SolidoodleDev/Press-Drawings/Press Solidworks Files/raspberry_pi__15_pin_FFC_Connector.SLDASM

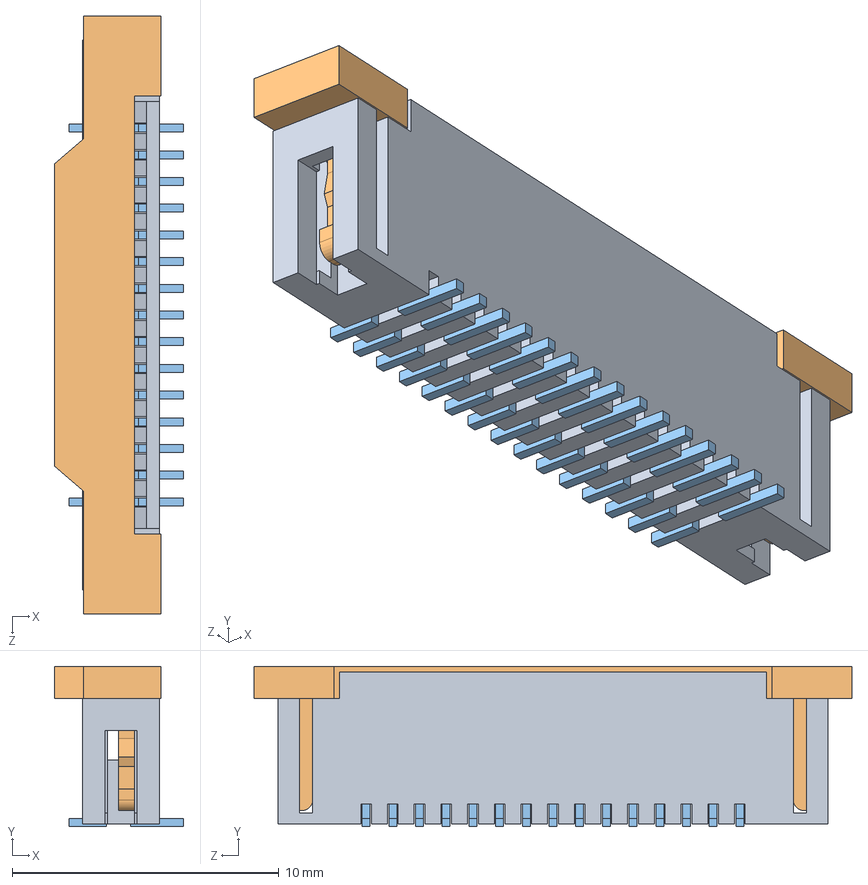
[picture p1: CAD file, 2017-12-07]
Press Solidworks Files/raspberry_pi__15_pin_FFC_Connector.SLDASM
4.85 x 6.00 x 22.4 mm
raspberry_pi__15_pin_FFC_Connector_body
raspberry_pi__15_pin_FFC_Connector_locker
raspberry_pi__15_pin_FFC_Connector_pins x 15
