SolidoodleDev/Press-Drawings/Press Solidworks Files/D2F_01F_D.SLDASM

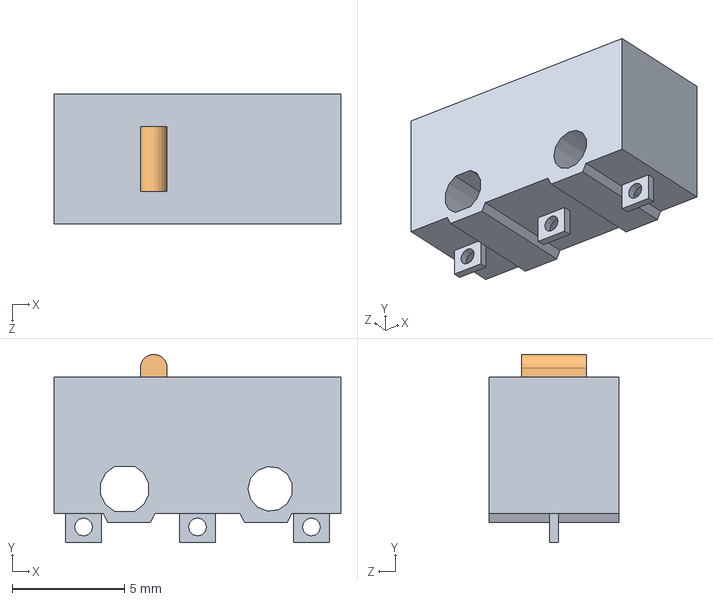
[picture p2: CAD file, 2017-12-07]
Press Solidworks Files/D2F_01F_D.SLDASM
12.8 x 8.40 x 5.80 mm
D2F_01F_D_BASE
D2F_01F_D_ACTUATOR
