SolidoodleDev/Press-Drawings/Press Solidworks Files/raspberry_pi__USB_x2.SLDASM

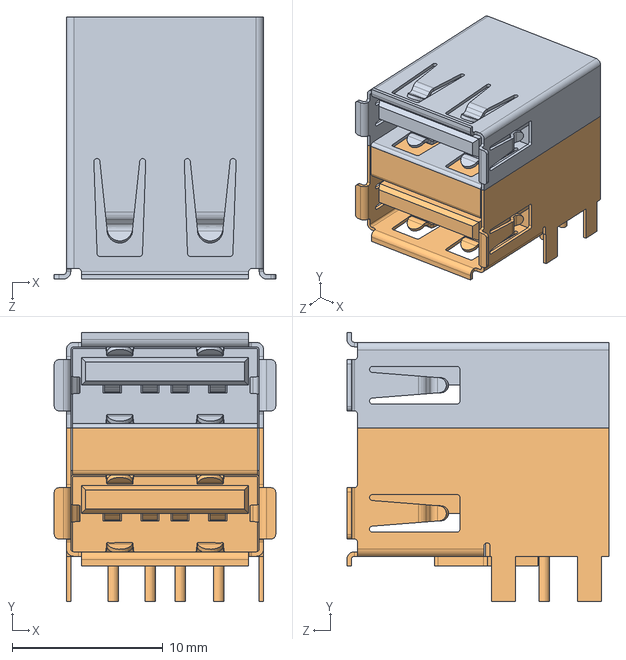
[picture p3: CAD file, 2017-12-07]
Press Solidworks Files/raspberry_pi__USB_x2.SLDASM
14.7 x 17.9 x 17.4 mm
raspberry_pi__USB_x2_part1
raspberry_pi__USB_x2_part2
