SolidoodleDev/Press-Drawings/Press Solidworks Files/Solidoodle_Build_Platform_Assy.SLDASM

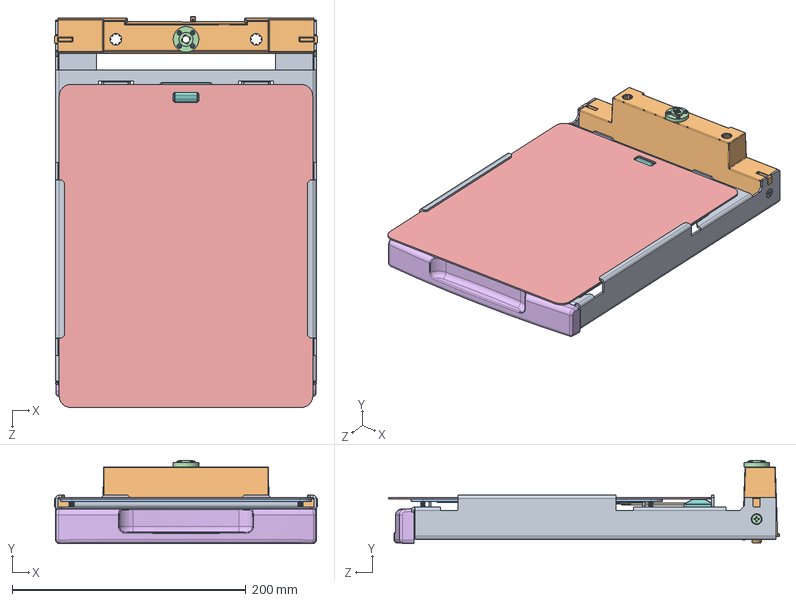
[picture p4: CAD file, 2017-12-07]
Press Solidworks Files/Solidoodle_Build_Platform_Assy.SLDASM
225.0 x 71.3 x 334.7 mm
1844_022_rev_04
1844_023_rev_04
1844_024_rev_03
Lead Screw Nut
1844_041_rev_04
1844_040_rev_04
1844_068_rev_04
m2x12_flat_socket_screw x 4
m4.5x10_plastite x 4
m2x10_plastite x 4
m4.5x12_flathead_plastite x 2
m3x6_plastite
