SolidoodleDev/Press-Drawings/Press Solidworks Files/Solidoodle_Spool_Assy.SLDASM

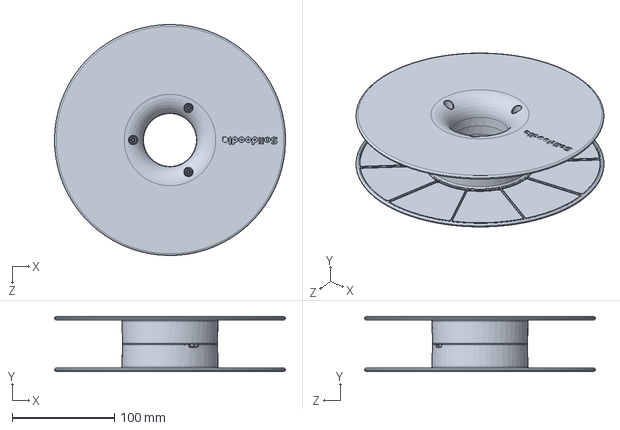
[picture p5: CAD file, 2017-12-07]
Press Solidworks Files/Solidoodle_Spool_Assy.SLDASM
226.1 x 54.0 x 226.1 mm
1844_042_rev_04 x 2
m3.5x10_plastite x 3
