SolidoodleDev/Press-Drawings/Press Solidworks Files/PCB_Door_Assy.SLDASM

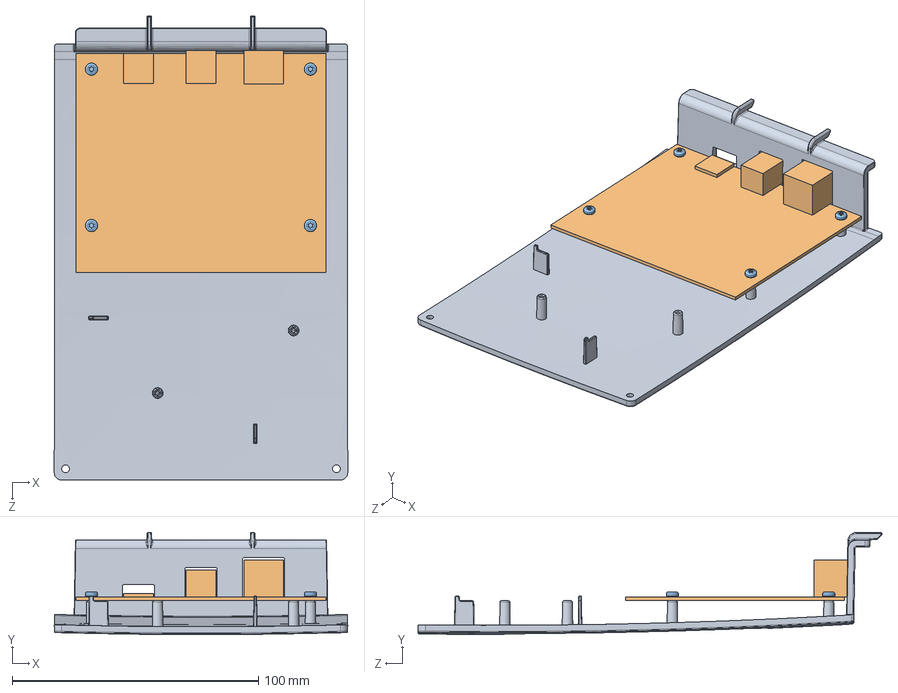
[picture p6: CAD file, 2017-12-07]
Press Solidworks Files/PCB_Door_Assy.SLDASM
119.2 x 41.5 x 188.4 mm
1844_031_rev_04
main_pcb
m2.5x6_plastite x 4
