SolidoodleDev/Press-Drawings/Press Solidworks Files/Solidoodle_Button_PCB_Assem.SLDASM

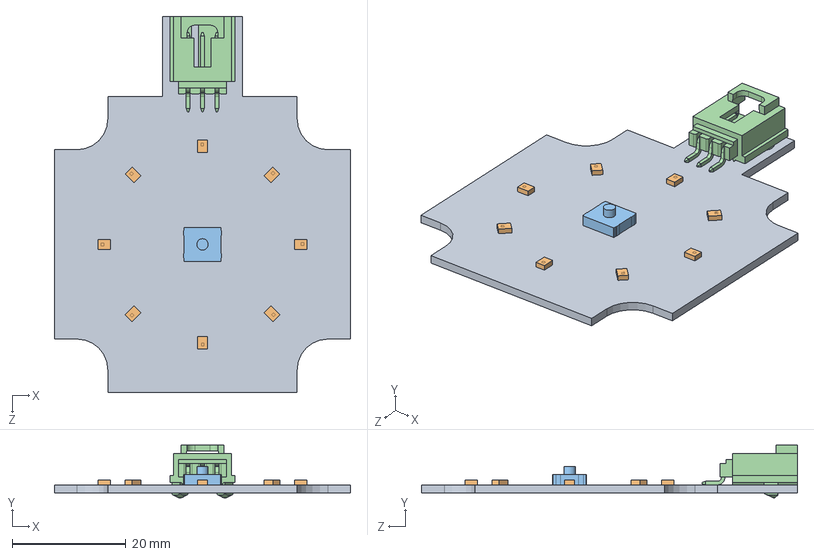
[picture p8: CAD file, 2017-12-07]
Press Solidworks Files/Solidoodle_Button_PCB_Assem.SLDASM
52.0 x 9.29 x 66.0 mm
solidoodle_button_pcb
led x 8
switch
3-pin_molex_male_board_connector_015912035
