SolidoodleDev/Press-Drawings/Press Solidworks Files/Front_Door_Assy.sldasm

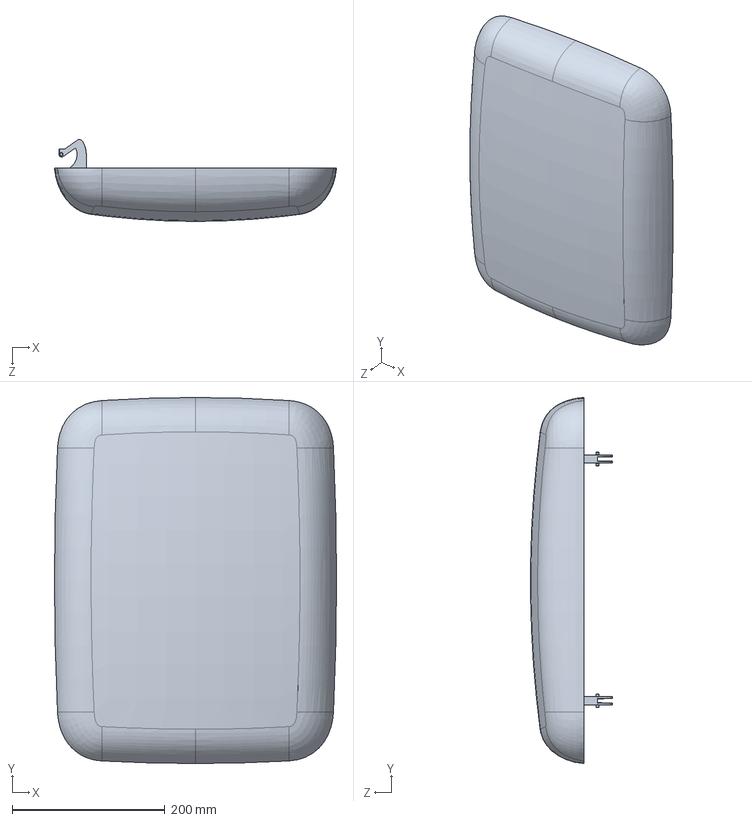
[picture p10: CAD file, 2017-12-07]
Press Solidworks Files/Front_Door_Assy.sldasm
370.0 x 480.0 x 107.4 mm
1844_008_rev_04
1844_036_rev_04
m3x10_flathead_plastite x 2
