SolidoodleDev/Press-Drawings/Press Solidworks Files/D2F_01FL_A.SLDASM

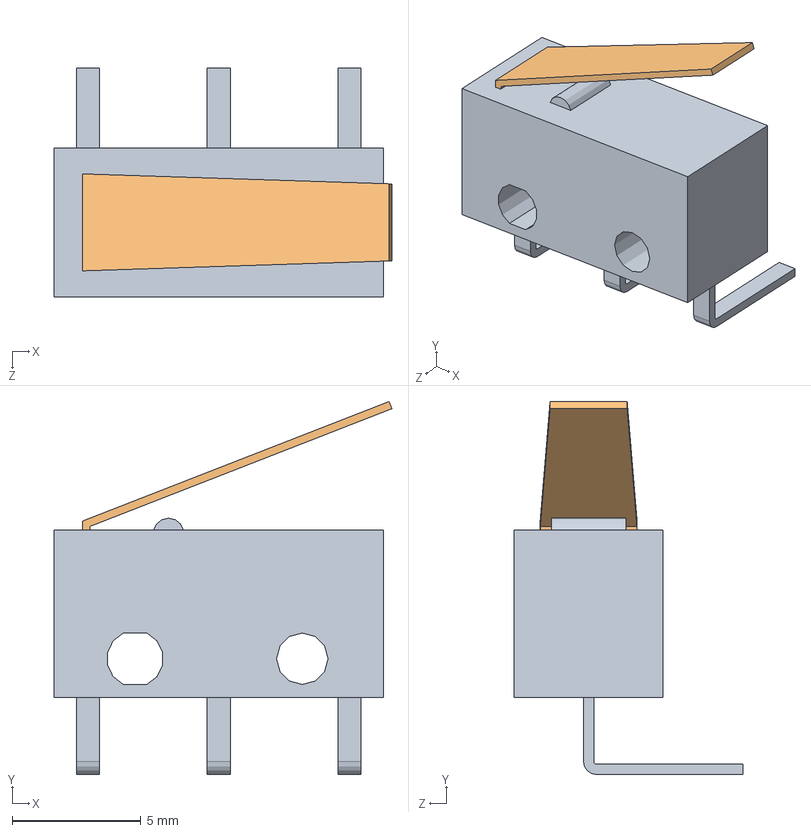
[picture p11: CAD file, 2017-12-07]
Press Solidworks Files/D2F_01FL_A.SLDASM
13.1 x 14.5 x 8.90 mm
D2F_01FL_A.BASE
D2F_01FL_A.ACTUATOR
