SolidoodleDev/Press-Drawings/Press Solidworks Files/main_pcb.SLDPRT

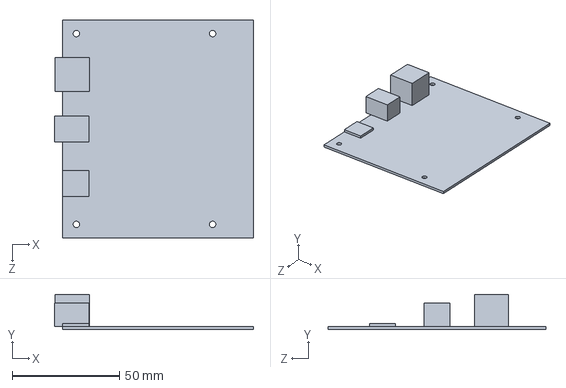
[picture p12: CAD file, 2017-12-07]
Press Solidworks Files/main_pcb.SLDPRT
92.7 x 16.5 x 101.6 mm
