SolidoodleDev/Press-Drawings/Press Solidworks Files/Solidoodle_Micro_Switch_Assy.SLDASM

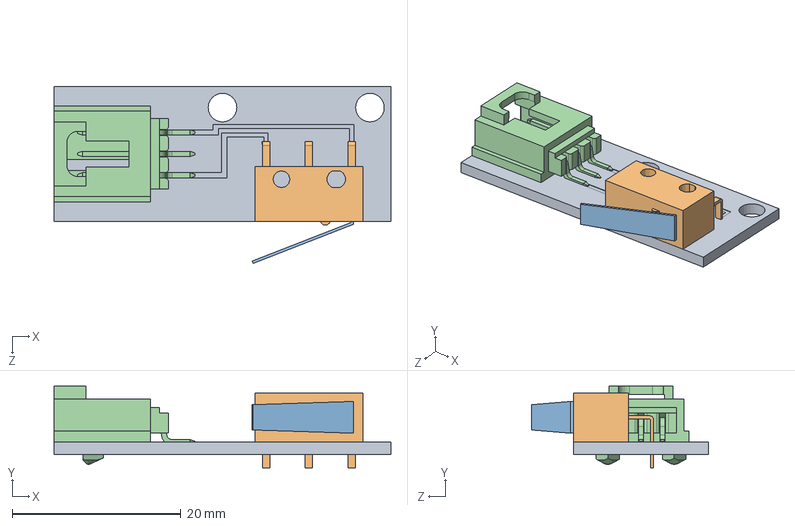
[picture p13: CAD file, 2017-12-07]
Press Solidworks Files/Solidoodle_Micro_Switch_Assy.SLDASM
40.0 x 9.70 x 21.0 mm
micro_switch_pcb
D2F_01FL_A.BASE
D2F_01FL_A.ACTUATOR
3-pin_molex_male_board_connector_015912035
