SolidoodleDev/Press-Drawings/Press Solidworks Files/Solidoodle_Lid_Assy.sldasm

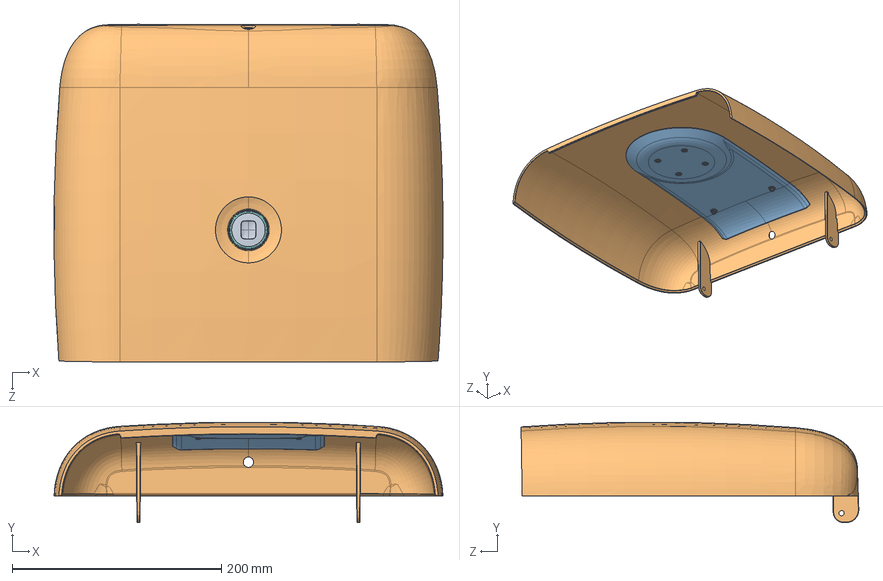
[picture p14: CAD file, 2017-12-07]
Press Solidworks Files/Solidoodle_Lid_Assy.sldasm
371.4 x 95.7 x 322.5 mm
1844_005_rev_04
1844_032_rev_04
m3x10_plastite x 4
solidoodle_button_pcb
led x 8
switch
3-pin_molex_male_board_connector_015912035
1844_026_rev_04
1844_009_rev_04
m3x6_plastite x 2
