SolidoodleDev/Press-Drawings/Press Solidworks Files/Spool_Tray_Assembly.SLDASM

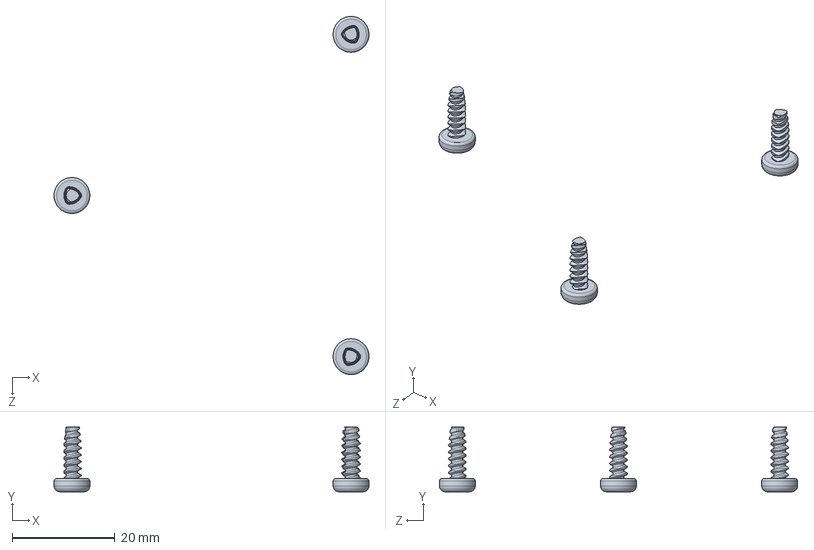
[picture p15: CAD file, 2017-12-07]
Press Solidworks Files/Spool_Tray_Assembly.SLDASM
61.5 x 12.6 x 69.9 mm
m3.5x10_plastite x 3
