SolidoodleDev/Press-Drawings/Press Solidworks Files/raspberry_pi__HDMI_socket.SLDASM

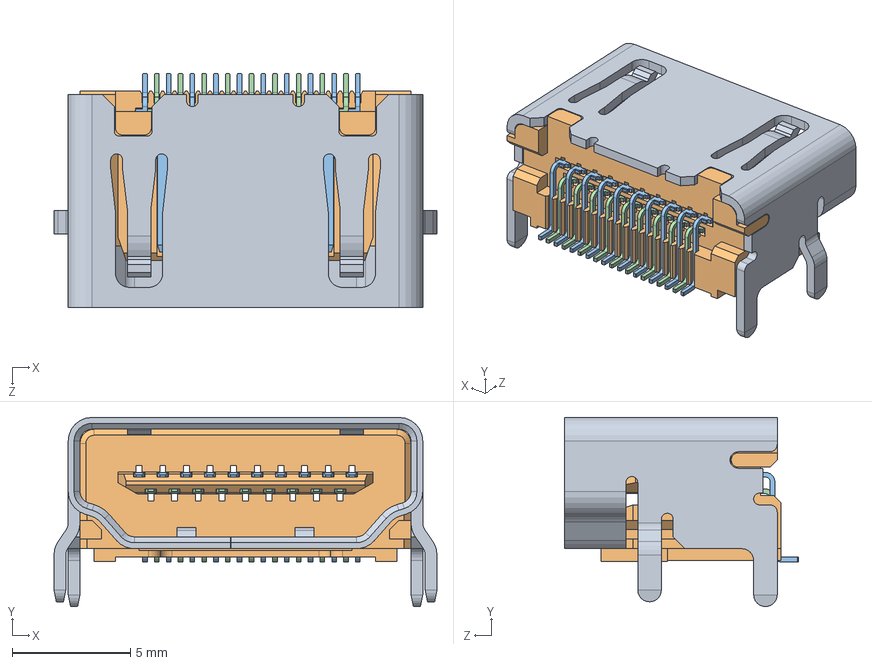
[picture p16: CAD file, 2017-12-07]
Press Solidworks Files/raspberry_pi__HDMI_socket.SLDASM
16.2 x 8.00 x 9.90 mm
raspberry_pi__HDMI_socket_cover
raspberry_pi__HDMI_socket_inside
raspberry_pi__HDMI_socket_large_pin x 10
raspberry_pi__HDMI_socket_small_pin x 9
