SolidoodleDev/Press-Drawings/Press Part Drawings/Drawing Step Files (STEP)/1844_009_rev_03.STEP

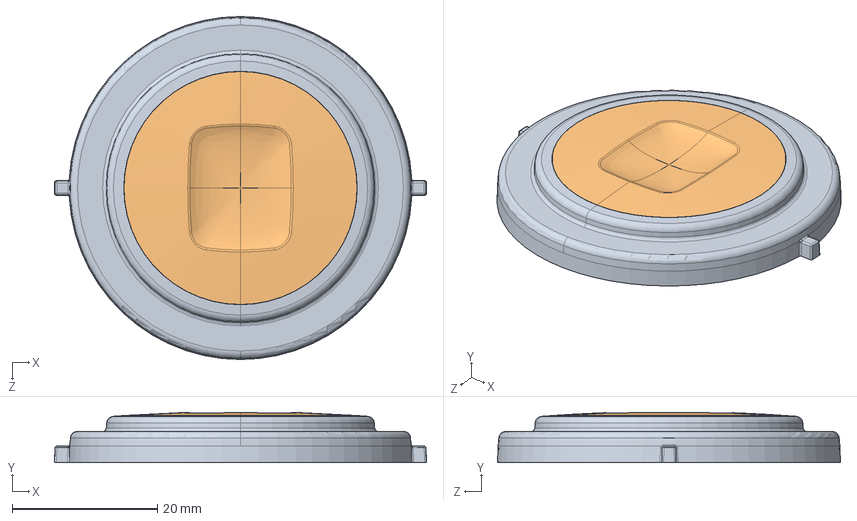
[picture p17: CAD file, 2017-12-07]
Press Part Drawings/Drawing Step Files (STEP)/1844_009_rev_03.STEP
51.2 x 6.93 x 47.2 mm
1844_026_rev_04
1844_009_rev_04
