SolidoodleDev/Press-Drawings/Press Solidworks Files/raspberry_pi__composite_video_out.SLDPRT

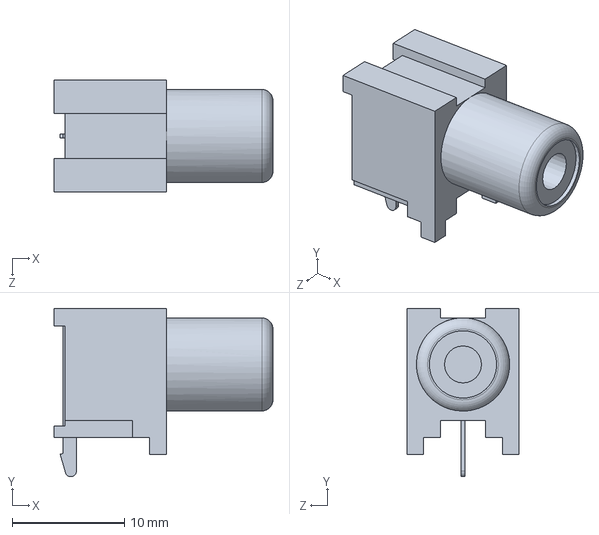
[picture p18: CAD file, 2017-12-07]
Press Solidworks Files/raspberry_pi__composite_video_out.SLDPRT
19.5 x 15.0 x 10.0 mm
