SolidoodleDev/Press-Drawings/Press Part Drawings/Drawing Step Files (STEP)/1844_025_rev_05.STEP

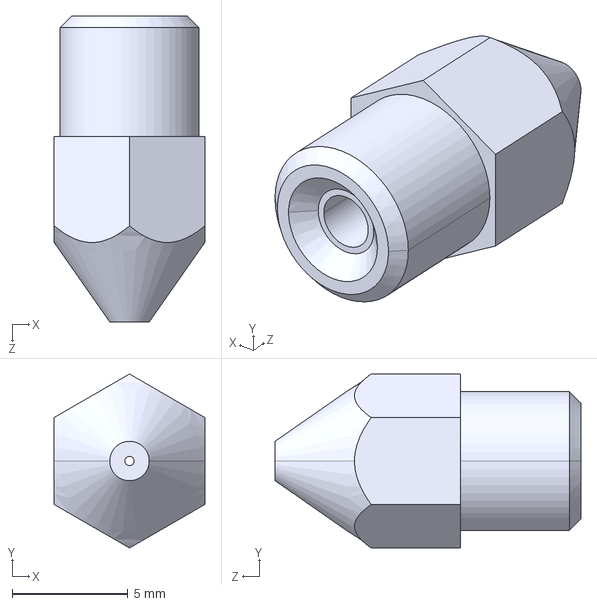
[picture p19: CAD file, 2017-12-07]
Press Part Drawings/Drawing Step Files (STEP)/1844_025_rev_05.STEP
6.50 x 7.51 x 13.2 mm
