SolidoodleDev/Press-Drawings/Press Solidworks Files/1844_053.SLDPRT

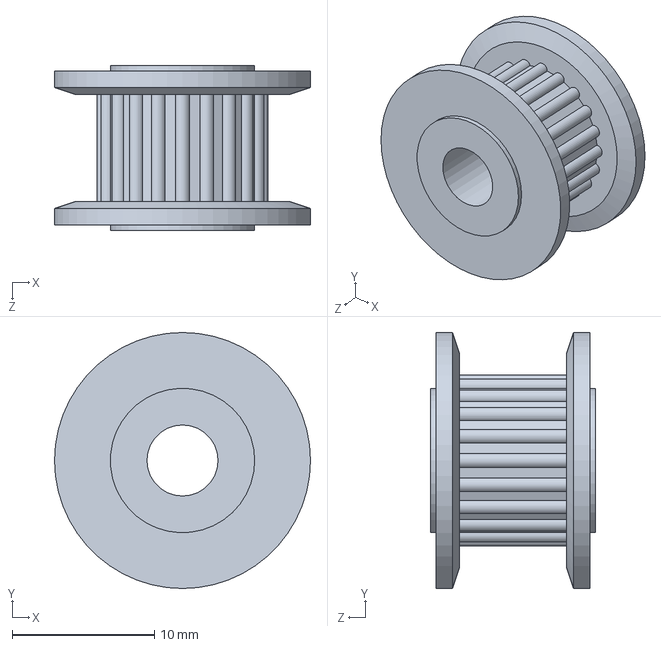
[picture p20: CAD file, 2017-12-07]
Press Solidworks Files/1844_053.SLDPRT
18.0 x 18.0 x 11.6 mm
