SolidoodleDev/Press-Drawings/Press Part Drawings/Drawing Step Files (STEP)/1844_028_rev_05.STEP

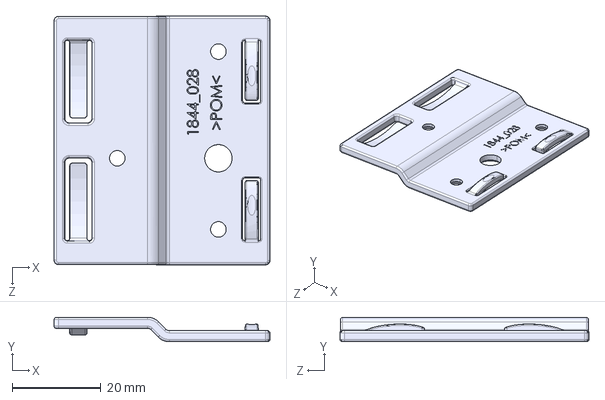
[picture p21: CAD file, 2017-12-07]
Press Part Drawings/Drawing Step Files (STEP)/1844_028_rev_05.STEP
48.6 x 5.50 x 56.0 mm
