SolidoodleDev/Press-Drawings/Press Solidworks Files/m3.5x10_plastite.SLDPRT

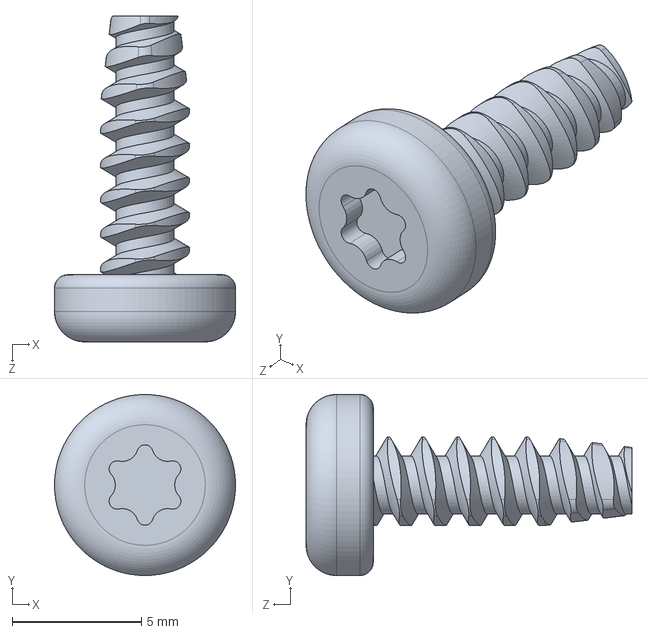
[picture p22: CAD file, 2017-12-07]
Press Solidworks Files/m3.5x10_plastite.SLDPRT
7.00 x 7.00 x 12.6 mm
