SolidoodleDev/Press-Drawings/Press Part Drawings/Drawing Step Files (STEP)/1844_012_rev_03.STEP

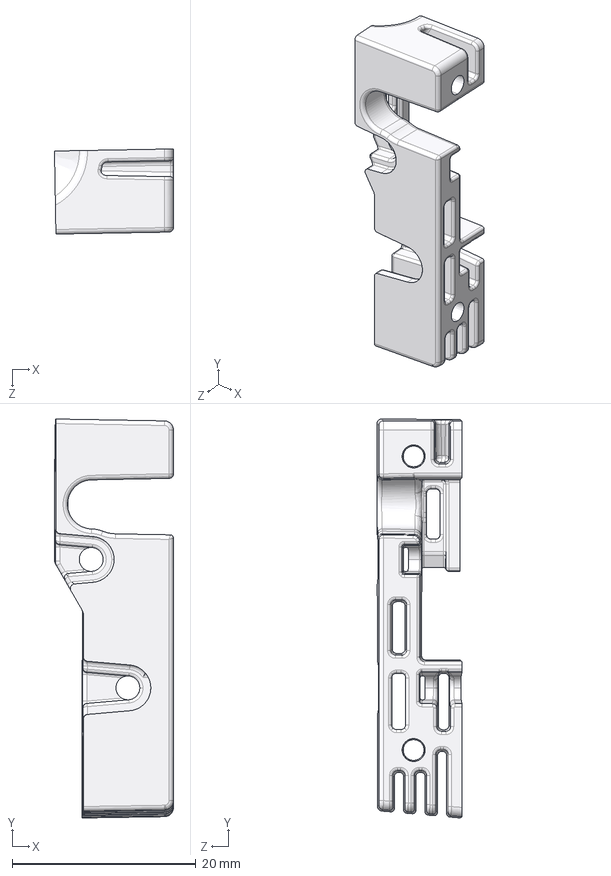
[picture p23: CAD file, 2017-12-07]
Press Part Drawings/Drawing Step Files (STEP)/1844_012_rev_03.STEP
13.0 x 43.5 x 9.28 mm
