SolidoodleDev/Press-Drawings/Press Part Drawings/Drawing Step Files (STEP)/1844_022_rev_07.STEP

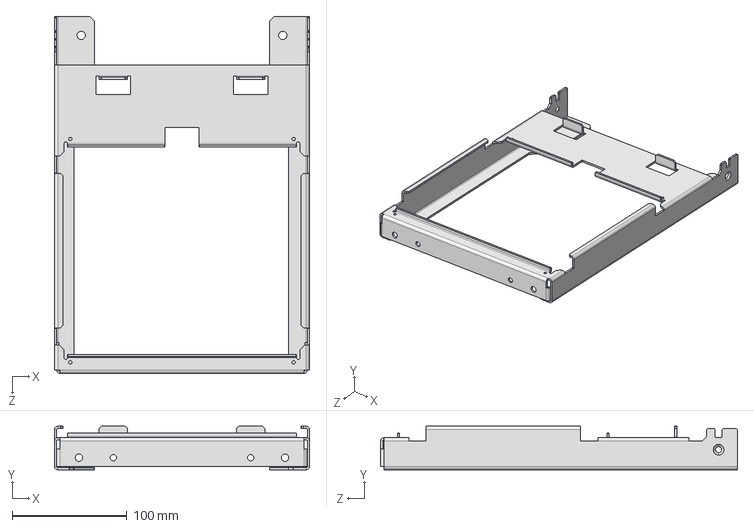
[picture p24: CAD file, 2017-12-07]
Press Part Drawings/Drawing Step Files (STEP)/1844_022_rev_07.STEP
223.0 x 38.0 x 311.8 mm
