SolidoodleDev/Press-Drawings/Press Solidworks Files/1844_054.SLDPRT

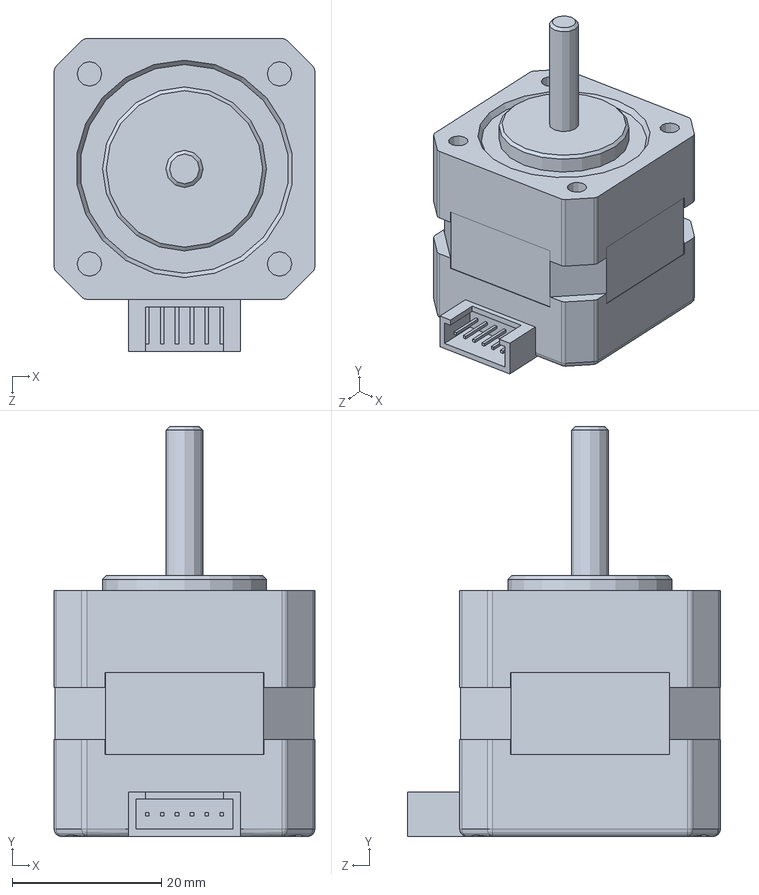
[picture p25: CAD file, 2017-12-07]
Press Solidworks Files/1844_054.SLDPRT
35.0 x 55.0 x 42.0 mm
