SolidoodleDev/Press-Drawings/Press Part Drawings/Drawing Step Files (STEP)/1844_021_rev_05.STEP

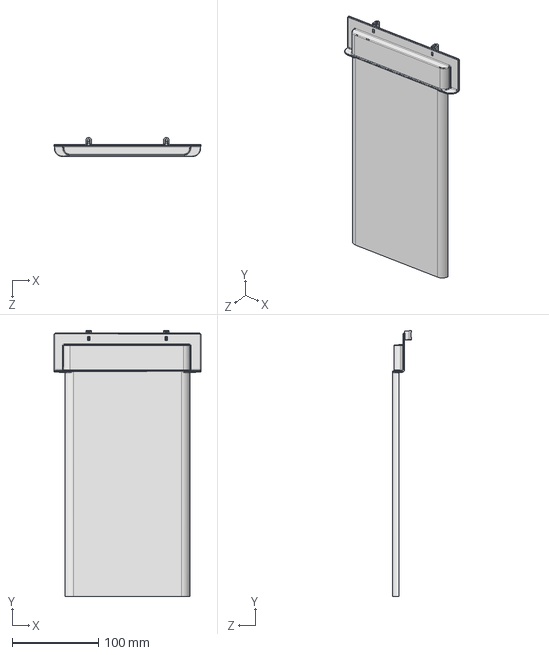
[picture p26: CAD file, 2017-12-07]
Press Part Drawings/Drawing Step Files (STEP)/1844_021_rev_05.STEP
170.0 x 308.4 x 22.4 mm
