SolidoodleDev/Press-Drawings/Press Part Drawings/Drawing Step Files (STEP)/1844_020_rev_04.STEP

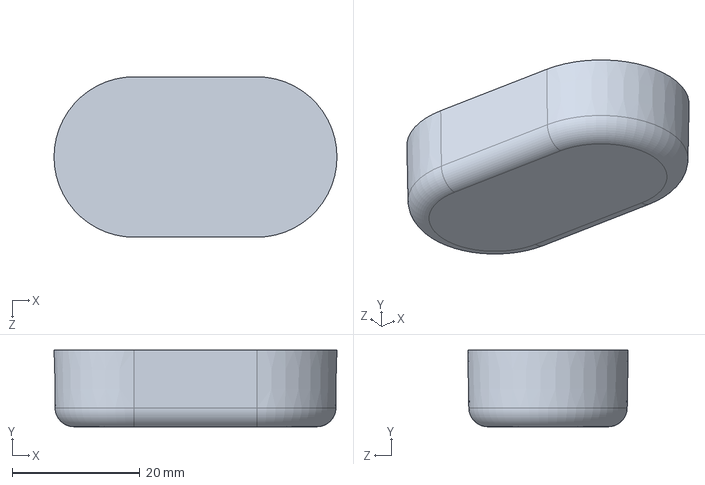
[picture p27: CAD file, 2017-12-07]
Press Part Drawings/Drawing Step Files (STEP)/1844_020_rev_04.STEP
44.3 x 12.0 x 25.1 mm
