SolidoodleDev/Press-Drawings/Press Solidworks Files/1844_024_rev_03.SLDPRT

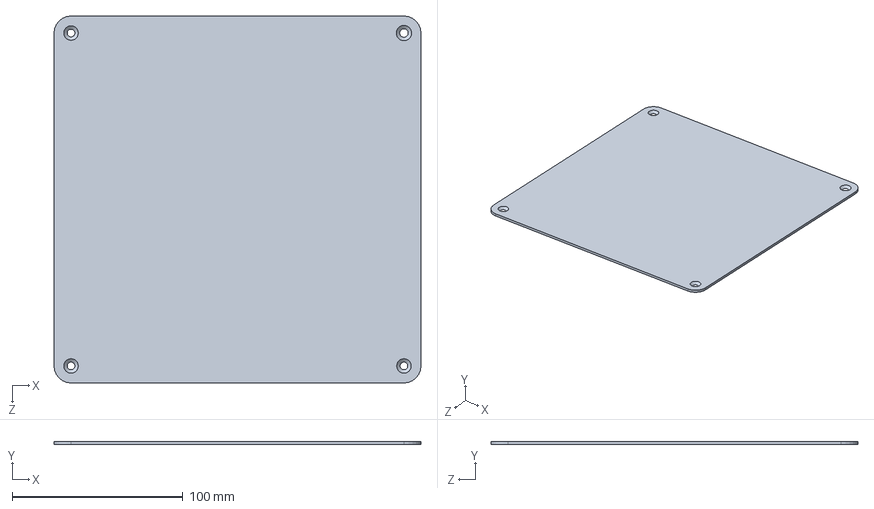
[picture p28: CAD file, 2017-12-07]
Press Solidworks Files/1844_024_rev_03.SLDPRT
215.0 x 2.00 x 215.0 mm
