SolidoodleDev/Press-Drawings/Press Part Drawings/Drawing Step Files (STEP)/1844_051_rev_04.STEP

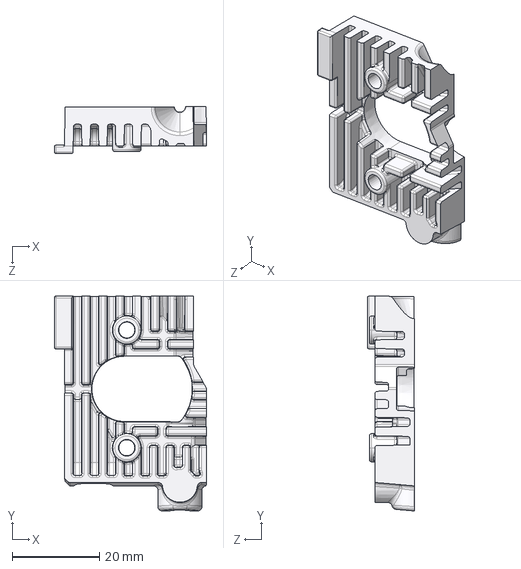
[picture p29: CAD file, 2017-12-07]
Press Part Drawings/Drawing Step Files (STEP)/1844_051_rev_04.STEP
35.0 x 49.3 x 10.9 mm
