SolidoodleDev/Press-Drawings/Press Solidworks Files/raspberry_pi__SD_reader_body.SLDPRT

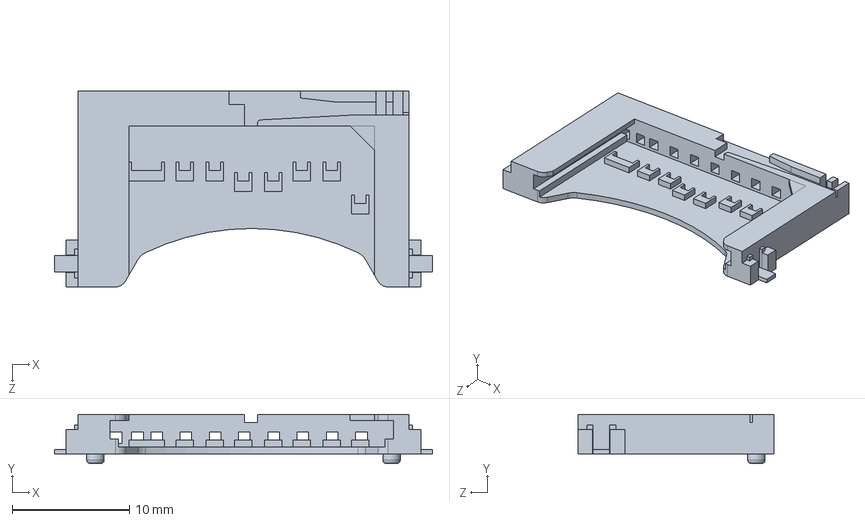
[picture p30: CAD file, 2017-12-07]
Press Solidworks Files/raspberry_pi__SD_reader_body.SLDPRT
32.3 x 4.20 x 16.8 mm
