SolidoodleDev/Press-Drawings/Press Part Drawings/Drawing Step Files (STEP)/1844_037_rev_04.STEP

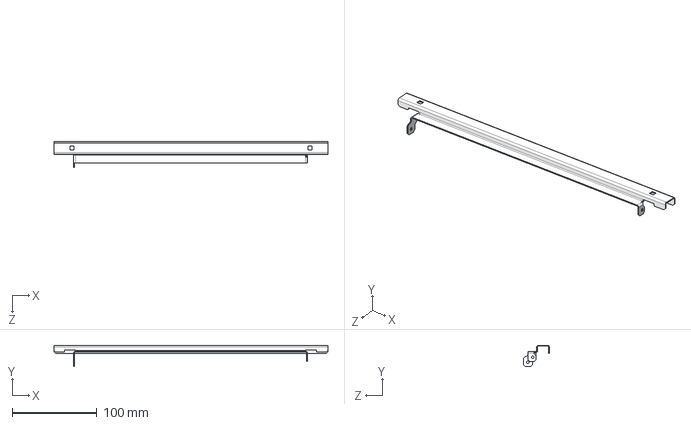
[picture p31: CAD file, 2017-12-07]
Press Part Drawings/Drawing Step Files (STEP)/1844_037_rev_04.STEP
322.5 x 25.0 x 30.5 mm
