SolidoodleDev/Press-Drawings/Press Part Drawings/Drawing Step Files (STEP)/1844_035_rev_04.STEP

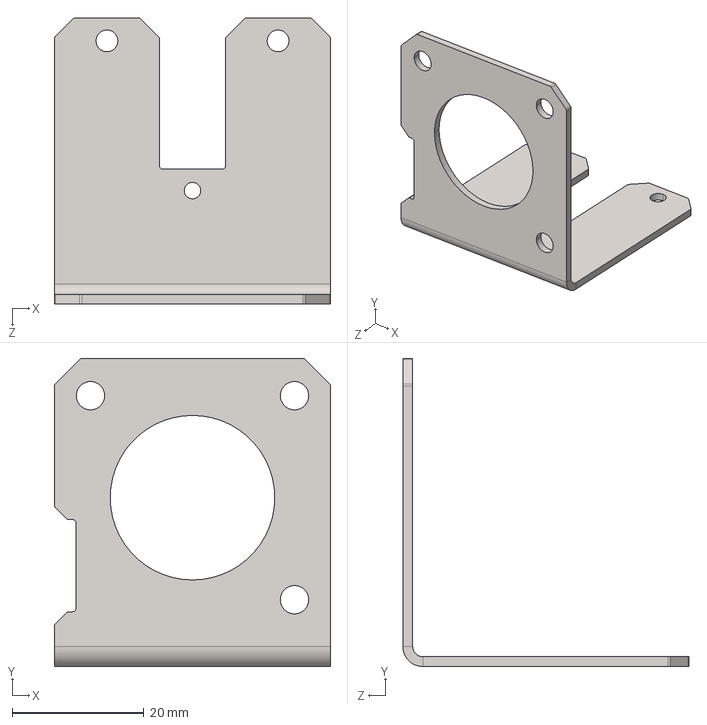
[picture p32: CAD file, 2017-12-07]
Press Part Drawings/Drawing Step Files (STEP)/1844_035_rev_04.STEP
42.0 x 46.8 x 43.5 mm
