SolidoodleDev/Press-Drawings/Press Part Drawings/Drawing Step Files (STEP)/1844_024_rev_04.STEP

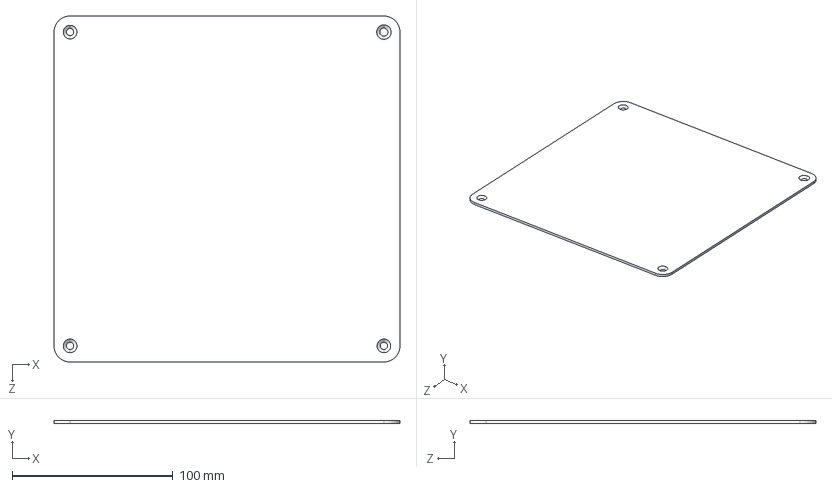
[picture p33: CAD file, 2017-12-07]
Press Part Drawings/Drawing Step Files (STEP)/1844_024_rev_04.STEP
215.0 x 2.00 x 215.0 mm
