SolidoodleDev/Press-Drawings/Press Part Drawings/Drawing Step Files (STEP)/1844_018_rev_04.STEP

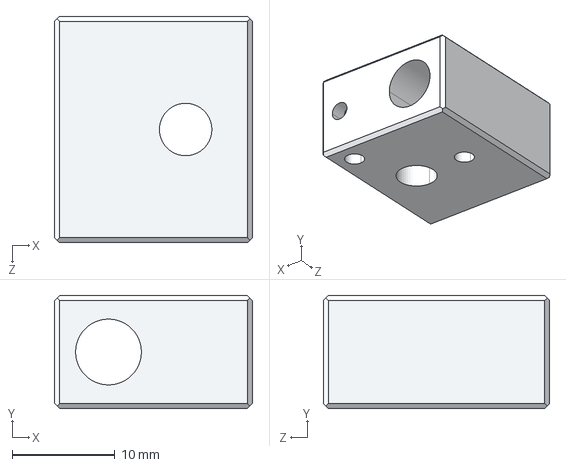
[picture p34: CAD file, 2017-12-07]
Press Part Drawings/Drawing Step Files (STEP)/1844_018_rev_04.STEP
19.2 x 11.0 x 22.0 mm
