SolidoodleDev/Press-Drawings/Press Solidworks Files/1844_026_rev_04.SLDPRT

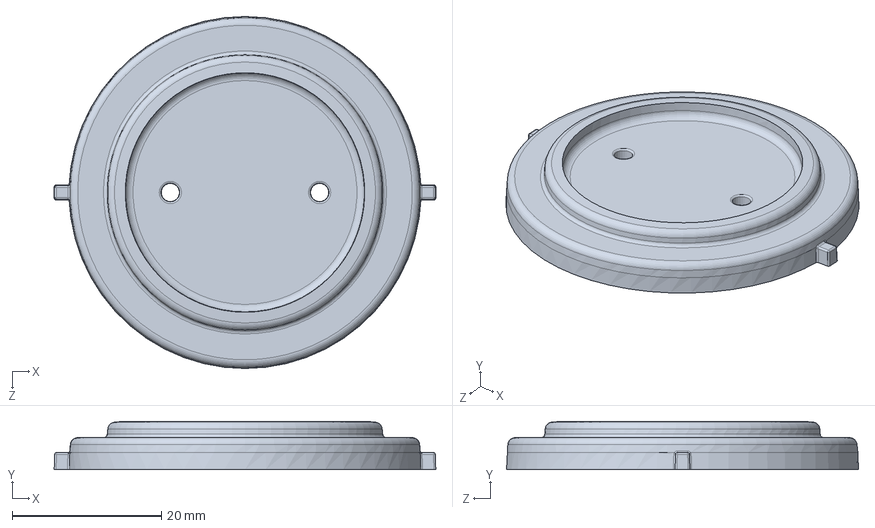
[picture p35: CAD file, 2017-12-07]
Press Solidworks Files/1844_026_rev_04.SLDPRT
51.1 x 6.49 x 47.2 mm
