SolidoodleDev/Press-Drawings/Press Part Drawings/Drawing Step Files (STEP)/1844_041_rev_09.STEP

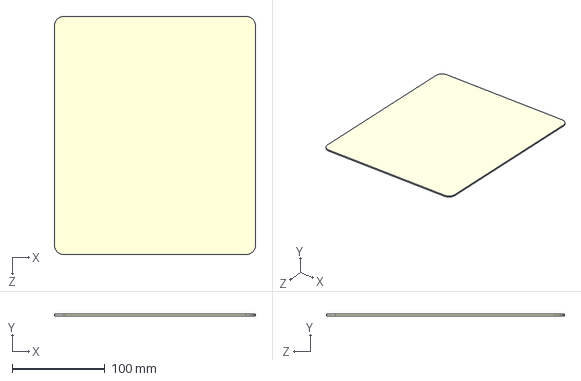
[picture p36: CAD file, 2017-12-07]
Press Part Drawings/Drawing Step Files (STEP)/1844_041_rev_09.STEP
217.0 x 1.80 x 257.0 mm
