SolidoodleDev/Press-Drawings/Press Solidworks Files/1844_047_rev_03.SLDPRT

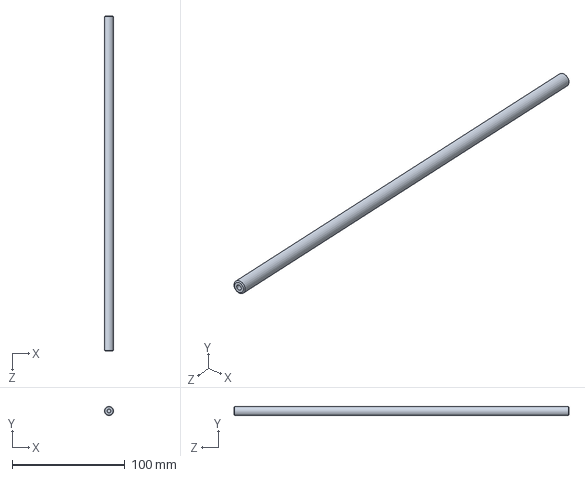
[picture p37: CAD file, 2017-12-07]
Press Solidworks Files/1844_047_rev_03.SLDPRT
8.00 x 8.00 x 297.0 mm
