SolidoodleDev/Press-Drawings/Press Part Drawings/Drawing Step Files (STEP)/1844_017_rev_04.STEP

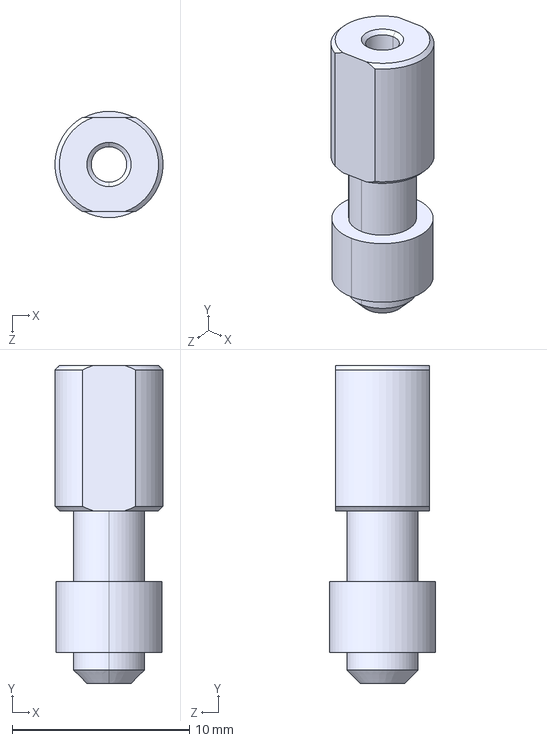
[picture p38: CAD file, 2017-12-07]
Press Part Drawings/Drawing Step Files (STEP)/1844_017_rev_04.STEP
6.09 x 17.9 x 6.00 mm
