SolidoodleDev/Press-Drawings/Press Solidworks Files/raspberry_pi__USB_x2_part2.SLDPRT

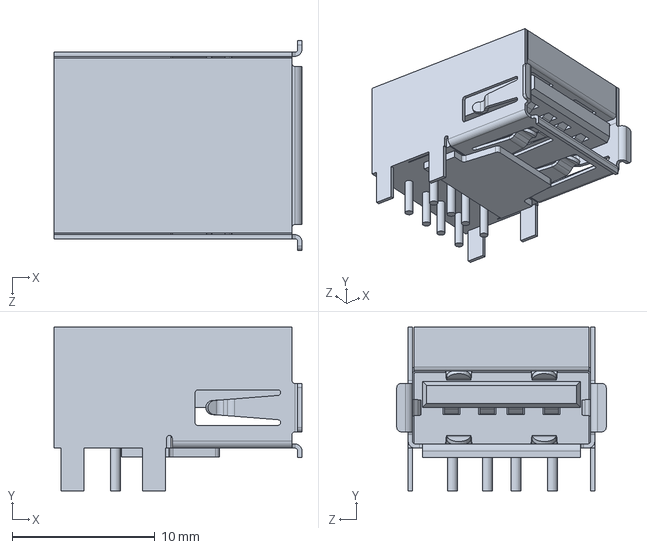
[picture p39: CAD file, 2017-12-07]
Press Solidworks Files/raspberry_pi__USB_x2_part2.SLDPRT
17.4 x 11.5 x 14.7 mm
