SolidoodleDev/Press-Drawings/Press Part Drawings/Drawing Step Files (STEP)/1844_031_rev_05.STEP

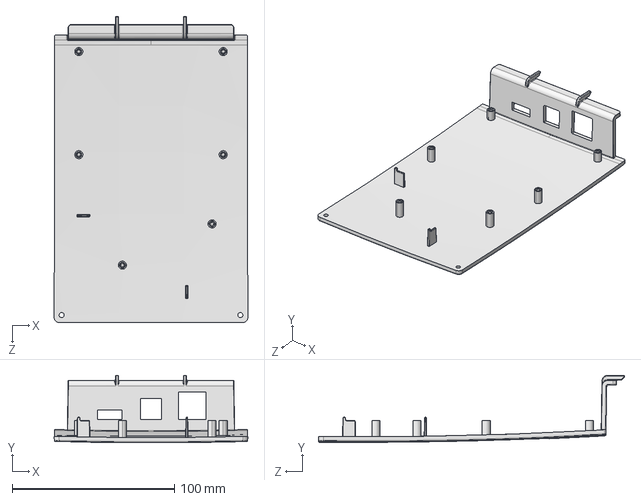
[picture p40: CAD file, 2017-12-07]
Press Part Drawings/Drawing Step Files (STEP)/1844_031_rev_05.STEP
119.2 x 41.4 x 188.4 mm
