SolidoodleDev/Press-Drawings/Press Solidworks Files/raspberry_pi__CI_Board_mounting_holes.SLDPRT

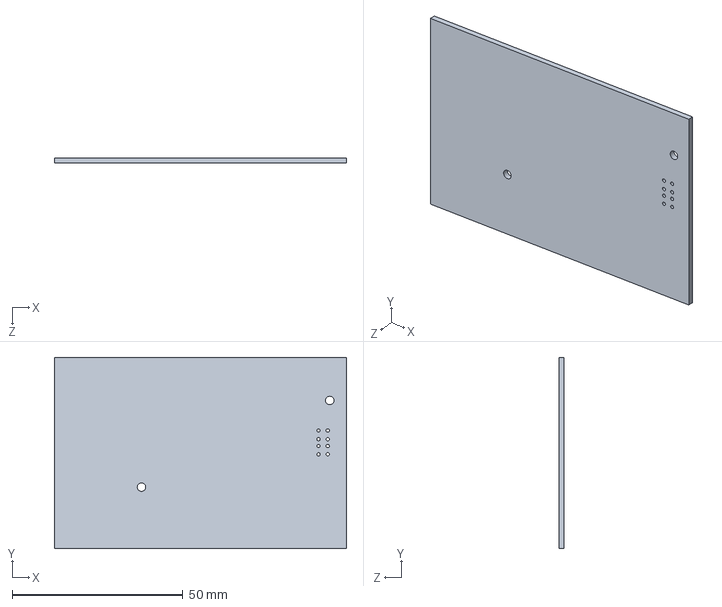
[picture p41: CAD file, 2017-12-07]
Press Solidworks Files/raspberry_pi__CI_Board_mounting_holes.SLDPRT
85.6 x 56.0 x 1.60 mm
