SolidoodleDev/Press-Drawings/Press Part Drawings/Drawing Step Files (STEP)/torsion_spring_extruder.STEP

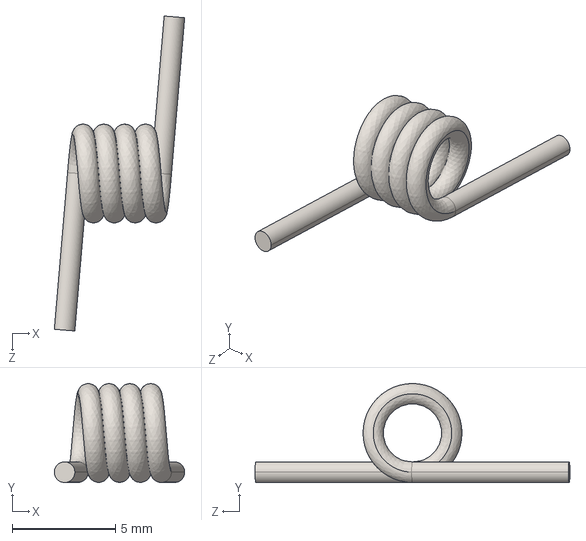
[picture p42: CAD file, 2017-12-07]
Press Part Drawings/Drawing Step Files (STEP)/torsion_spring_extruder.STEP
6.32 x 4.80 x 15.3 mm
