SolidoodleDev/Press-Drawings/Press Solidworks Files/raspberry_pi__SD_reader_pin4.SLDPRT

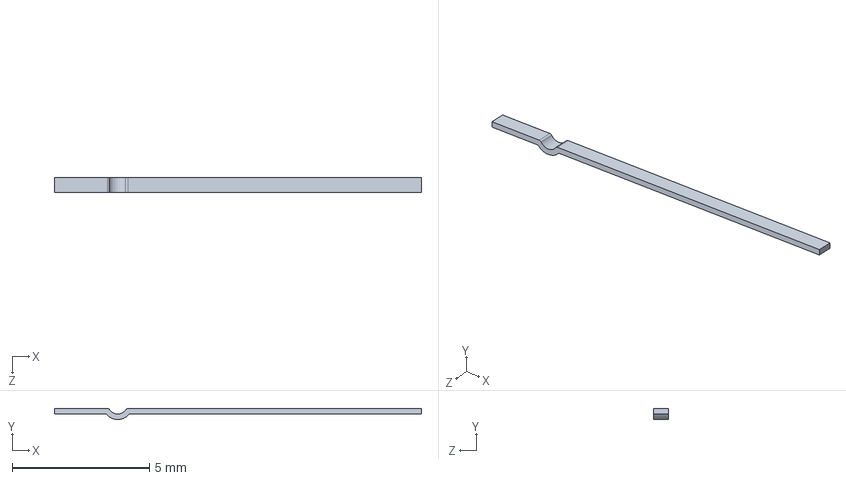
[picture p43: CAD file, 2017-12-07]
Press Solidworks Files/raspberry_pi__SD_reader_pin4.SLDPRT
13.3 x 0.396 x 0.55 mm
