SolidoodleDev/Press-Drawings/Press Part Drawings/Drawing Step Files (STEP)/1844_042_rev_04.STEP

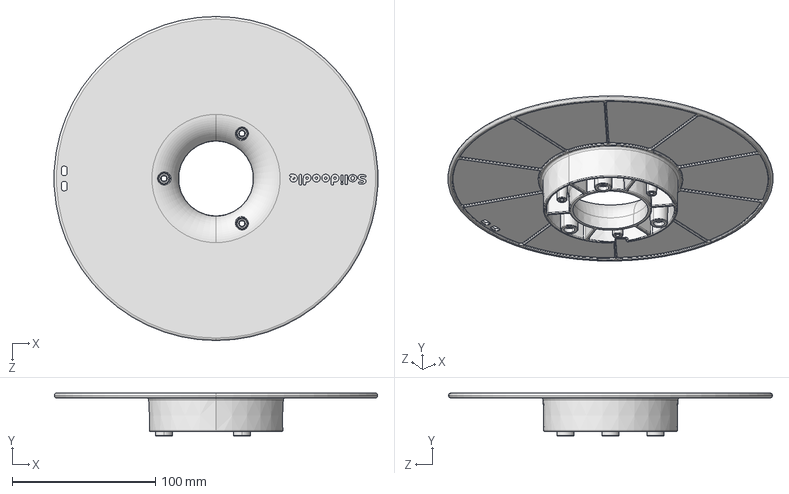
[picture p44: CAD file, 2017-12-07]
Press Part Drawings/Drawing Step Files (STEP)/1844_042_rev_04.STEP
225.7 x 30.0 x 226.1 mm
