SolidoodleDev/Press-Drawings/Press Part Drawings/Drawing Step Files (STEP)/1844_027_rev_03.STEP

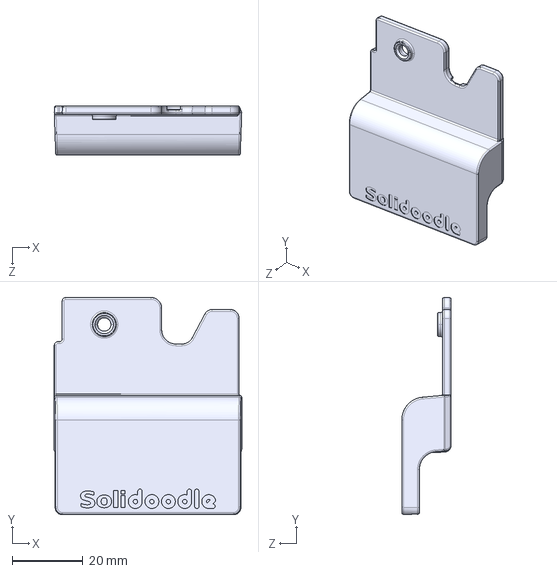
[picture p45: CAD file, 2017-12-07]
Press Part Drawings/Drawing Step Files (STEP)/1844_027_rev_03.STEP
53.0 x 61.4 x 14.0 mm
