SolidoodleDev/Press-Drawings/Press Solidworks Files/1844_039.SLDPRT

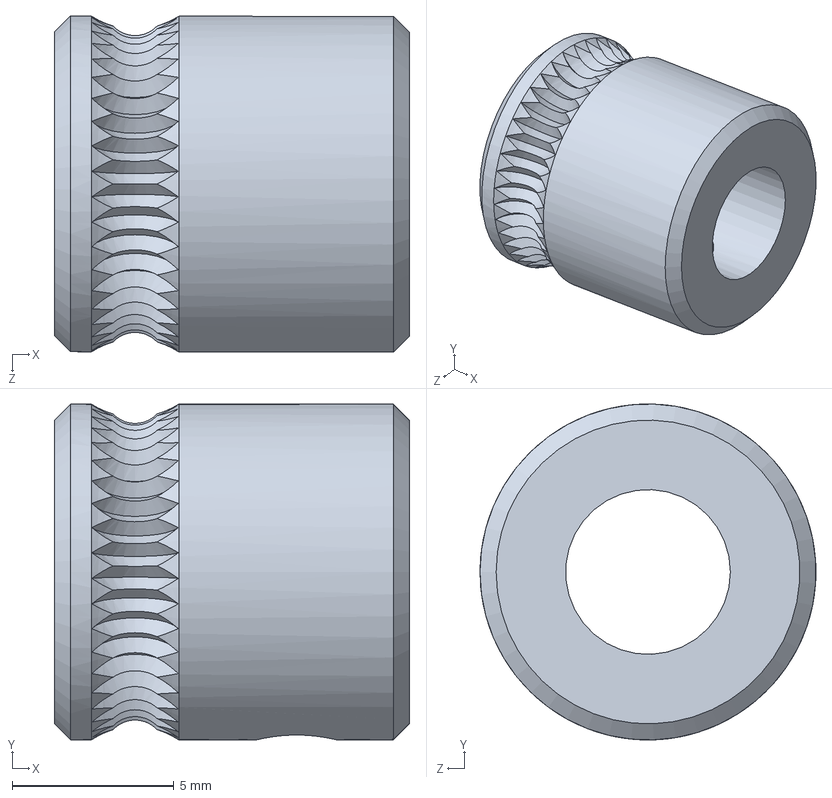
[picture p46: CAD file, 2017-12-07]
Press Solidworks Files/1844_039.SLDPRT
11.0 x 10.4 x 10.4 mm
