SolidoodleDev/Press-Drawings/Press Part Drawings/Drawing Step Files (STEP)/1844_036_rev_03.STEP

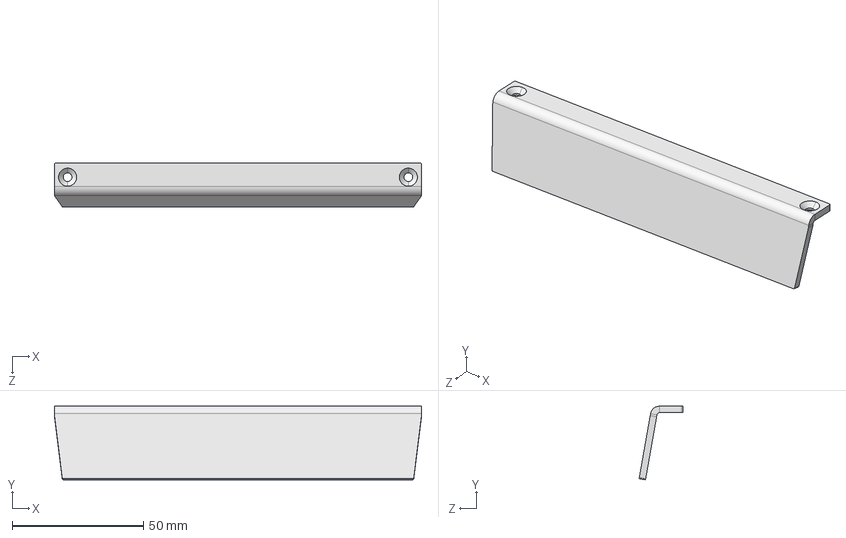
[picture p47: CAD file, 2017-12-07]
Press Part Drawings/Drawing Step Files (STEP)/1844_036_rev_03.STEP
140.0 x 28.1 x 16.7 mm
