SolidoodleDev/Press-Drawings/Press Solidworks Files/Internal_LED_strip.SLDPRT

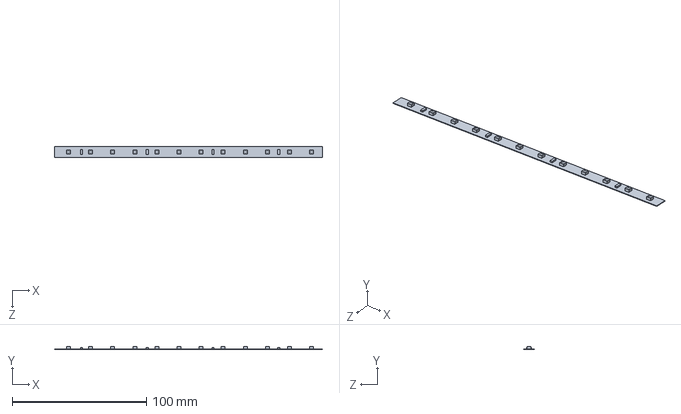
[picture p48: CAD file, 2017-12-07]
Press Solidworks Files/Internal_LED_strip.SLDPRT
200.0 x 2.15 x 8.00 mm
