SolidoodleDev/Press-Drawings/Press Part Drawings/Drawing Step Files (STEP)/1844_038_rev_03.STEP

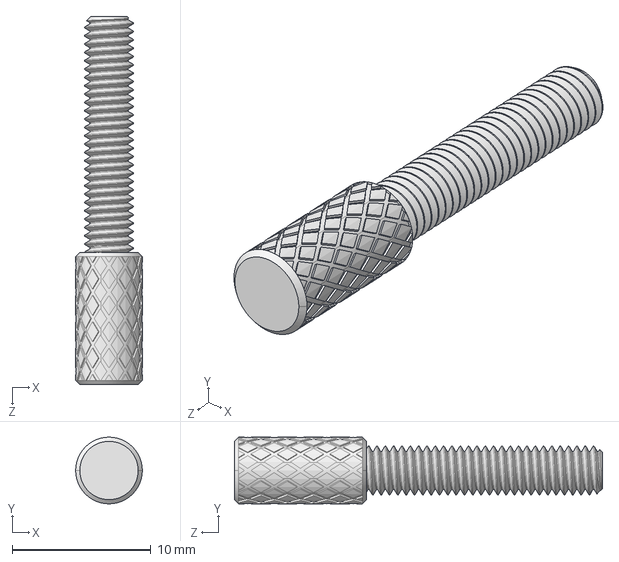
[picture p49: CAD file, 2017-12-07]
Press Part Drawings/Drawing Step Files (STEP)/1844_038_rev_03.STEP
4.80 x 4.80 x 26.5 mm
