SolidoodleDev/Press-Drawings/Press Solidworks Files/3-pin_molex_male_board_connector_015912035.SLDPRT

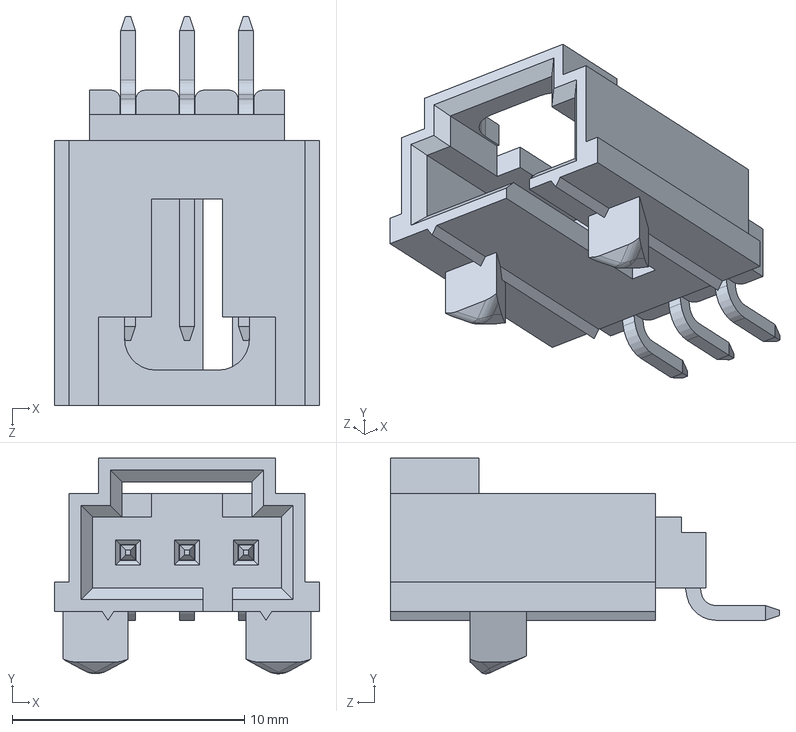
[picture p50: CAD file, 2017-12-07]
Press Solidworks Files/3-pin_molex_male_board_connector_015912035.SLDPRT
11.4 x 9.29 x 16.8 mm
