SolidoodleDev/Press-Drawings/Press Part Drawings/Drawing Step Files (STEP)/1844_069_rev_02.STEP

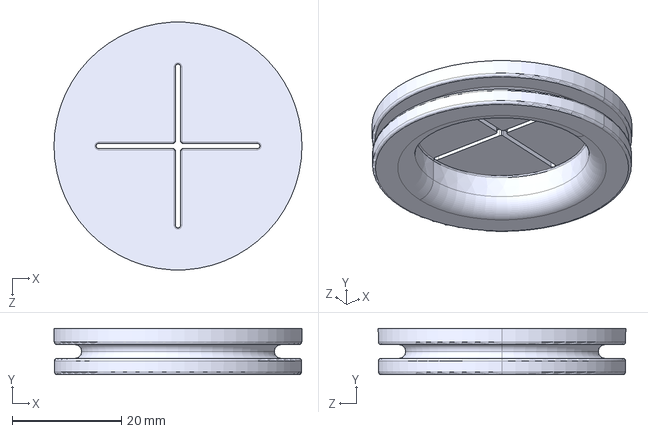
[picture p51: CAD file, 2017-12-07]
Press Part Drawings/Drawing Step Files (STEP)/1844_069_rev_02.STEP
45.4 x 8.50 x 45.3 mm
