SolidoodleDev/Press-Drawings/Press Solidworks Files/1844_059.SLDPRT

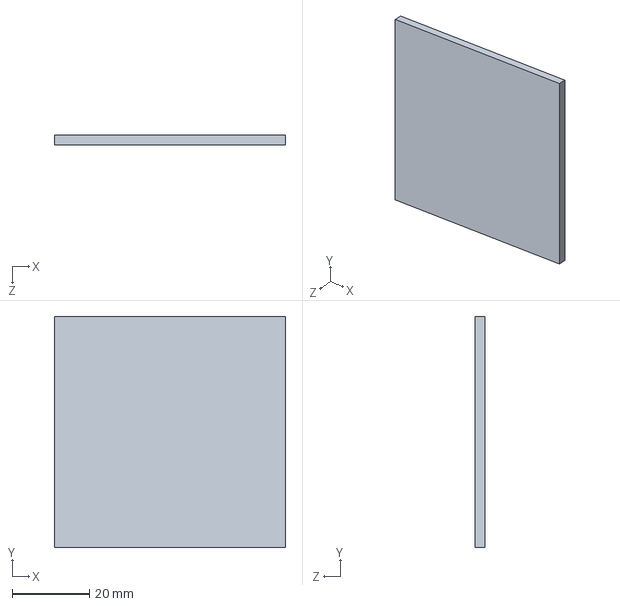
[picture p52: CAD file, 2017-12-07]
Press Solidworks Files/1844_059.SLDPRT
60.0 x 60.0 x 2.50 mm
