SolidoodleDev/Press-Drawings/Press Part Drawings/Drawing Step Files (STEP)/1844_019_rev_04.STEP

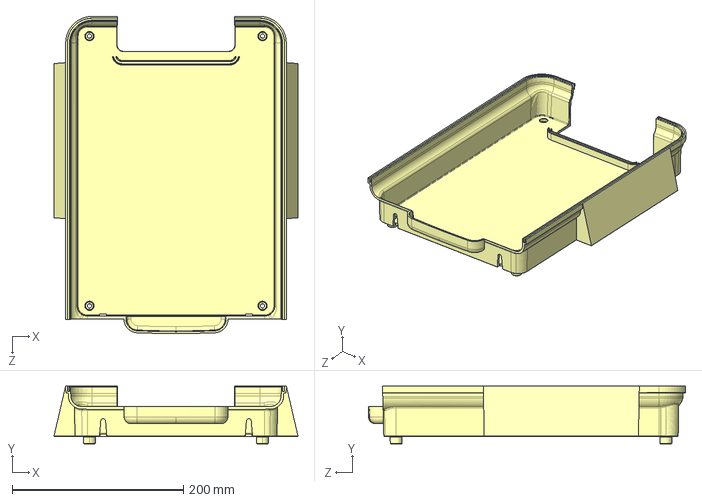
[picture p53: CAD file, 2017-12-07]
Press Part Drawings/Drawing Step Files (STEP)/1844_019_rev_04.STEP
284.7 x 67.2 x 370.1 mm
