SolidoodleDev/Press-Drawings/Press Part Drawings/Drawing Step Files (STEP)/1844_007_rev_04.STEP

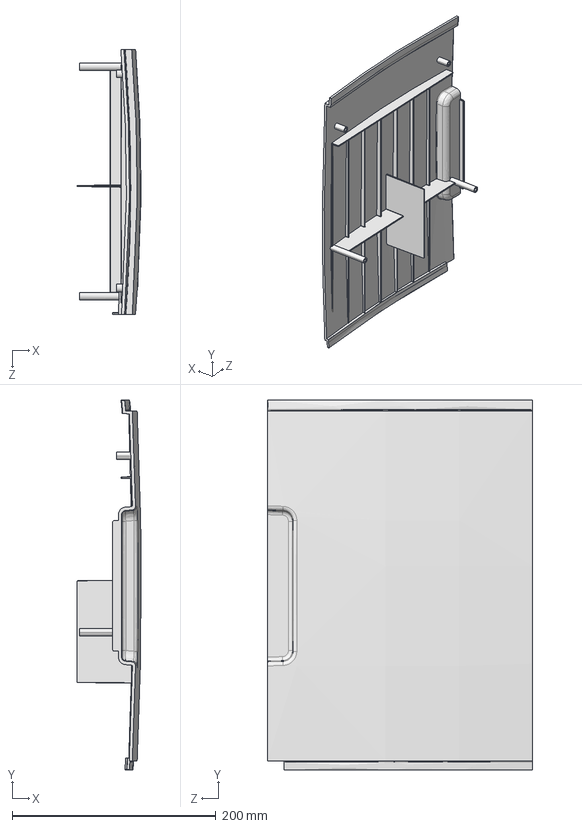
[picture p54: CAD file, 2017-12-07]
Press Part Drawings/Drawing Step Files (STEP)/1844_007_rev_04.STEP
63.1 x 362.8 x 260.3 mm
