SolidoodleDev/Press-Drawings/Press Solidworks Files/raspberry_pi__sot-223_large.SLDPRT

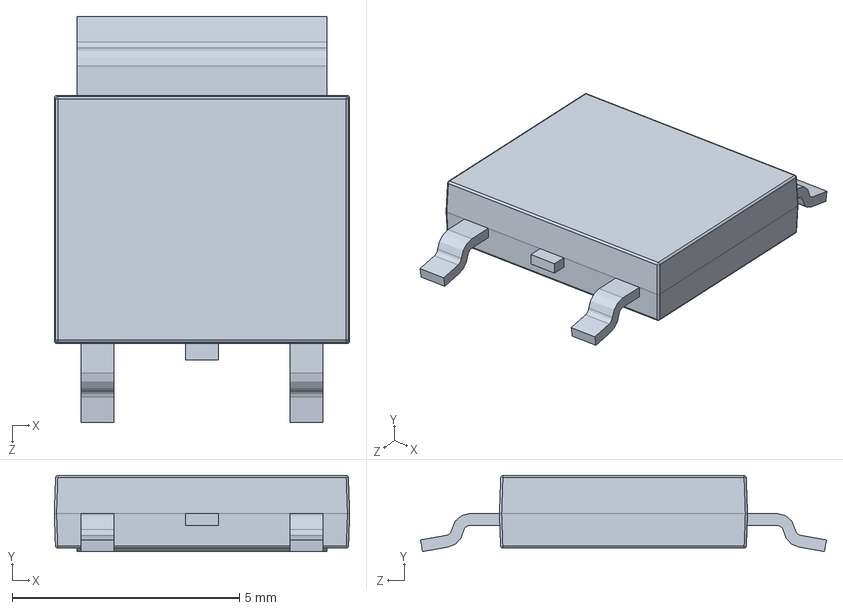
[picture p55: CAD file, 2017-12-07]
Press Solidworks Files/raspberry_pi__sot-223_large.SLDPRT
6.50 x 1.67 x 8.93 mm
