SolidoodleDev/Press-Drawings/Press Part Drawings/Drawing Step Files (STEP)/1844_062_rev_04.STEP

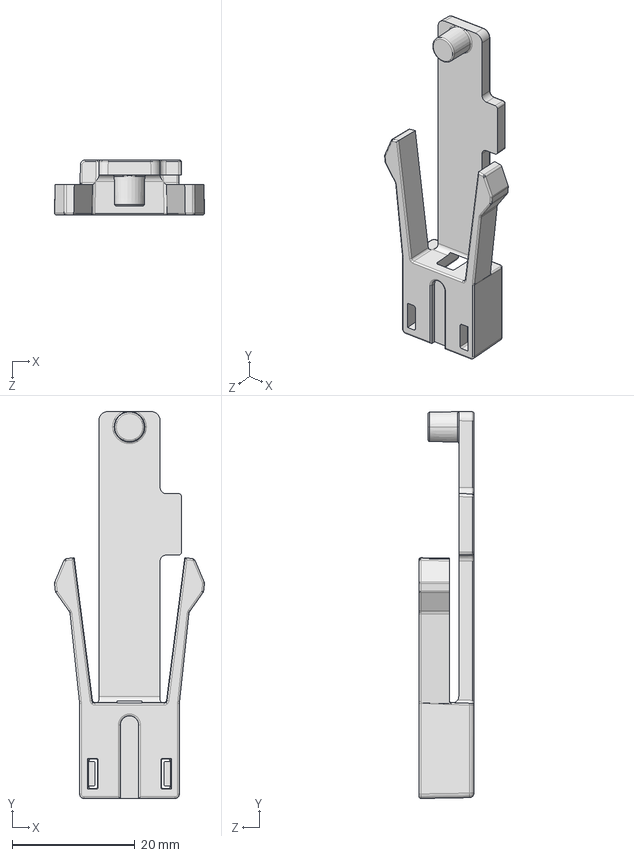
[picture p56: CAD file, 2017-12-07]
Press Part Drawings/Drawing Step Files (STEP)/1844_062_rev_04.STEP
24.5 x 63.2 x 9.00 mm
