SolidoodleDev/Press-Drawings/Press Solidworks Files/raspberry_pi__Xtal_Smd_19200.SLDPRT

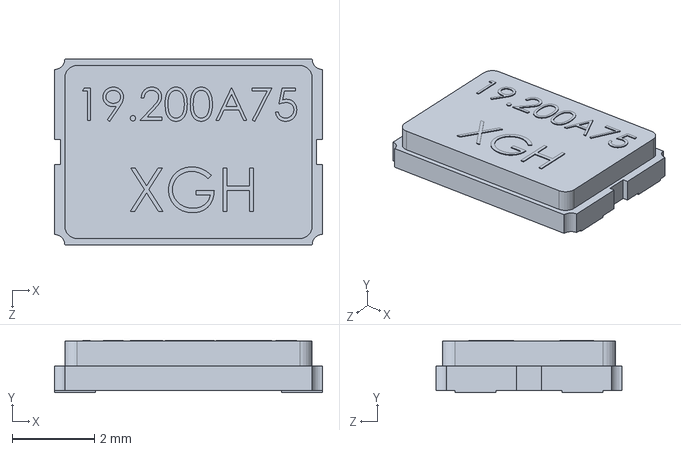
[picture p57: CAD file, 2017-12-07]
Press Solidworks Files/raspberry_pi__Xtal_Smd_19200.SLDPRT
6.50 x 1.27 x 4.50 mm
