SolidoodleDev/Press-Drawings/Press Solidworks Files/1844_050_rev_02.SLDPRT

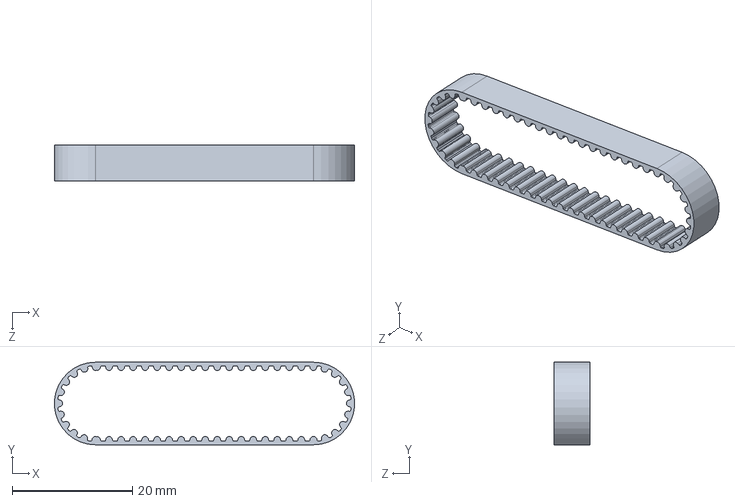
[picture p58: CAD file, 2017-12-07]
Press Solidworks Files/1844_050_rev_02.SLDPRT
49.9 x 13.8 x 6.00 mm
