SolidoodleDev/Press-Drawings/Press Part Drawings/Drawing Step Files (STEP)/1844_030_rev_05.STEP

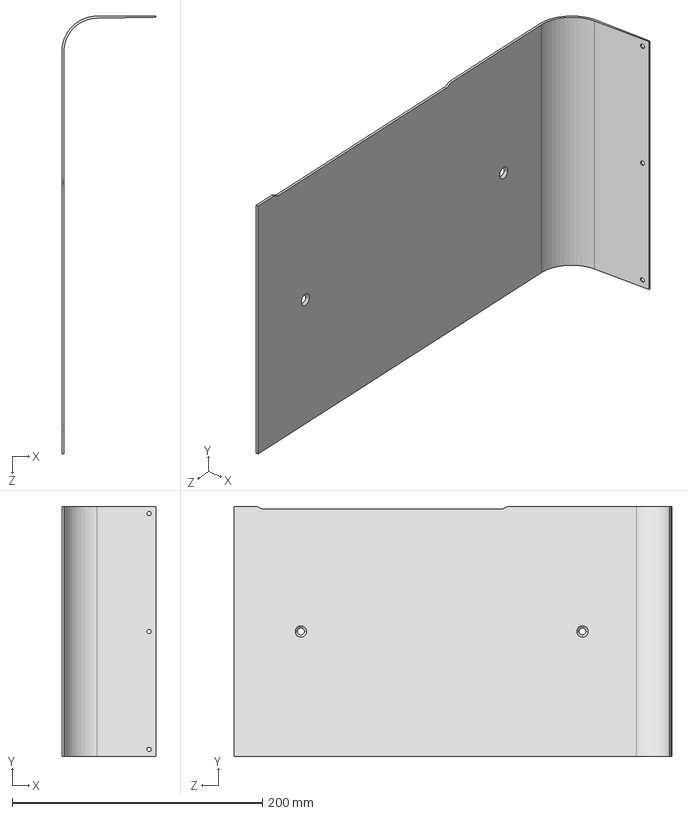
[picture p59: CAD file, 2017-12-07]
Press Part Drawings/Drawing Step Files (STEP)/1844_030_rev_05.STEP
75.5 x 200.0 x 350.0 mm
