SolidoodleDev/Press-Drawings/Press Solidworks Files/raspberry_pi__SD_reader_pin5.SLDPRT

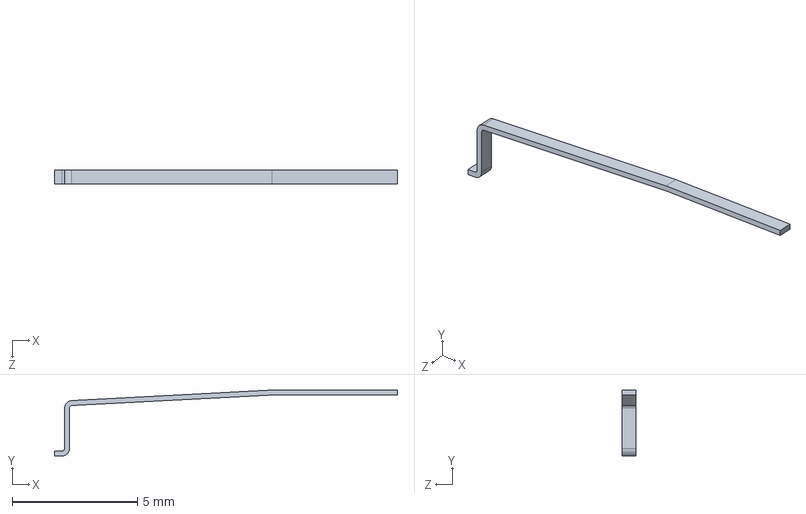
[picture p60: CAD file, 2017-12-07]
Press Solidworks Files/raspberry_pi__SD_reader_pin5.SLDPRT
13.7 x 2.63 x 0.55 mm
