SolidoodleDev/Press-Drawings/Press Part Drawings/Drawing Step Files (STEP)/1844_034_rev_04.STEP

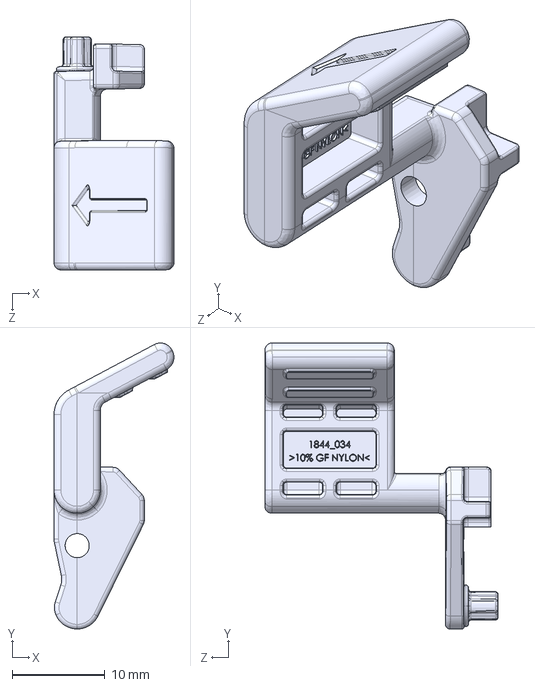
[picture p61: CAD file, 2017-12-07]
Press Part Drawings/Drawing Step Files (STEP)/1844_034_rev_04.STEP
12.9 x 30.9 x 25.2 mm
