SolidoodleDev/Press-Drawings/Press Solidworks Files/raspberry_pi__0402.SLDPRT

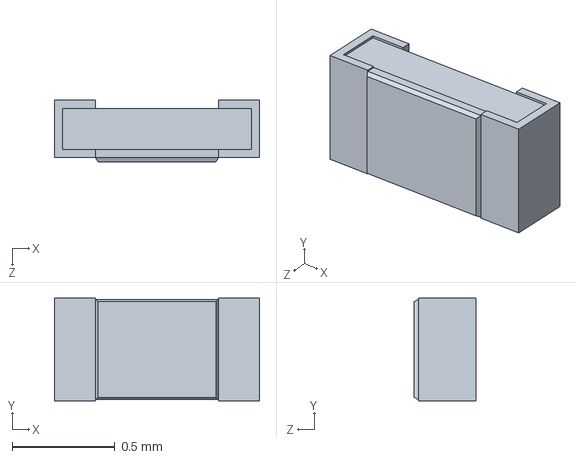
[picture p62: CAD file, 2017-12-07]
Press Solidworks Files/raspberry_pi__0402.SLDPRT
1.00 x 0.5 x 0.3 mm
