SolidoodleDev/Press-Drawings/Press Part Drawings/Drawing Step Files (STEP)/1844_040_rev_03.STEP

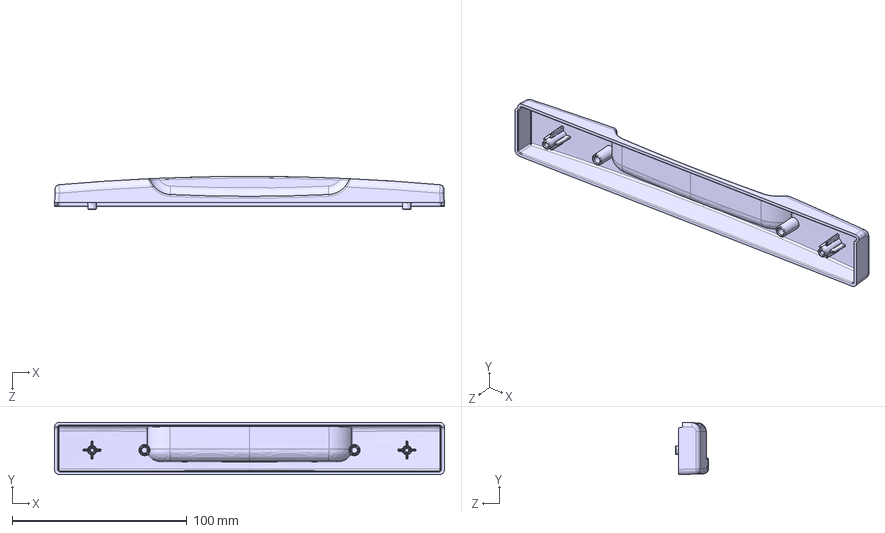
[picture p63: CAD file, 2017-12-07]
Press Part Drawings/Drawing Step Files (STEP)/1844_040_rev_03.STEP
223.0 x 29.9 x 19.0 mm
