SolidoodleDev/Press-Drawings/Press Solidworks Files/raspberry_pi__audio_out.SLDPRT

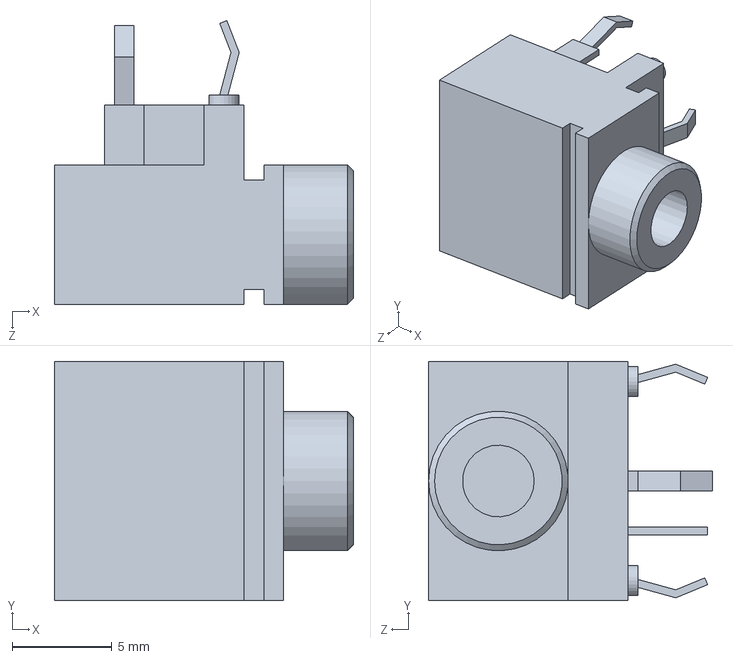
[picture p64: CAD file, 2017-12-07]
Press Solidworks Files/raspberry_pi__audio_out.SLDPRT
15.0 x 12.0 x 14.2 mm
