SolidoodleDev/Press-Drawings/Press Solidworks Files/D2F_01F_D_BASE.SLDPRT

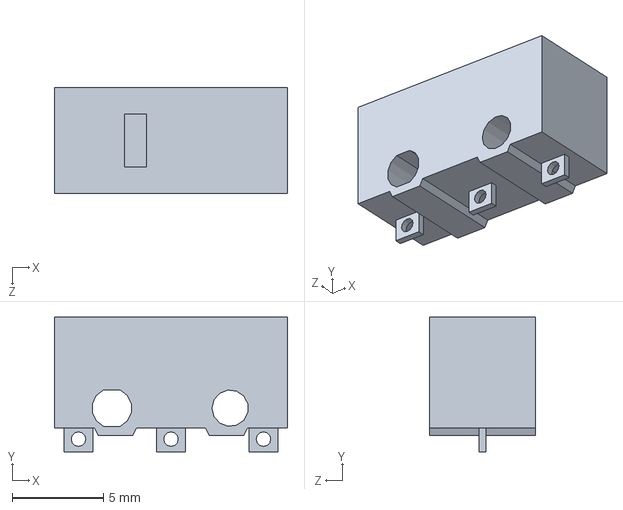
[picture p65: CAD file, 2017-12-07]
Press Solidworks Files/D2F_01F_D_BASE.SLDPRT
12.8 x 7.40 x 5.80 mm
