SolidoodleDev/Press-Drawings/Press Solidworks Files/raspberry_pi__168_FBGA_12x12.SLDPRT

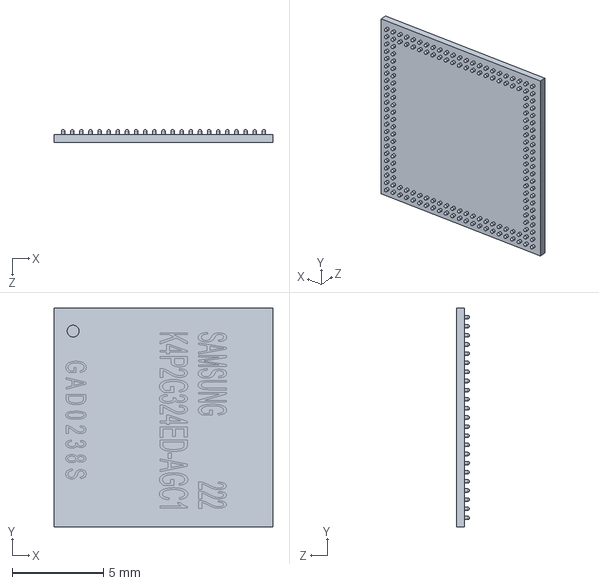
[picture p66: CAD file, 2017-12-07]
Press Solidworks Files/raspberry_pi__168_FBGA_12x12.SLDPRT
12.0 x 12.0 x 0.71 mm
