SolidoodleDev/Press-Drawings/Press Solidworks Files/extruder_heat_sink_master.SLDPRT

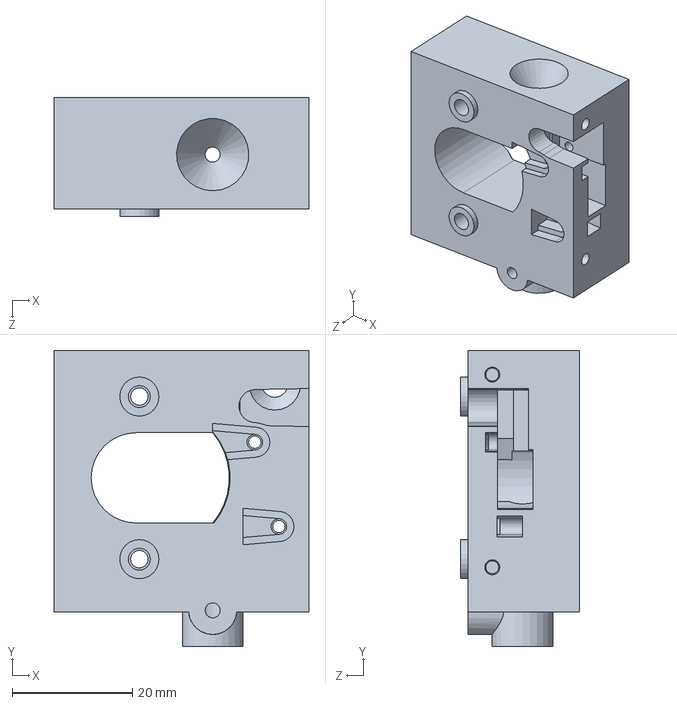
[picture p67: CAD file, 2017-12-07]
Press Solidworks Files/extruder_heat_sink_master.SLDPRT
42.3 x 49.2 x 19.8 mm
