SolidoodleDev/Press-Drawings/Press Solidworks Files/1844_046_rev_03.SLDPRT

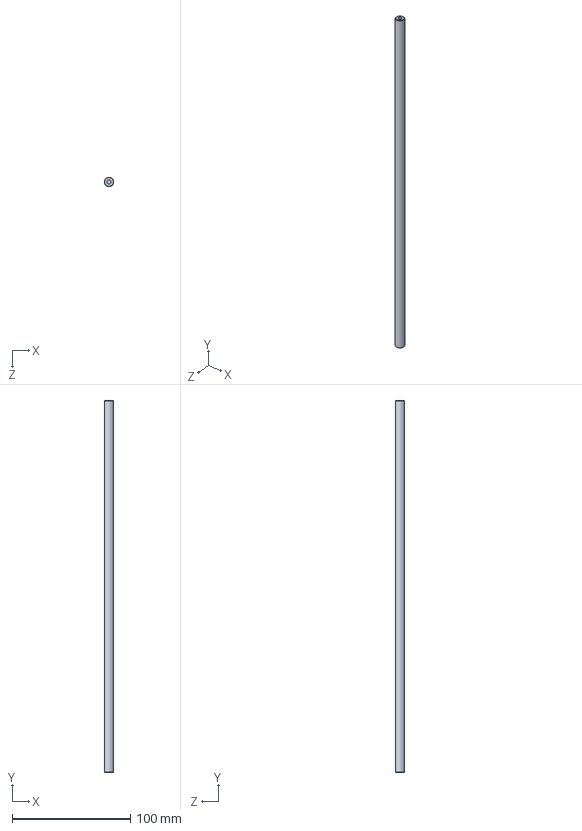
[picture p68: CAD file, 2017-12-07]
Press Solidworks Files/1844_046_rev_03.SLDPRT
8.00 x 315.0 x 8.00 mm
