SolidoodleDev/Press-Drawings/Press Solidworks Files/1844_043.SLDPRT

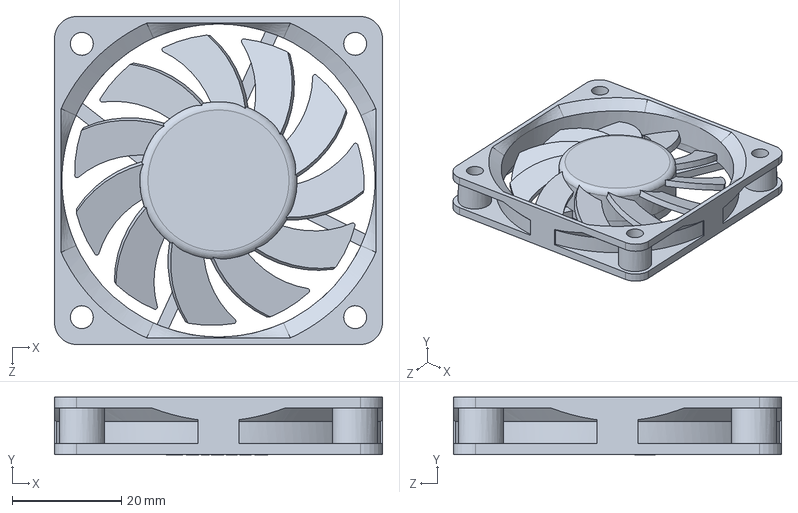
[picture p70: CAD file, 2017-12-07]
Press Solidworks Files/1844_043.SLDPRT
60.0 x 10.6 x 60.0 mm
