SolidoodleDev/Press-Drawings/Press Solidworks Files/raspberry_pi__Smd6.SLDPRT

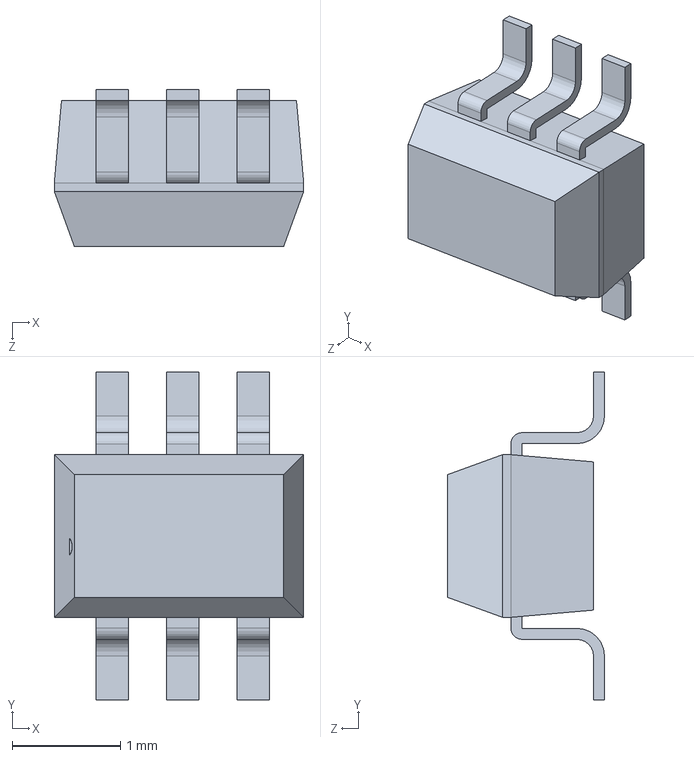
[picture p71: CAD file, 2017-12-07]
Press Solidworks Files/raspberry_pi__Smd6.SLDPRT
2.30 x 3.02 x 1.45 mm
