SolidoodleDev/Press-Drawings/Press Solidworks Files/1844_017_rev_03.SLDPRT

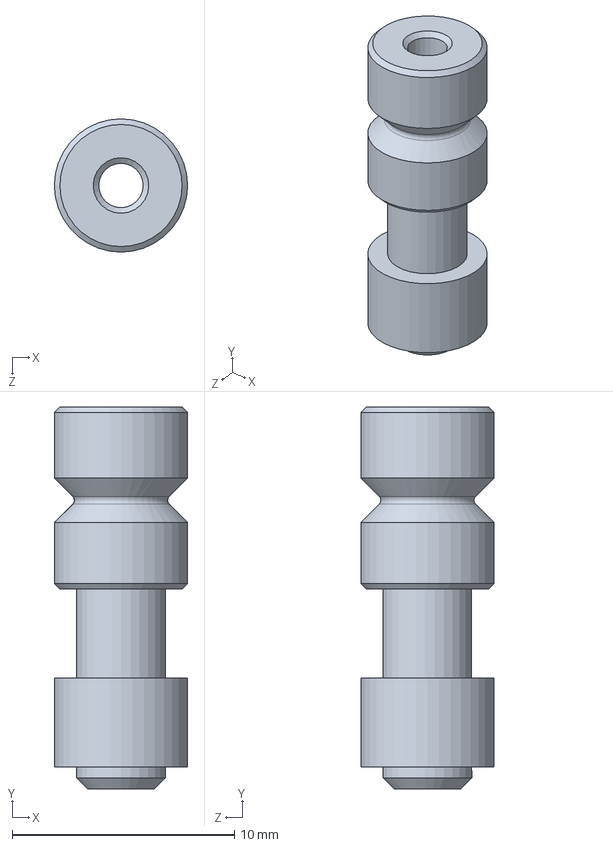
[picture p72: CAD file, 2017-12-07]
Press Solidworks Files/1844_017_rev_03.SLDPRT
6.00 x 17.2 x 6.00 mm
