SolidoodleDev/Press-Drawings/Press Solidworks Files/m4.5x16_plastite.SLDPRT

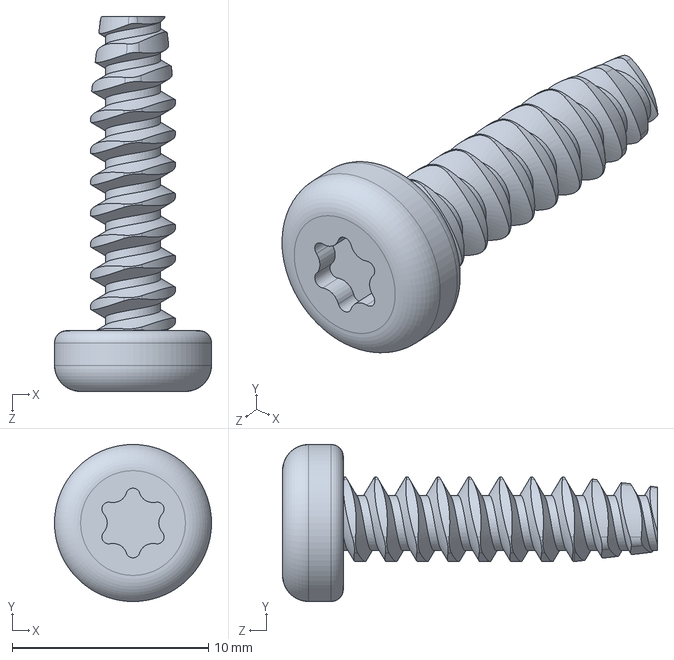
[picture p73: CAD file, 2017-12-07]
Press Solidworks Files/m4.5x16_plastite.SLDPRT
8.00 x 8.00 x 19.1 mm
