SolidoodleDev/Press-Drawings/Press Solidworks Files/raspberry_pi__1210.SLDPRT

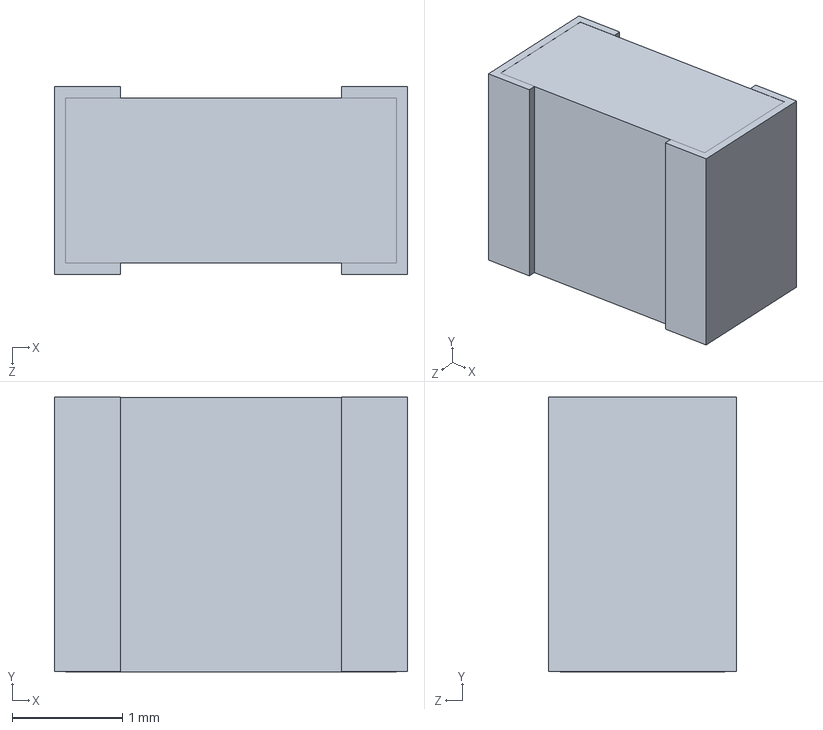
[picture p74: CAD file, 2017-12-07]
Press Solidworks Files/raspberry_pi__1210.SLDPRT
3.20 x 2.49 x 1.70 mm
