SolidoodleDev/Press-Drawings/Press Solidworks Files/raspberry_pi__micro_USB_contacts.SLDPRT

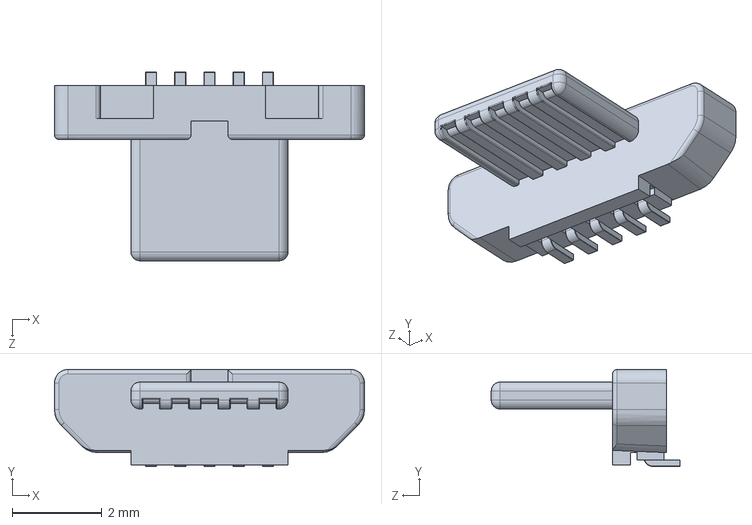
[picture p75: CAD file, 2017-12-07]
Press Solidworks Files/raspberry_pi__micro_USB_contacts.SLDPRT
6.90 x 2.16 x 4.20 mm
