SolidoodleDev/Press-Drawings/Press Solidworks Files/raspberry_pi__diode_10_pins.SLDPRT

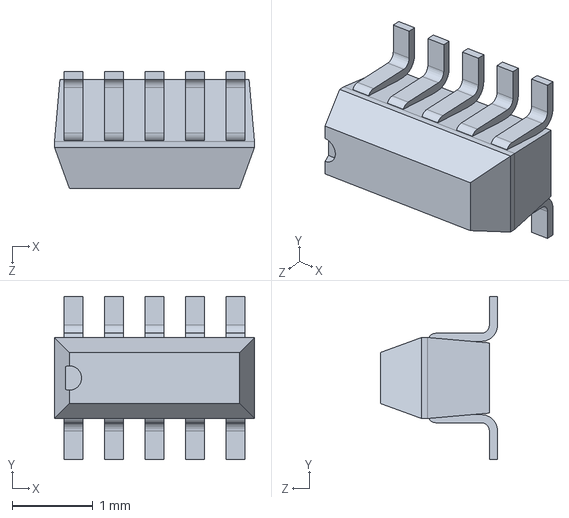
[picture p76: CAD file, 2017-12-07]
Press Solidworks Files/raspberry_pi__diode_10_pins.SLDPRT
2.47 x 2.02 x 1.45 mm
