SolidoodleDev/Press-Drawings/Press Solidworks Files/1844_049_rev_02.SLDPRT

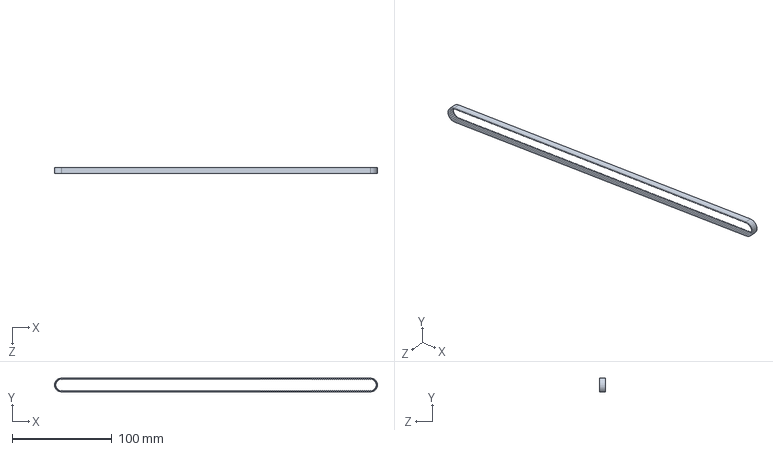
[picture p77: CAD file, 2017-12-07]
Press Solidworks Files/1844_049_rev_02.SLDPRT
323.5 x 13.8 x 6.00 mm
