SolidoodleDev/Press-Drawings/Press Solidworks Files/solidoodle_master.SLDPRT

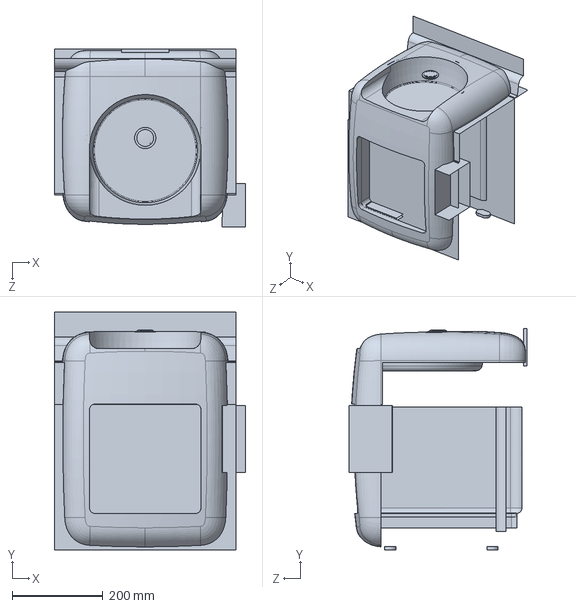
[picture p78: CAD file, 2017-12-07]
Press Solidworks Files/solidoodle_master.SLDPRT
421.0 x 524.5 x 392.0 mm
