SolidoodleDev/Press-Drawings/Press Solidworks Files/1844_063.SLDPRT

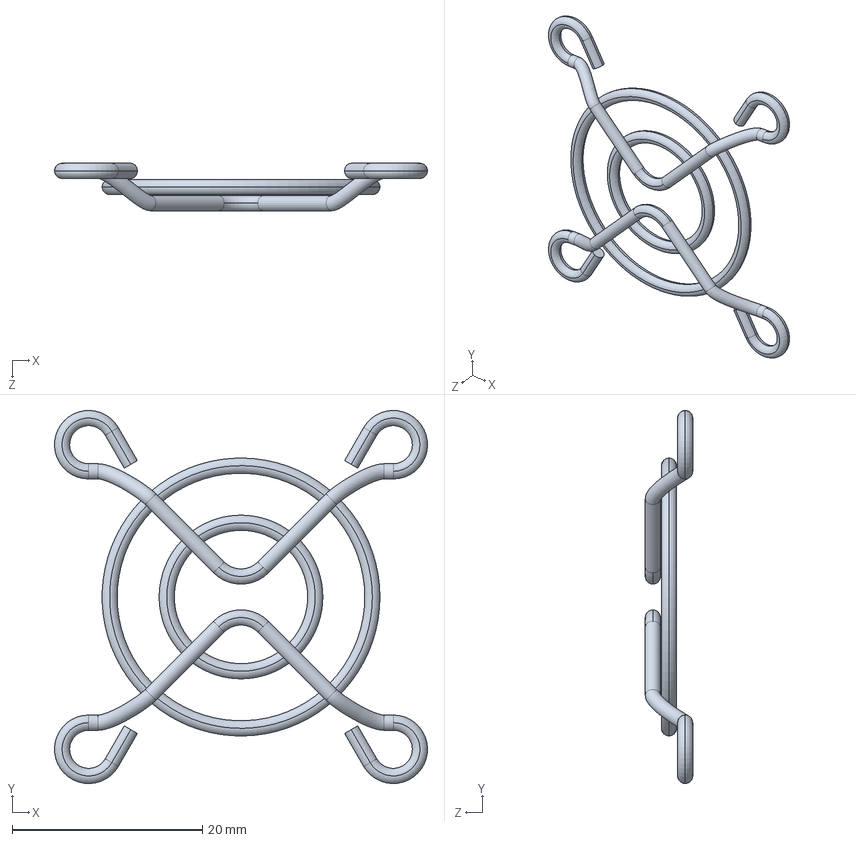
[picture p79: CAD file, 2017-12-07]
Press Solidworks Files/1844_063.SLDPRT
39.2 x 39.2 x 5.00 mm
