SolidoodleDev/Press-Drawings/Press Solidworks Files/1844_044.SLDPRT

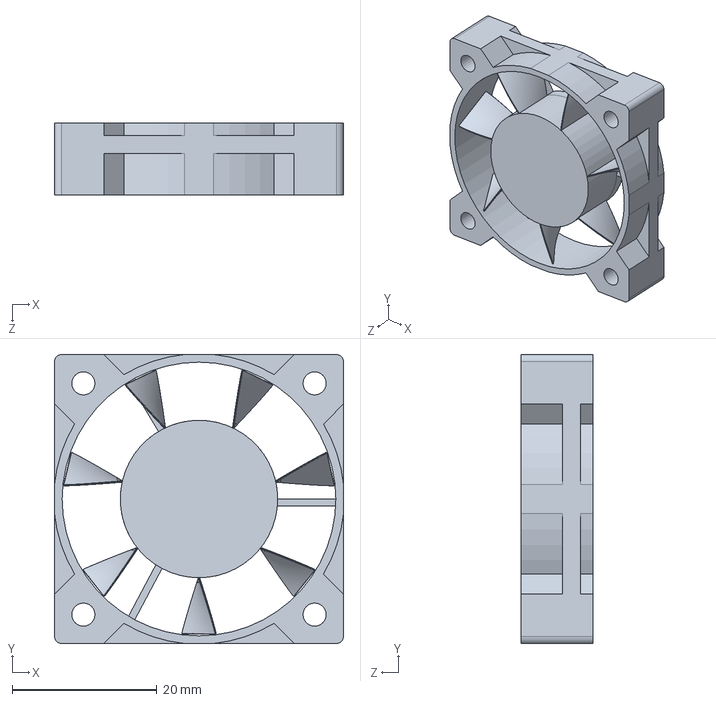
[picture p80: CAD file, 2017-12-07]
Press Solidworks Files/1844_044.SLDPRT
40.0 x 40.0 x 10.0 mm
