SolidoodleDev/Press-Drawings/Press Solidworks Files/1844_061.sldprt

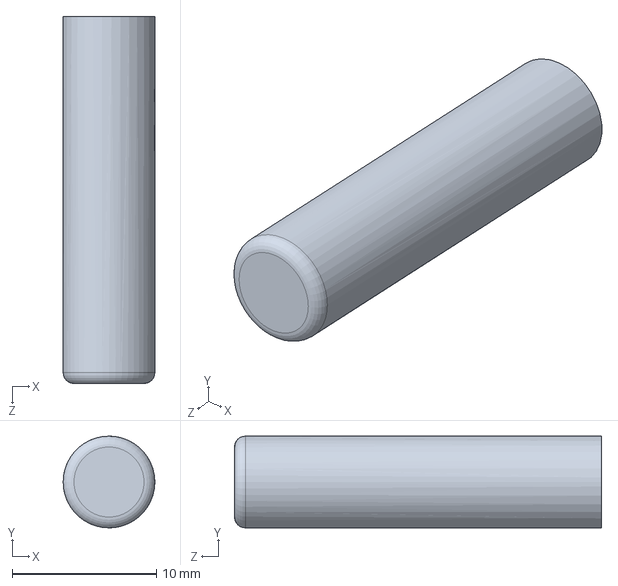
[picture p81: CAD file, 2017-12-07]
Press Solidworks Files/1844_061.sldprt
6.35 x 6.35 x 25.4 mm
