SolidoodleDev/Press-Drawings/Press Solidworks Files/D2F_01FL_A.BASE.SLDPRT

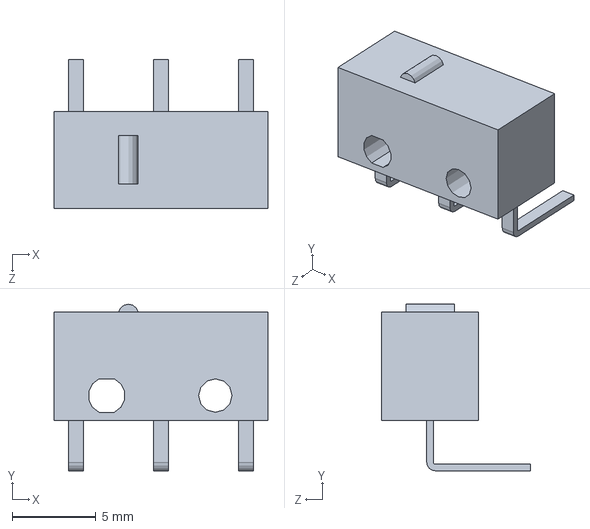
[picture p82: CAD file, 2017-12-07]
Press Solidworks Files/D2F_01FL_A.BASE.SLDPRT
12.8 x 9.96 x 8.90 mm
