SolidoodleDev/Press-Drawings/Press Solidworks Files/raspberry_pi__15_pin_FFC_Connector_locker.SLDPRT

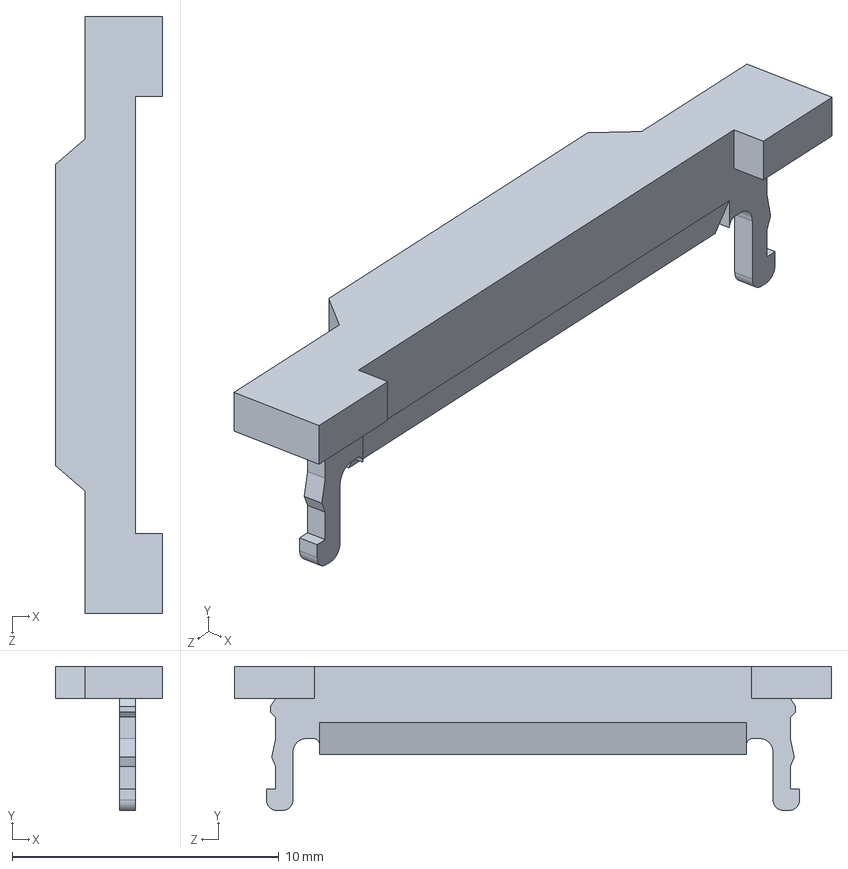
[picture p83: CAD file, 2017-12-07]
Press Solidworks Files/raspberry_pi__15_pin_FFC_Connector_locker.SLDPRT
4.00 x 5.40 x 22.4 mm
