SolidoodleDev/Press-Drawings/Press Solidworks Files/raspberry_pi__bar_180_2x13.SLDPRT

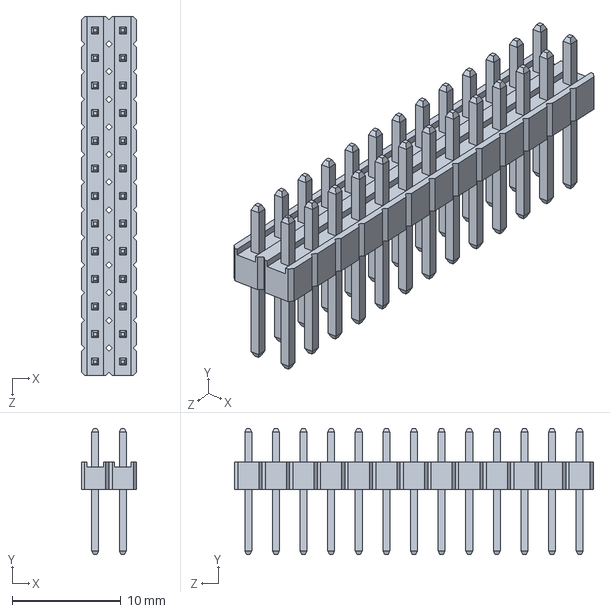
[picture p84: CAD file, 2017-12-07]
Press Solidworks Files/raspberry_pi__bar_180_2x13.SLDPRT
5.08 x 11.6 x 33.0 mm
