SolidoodleDev/Press-Drawings/Press Solidworks Files/raspberry_pi__0603.SLDPRT

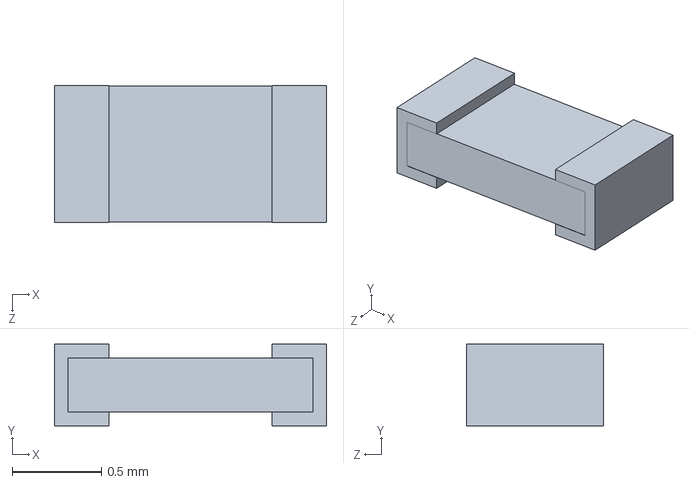
[picture p85: CAD file, 2017-12-07]
Press Solidworks Files/raspberry_pi__0603.SLDPRT
1.52 x 0.457 x 0.767 mm
