SolidoodleDev/Press-Drawings/Press Solidworks Files/raspberry_pi__15_pin_FFC_Connector_body.SLDPRT

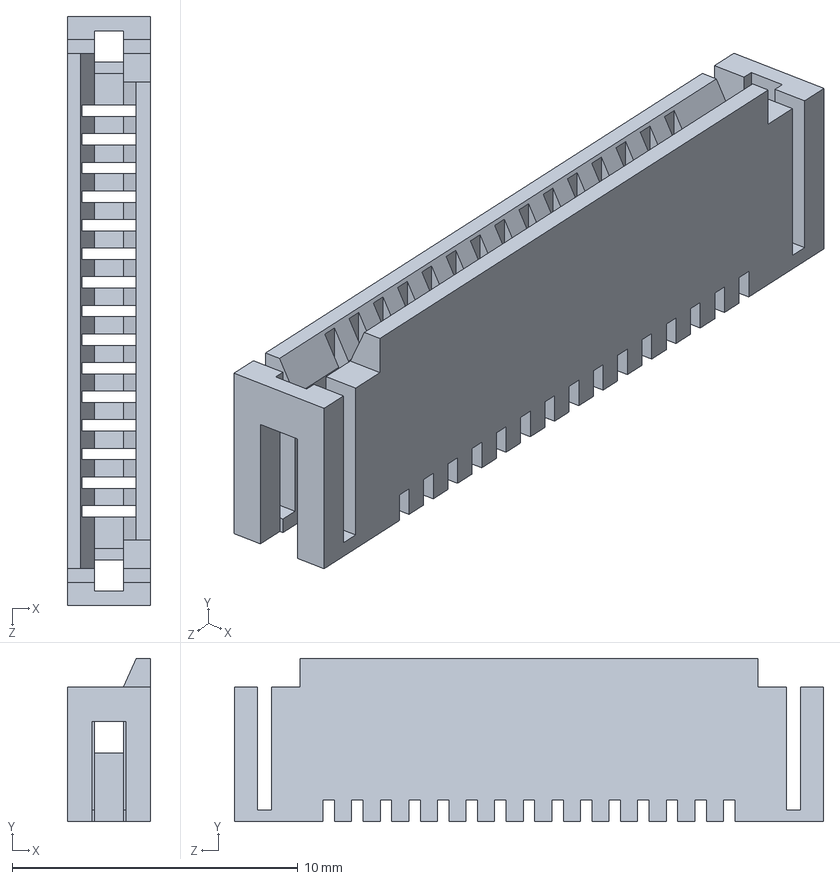
[picture p86: CAD file, 2017-12-07]
Press Solidworks Files/raspberry_pi__15_pin_FFC_Connector_body.SLDPRT
2.90 x 5.70 x 20.6 mm
