SolidoodleDev/Press-Drawings/Press Solidworks Files/m3_bearing.SLDPRT

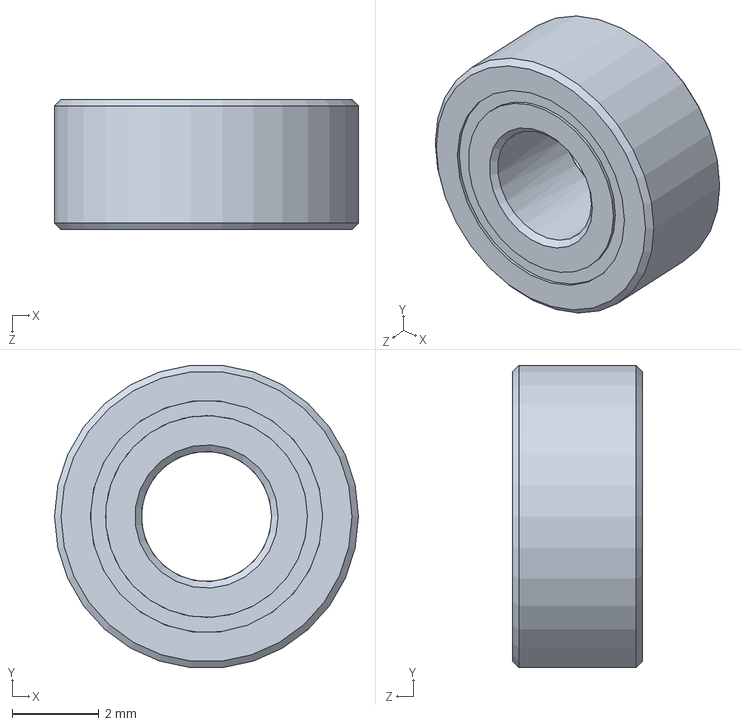
[picture p87: CAD file, 2017-12-07]
Press Solidworks Files/m3_bearing.SLDPRT
7.00 x 6.96 x 3.00 mm
