SolidoodleDev/Press-Drawings/Press Solidworks Files/1844_009_rev_04.SLDPRT

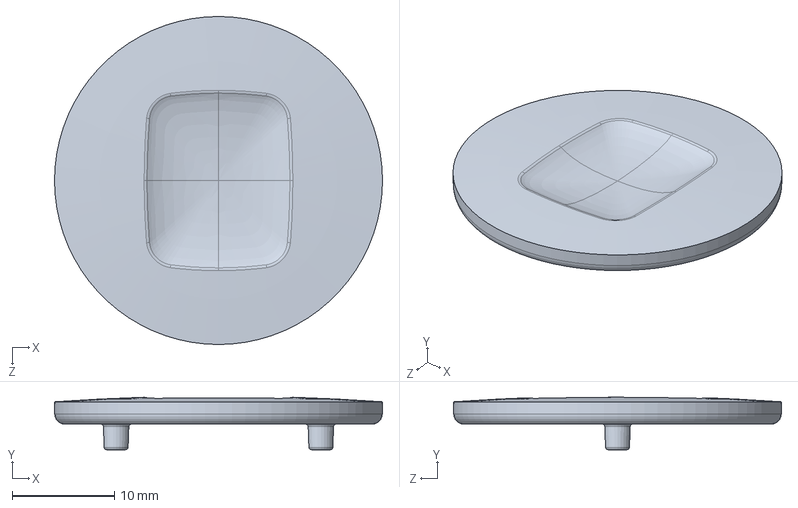
[picture p88: CAD file, 2017-12-07]
Press Solidworks Files/1844_009_rev_04.SLDPRT
32.0 x 5.13 x 32.0 mm
