SolidoodleDev/Press-Drawings/Press Solidworks Files/1844_056.SLDPRT

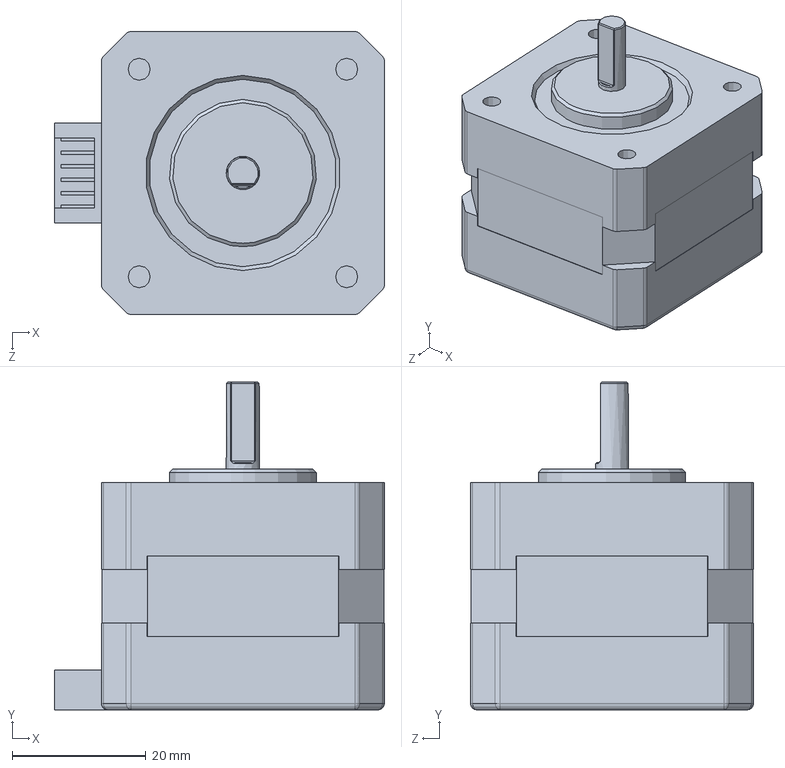
[picture p89: CAD file, 2017-12-07]
Press Solidworks Files/1844_056.SLDPRT
49.3 x 49.0 x 42.3 mm
