SolidoodleDev/Press-Drawings/Press Solidworks Files/raspberry_pi__1206.SLDPRT

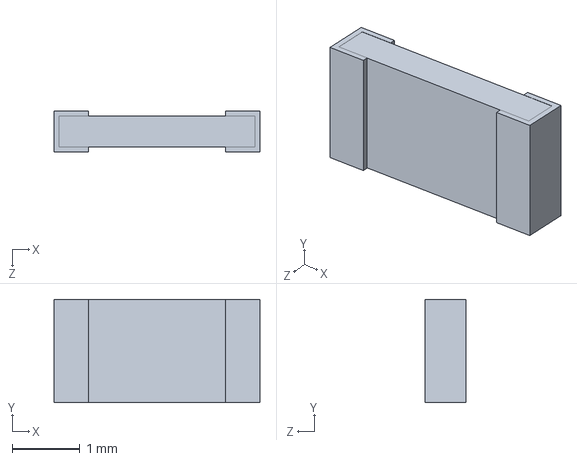
[picture p90: CAD file, 2017-12-07]
Press Solidworks Files/raspberry_pi__1206.SLDPRT
3.05 x 1.53 x 0.61 mm
