SolidoodleDev/Press-Drawings/Press Solidworks Files/1844_052.SLDPRT

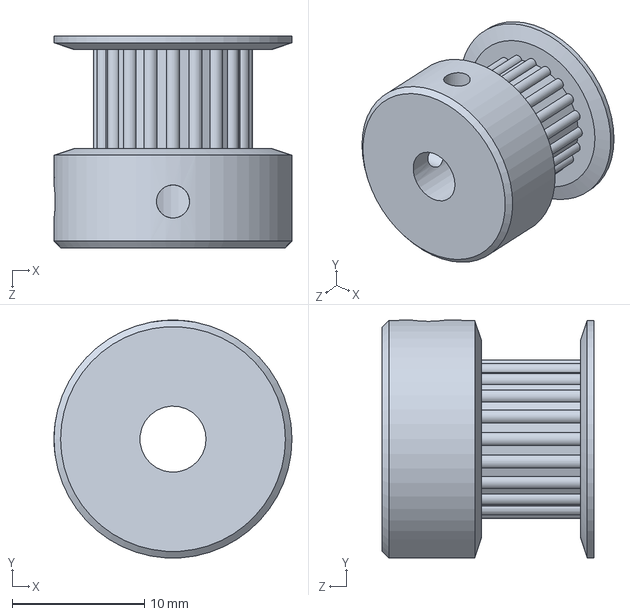
[picture p91: CAD file, 2017-12-07]
Press Solidworks Files/1844_052.SLDPRT
18.0 x 18.0 x 16.0 mm
