SolidoodleDev/Press-Drawings/Press Solidworks Files/raspberry_pi__SD Card.SLDPRT

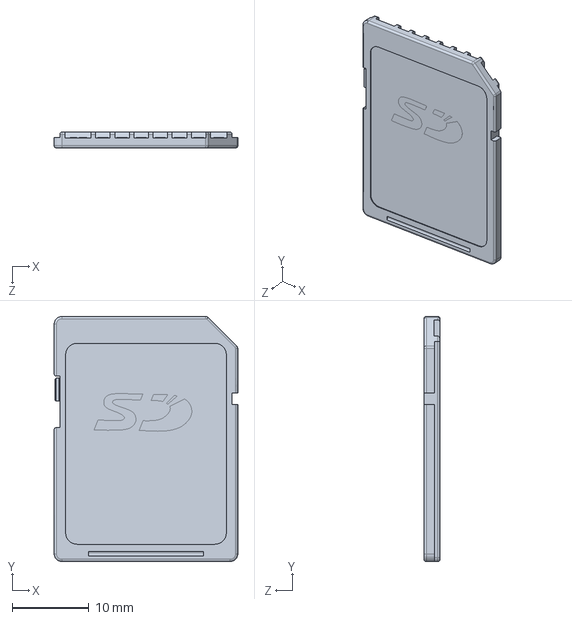
[picture p92: CAD file, 2017-12-07]
Press Solidworks Files/raspberry_pi__SD Card.SLDPRT
24.0 x 32.0 x 2.10 mm
