SolidoodleDev/Press-Drawings/Press Solidworks Files/raspberry_pi__Sot23.SLDPRT

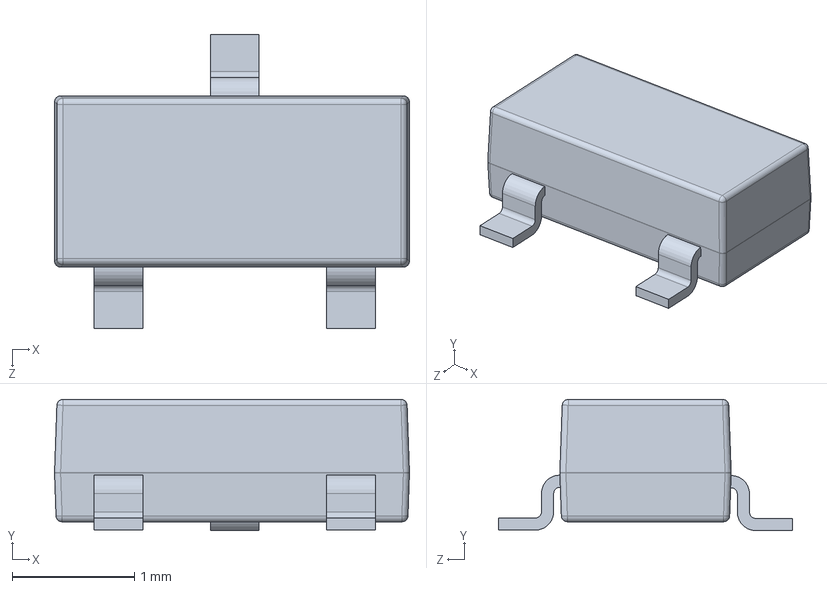
[picture p93: CAD file, 2017-12-07]
Press Solidworks Files/raspberry_pi__Sot23.SLDPRT
2.90 x 1.07 x 2.40 mm
