SolidoodleDev/Press-Drawings/Press Solidworks Files/1844_041_rev_04.SLDPRT

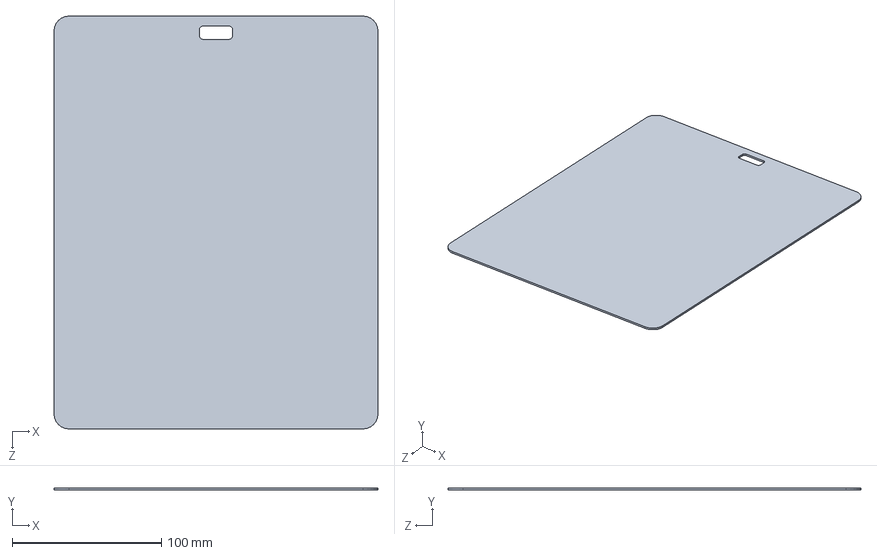
[picture p94: CAD file, 2017-12-07]
Press Solidworks Files/1844_041_rev_04.SLDPRT
217.0 x 1.50 x 276.5 mm
