SolidoodleDev/Press-Drawings/Press Solidworks Files/raspberry_pi__RJ45.SLDPRT

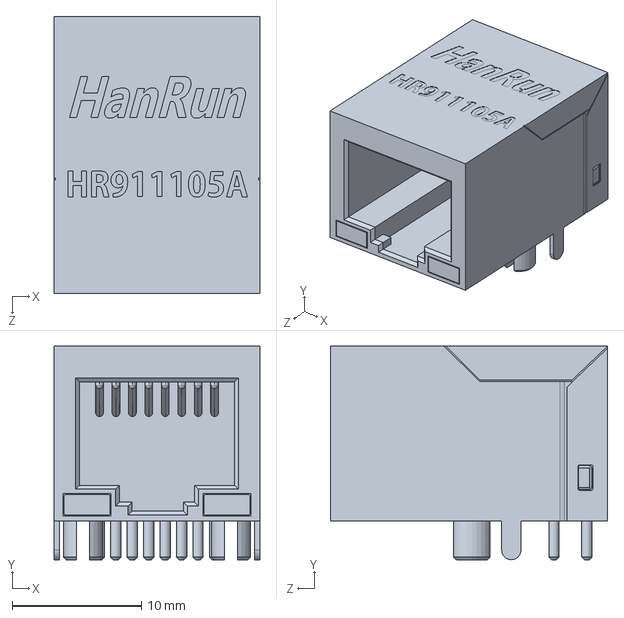
[picture p95: CAD file, 2017-12-07]
Press Solidworks Files/raspberry_pi__RJ45.SLDPRT
15.9 x 16.5 x 21.4 mm
