SolidoodleDev/Press-Drawings/Press Solidworks Files/1844_060.SLDPRT

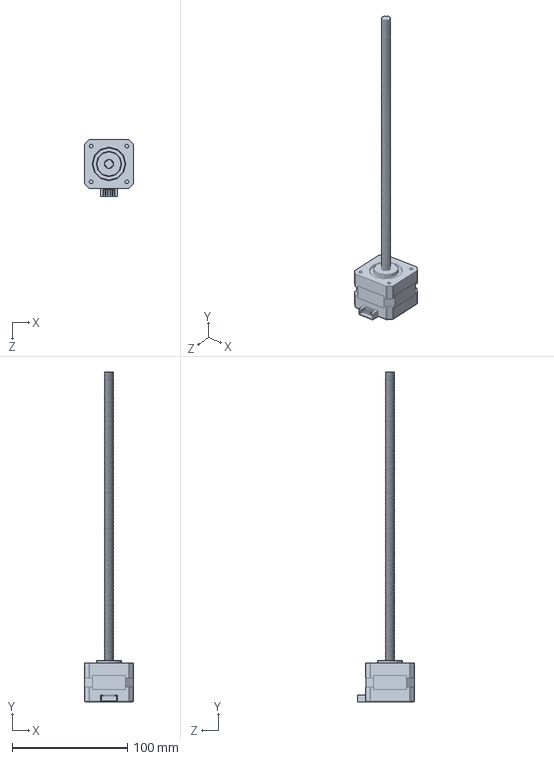
[picture p96: CAD file, 2017-12-07]
Press Solidworks Files/1844_060.SLDPRT
42.3 x 286.0 x 49.3 mm
