SolidoodleDev/Press-Drawings/Press Solidworks Files/print_head_thermistor.SLDPRT

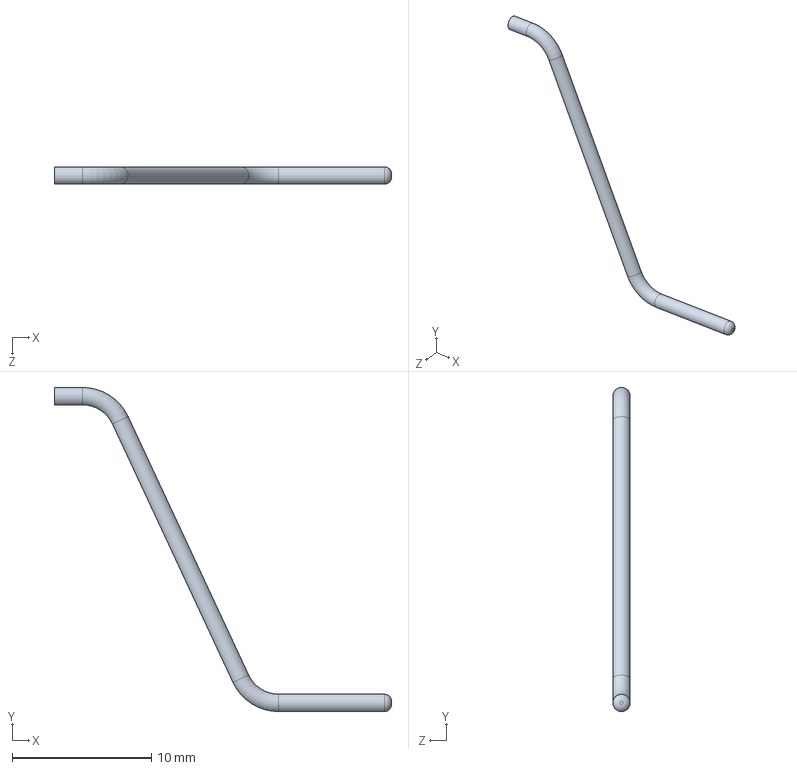
[picture p97: CAD file, 2017-12-07]
Press Solidworks Files/print_head_thermistor.SLDPRT
24.2 x 23.2 x 1.25 mm
