SolidoodleDev/Press-Drawings/Press Solidworks Files/1844_045_rev_03.SLDPRT

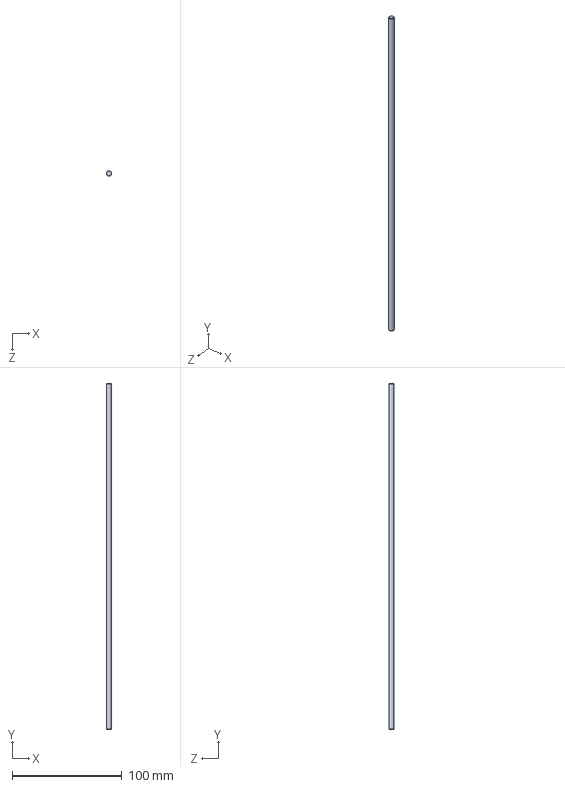
[picture p98: CAD file, 2017-12-07]
Press Solidworks Files/1844_045_rev_03.SLDPRT
5.00 x 315.0 x 5.00 mm
