SolidoodleDev/Press-Drawings/Press Solidworks Files/1844_048_rev_02.SLDPRT

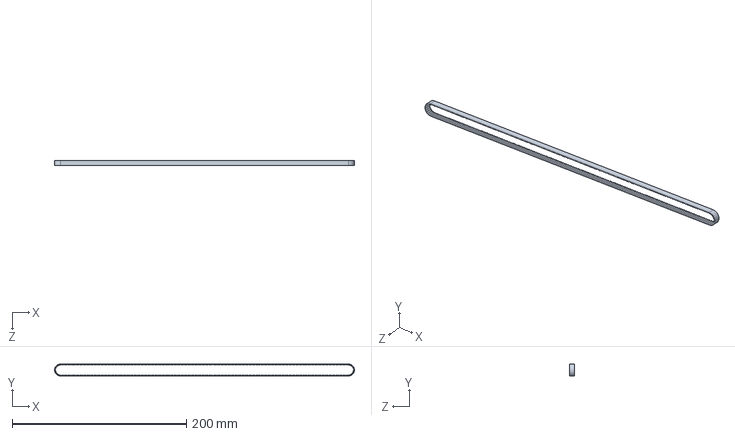
[picture p99: CAD file, 2017-12-07]
Press Solidworks Files/1844_048_rev_02.SLDPRT
344.7 x 13.8 x 6.00 mm
