SolidoodleDev/Press-Drawings/Press Solidworks Files/raspberry_pi__HDMI_socket_cover.SLDPRT

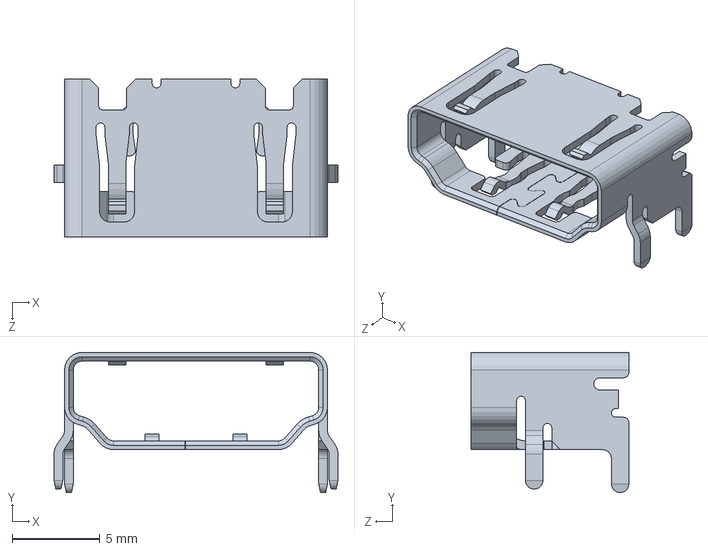
[picture p100: CAD file, 2017-12-07]
Press Solidworks Files/raspberry_pi__HDMI_socket_cover.SLDPRT
16.2 x 8.00 x 9.00 mm
