SolidoodleDev/Press-Drawings/Press Solidworks Files/raspberry_pi__HDMI_socket_large_pin.SLDPRT

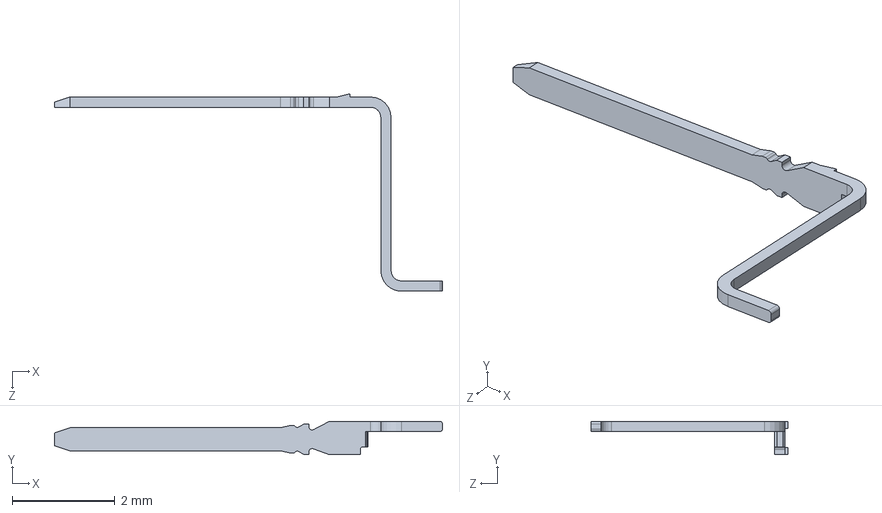
[picture p101: CAD file, 2017-12-07]
Press Solidworks Files/raspberry_pi__HDMI_socket_large_pin.SLDPRT
7.55 x 0.65 x 3.84 mm
