SolidoodleDev/Press-Drawings/Press Solidworks Files/raspberry_pi__micro_USB_cover.SLDPRT

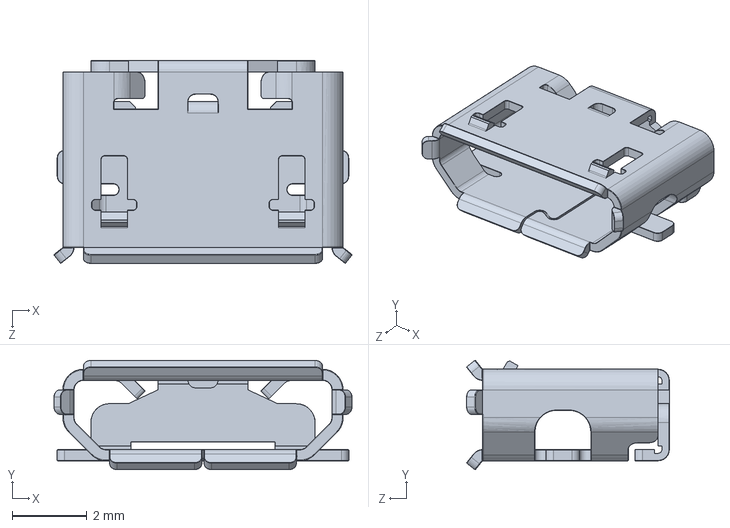
[picture p102: CAD file, 2017-12-07]
Press Solidworks Files/raspberry_pi__micro_USB_cover.SLDPRT
7.97 x 2.92 x 5.43 mm
