SolidoodleDev/Press-Drawings/Press Solidworks Files/build_volume.SLDPRT

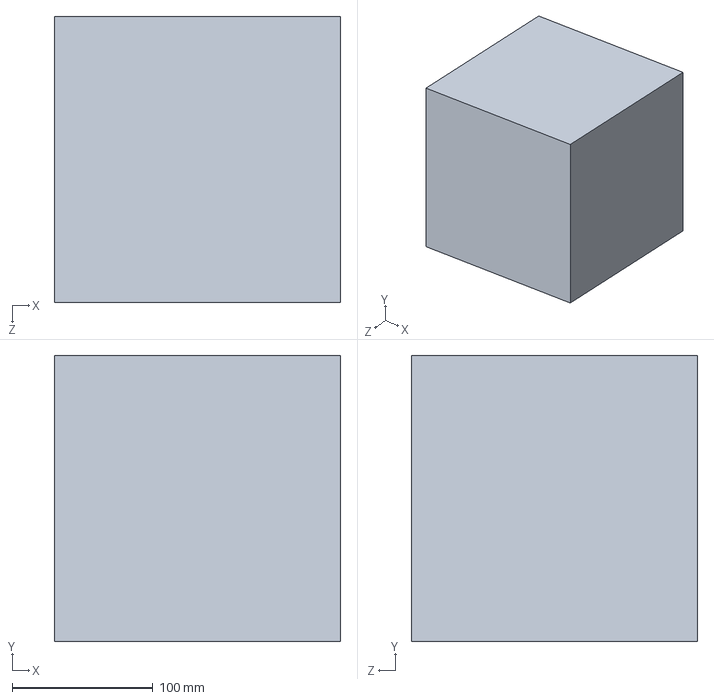
[picture p103: CAD file, 2017-12-07]
Press Solidworks Files/build_volume.SLDPRT
203.2 x 203.2 x 203.2 mm
