SolidoodleDev/Press-Drawings/Press Solidworks Files/raspberry_pi__HDMI_socket_inside.SLDPRT

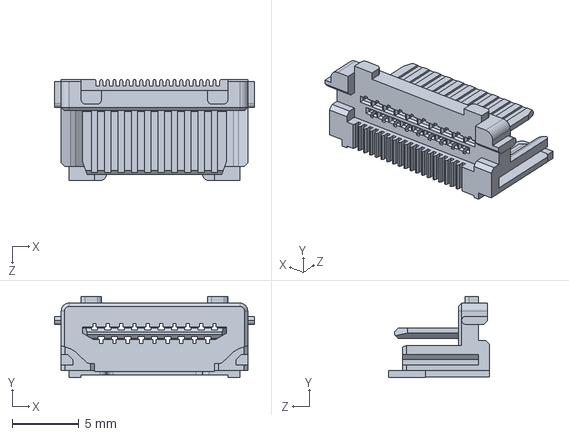
[picture p104: CAD file, 2017-12-07]
Press Solidworks Files/raspberry_pi__HDMI_socket_inside.SLDPRT
15.0 x 6.10 x 7.60 mm
