SolidoodleDev/Press-Drawings/Press Solidworks Files/raspberry_pi__bar_180_1x8.SLDPRT

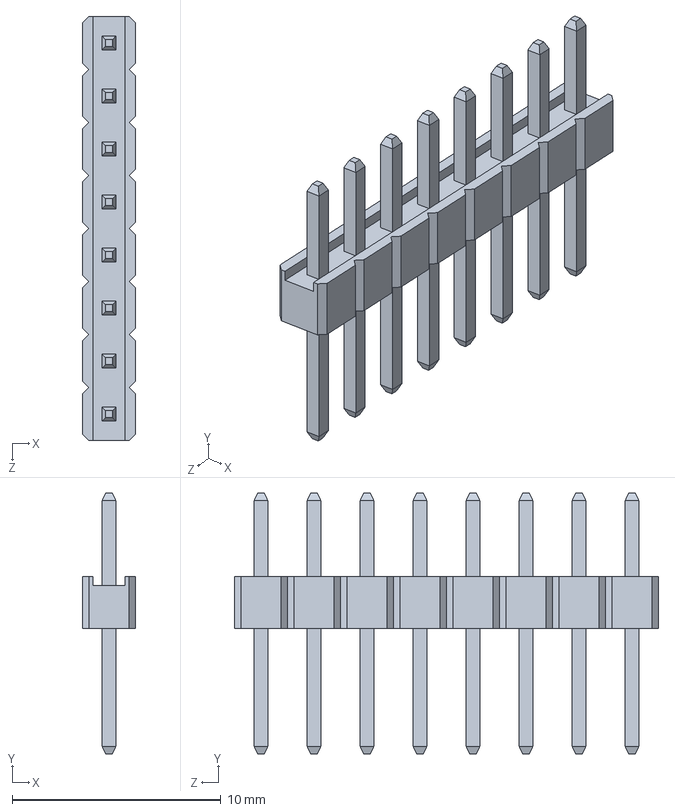
[picture p105: CAD file, 2017-12-07]
Press Solidworks Files/raspberry_pi__bar_180_1x8.SLDPRT
2.54 x 12.5 x 20.3 mm
