SolidoodleDev/Press-Drawings/Press Solidworks Files/1844_038.SLDPRT

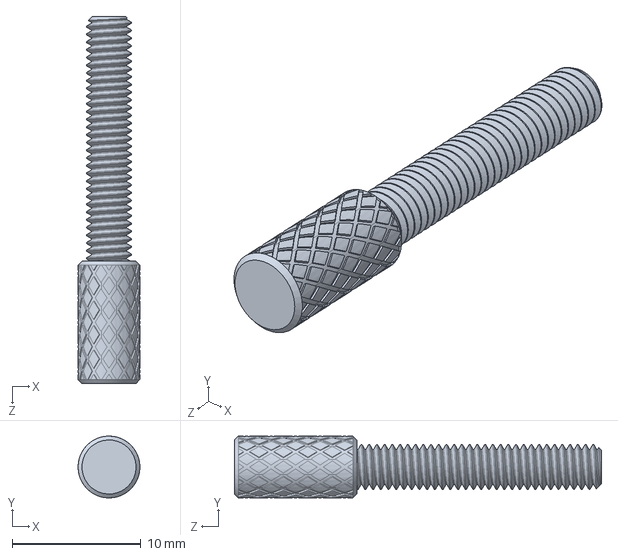
[picture p106: CAD file, 2017-12-07]
Press Solidworks Files/1844_038.SLDPRT
4.80 x 4.80 x 28.5 mm
