SolidoodleDev/Press-Drawings/Press Solidworks Files/micro_switch_pcb.SLDPRT

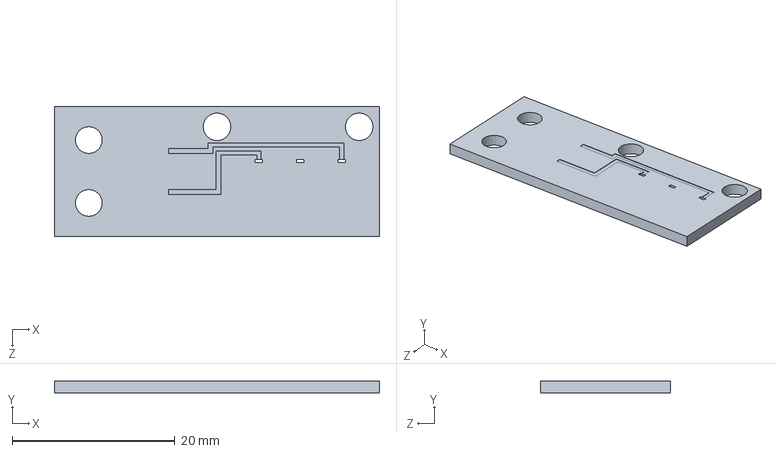
[picture p107: CAD file, 2017-12-07]
Press Solidworks Files/micro_switch_pcb.SLDPRT
40.0 x 1.50 x 16.0 mm
