SolidoodleDev/Press-Drawings/Press Solidworks Files/m4.5x12_flathead_plastite.SLDPRT

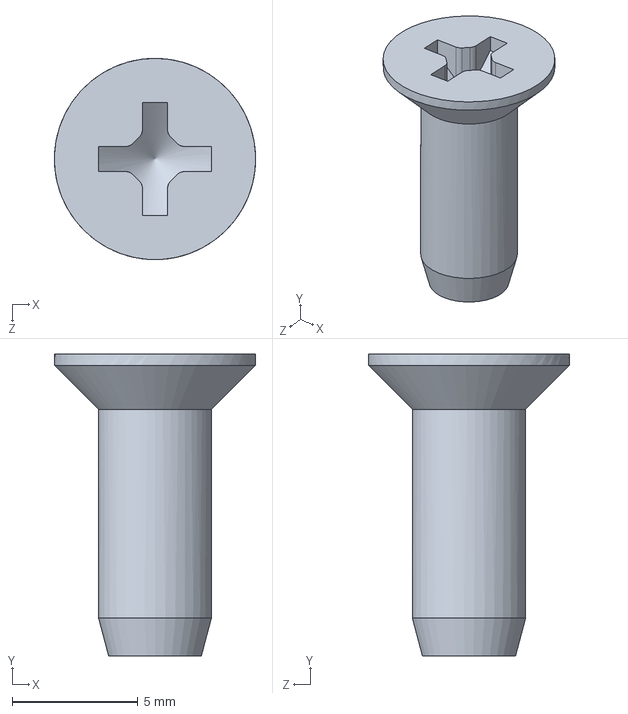
[picture p108: CAD file, 2017-12-07]
Press Solidworks Files/m4.5x12_flathead_plastite.SLDPRT
8.00 x 12.0 x 8.00 mm
