SolidoodleDev/Press-Drawings/Press Solidworks Files/microSD.SLDPRT

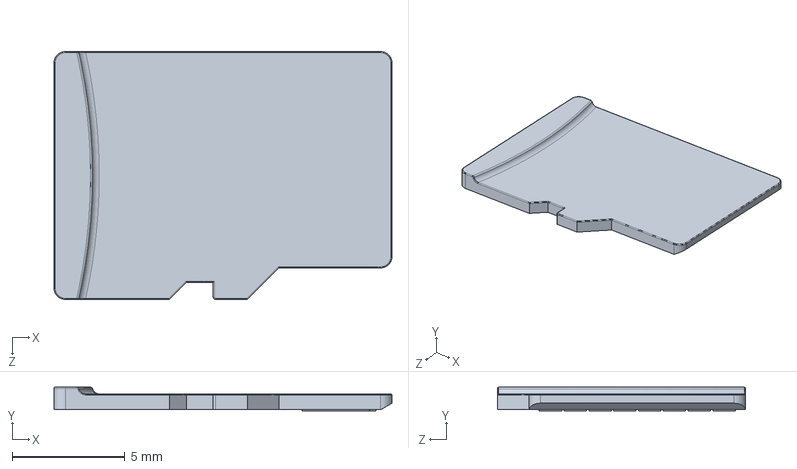
[picture p109: CAD file, 2017-12-07]
Press Solidworks Files/microSD.SLDPRT
15.0 x 1.05 x 11.0 mm
