SolidoodleDev/Press-Drawings/Press Solidworks Files/raspberry_pi__SD_reader_pin1.SLDPRT

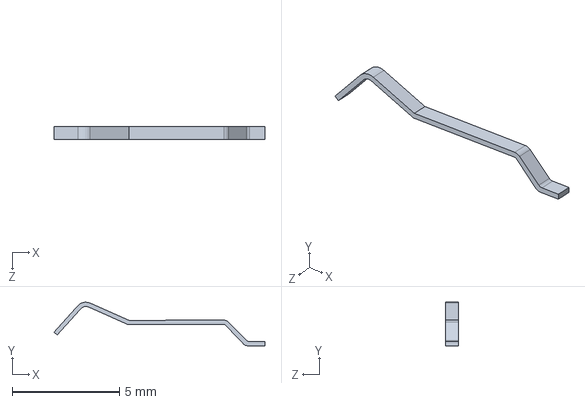
[picture p110: CAD file, 2017-12-07]
Press Solidworks Files/raspberry_pi__SD_reader_pin1.SLDPRT
9.85 x 2.04 x 0.6 mm
