SolidoodleDev/Press-Drawings/Press Solidworks Files/1844_035_rev_04.SLDPRT

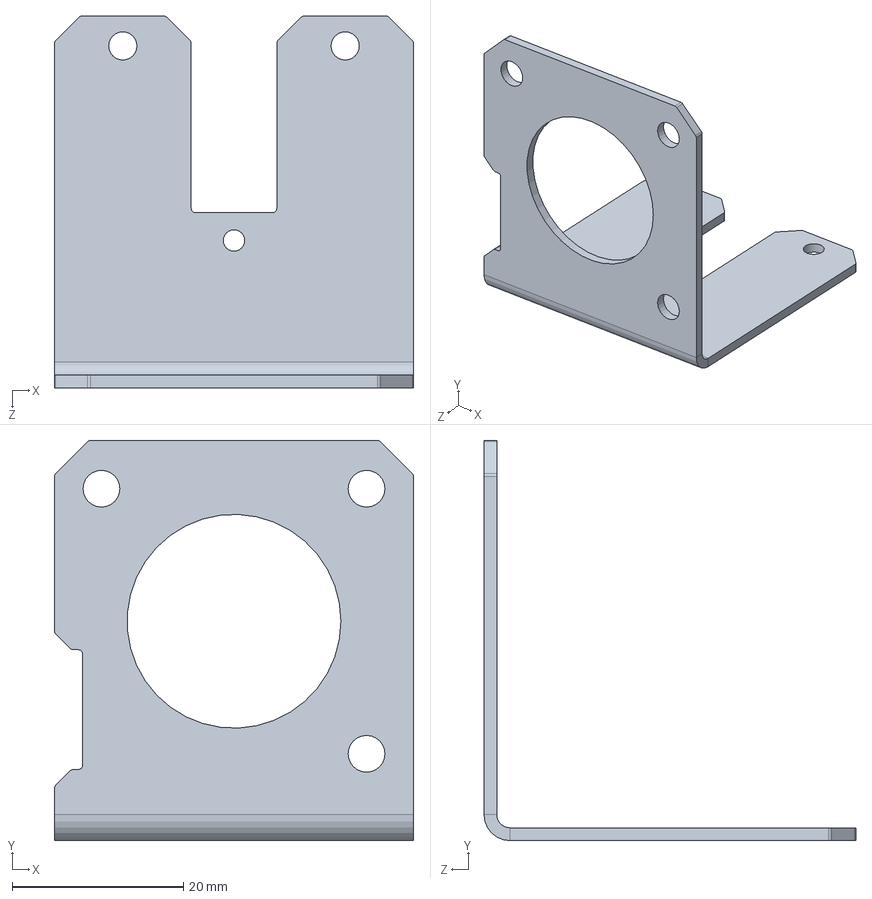
[picture p111: CAD file, 2017-12-07]
Press Solidworks Files/1844_035_rev_04.SLDPRT
42.0 x 46.8 x 43.5 mm
