SolidoodleDev/Press-Drawings/Press Solidworks Files/raspberry_pi__QFN64-2.SLDPRT

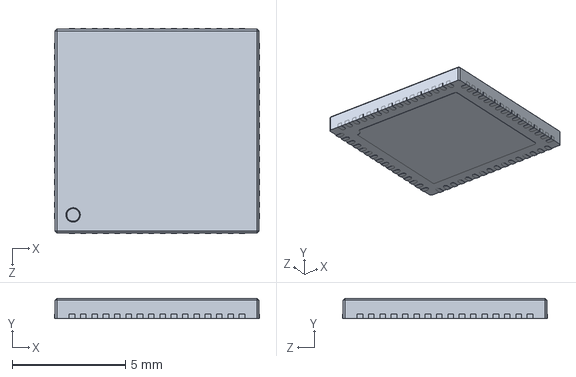
[picture p112: CAD file, 2017-12-07]
Press Solidworks Files/raspberry_pi__QFN64-2.SLDPRT
9.04 x 0.9 x 9.04 mm
