SolidoodleDev/Press-Drawings/Press Solidworks Files/m4.5x10_plastite.SLDPRT

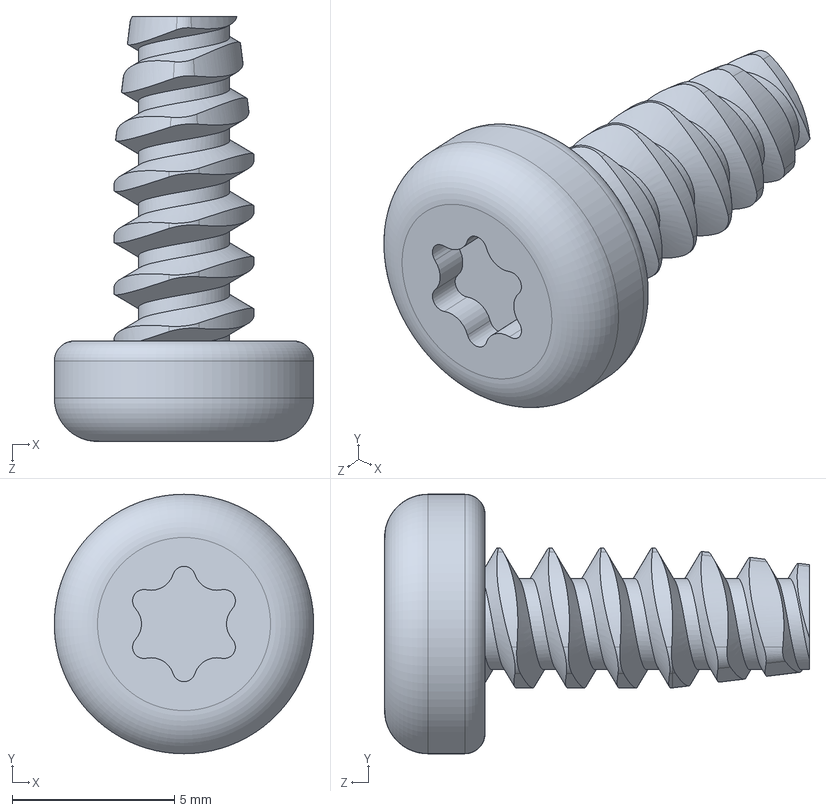
[picture p113: CAD file, 2017-12-07]
Press Solidworks Files/m4.5x10_plastite.SLDPRT
7.99 x 8.00 x 13.1 mm
