SolidoodleDev/Press-Drawings/Press Solidworks Files/raspberry_pi__SOD-123_DiodesInc.SLDPRT

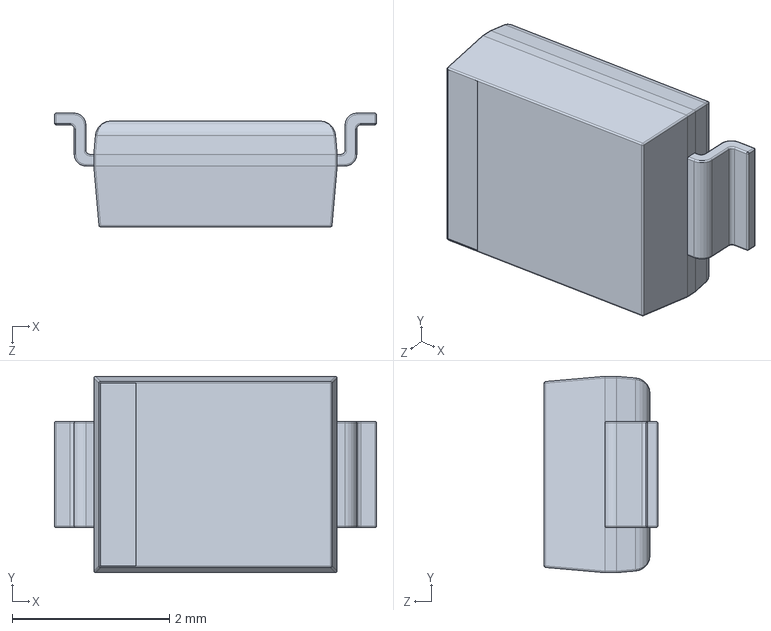
[picture p114: CAD file, 2017-12-07]
Press Solidworks Files/raspberry_pi__SOD-123_DiodesInc.SLDPRT
4.10 x 2.50 x 1.45 mm
