SolidoodleDev/Press-Drawings/Press Solidworks Files/raspberry_pi__SD_reader_pin3.SLDPRT

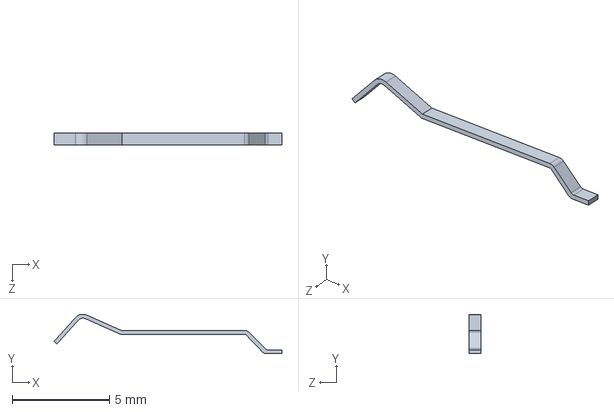
[picture p115: CAD file, 2017-12-07]
Press Solidworks Files/raspberry_pi__SD_reader_pin3.SLDPRT
11.7 x 2.03 x 0.6 mm
