SolidoodleDev/Press-Drawings/Press Solidworks Files/1844_068_rev_04.SLDPRT

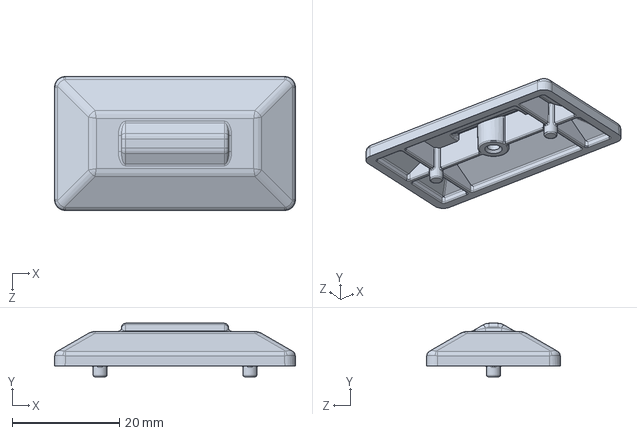
[picture p116: CAD file, 2017-12-07]
Press Solidworks Files/1844_068_rev_04.SLDPRT
45.0 x 10.0 x 25.0 mm
