SolidoodleDev/Press-Drawings/Press Solidworks Files/switch.SLDPRT

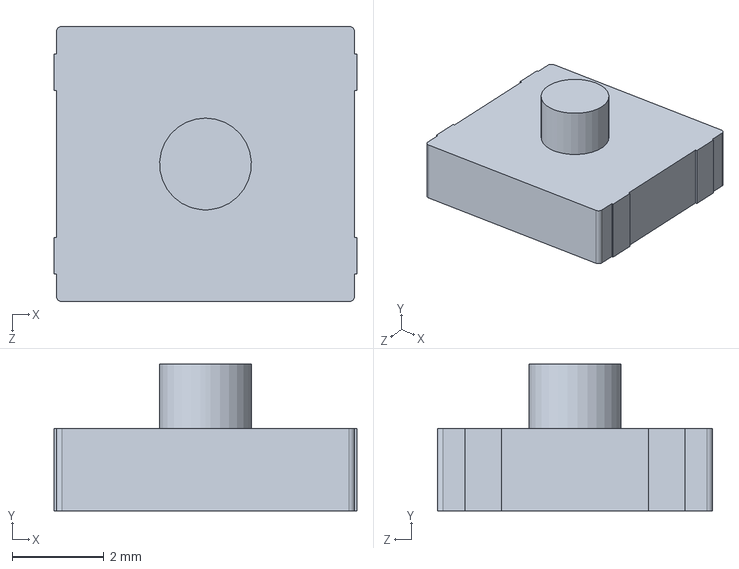
[picture p117: CAD file, 2017-12-07]
Press Solidworks Files/switch.SLDPRT
6.60 x 3.20 x 6.00 mm
