SolidoodleDev/Press-Drawings/Press Solidworks Files/raspberry_pi__Sot23-3_5pins.SLDPRT

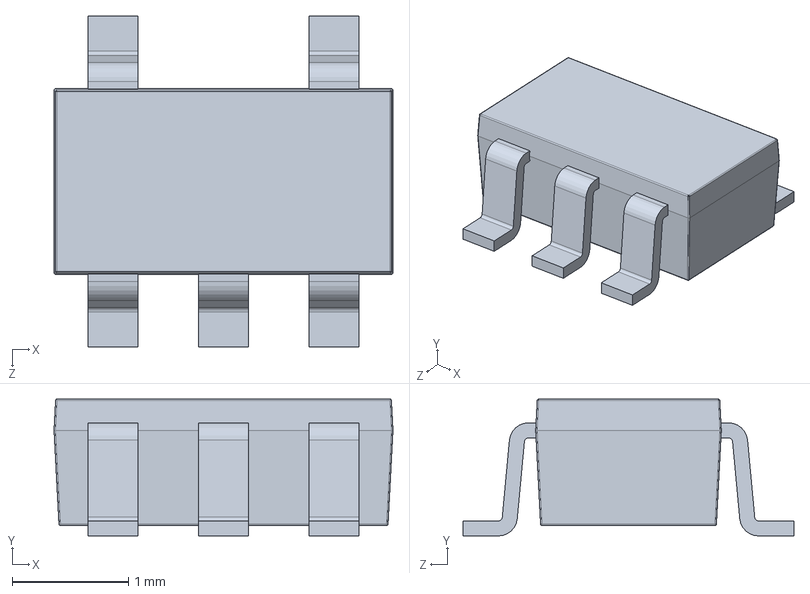
[picture p118: CAD file, 2017-12-07]
Press Solidworks Files/raspberry_pi__Sot23-3_5pins.SLDPRT
2.92 x 1.18 x 2.85 mm
