SolidoodleDev/Press-Drawings/Press Solidworks Files/raspberry_pi__1206xl.SLDPRT

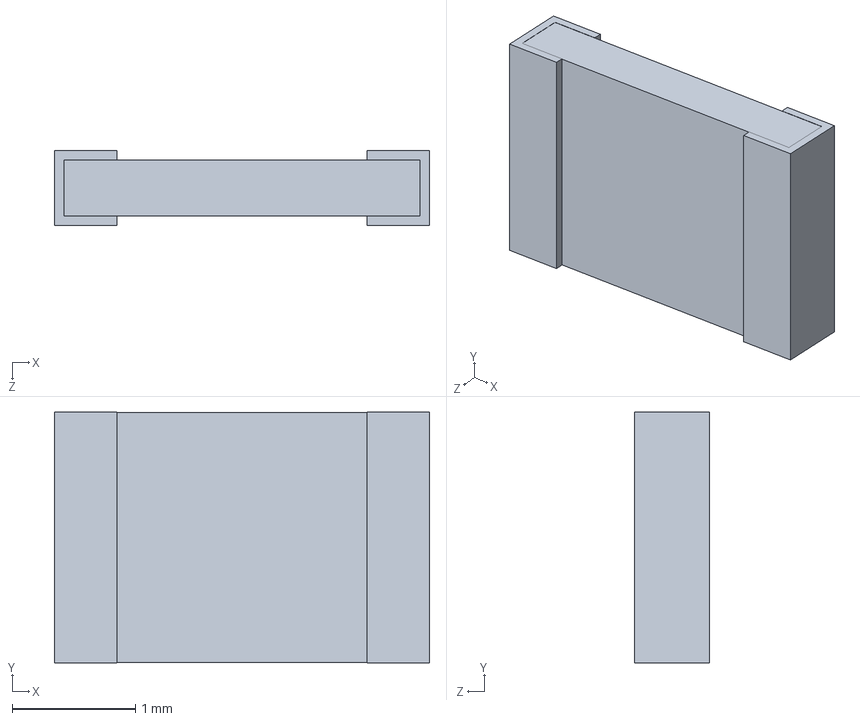
[picture p119: CAD file, 2017-12-07]
Press Solidworks Files/raspberry_pi__1206xl.SLDPRT
3.05 x 2.04 x 0.61 mm
