SolidoodleDev/Press-Drawings/Press Solidworks Files/raspberry_pi__Sot223.SLDPRT

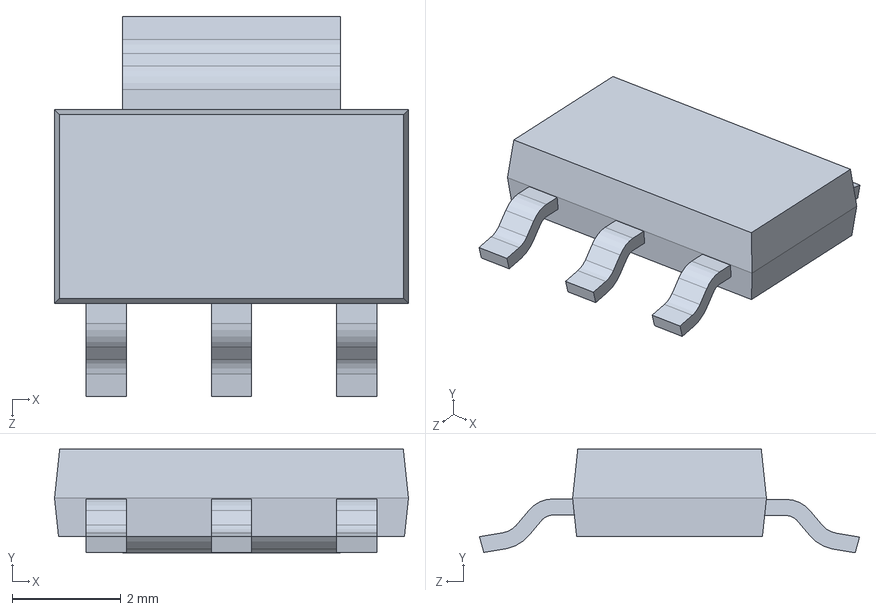
[picture p120: CAD file, 2017-12-07]
Press Solidworks Files/raspberry_pi__Sot223.SLDPRT
6.50 x 1.90 x 6.98 mm
