SolidoodleDev/Press-Drawings/Press Solidworks Files/raspberry_pi__15_pin_FFC_Connector_pins.SLDPRT

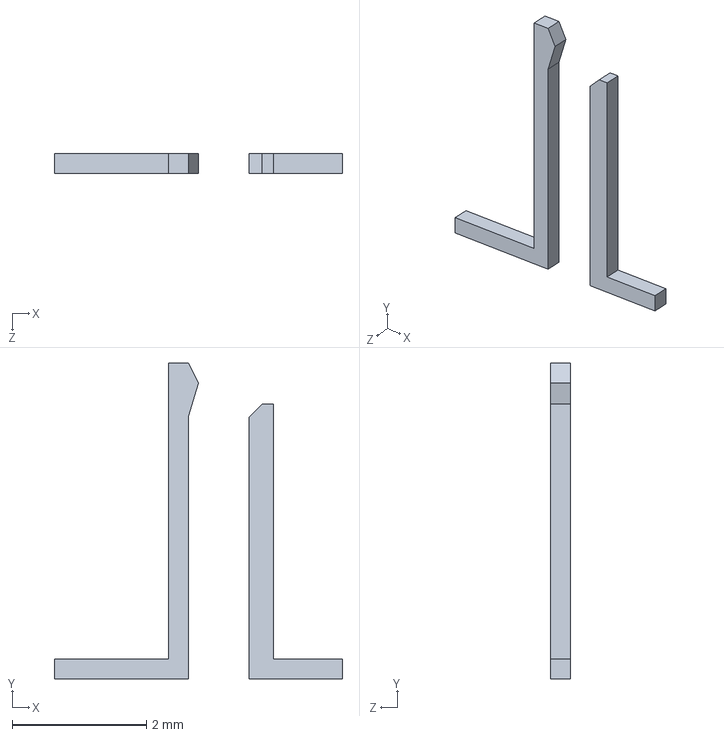
[picture p121: CAD file, 2017-12-07]
Press Solidworks Files/raspberry_pi__15_pin_FFC_Connector_pins.SLDPRT
4.30 x 4.71 x 0.3 mm
