SolidoodleDev/Press-Drawings/Press Solidworks Files/1844_023_rev_04.SLDPRT

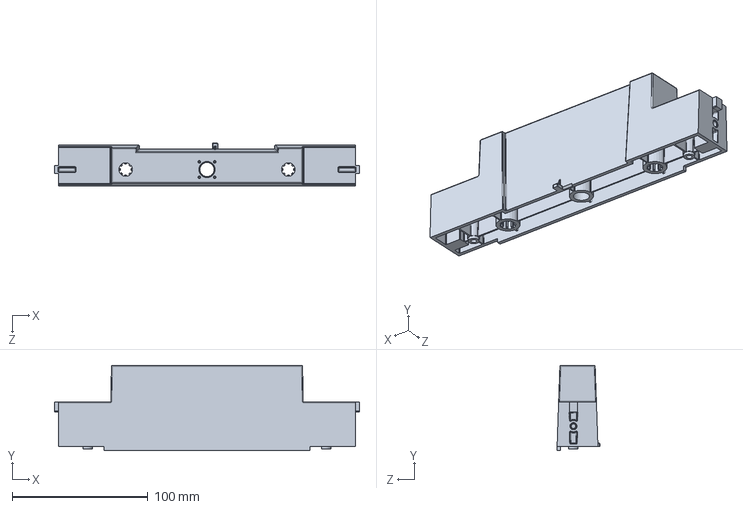
[picture p122: CAD file, 2017-12-07]
Press Solidworks Files/1844_023_rev_04.SLDPRT
225.0 x 62.8 x 31.8 mm
