SolidoodleDev/Press-Drawings/Press Solidworks Files/m2.5x6_plastite.SLDPRT

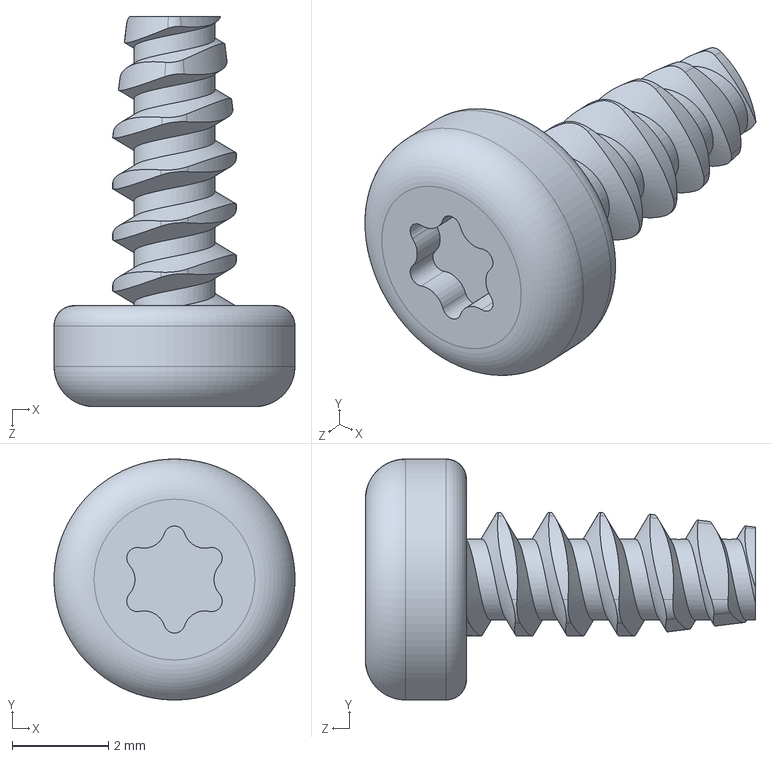
[picture p123: CAD file, 2017-12-07]
Press Solidworks Files/m2.5x6_plastite.SLDPRT
5.00 x 5.00 x 8.10 mm
