SolidoodleDev/Press-Drawings/Press Solidworks Files/raspberry_pi__LED_SMD_0603.SLDPRT

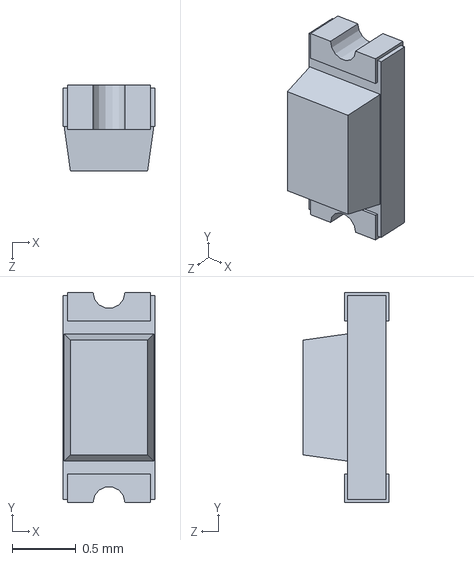
[picture p124: CAD file, 2017-12-07]
Press Solidworks Files/raspberry_pi__LED_SMD_0603.SLDPRT
0.725 x 1.65 x 0.675 mm
