SolidoodleDev/Press-Drawings/Press Solidworks Files/1844_058.SLDPRT

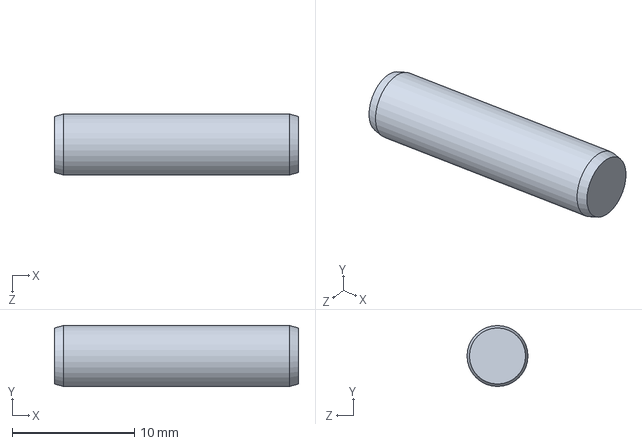
[picture p125: CAD file, 2017-12-07]
Press Solidworks Files/1844_058.SLDPRT
20.0 x 5.00 x 5.00 mm
