SolidoodleDev/Press-Drawings/Press Solidworks Files/solidoodle_button_pcb.SLDPRT

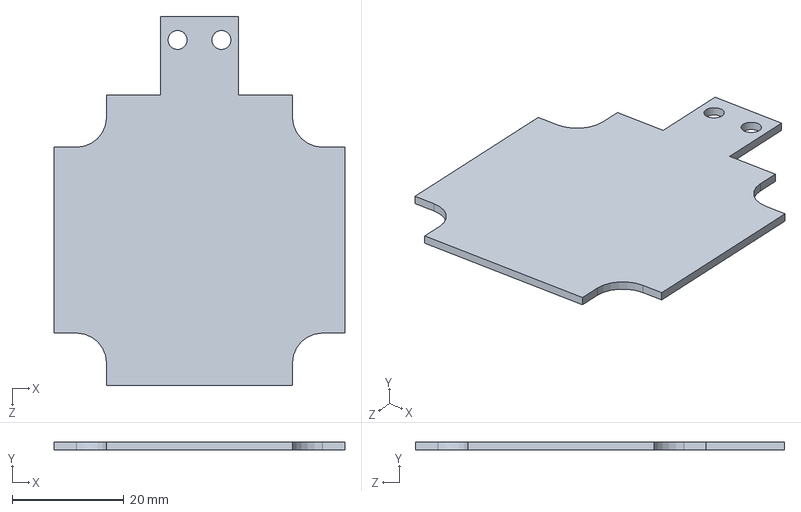
[picture p126: CAD file, 2017-12-07]
Press Solidworks Files/solidoodle_button_pcb.SLDPRT
52.0 x 1.40 x 66.0 mm
