SolidoodleDev/Press-Drawings/Press Solidworks Files/Button_Comold_Assy.SLDASM

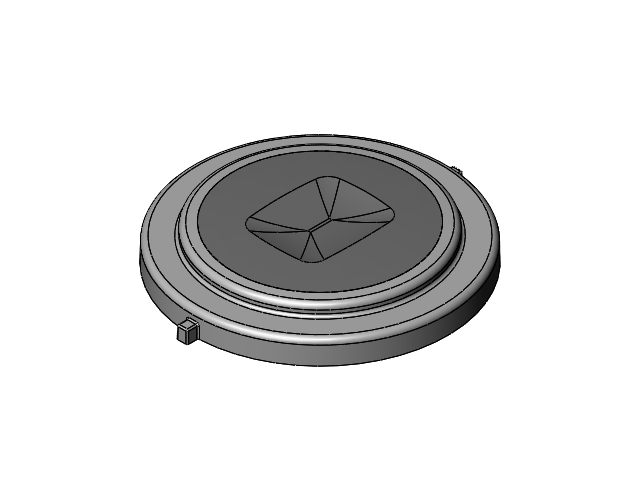
[picture p127: CAD file, 2017-12-07]
Press Solidworks Files/Button_Comold_Assy.SLDASM
1844_026_rev_04
1844_009_rev_04
