SolidoodleDev/Press-Drawings/(list of files, cad)

Other CAD files:
Press Solidworks Files/1844_022_rev_04.SLDPRT
Press Part Drawings/Drawing Step Files (STEP)/1844_026_rev_03.STEP
Press Solidworks Files/1844_036_rev_04.SLDPRT
Press Part Drawings/Drawing Step Files (STEP)/1844_006_rev_05.STEP
Press Solidworks Files/1844_020_rev_03.SLDPRT
Press Solidworks Files/1844_028_rev_05.SLDPRT
Press Solidworks Files/1844_062_rev_05.SLDPRT
Press Solidworks Files/1844_030_rev_04.SLDPRT
Press Solidworks Files/D2F_01F_D_ACTUATOR.SLDPRT
Press Solidworks Files/1844_021_rev_03.SLDPRT
Press Solidworks Files/1844_069_rev_02.SLDPRT
Press Solidworks Files/torsion_spring_extruder.SLDPRT
Press Solidworks Files/1844_012_rev_04.SLDPRT
Press Solidworks Files/1844_034_rev_04.SLDPRT
Press Solidworks Files/1844_040_rev_04.SLDPRT
Press Solidworks Files/1844_042_rev_04.SLDPRT
Press Solidworks Files/raspberry_pi__Xtal_Smd_25.SLDPRT
Press Solidworks Files/1844_025_rev_03.SLDPRT
Press Solidworks Files/1844_027_rev_04.SLDPRT
Press Solidworks Files/Lead Screw Nut.SLDPRT
Press Solidworks Files/m2.5x14_socket_cap_screw.sldprt
Press Solidworks Files/m2.9x16_sheet_metal_screw.SLDPRT
Press Solidworks Files/m2x12_flat_socket_screw.SLDPRT
Press Solidworks Files/m2x6_plastite.SLDPRT
Press Solidworks Files/m3x10_flathead_plastite.SLDPRT
Press Solidworks Files/m3x10_plastite.SLDPRT
Press Solidworks Files/m3x12_flathead_plastite.SLDPRT
Press Solidworks Files/m3x14_plastite.SLDPRT
Press Solidworks Files/m3x3_set_screw_cup.SLDPRT
Press Solidworks Files/m3x4_set_screw_flat.SLDPRT
Press Solidworks Files/m3x6_plastite.SLDPRT
Press Solidworks Files/m3x6_set_screw_cone.SLDPRT
Press Solidworks Files/m3x6_set_screw_cup.SLDPRT
Press Solidworks Files/m3x8_plastite.SLDPRT
Press Solidworks Files/m4x10_socket_cap_screw.SLDPRT
Press Solidworks Files/m4x16_flat_socket_screw.SLDPRT
