SolidoodleDev/Press-Drawings/Press Assembly Drawings/Solidoodle_Carriage_Print_Car_Assy.pdf

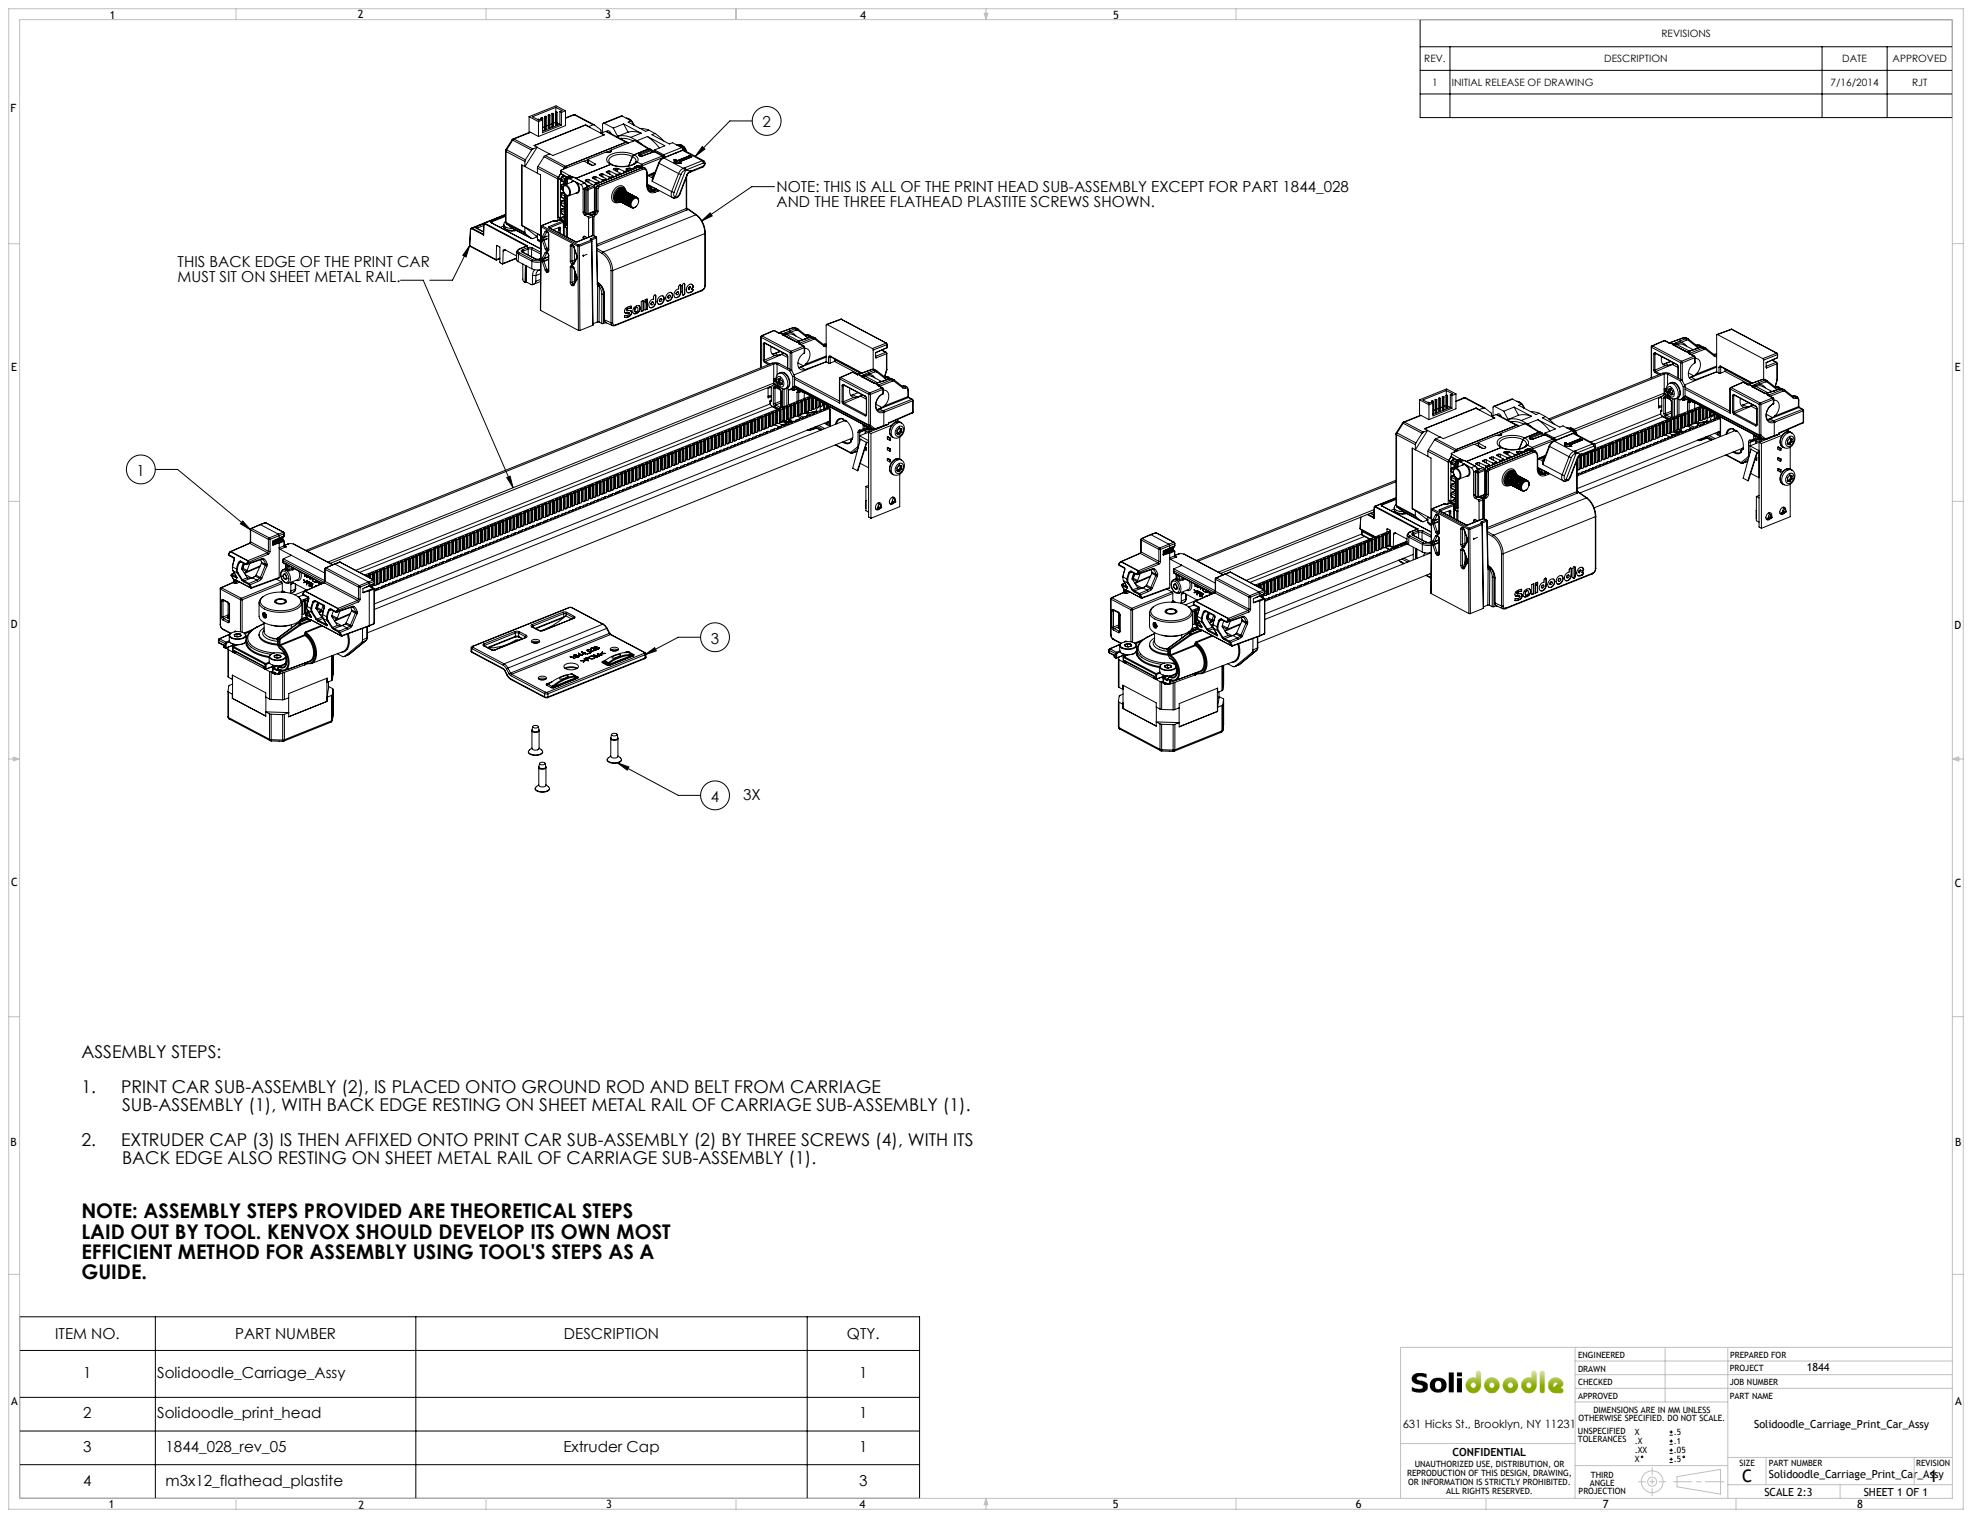
[picture p147: page 1]
ALL RIGHTS RESERVED.; SCALE 2:3; SHEET 1 OF 1; PREPARED FOR; JOB NUMBER; PART NUMBER; PART NAME; 631 Hicks St., Brooklyn, NY 11231; Solidoodle_Carriage_Print_Car_Assy

REV. | DESCRIPTION | DATE | APPROVED
1 | INITIAL RELEASE OF DRAWING | 7/16/2014 | RJT

NOTE: THIS IS ALL OF THE PRINT HEAD SUB-ASSEMBLY EXCEPT FOR PART 1844_028
AND THE THREE FLATHEAD PLASTITE SCREWS SHOWN.

THIS BACK EDGE OF THE PRINT CAR
MUST SIT ON SHEET METAL RAIL.

ASSEMBLY STEPS:
1. PRINT CAR SUB-ASSEMBLY (2), IS PLACED ONTO GROUND ROD AND BELT FROM CARRIAGE
SUB-ASSEMBLY (1), WITH BACK EDGE RESTING ON SHEET METAL RAIL OF CARRIAGE SUB-ASSEMBLY (1).
2. EXTRUDER CAP (3) IS THEN AFFIXED ONTO PRINT CAR SUB-ASSEMBLY (2) BY THREE SCREWS (4), WITH ITS
BACK EDGE ALSO RESTING ON SHEET METAL RAIL OF CARRIAGE SUB-ASSEMBLY (1).
NOTE: ASSEMBLY STEPS PROVIDED ARE THEORETICAL STEPS
LAID OUT BY TOOL. KENVOX SHOULD DEVELOP ITS OWN MOST
EFFICIENT METHOD FOR ASSEMBLY USING TOOL'S STEPS AS A
GUIDE.

ITEM NO. | PART NUMBER | DESCRIPTION | QTY.
1 | Solidoodle_Carriage_Assy | | 1

ENGINEERED
DRAWN
CHECKED
APPROVED
DIMENSIONS ARE IN MM UNLESS
OTHERWISE SPECIFIED. DO NOT SCALE.
UNSPECIFIED
TOLERANCES

2 | Solidoodle_print_head | | 1
3 | 1844_028_rev_05 | Extruder Cap | 1
4 | m3x12_flathead_plastite | | 3

UNAUTHORIZED USE, DISTRIBUTION, OR
REPRODUCTION OF THIS DESIGN, DRAWING,
OR INFORMATION IS STRICTLY PROHIBITED.
