SolidoodleDev/Press-Drawings/Press Assembly Drawings/Solidoodle_Front_Door_Assy.pdf

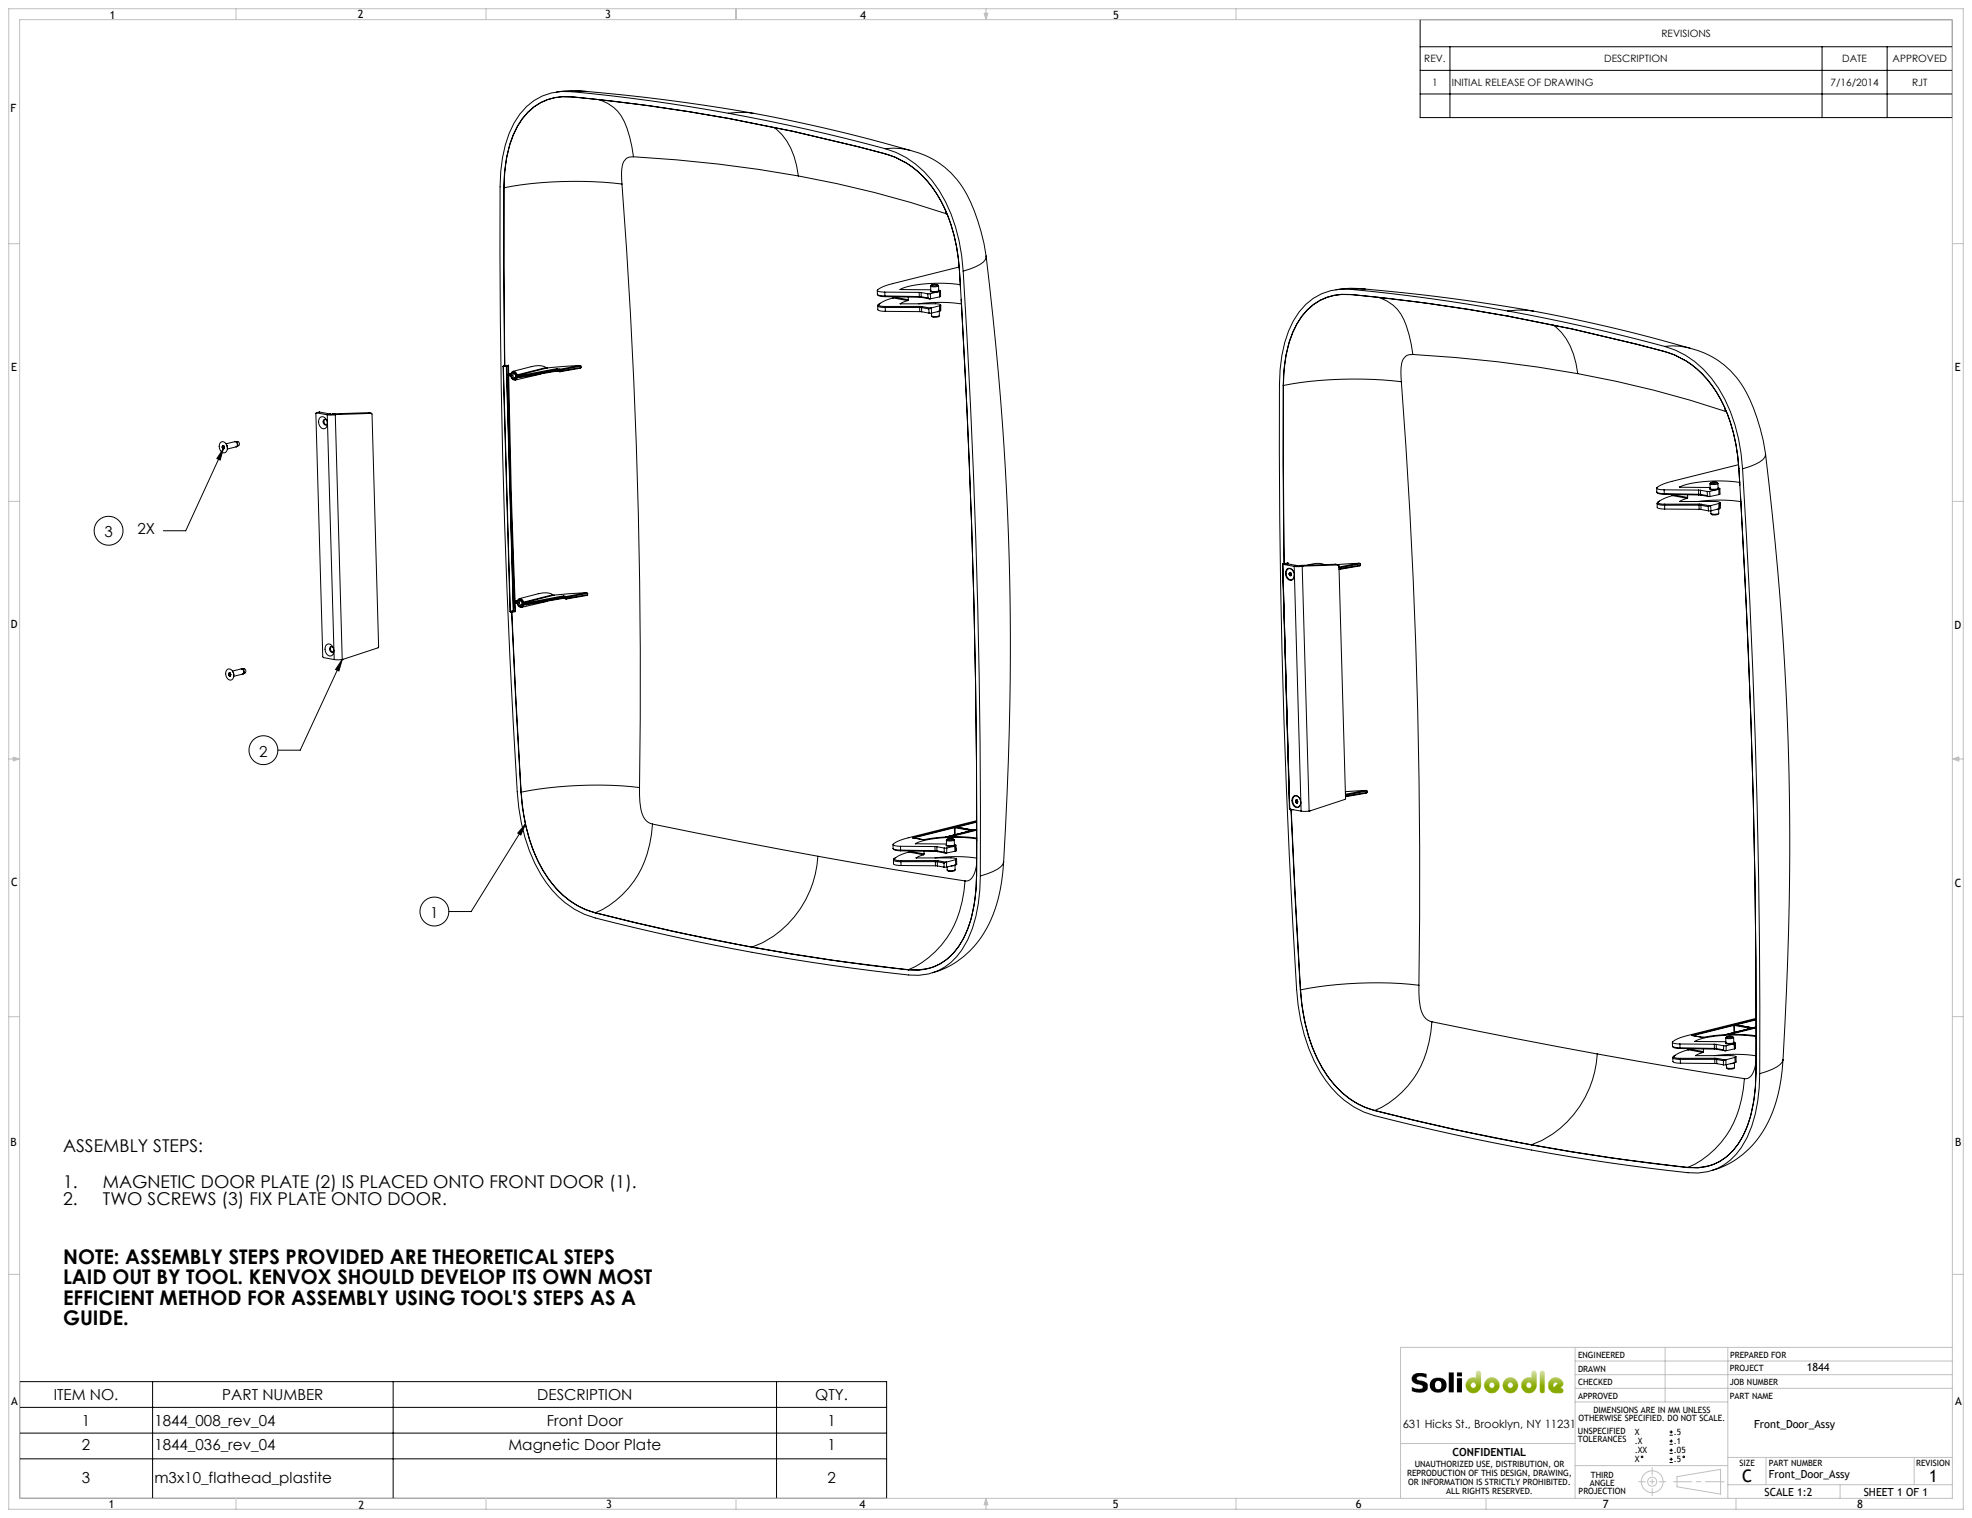
[picture p148: page 1]
ALL RIGHTS RESERVED.; SCALE 1:2; SHEET 1 OF 1; PREPARED FOR; JOB NUMBER; PART NUMBER; PART NAME; 631 Hicks St., Brooklyn, NY 11231; Front_Door_Assy

REV. | DESCRIPTION | DATE | APPROVED
1 | INITIAL RELEASE OF DRAWING | 7/16/2014 | RJT

ASSEMBLY STEPS:
1. MAGNETIC DOOR PLATE (2) IS PLACED ONTO FRONT DOOR (1).
2. TWO SCREWS (3) FIX PLATE ONTO DOOR.
NOTE: ASSEMBLY STEPS PROVIDED ARE THEORETICAL STEPS
LAID OUT BY TOOL. KENVOX SHOULD DEVELOP ITS OWN MOST
EFFICIENT METHOD FOR ASSEMBLY USING TOOL'S STEPS AS A
GUIDE.

ENGINEERED
DRAWN
CHECKED
APPROVED
DIMENSIONS ARE IN MM UNLESS
OTHERWISE SPECIFIED. DO NOT SCALE.
UNSPECIFIED
TOLERANCES

ITEM NO. | PART NUMBER | DESCRIPTION | QTY.
1 | 1844_008_rev_04 | Front Door | 1
2 | 1844_036_rev_04 | Magnetic Door Plate | 1
3 | m3x10_flathead_plastite | | 2

UNAUTHORIZED USE, DISTRIBUTION, OR
REPRODUCTION OF THIS DESIGN, DRAWING,
OR INFORMATION IS STRICTLY PROHIBITED.
