SolidoodleDev/Press-Drawings/Press Assembly Drawings/Solidoodle_Outer_Lid_Assy.pdf

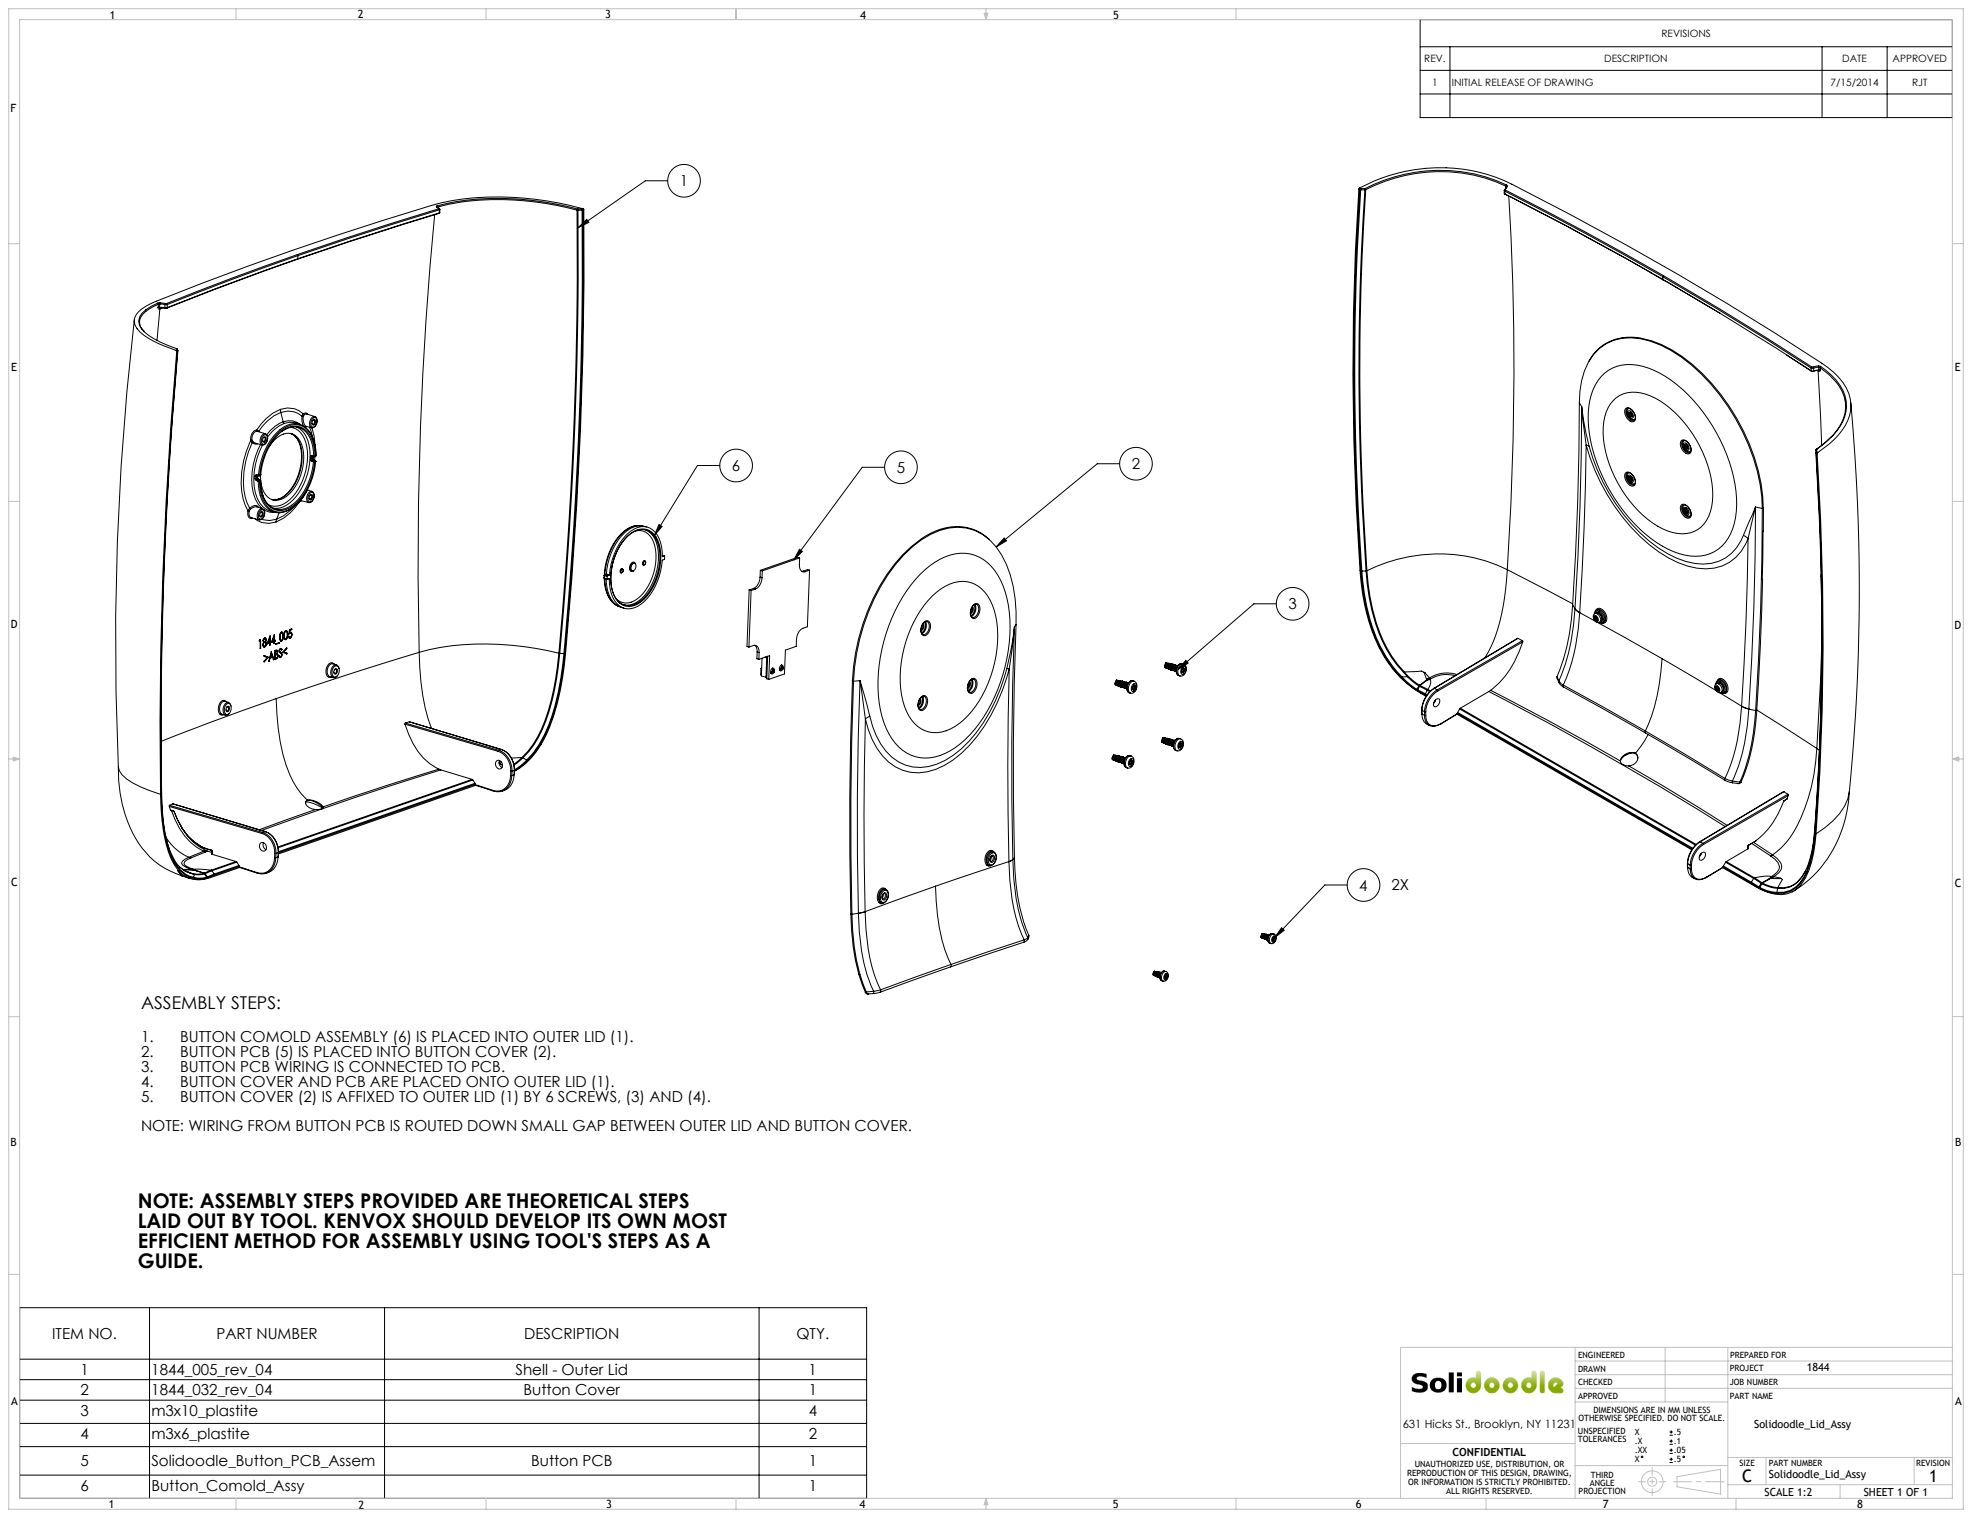
[picture p149: page 1]
ALL RIGHTS RESERVED.; SCALE 1:2; SHEET 1 OF 1; PREPARED FOR; JOB NUMBER; PART NUMBER; PART NAME; 631 Hicks St., Brooklyn, NY 11231; Solidoodle_Lid_Assy

REV. | DESCRIPTION | DATE | APPROVED
1 | INITIAL RELEASE OF DRAWING | 7/15/2014 | RJT

ASSEMBLY STEPS:
1. BUTTON COMOLD ASSEMBLY (6) IS PLACED INTO OUTER LID (1).
2. BUTTON PCB (5) IS PLACED INTO BUTTON COVER (2).
3. BUTTON PCB WIRING IS CONNECTED TO PCB.
4. BUTTON COVER AND PCB ARE PLACED ONTO OUTER LID (1).
5. BUTTON COVER (2) IS AFFIXED TO OUTER LID (1) BY 6 SCREWS, (3) AND (4).
NOTE: WIRING FROM BUTTON PCB IS ROUTED DOWN SMALL GAP BETWEEN OUTER LID AND BUTTON COVER.

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

ITEM NO. | PART NUMBER | DESCRIPTION | QTY.
1 | 1844_005_rev_04 | Shell - Outer Lid | 1
2 | 1844_032_rev_04 | Button Cover | 1
3 | m3x10_plastite | | 4
4 | m3x6_plastite | | 2
5 | Solidoodle_Button_PCB_Assem | Button PCB | 1
6 | Button_Comold_Assy | | 1

ENGINEERED
DRAWN
CHECKED
APPROVED
DIMENSIONS ARE IN MM UNLESS
OTHERWISE SPECIFIED. DO NOT SCALE.
UNSPECIFIED
TOLERANCES

UNAUTHORIZED USE, DISTRIBUTION, OR
REPRODUCTION OF THIS DESIGN, DRAWING,
OR INFORMATION IS STRICTLY PROHIBITED.
