SolidoodleDev/Press-Drawings/Press Assembly Drawings/Solidoodle_PCB_Door_Assy.pdf

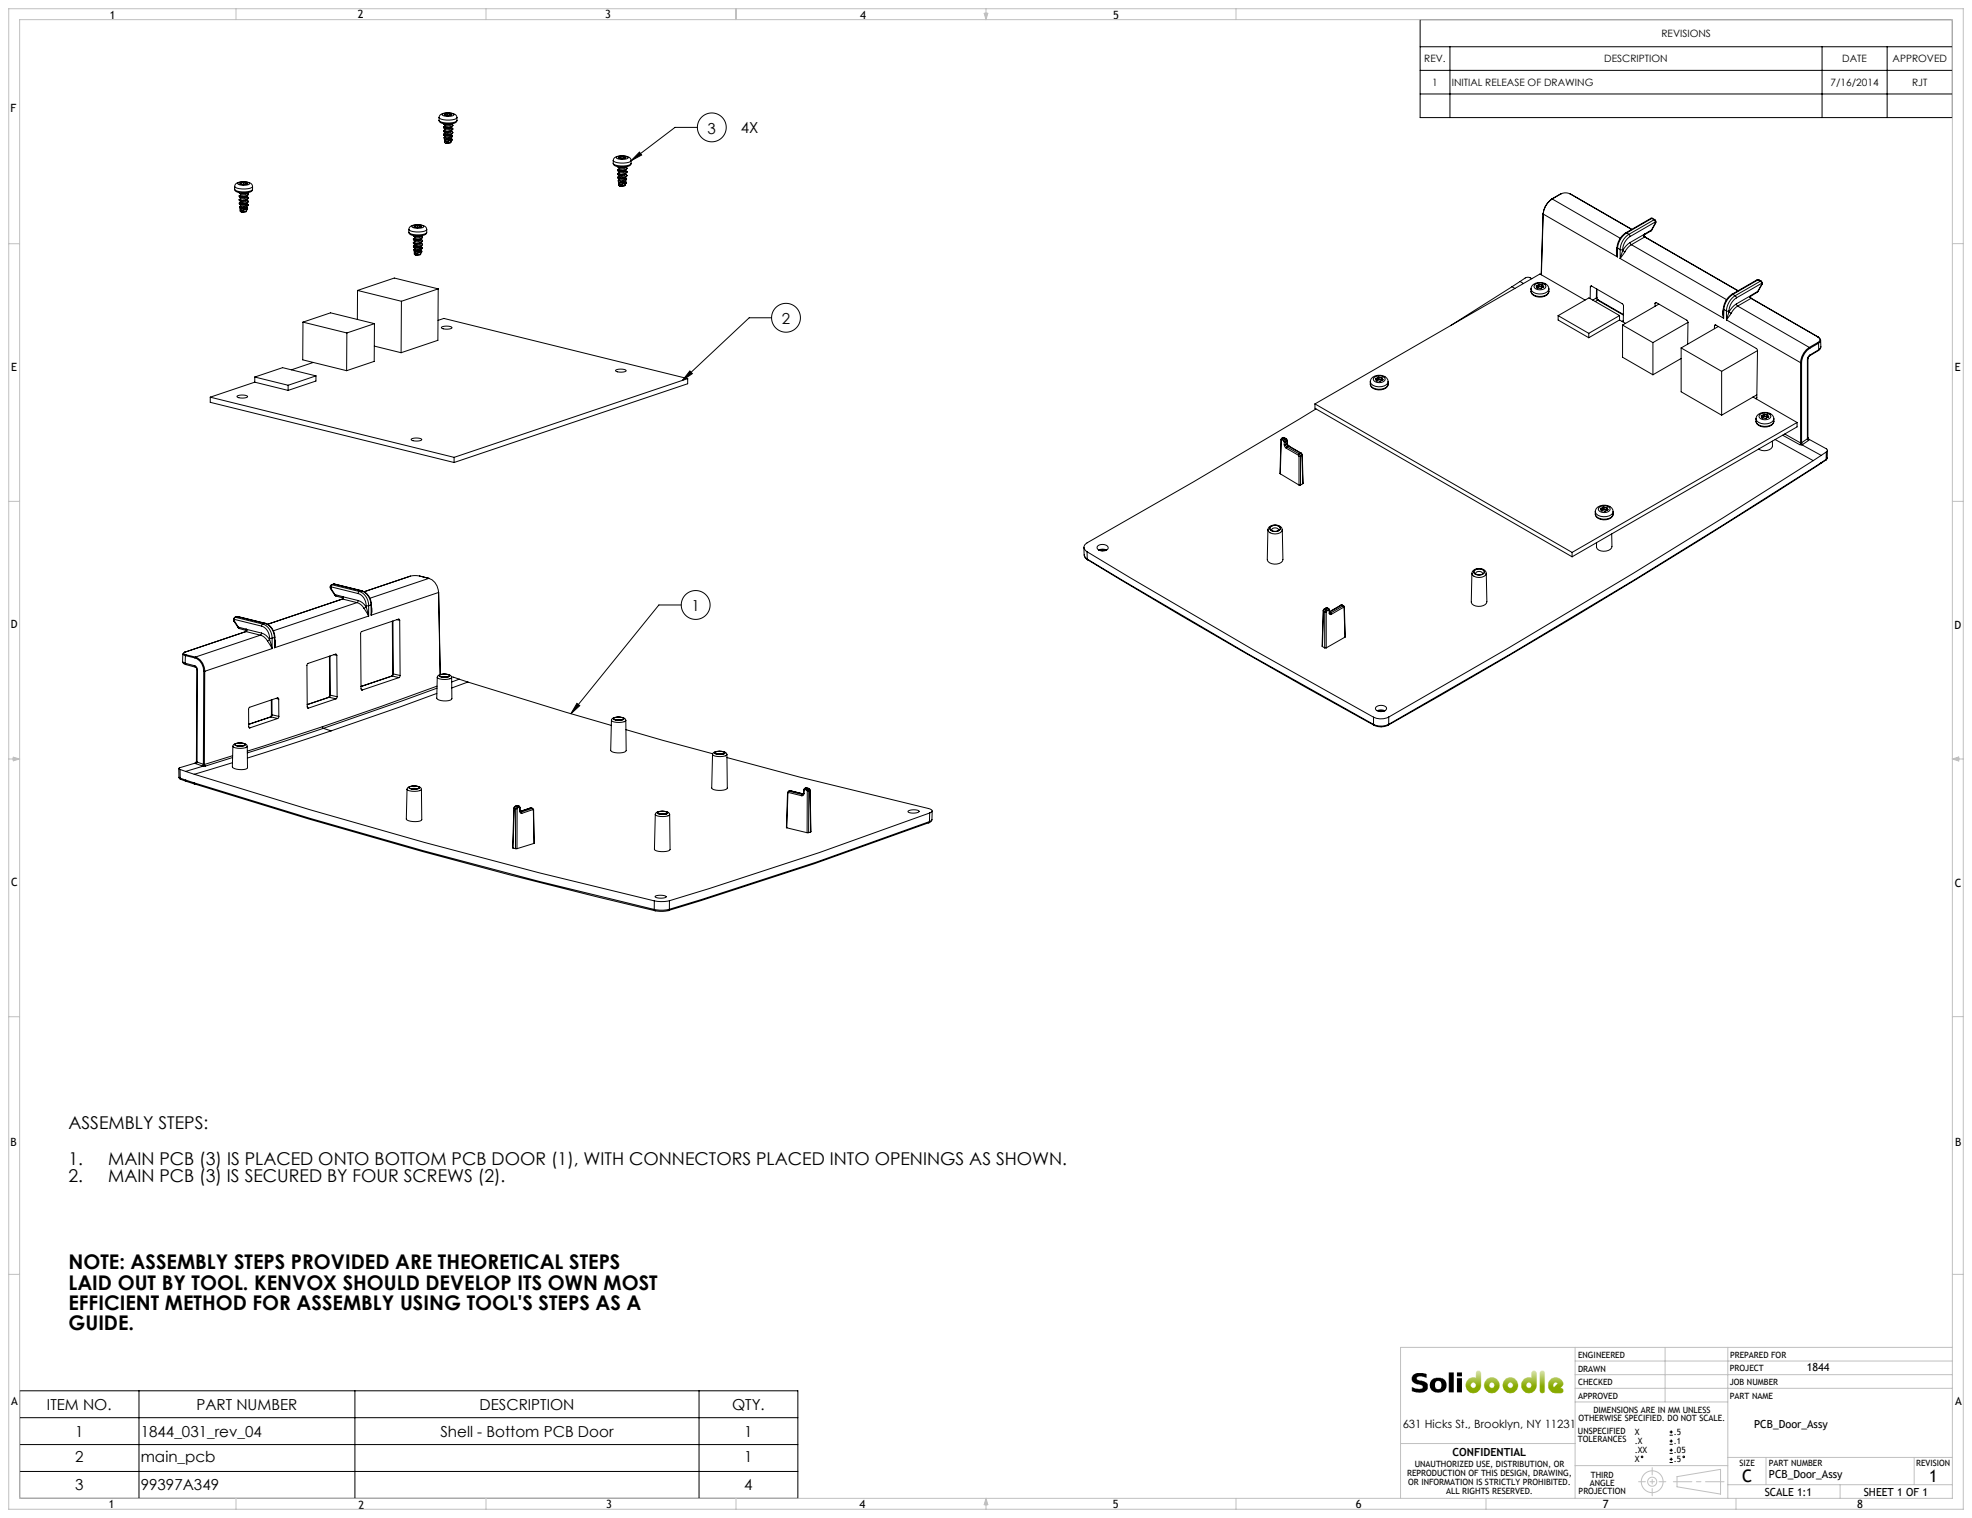
[picture p150: page 1]
ALL RIGHTS RESERVED.; SCALE 1:1; SHEET 1 OF 1; PREPARED FOR; JOB NUMBER; PART NUMBER; PART NAME; 631 Hicks St., Brooklyn, NY 11231; PCB_Door_Assy

REV. | DESCRIPTION | DATE | APPROVED
1 | INITIAL RELEASE OF DRAWING | 7/16/2014 | RJT

ASSEMBLY STEPS:
1. MAIN PCB (3) IS PLACED ONTO BOTTOM PCB DOOR (1), WITH CONNECTORS PLACED INTO OPENINGS AS SHOWN.
2. MAIN PCB (3) IS SECURED BY FOUR SCREWS (2).

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

ENGINEERED
DRAWN
CHECKED
APPROVED
DIMENSIONS ARE IN MM UNLESS
OTHERWISE SPECIFIED. DO NOT SCALE.
UNSPECIFIED
TOLERANCES

ITEM NO. | PART NUMBER | DESCRIPTION | QTY.
1 | 1844_031_rev_04 | Shell - Bottom PCB Door | 1
2 | main_pcb | | 1
3 | 99397A349 | | 4

UNAUTHORIZED USE, DISTRIBUTION, OR
REPRODUCTION OF THIS DESIGN, DRAWING,
OR INFORMATION IS STRICTLY PROHIBITED.
