SolidoodleDev/Press-Drawings/Press Assembly Drawings/Solidoodle_Spool_Assy.pdf

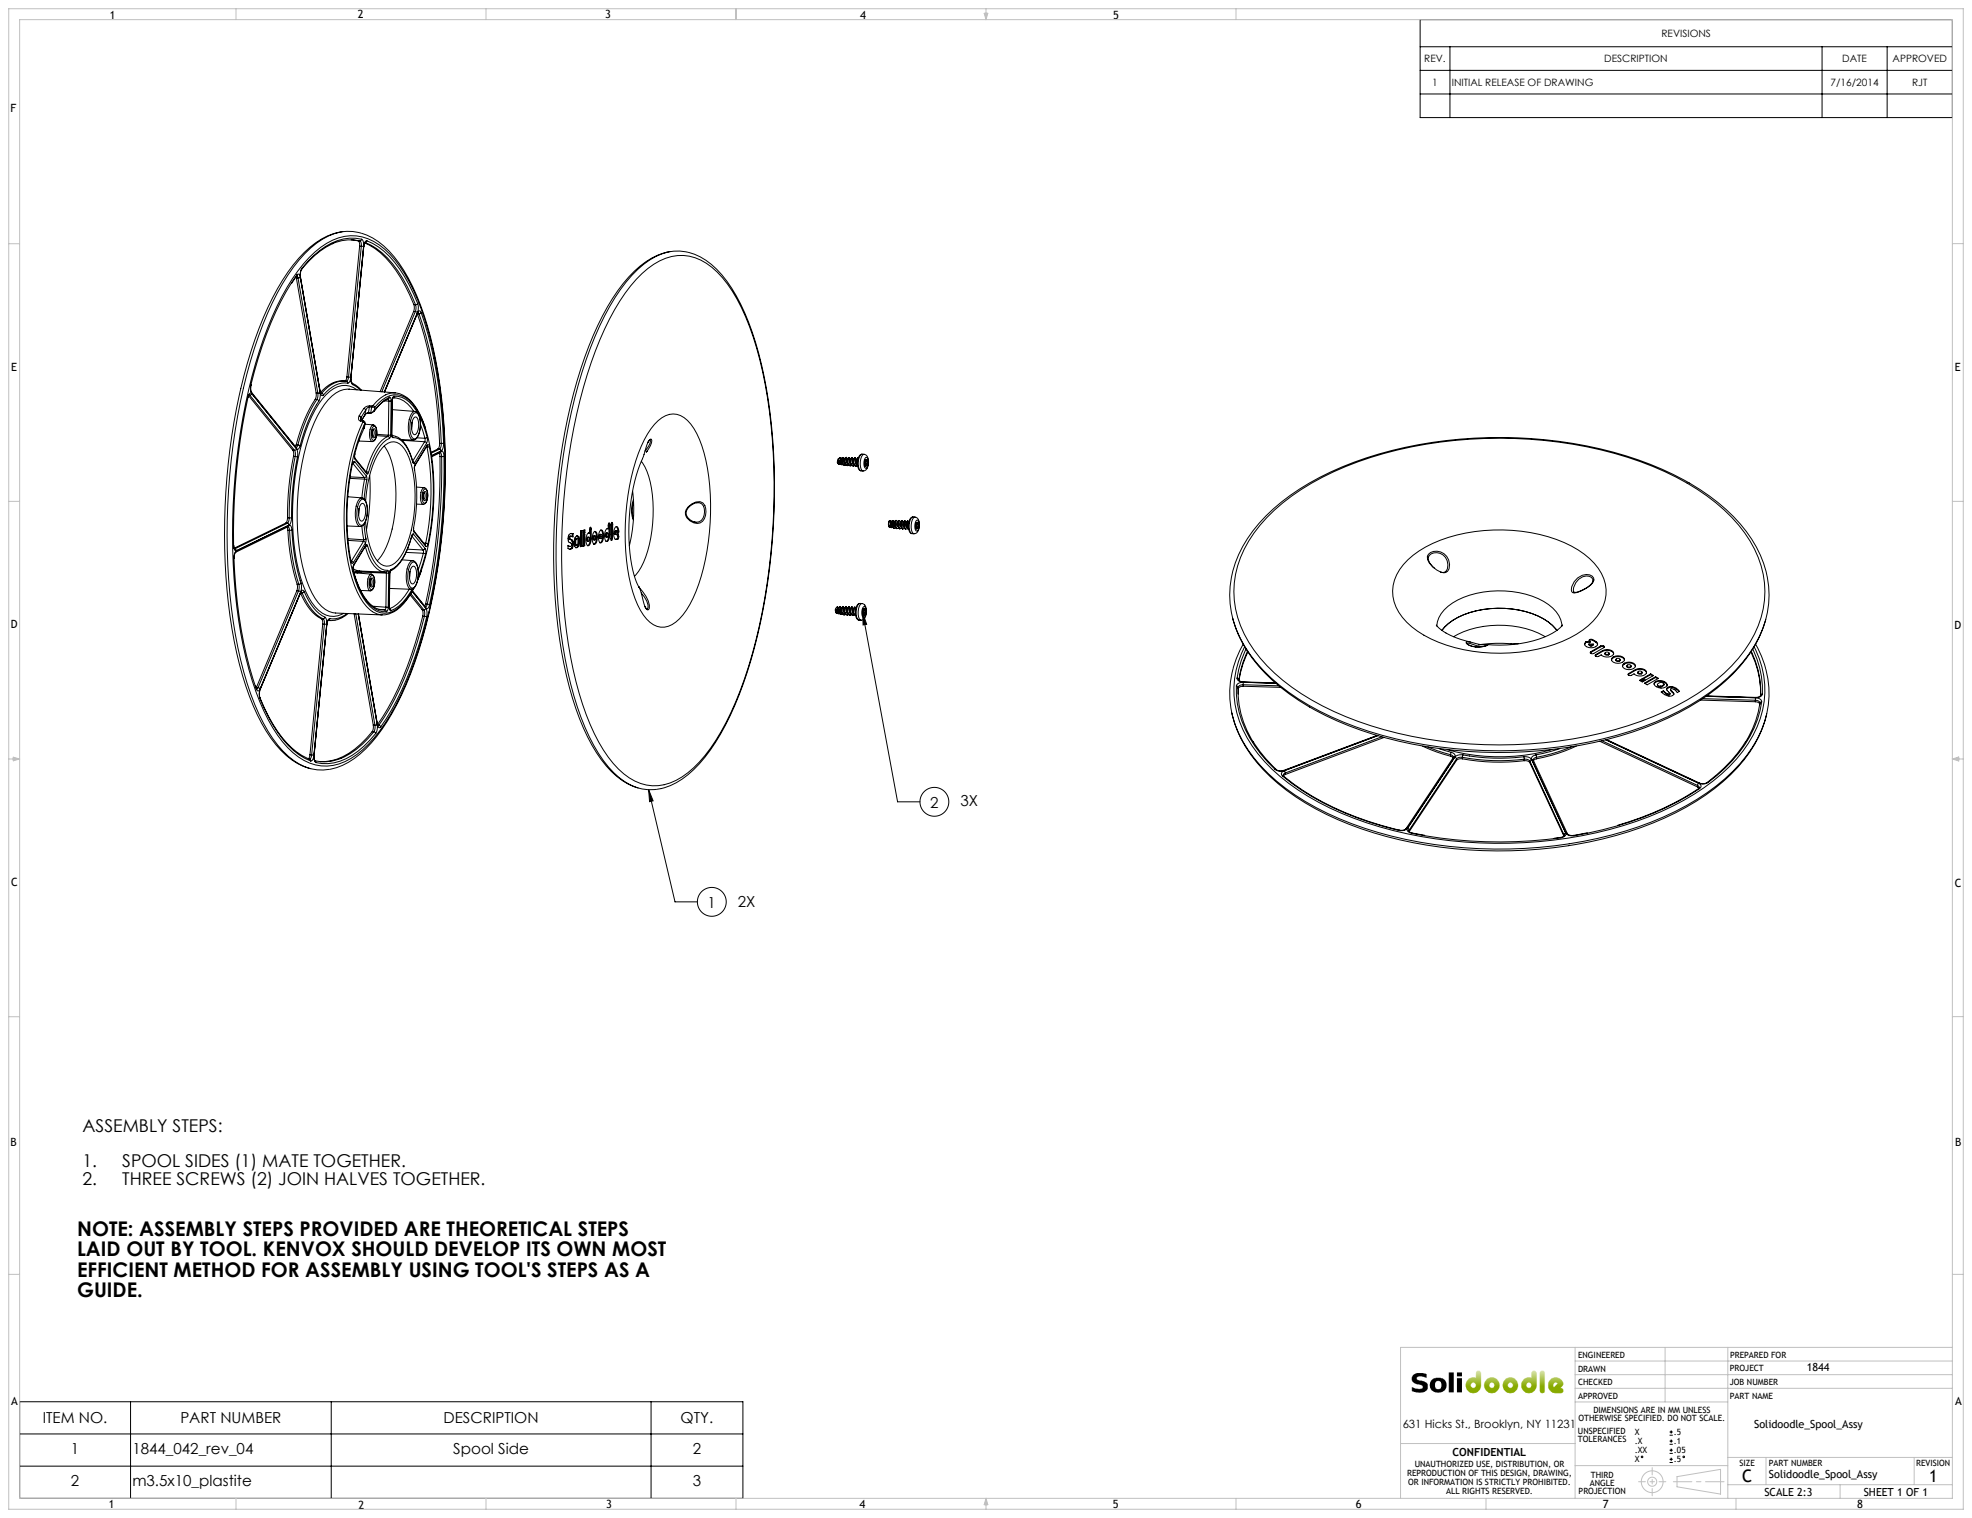
[picture p151: page 1]
ALL RIGHTS RESERVED.; SCALE 2:3; SHEET 1 OF 1; PREPARED FOR; JOB NUMBER; PART NUMBER; PART NAME; 631 Hicks St., Brooklyn, NY 11231; Solidoodle_Spool_Assy

REV. | DESCRIPTION | DATE | APPROVED
1 | INITIAL RELEASE OF DRAWING | 7/16/2014 | RJT

ASSEMBLY STEPS:
1. SPOOL SIDES (1) MATE TOGETHER.
2. THREE SCREWS (2) JOIN HALVES TOGETHER.
NOTE: ASSEMBLY STEPS PROVIDED ARE THEORETICAL STEPS
LAID OUT BY TOOL. KENVOX SHOULD DEVELOP ITS OWN MOST
EFFICIENT METHOD FOR ASSEMBLY USING TOOL'S STEPS AS A
GUIDE.

ENGINEERED
DRAWN
CHECKED
APPROVED
DIMENSIONS ARE IN MM UNLESS
OTHERWISE SPECIFIED. DO NOT SCALE.
UNSPECIFIED
TOLERANCES

ITEM NO. | PART NUMBER | DESCRIPTION | QTY.
1 | 1844_042_rev_04 | Spool Side | 2
2 | m3.5x10_plastite | | 3

UNAUTHORIZED USE, DISTRIBUTION, OR
REPRODUCTION OF THIS DESIGN, DRAWING,
OR INFORMATION IS STRICTLY PROHIBITED.
