SolidoodleDev/Press-Drawings/Press Part Drawings/Drawing Prints (PDF)/1844_001_rev_06.PDF

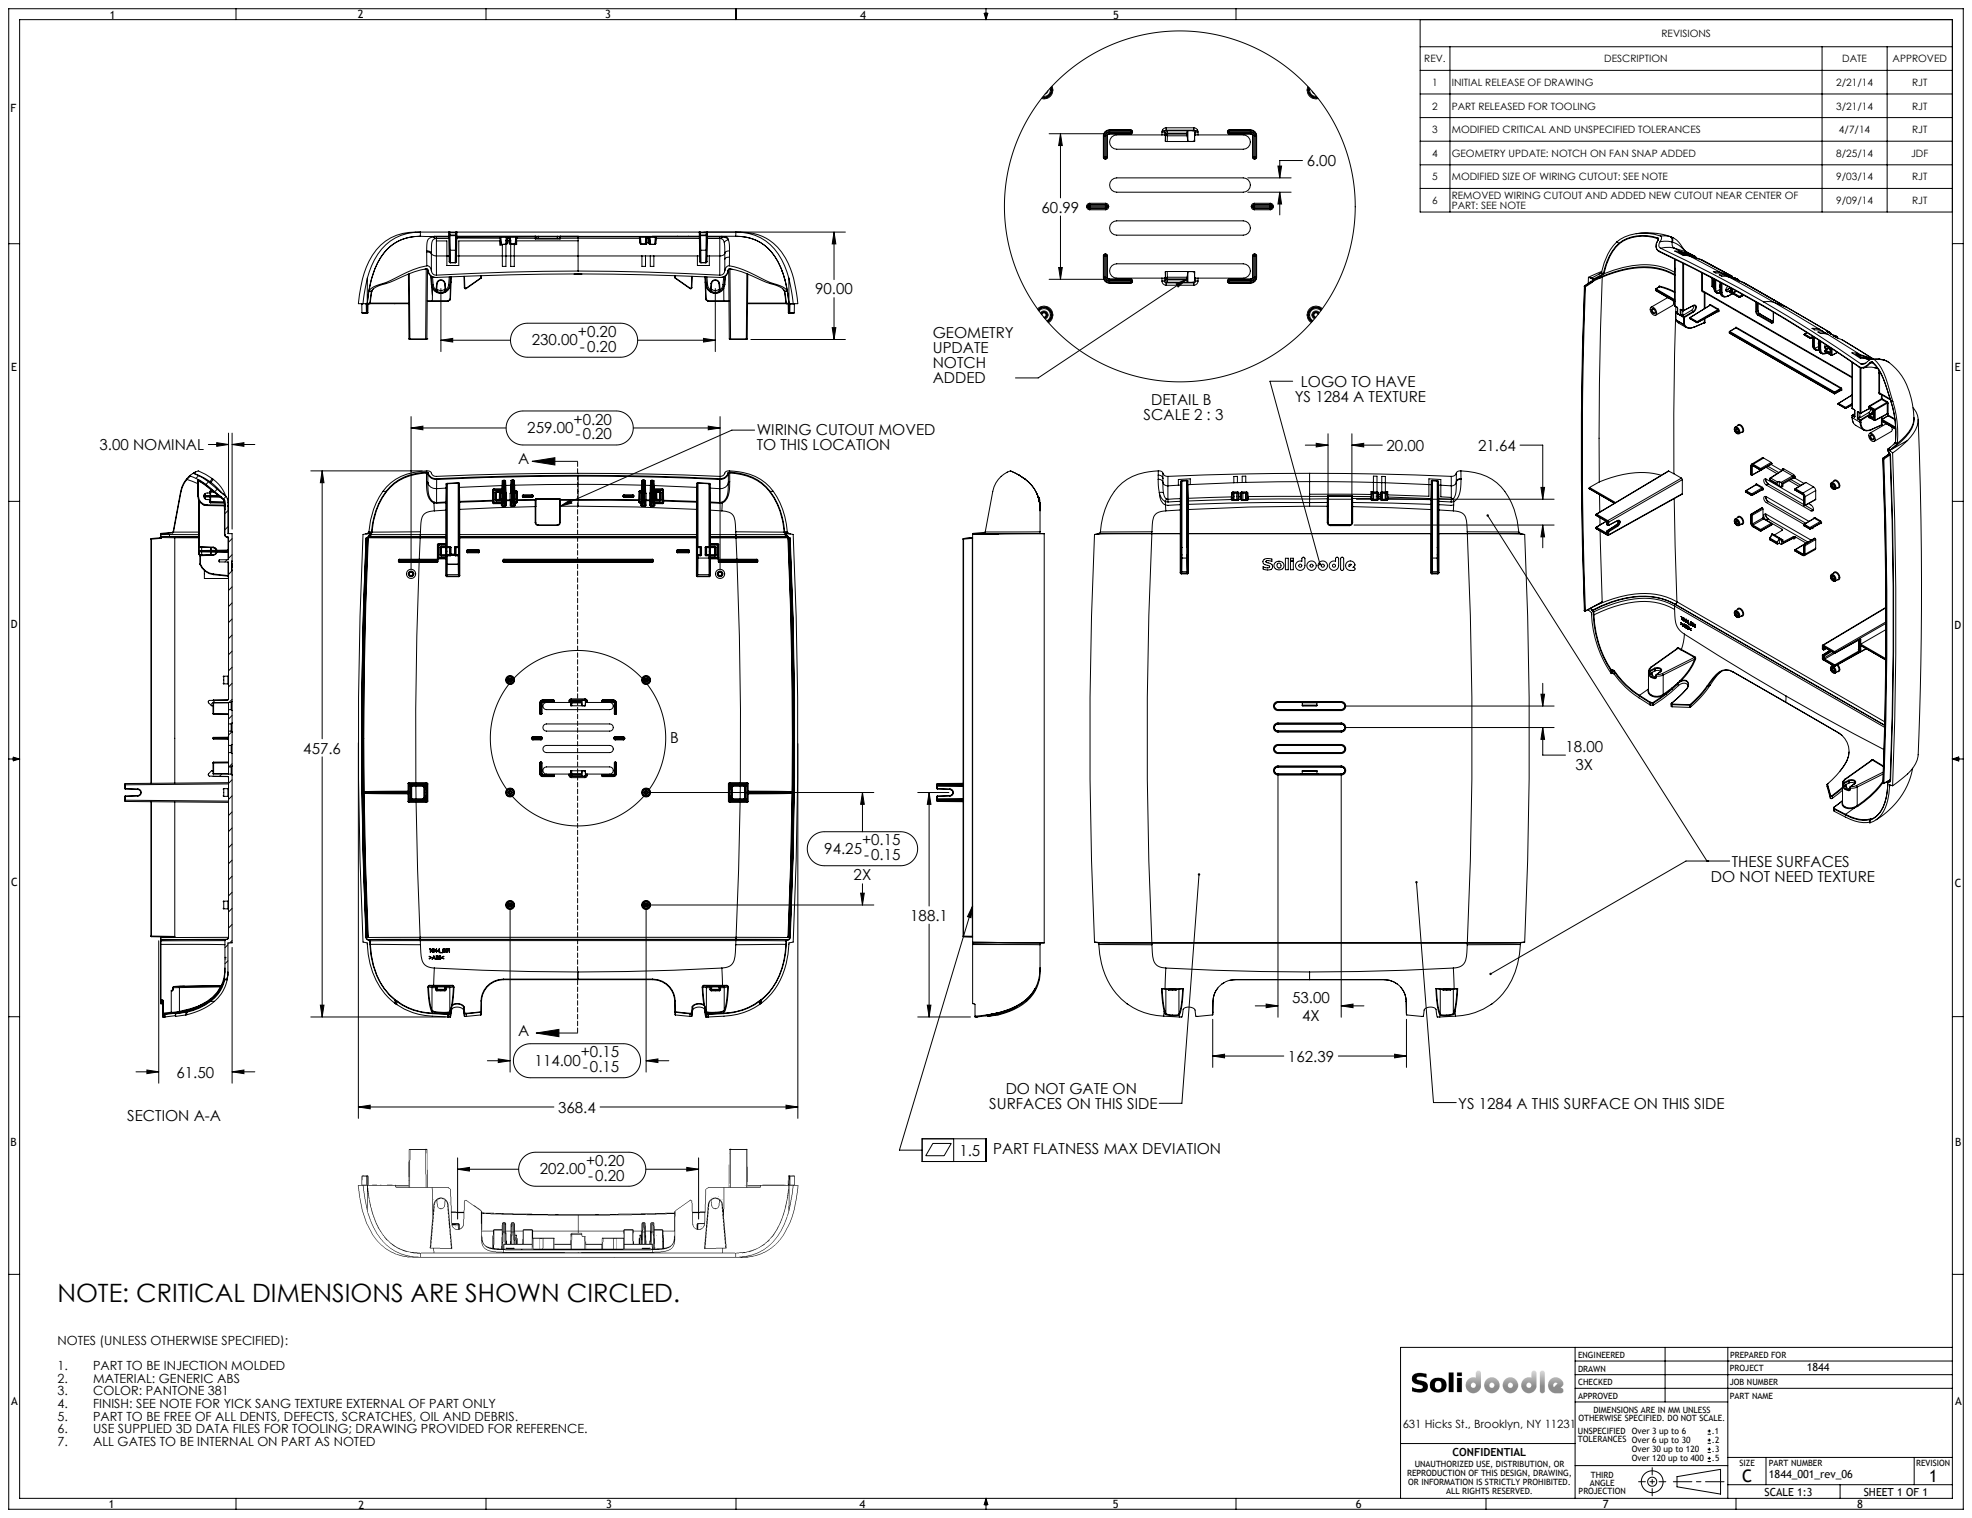
[picture p152: page 1]
PART FLATNESS MAX DEVIATION; SURFACES ON THIS SIDE; YS 1284 A THIS SURFACE ON THIS SIDE; 3.00 NOMINAL; SECTION A-A; DETAIL B SCALE 2 : 3; ALL RIGHTS RESERVED.; SCALE 1:3; SHEET 1 OF 1; PREPARED FOR; .5 CONFIDENTIAL; JOB NUMBER; PART NUMBER; PART NAME

REV. | DESCRIPTION | DATE | APPROVED
1 | INITIAL RELEASE OF DRAWING | 2/21/14 | RJT
2 | PART RELEASED FOR TOOLING | 3/21/14 | RJT
3 | MODIFIED CRITICAL AND UNSPECIFIED TOLERANCES | 4/7/14 | RJT
4 | GEOMETRY UPDATE: NOTCH ON FAN SNAP ADDED | 8/25/14 | JDF
5 | MODIFIED SIZE OF WIRING CUTOUT: SEE NOTE | 9/03/14 | RJT
6 | REMOVED WIRING CUTOUT AND ADDED NEW CUTOUT NEAR CENTER OF PART: SEE NOTE | 9/09/14 | RJT

LOGO TO HAVE
YS 1284 A TEXTURE

WIRING CUTOUT MOVED
TO THIS LOCATION

THESE SURFACES
DO NOT NEED TEXTURE

DO NOT GATE ON

NOTE: CRITICAL DIMENSIONS ARE SHOWN CIRCLED.

NOTES (UNLESS OTHERWISE SPECIFIED):
1. PART TO BE INJECTION MOLDED
2. MATERIAL: GENERIC ABS
3. COLOR: PANTONE 381
4. FINISH: SEE NOTE FOR YICK SANG TEXTURE EXTERNAL OF PART ONLY
5. PART TO BE FREE OF ALL DENTS, DEFECTS, SCRATCHES, OIL AND DEBRIS.
6. USE SUPPLIED 3D DATA FILES FOR TOOLING; DRAWING PROVIDED FOR REFERENCE.
7. ALL GATES TO BE INTERNAL ON PART AS NOTED

ENGINEERED
DRAWN
CHECKED
APPROVED
DIMENSIONS ARE IN MM UNLESS
OTHERWISE SPECIFIED. DO NOT SCALE.
UNSPECIFIED
TOLERANCES

631 Hicks St., Brooklyn, NY 11231

Over 3 up to 6
Over 6 up to 30
Over 30 up to 120
Over 120 up to 400

UNAUTHORIZED USE, DISTRIBUTION, OR
REPRODUCTION OF THIS DESIGN, DRAWING,
OR INFORMATION IS STRICTLY PROHIBITED.
