SolidoodleDev/Press-Drawings/Press Part Drawings/Drawing Prints (PDF)/1844_003_rev_04.PDF

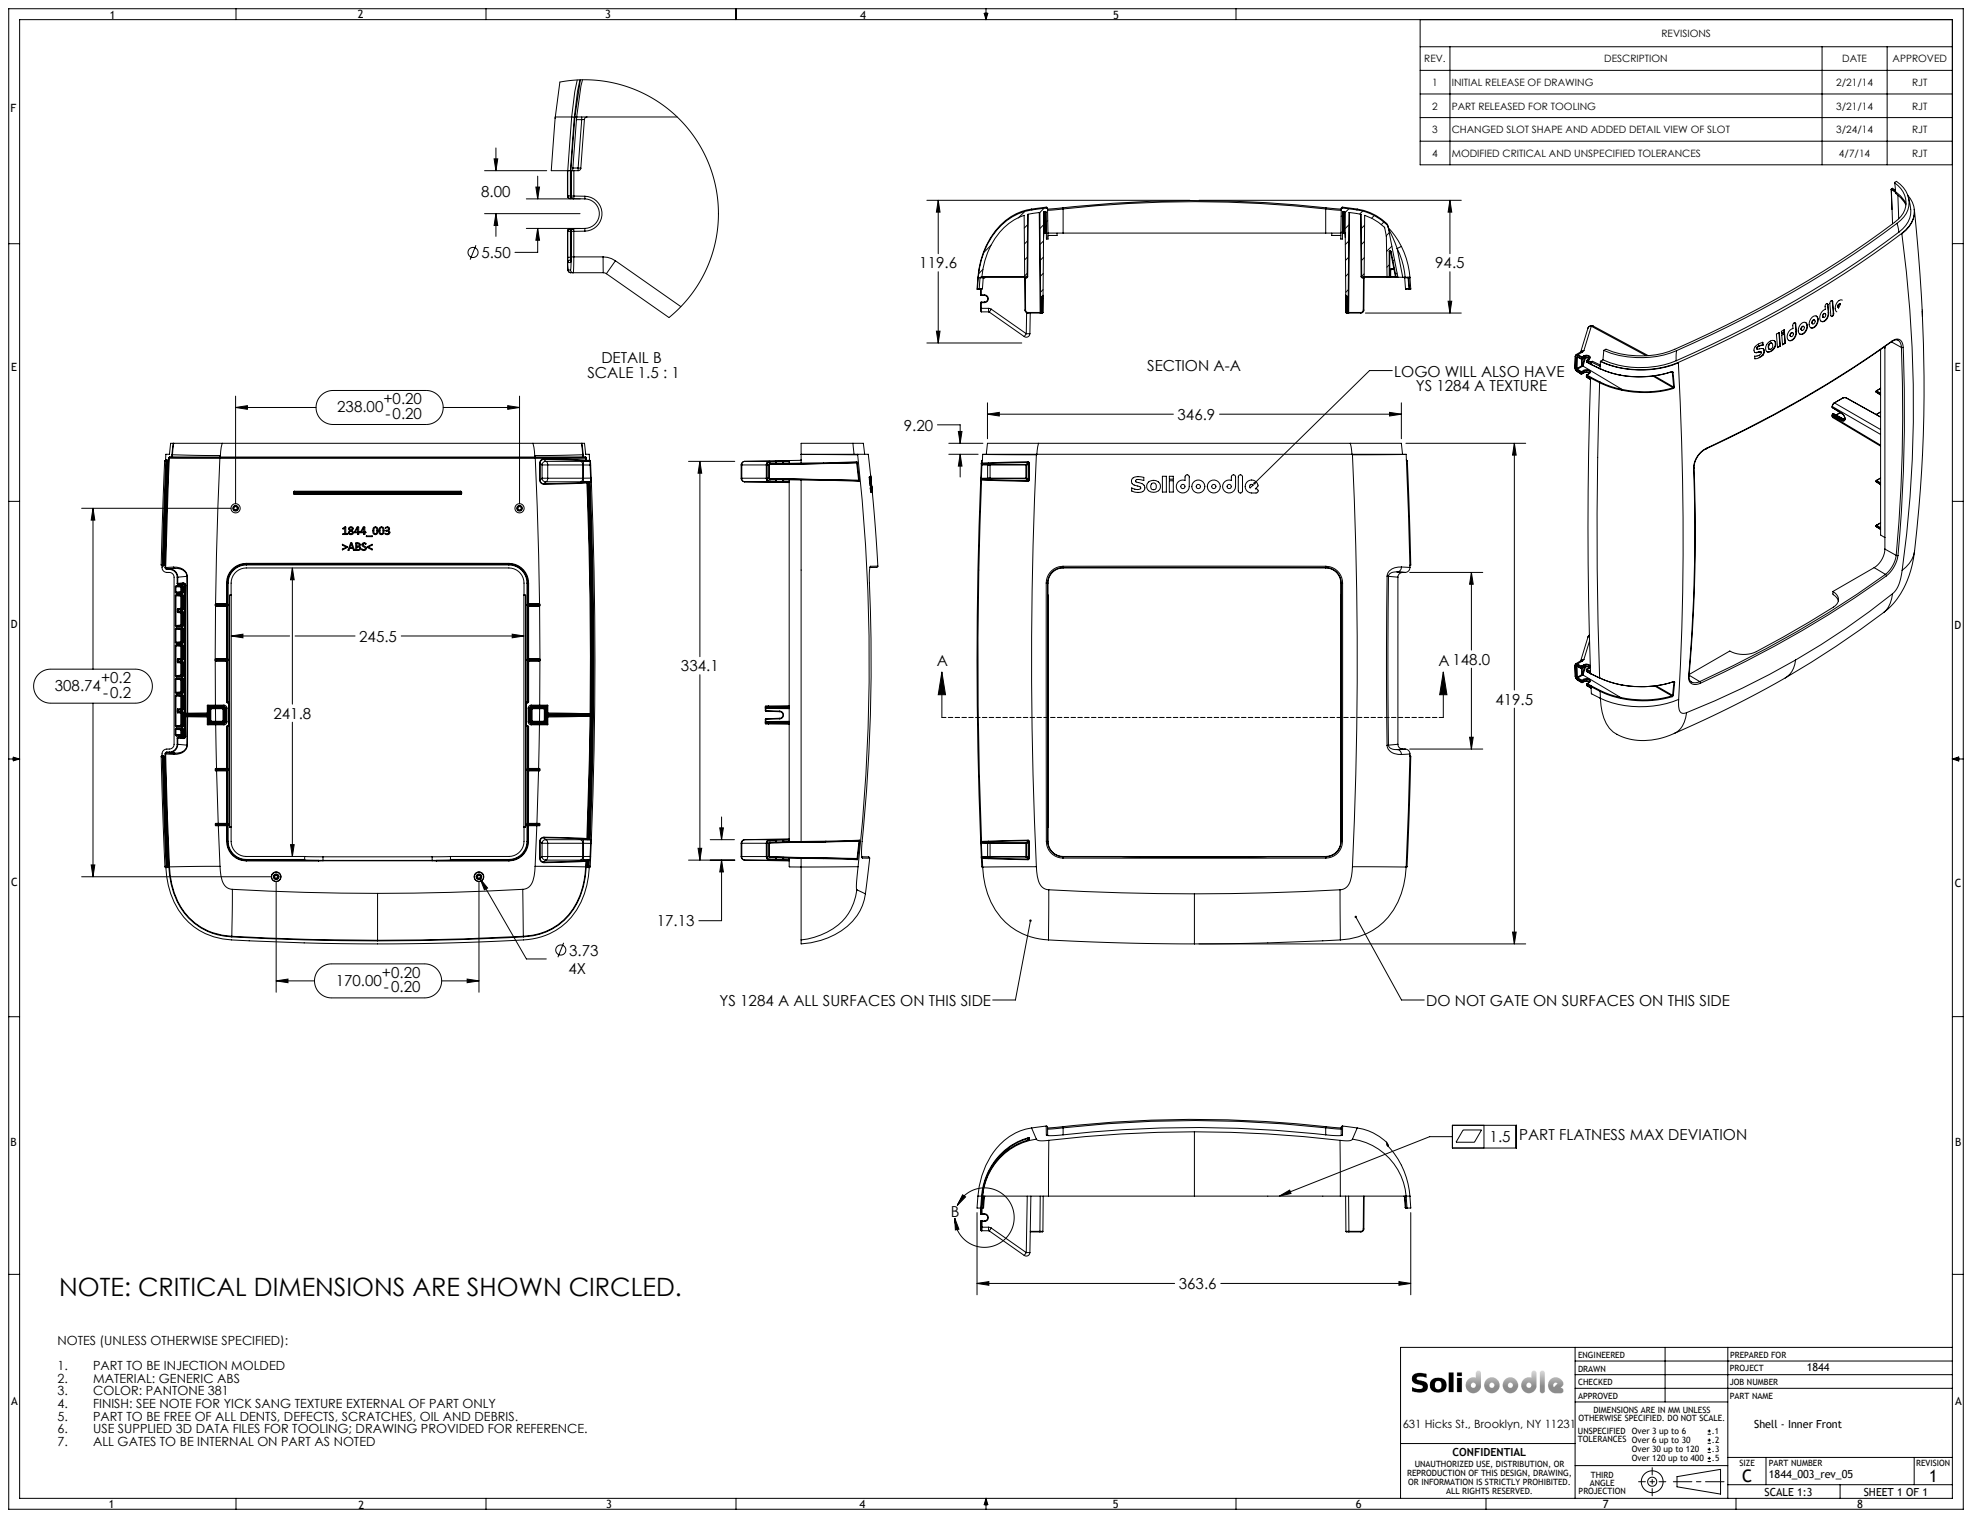
[picture p153: page 1]
YS 1284 A ALL SURFACES ON THIS SIDE; DO NOT GATE ON SURFACES ON THIS SIDE; PART FLATNESS MAX DEVIATION; SECTION A-A; DETAIL B SCALE 1.5 : 1; ALL RIGHTS RESERVED.; SCALE 1:3; SHEET 1 OF 1; PREPARED FOR; .5 CONFIDENTIAL; JOB NUMBER; PART NUMBER; PART NAME; 631 Hicks St., Brooklyn, NY 11231; Shell - Inner Front

REV. | DESCRIPTION | DATE | APPROVED
1 | INITIAL RELEASE OF DRAWING | 2/21/14 | RJT
2 | PART RELEASED FOR TOOLING | 3/21/14 | RJT
3 | CHANGED SLOT SHAPE AND ADDED DETAIL VIEW OF SLOT | 3/24/14 | RJT
4 | MODIFIED CRITICAL AND UNSPECIFIED TOLERANCES | 4/7/14 | RJT

LOGO WILL ALSO HAVE
YS 1284 A TEXTURE

NOTE: CRITICAL DIMENSIONS ARE SHOWN CIRCLED.

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

ENGINEERED
DRAWN
CHECKED
APPROVED
DIMENSIONS ARE IN MM UNLESS
OTHERWISE SPECIFIED. DO NOT SCALE.
UNSPECIFIED
TOLERANCES

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

UNAUTHORIZED USE, DISTRIBUTION, OR
REPRODUCTION OF THIS DESIGN, DRAWING,
OR INFORMATION IS STRICTLY PROHIBITED.
