SolidoodleDev/Press-Drawings/Press Part Drawings/Drawing Prints (PDF)/1844_008_rev_05.PDF

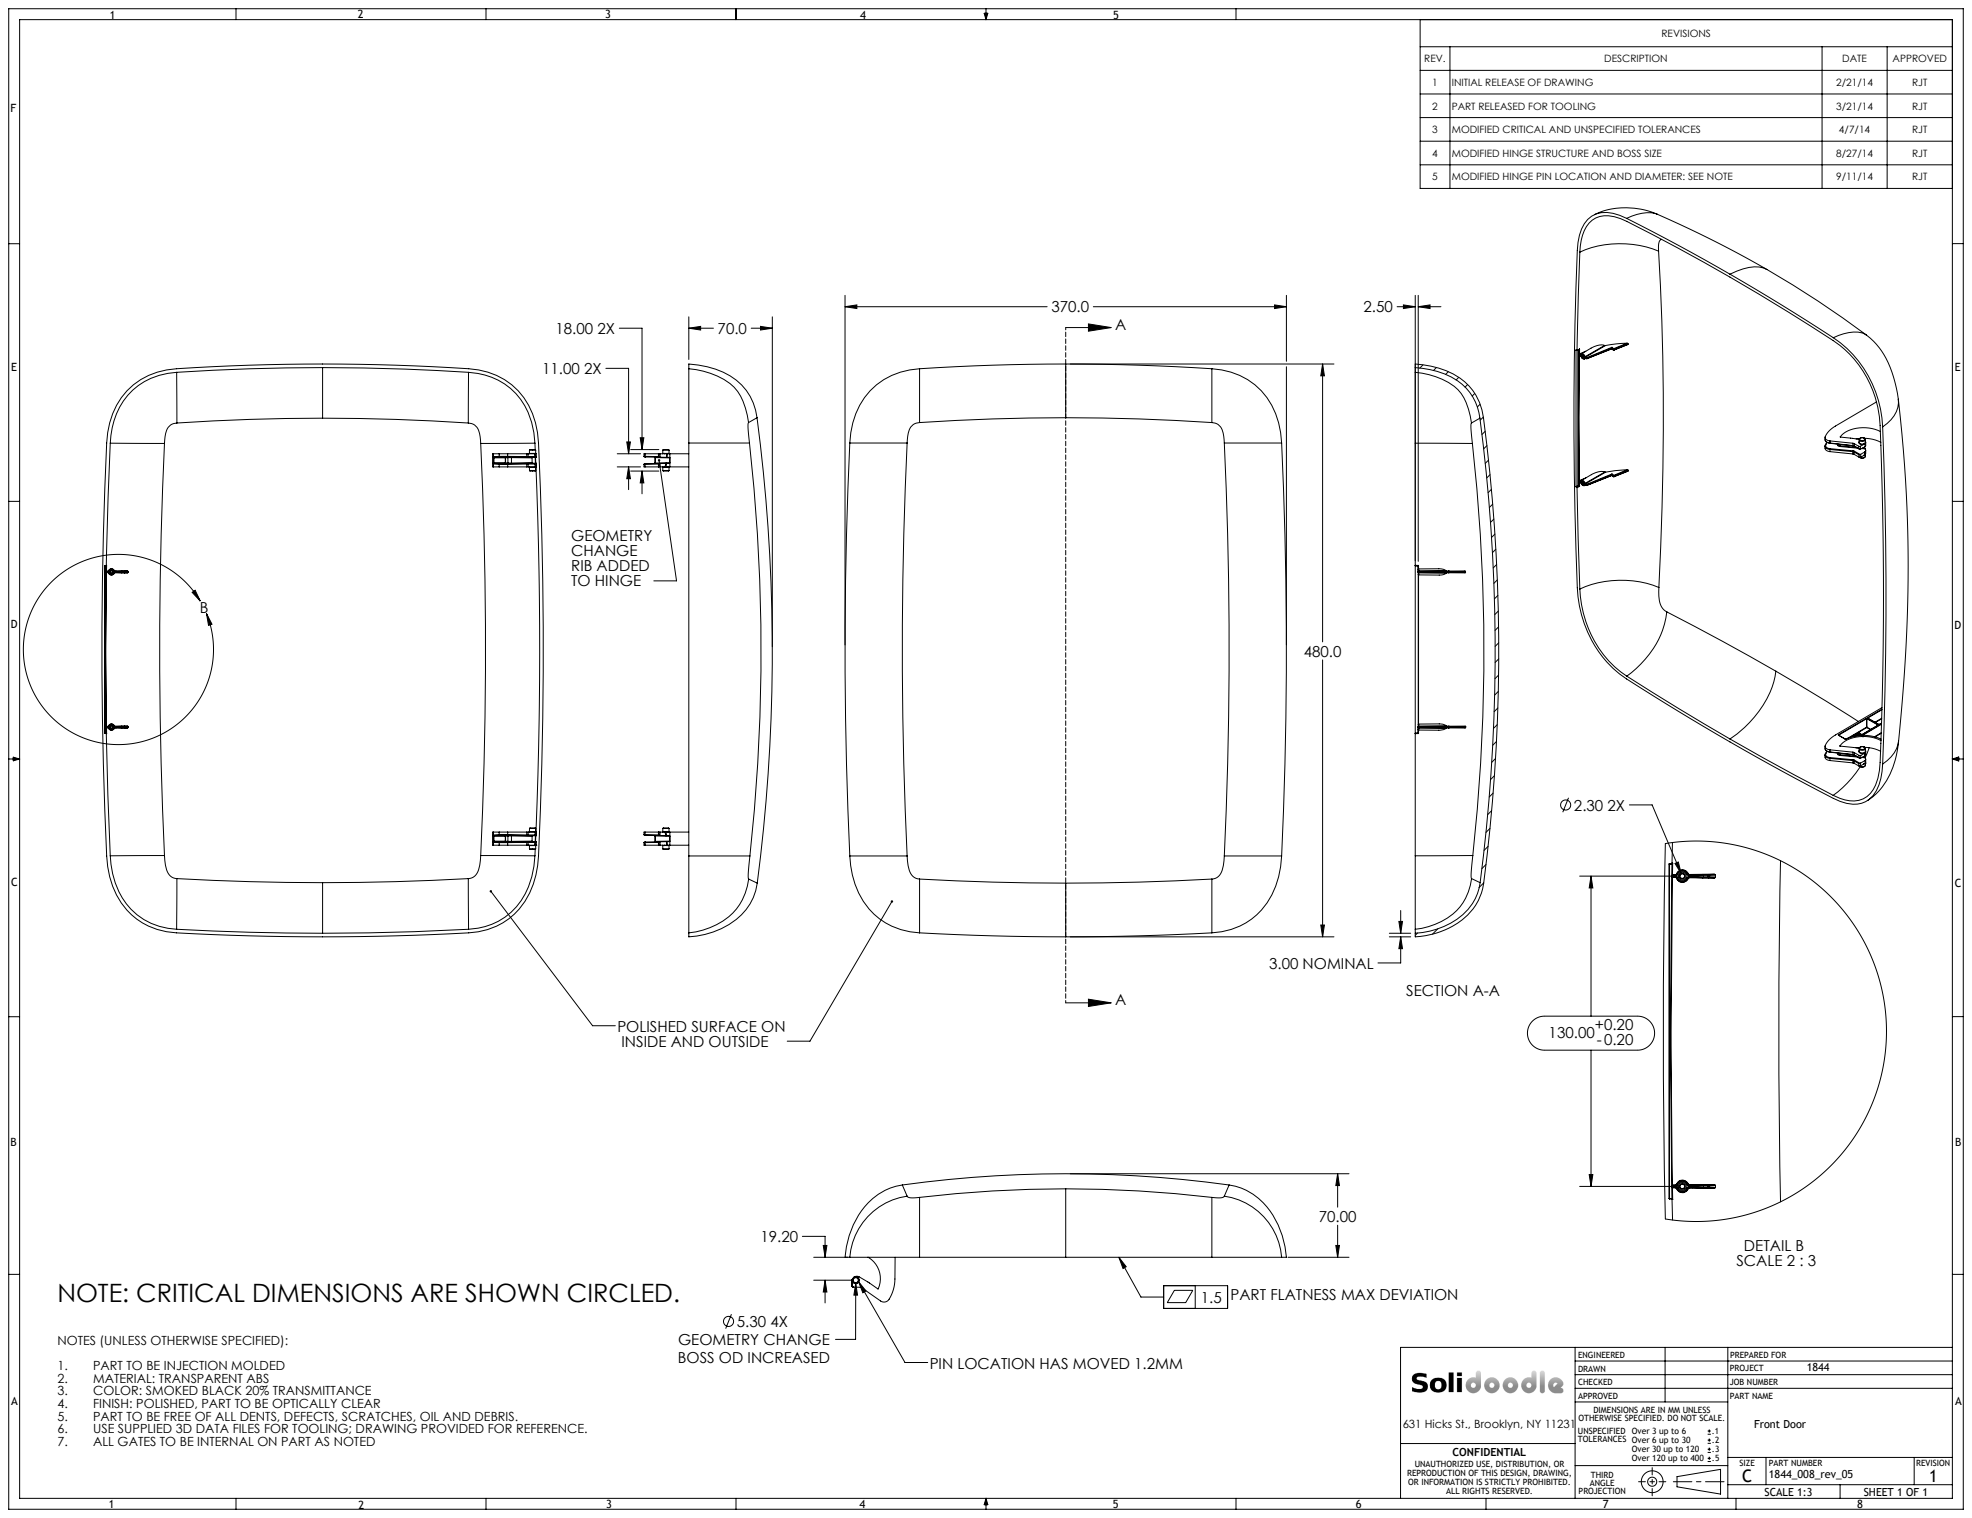
[picture p154: page 1]
RIB ADDED TO HINGE; 5.30 4X GEOMETRY CHANGE; BOSS OD INCREASED; PIN LOCATION HAS MOVED 1.2MM; PART FLATNESS MAX DEVIATION; 3.00 NOMINAL; SECTION A-A; DETAIL B SCALE 2 : 3; ALL RIGHTS RESERVED.; SCALE 1:3; SHEET 1 OF 1; PREPARED FOR; .5 CONFIDENTIAL; JOB NUMBER; PART NUMBER; PART NAME; 631 Hicks St., Brooklyn, NY 11231; Front Door

REV. | DESCRIPTION | DATE | APPROVED
1 | INITIAL RELEASE OF DRAWING | 2/21/14 | RJT
2 | PART RELEASED FOR TOOLING | 3/21/14 | RJT
3 | MODIFIED CRITICAL AND UNSPECIFIED TOLERANCES | 4/7/14 | RJT
4 | MODIFIED HINGE STRUCTURE AND BOSS SIZE | 8/27/14 | RJT
5 | MODIFIED HINGE PIN LOCATION AND DIAMETER: SEE NOTE | 9/11/14 | RJT

POLISHED SURFACE ON
INSIDE AND OUTSIDE

NOTE: CRITICAL DIMENSIONS ARE SHOWN CIRCLED.

NOTES (UNLESS OTHERWISE SPECIFIED):
1. PART TO BE INJECTION MOLDED
2. MATERIAL: TRANSPARENT ABS
3. COLOR: SMOKED BLACK 20% TRANSMITTANCE
4. FINISH: POLISHED, PART TO BE OPTICALLY CLEAR
5. PART TO BE FREE OF ALL DENTS, DEFECTS, SCRATCHES, OIL AND DEBRIS.
6. USE SUPPLIED 3D DATA FILES FOR TOOLING; DRAWING PROVIDED FOR REFERENCE.
7. ALL GATES TO BE INTERNAL ON PART AS NOTED

ENGINEERED
DRAWN
CHECKED
APPROVED
DIMENSIONS ARE IN MM UNLESS
OTHERWISE SPECIFIED. DO NOT SCALE.
UNSPECIFIED
TOLERANCES

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

UNAUTHORIZED USE, DISTRIBUTION, OR
REPRODUCTION OF THIS DESIGN, DRAWING,
OR INFORMATION IS STRICTLY PROHIBITED.
