SolidoodleDev/Press-Drawings/Press Part Drawings/Drawing Prints (PDF)/1844_010_rev_06.PDF

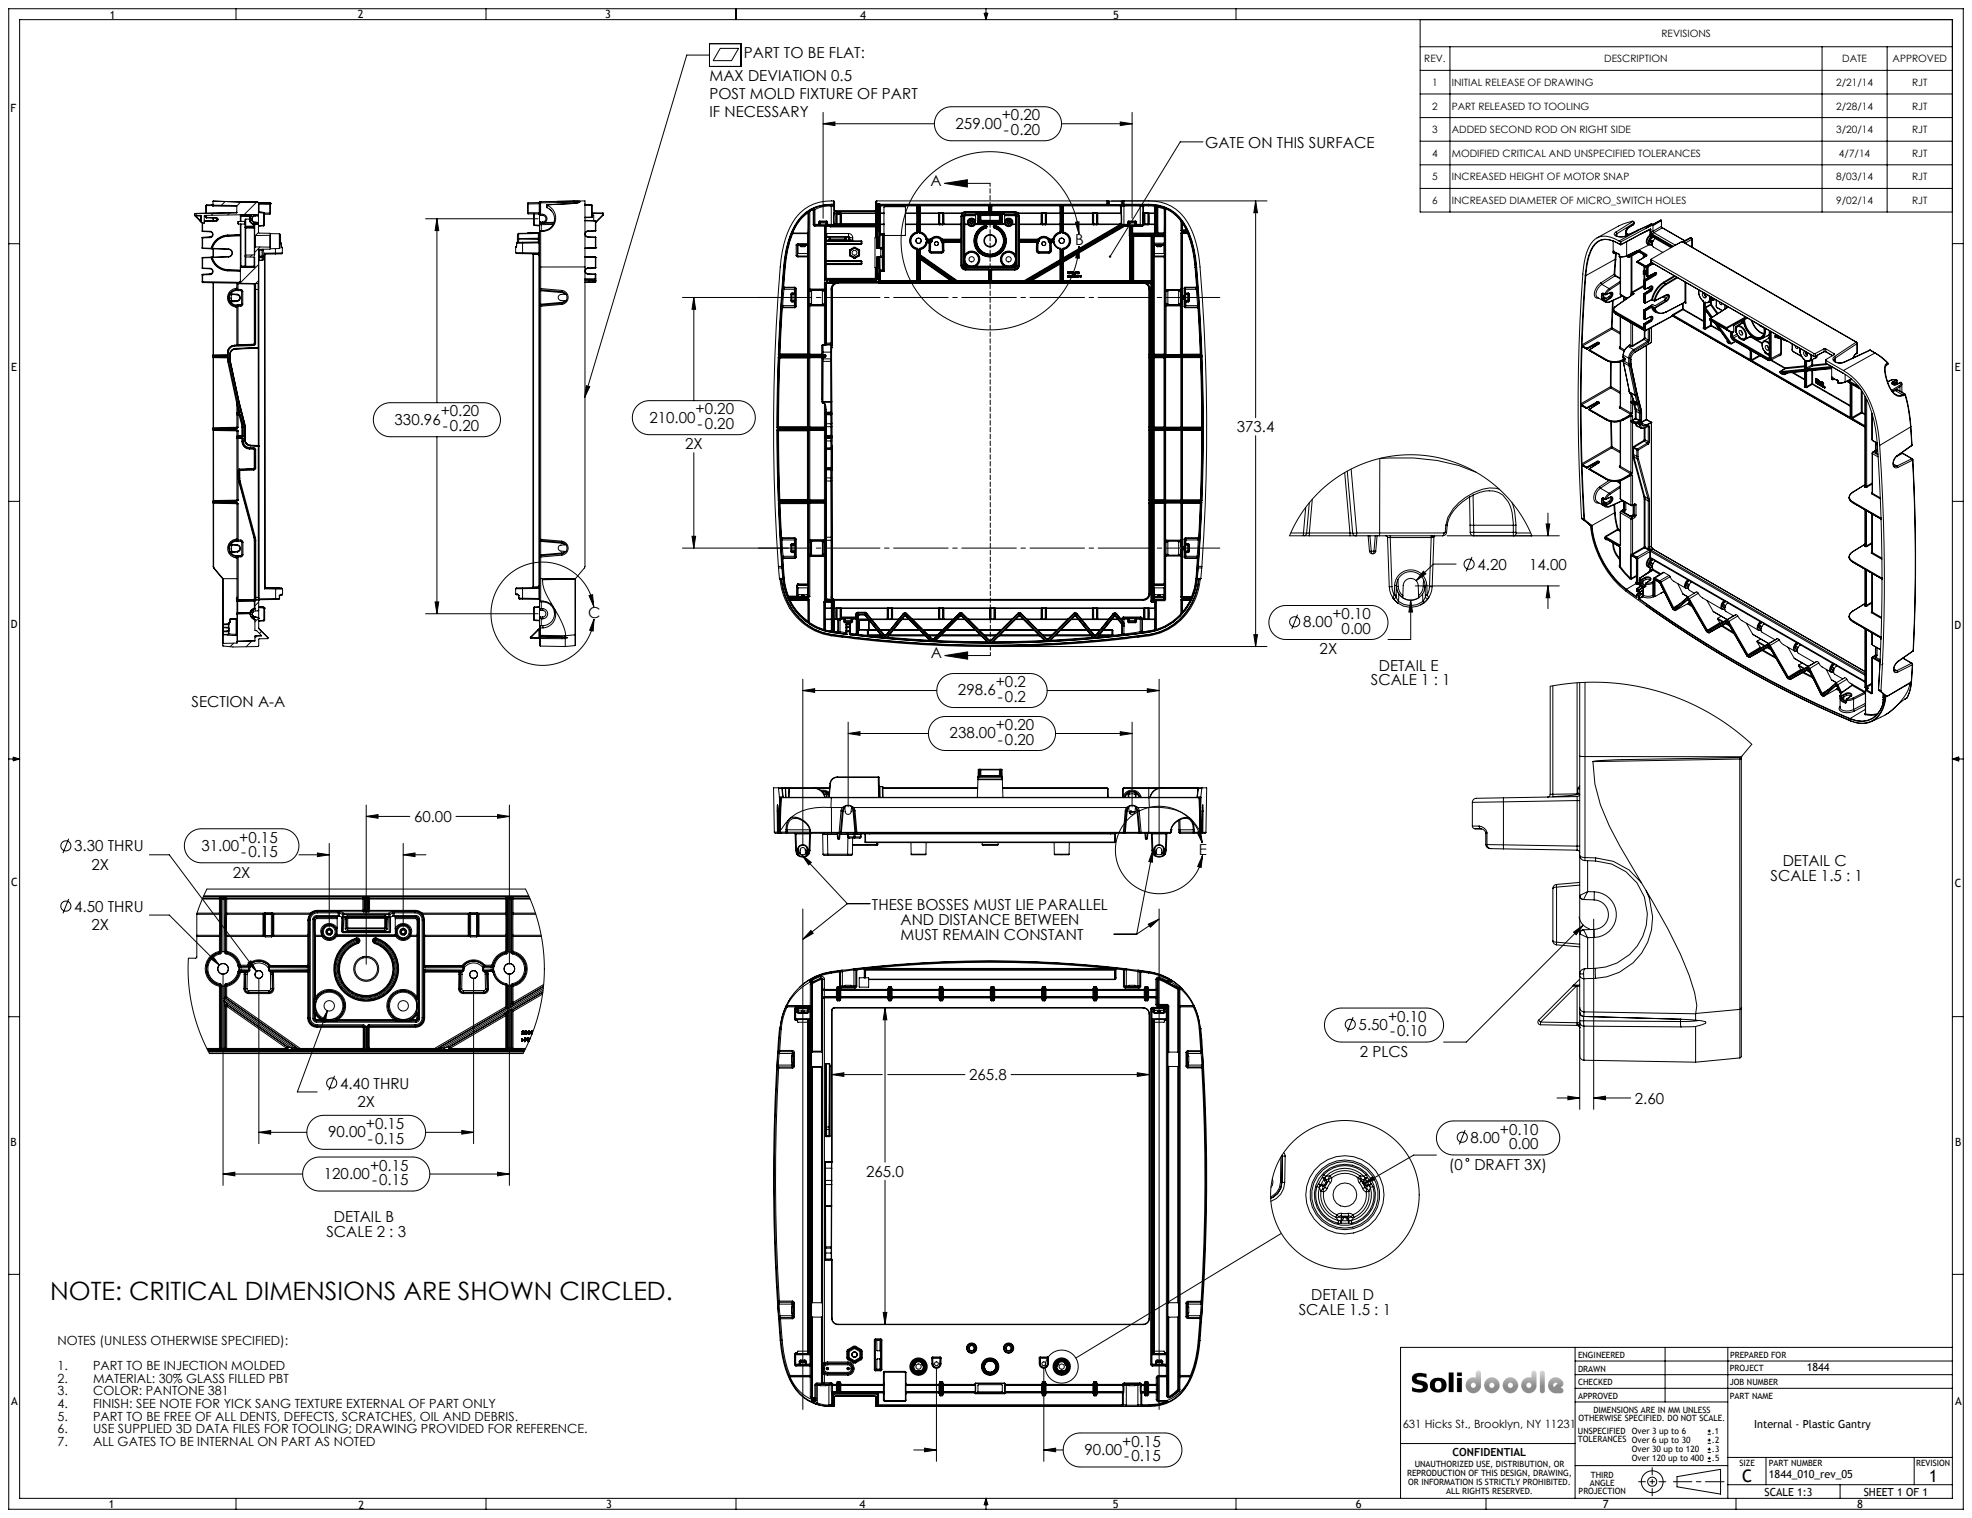
[picture p155: page 1]
SECTION A-A; 4.40 THRU; 4.50 THRU; 3.30 THRU; DETAIL B SCALE 2 : 3; 2 PLCS; DETAIL C SCALE 1.5 : 1; (0 DRAFT 3X); DETAIL D SCALE 1.5 : 1; DETAIL E SCALE 1 : 1; ALL RIGHTS RESERVED.; SCALE 1:3; SHEET 1 OF 1; PREPARED FOR; .5 CONFIDENTIAL; JOB NUMBER; PART NUMBER; PART NAME; 631 Hicks St., Brooklyn, NY 11231; Internal - Plastic Gantry

PART TO BE FLAT:
MAX DEVIATION 0.5
POST MOLD FIXTURE OF PART
IF NECESSARY

REV. | DESCRIPTION | DATE | APPROVED
1 | INITIAL RELEASE OF DRAWING | 2/21/14 | RJT
2 | PART RELEASED TO TOOLING | 2/28/14 | RJT
3 | ADDED SECOND ROD ON RIGHT SIDE | 3/20/14 | RJT
4 | MODIFIED CRITICAL AND UNSPECIFIED TOLERANCES | 4/7/14 | RJT
5 | INCREASED HEIGHT OF MOTOR SNAP | 8/03/14 | RJT
6 | INCREASED DIAMETER OF MICRO_SWITCH HOLES | 9/02/14 | RJT

GATE ON THIS SURFACE

THESE BOSSES MUST LIE PARALLEL
AND DISTANCE BETWEEN
MUST REMAIN CONSTANT

NOTE: CRITICAL DIMENSIONS ARE SHOWN CIRCLED.

NOTES (UNLESS OTHERWISE SPECIFIED):
1. PART TO BE INJECTION MOLDED
2. MATERIAL: 30% GLASS FILLED PBT
3. COLOR: PANTONE 381
4. FINISH: SEE NOTE FOR YICK SANG TEXTURE EXTERNAL OF PART ONLY
5. PART TO BE FREE OF ALL DENTS, DEFECTS, SCRATCHES, OIL AND DEBRIS.
6. USE SUPPLIED 3D DATA FILES FOR TOOLING; DRAWING PROVIDED FOR REFERENCE.
7. ALL GATES TO BE INTERNAL ON PART AS NOTED

ENGINEERED
DRAWN
CHECKED
APPROVED
DIMENSIONS ARE IN MM UNLESS
OTHERWISE SPECIFIED. DO NOT SCALE.
UNSPECIFIED
TOLERANCES

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

UNAUTHORIZED USE, DISTRIBUTION, OR
REPRODUCTION OF THIS DESIGN, DRAWING,
OR INFORMATION IS STRICTLY PROHIBITED.
