SolidoodleDev/Press-Drawings/Press Part Drawings/Drawing Prints (PDF)/1844_011_rev_05.PDF

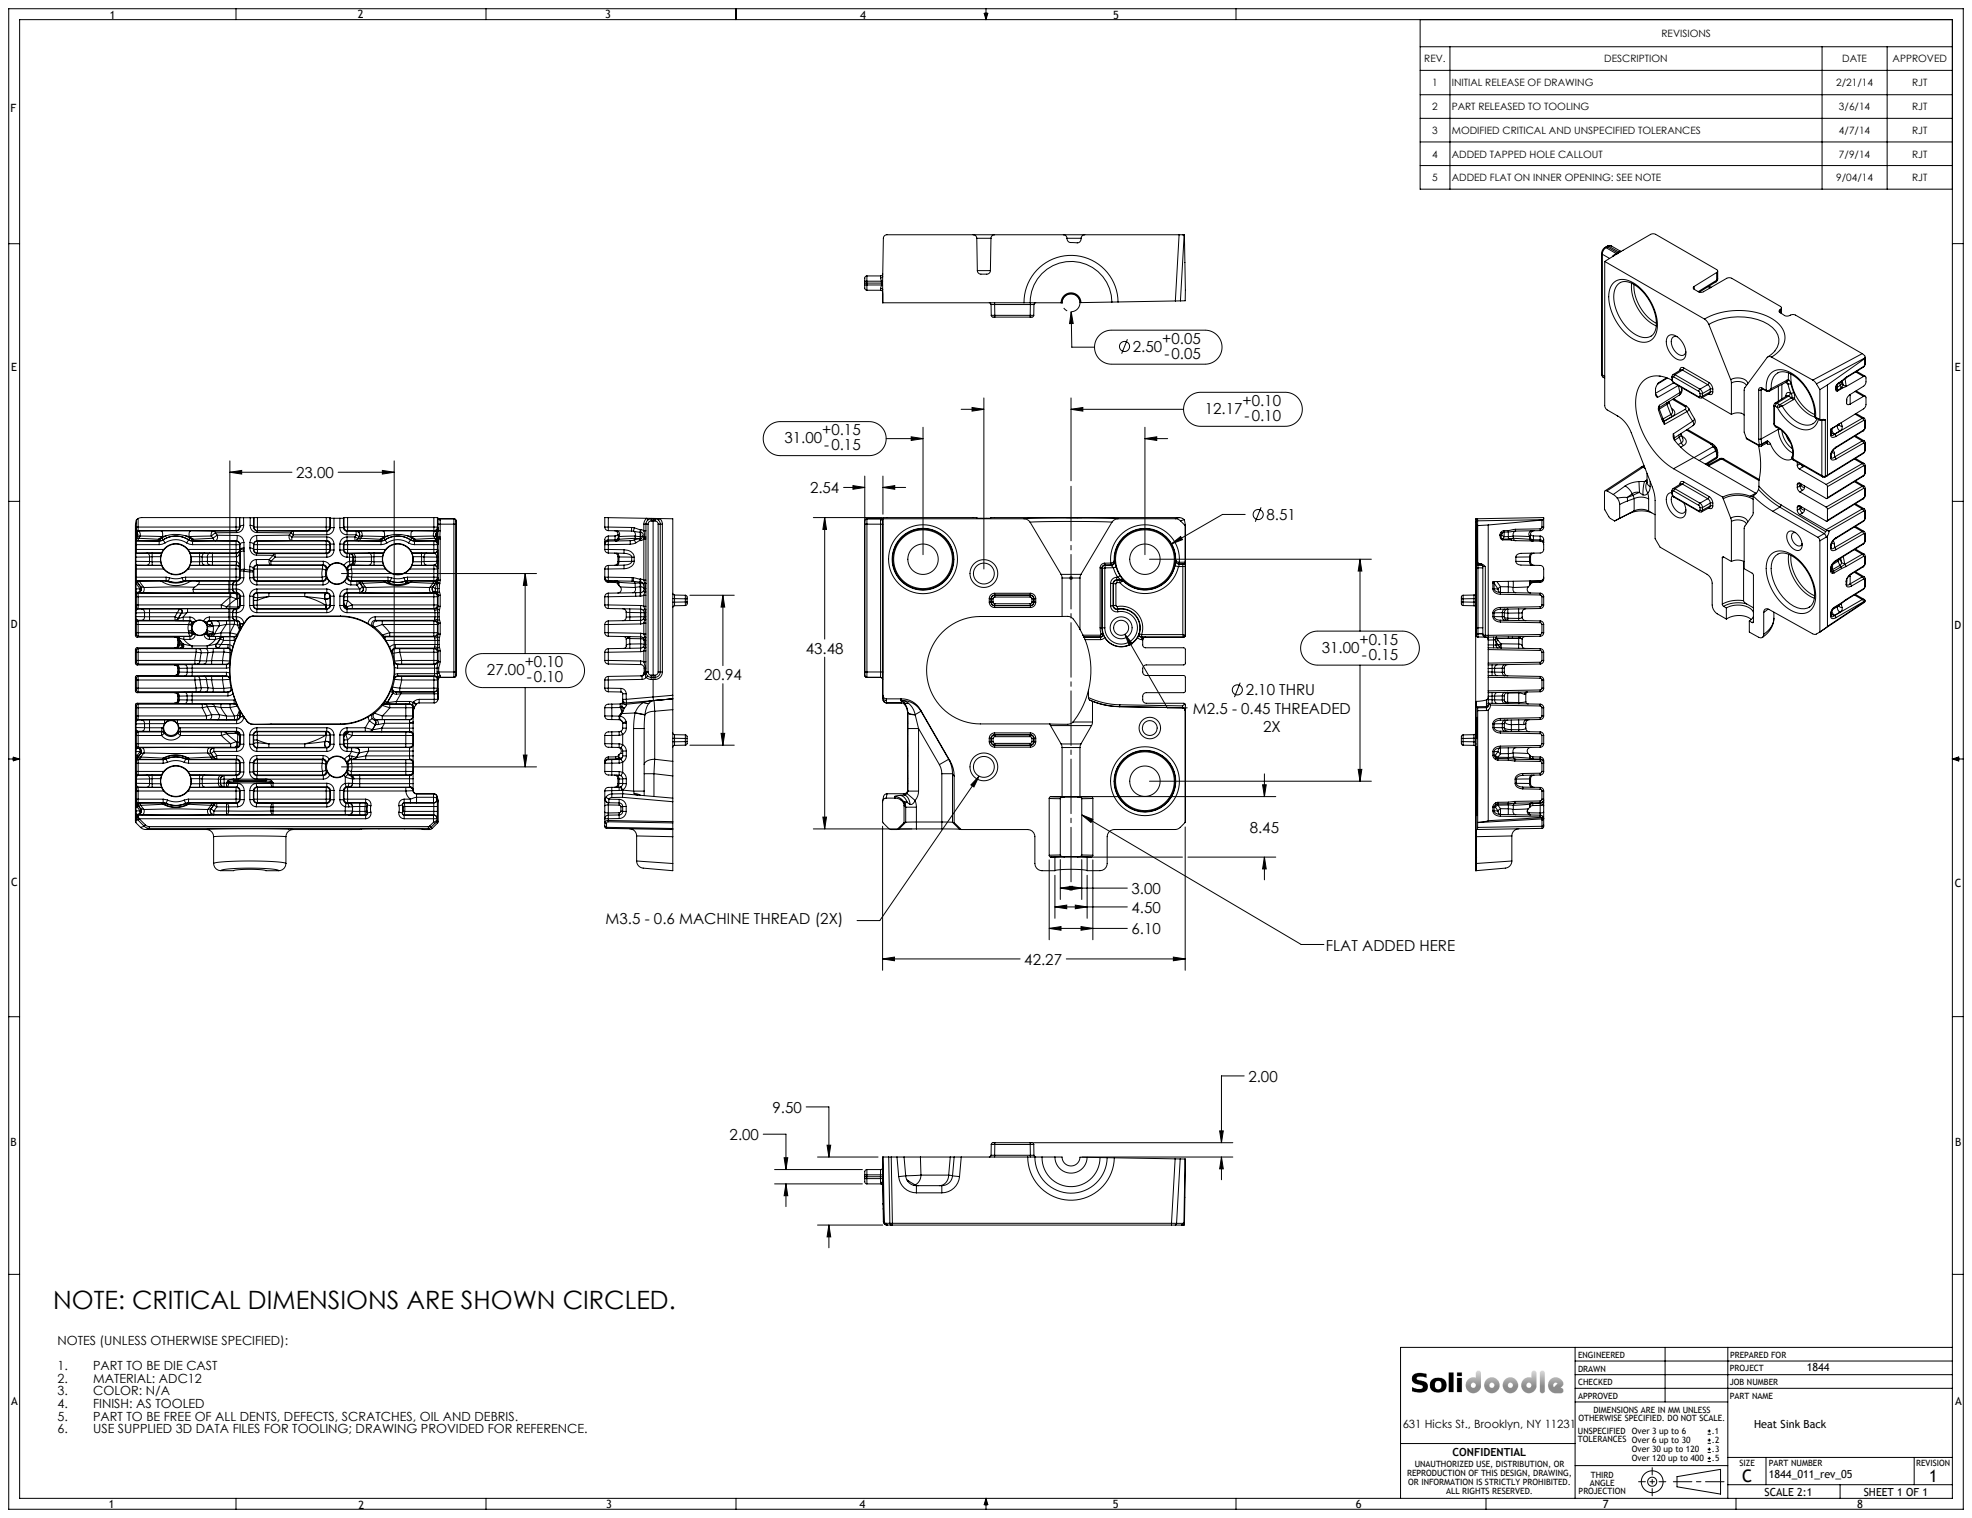
[picture p156: page 1]
2.10 THRU M2.5 - 0.45 THREADED; M3.5 - 0.6 MACHINE THREAD (2X); ALL RIGHTS RESERVED.; SCALE 2:1; SHEET 1 OF 1; PREPARED FOR; .5 CONFIDENTIAL; JOB NUMBER; PART NUMBER; PART NAME; 631 Hicks St., Brooklyn, NY 11231; Heat Sink Back

REV. | DESCRIPTION | DATE | APPROVED
1 | INITIAL RELEASE OF DRAWING | 2/21/14 | RJT
2 | PART RELEASED TO TOOLING | 3/6/14 | RJT
3 | MODIFIED CRITICAL AND UNSPECIFIED TOLERANCES | 4/7/14 | RJT
4 | ADDED TAPPED HOLE CALLOUT | 7/9/14 | RJT
5 | ADDED FLAT ON INNER OPENING: SEE NOTE | 9/04/14 | RJT

FLAT ADDED HERE

NOTE: CRITICAL DIMENSIONS ARE SHOWN CIRCLED.

NOTES (UNLESS OTHERWISE SPECIFIED):
1. PART TO BE DIE CAST
2. MATERIAL: ADC12
3. COLOR: N/A
4. FINISH: AS TOOLED
5. PART TO BE FREE OF ALL DENTS, DEFECTS, SCRATCHES, OIL AND DEBRIS.
6. USE SUPPLIED 3D DATA FILES FOR TOOLING; DRAWING PROVIDED FOR REFERENCE.

ENGINEERED
DRAWN
CHECKED
APPROVED
DIMENSIONS ARE IN MM UNLESS
OTHERWISE SPECIFIED. DO NOT SCALE.
UNSPECIFIED
TOLERANCES

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

UNAUTHORIZED USE, DISTRIBUTION, OR
REPRODUCTION OF THIS DESIGN, DRAWING,
OR INFORMATION IS STRICTLY PROHIBITED.
