SolidoodleDev/Press-Drawings/Press Part Drawings/Drawing Prints (PDF)/1844_014_rev_06.PDF

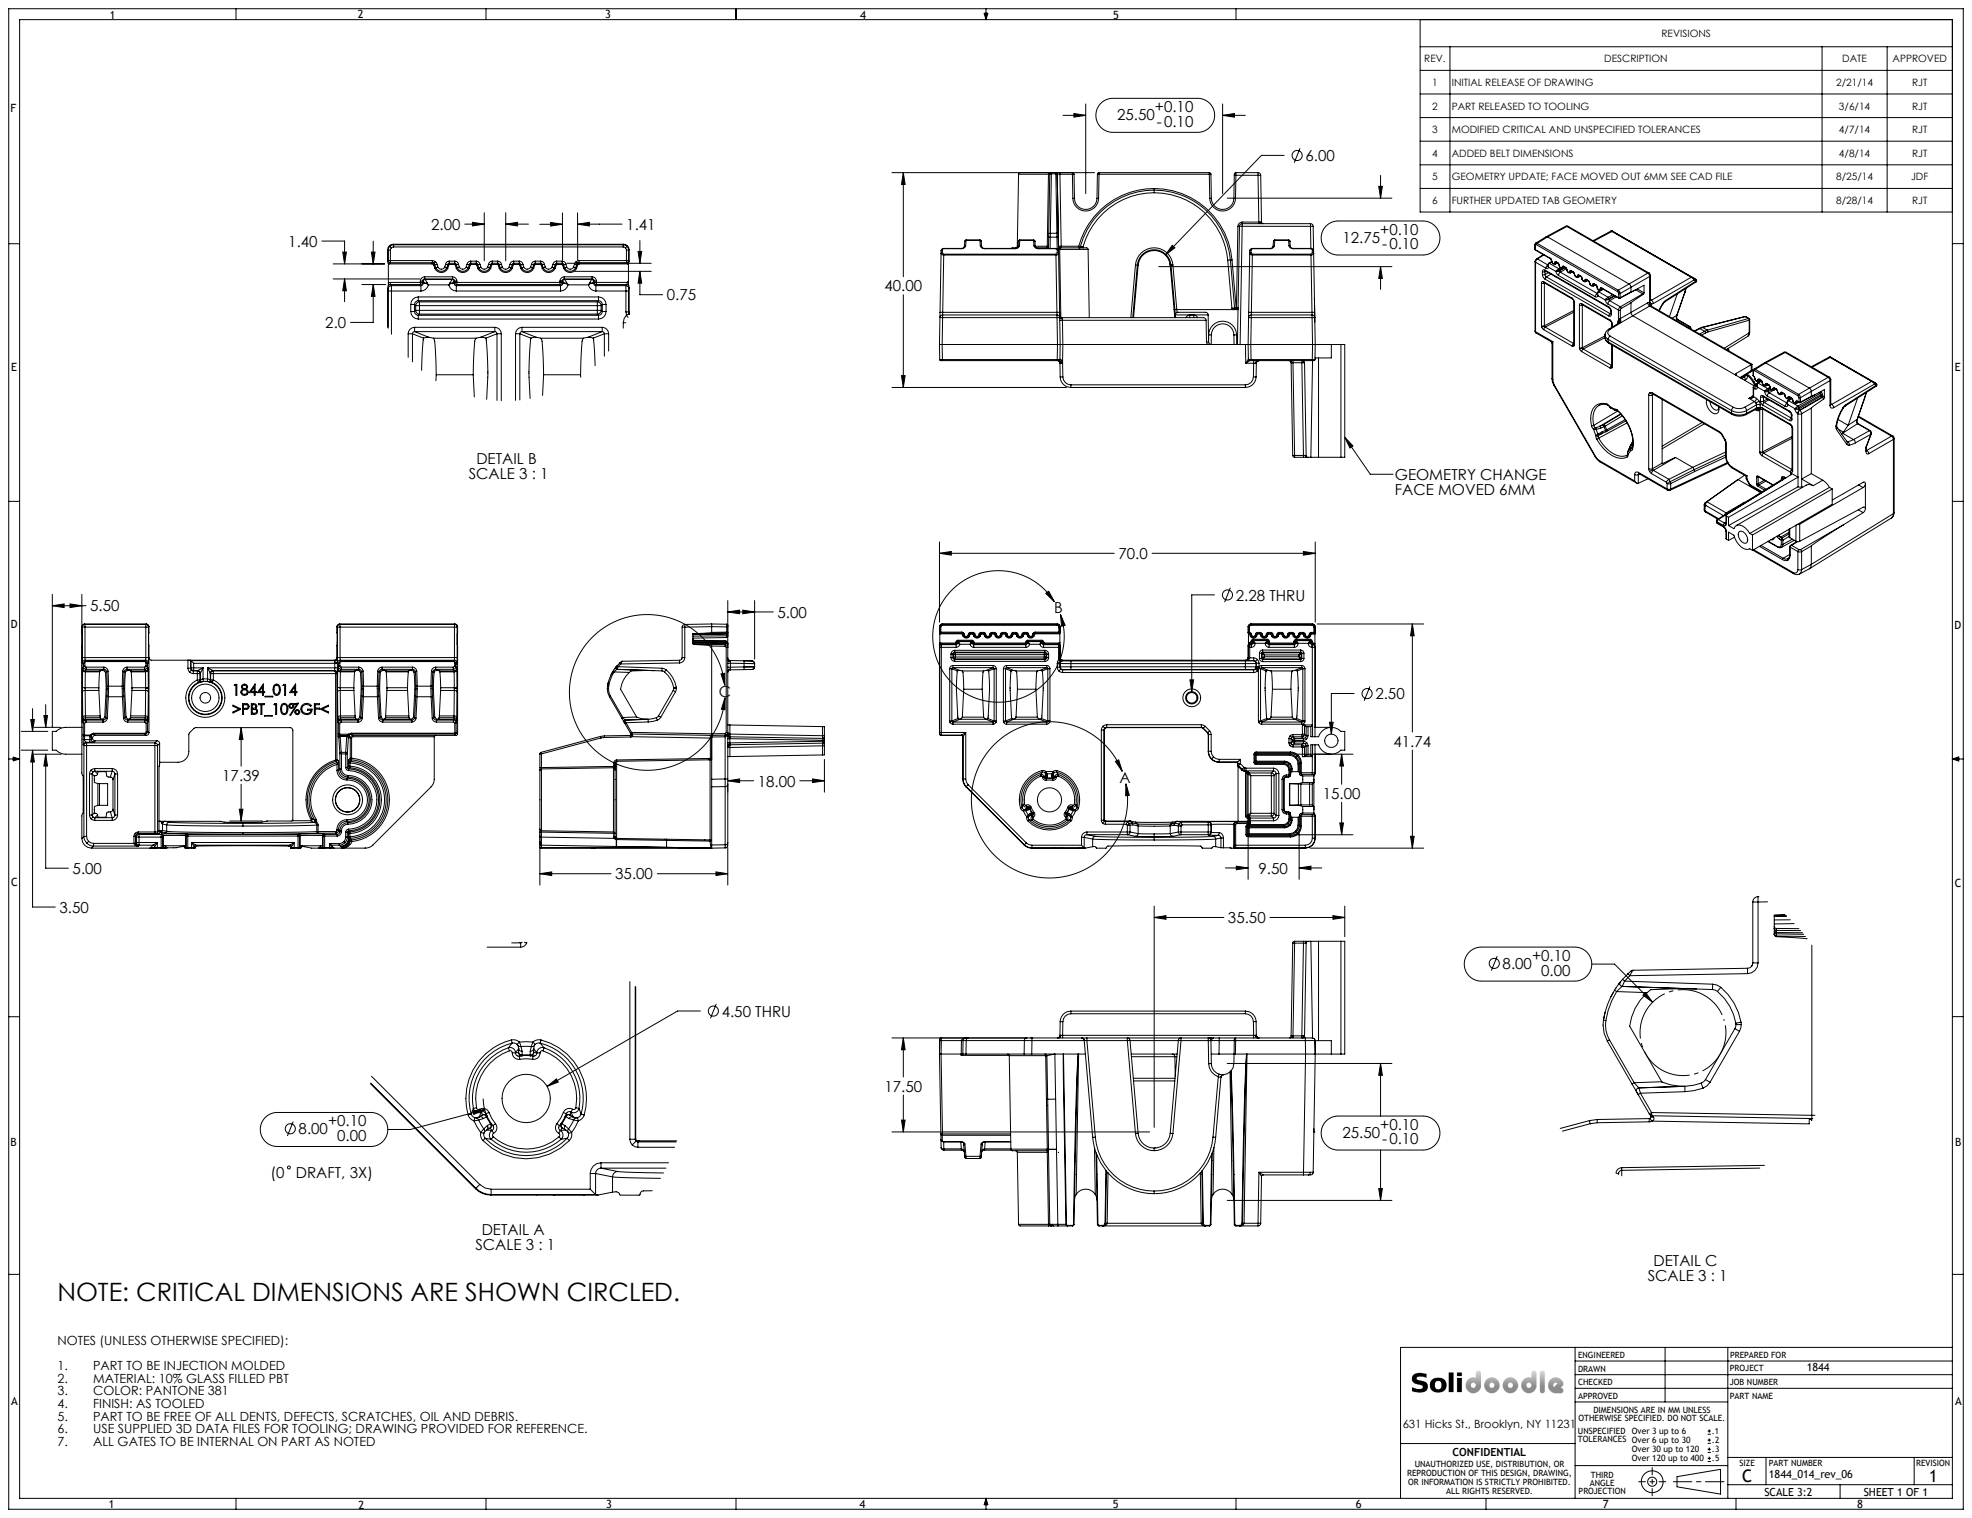
[picture p157: page 1]
2.28 THRU; (0 DRAFT, 3X); GEOMETRY CHANGE FACE MOVED 6MM; 4.50 THRU; DETAIL A SCALE 3 : 1; DETAIL B SCALE 3 : 1; DETAIL C SCALE 3 : 1; ALL RIGHTS RESERVED.; SCALE 3:2; SHEET 1 OF 1; PREPARED FOR; .5 CONFIDENTIAL; JOB NUMBER; PART NUMBER; PART NAME

REV. | DESCRIPTION | DATE | APPROVED
1 | INITIAL RELEASE OF DRAWING | 2/21/14 | RJT
2 | PART RELEASED TO TOOLING | 3/6/14 | RJT
3 | MODIFIED CRITICAL AND UNSPECIFIED TOLERANCES | 4/7/14 | RJT
4 | ADDED BELT DIMENSIONS | 4/8/14 | RJT
5 | GEOMETRY UPDATE; FACE MOVED OUT 6MM SEE CAD FILE | 8/25/14 | JDF
6 | FURTHER UPDATED TAB GEOMETRY | 8/28/14 | RJT

NOTE: CRITICAL DIMENSIONS ARE SHOWN CIRCLED.

NOTES (UNLESS OTHERWISE SPECIFIED):
1. PART TO BE INJECTION MOLDED
2. MATERIAL: 10% GLASS FILLED PBT
3. COLOR: PANTONE 381
4. FINISH: AS TOOLED
5. PART TO BE FREE OF ALL DENTS, DEFECTS, SCRATCHES, OIL AND DEBRIS.
6. USE SUPPLIED 3D DATA FILES FOR TOOLING; DRAWING PROVIDED FOR REFERENCE.
7. ALL GATES TO BE INTERNAL ON PART AS NOTED

ENGINEERED
DRAWN
CHECKED
APPROVED
DIMENSIONS ARE IN MM UNLESS
OTHERWISE SPECIFIED. DO NOT SCALE.
UNSPECIFIED
TOLERANCES

631 Hicks St., Brooklyn, NY 11231

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

UNAUTHORIZED USE, DISTRIBUTION, OR
REPRODUCTION OF THIS DESIGN, DRAWING,
OR INFORMATION IS STRICTLY PROHIBITED.
