SolidoodleDev/Press-Drawings/Press Part Drawings/Drawing Prints (PDF)/1844_017_rev_04.PDF

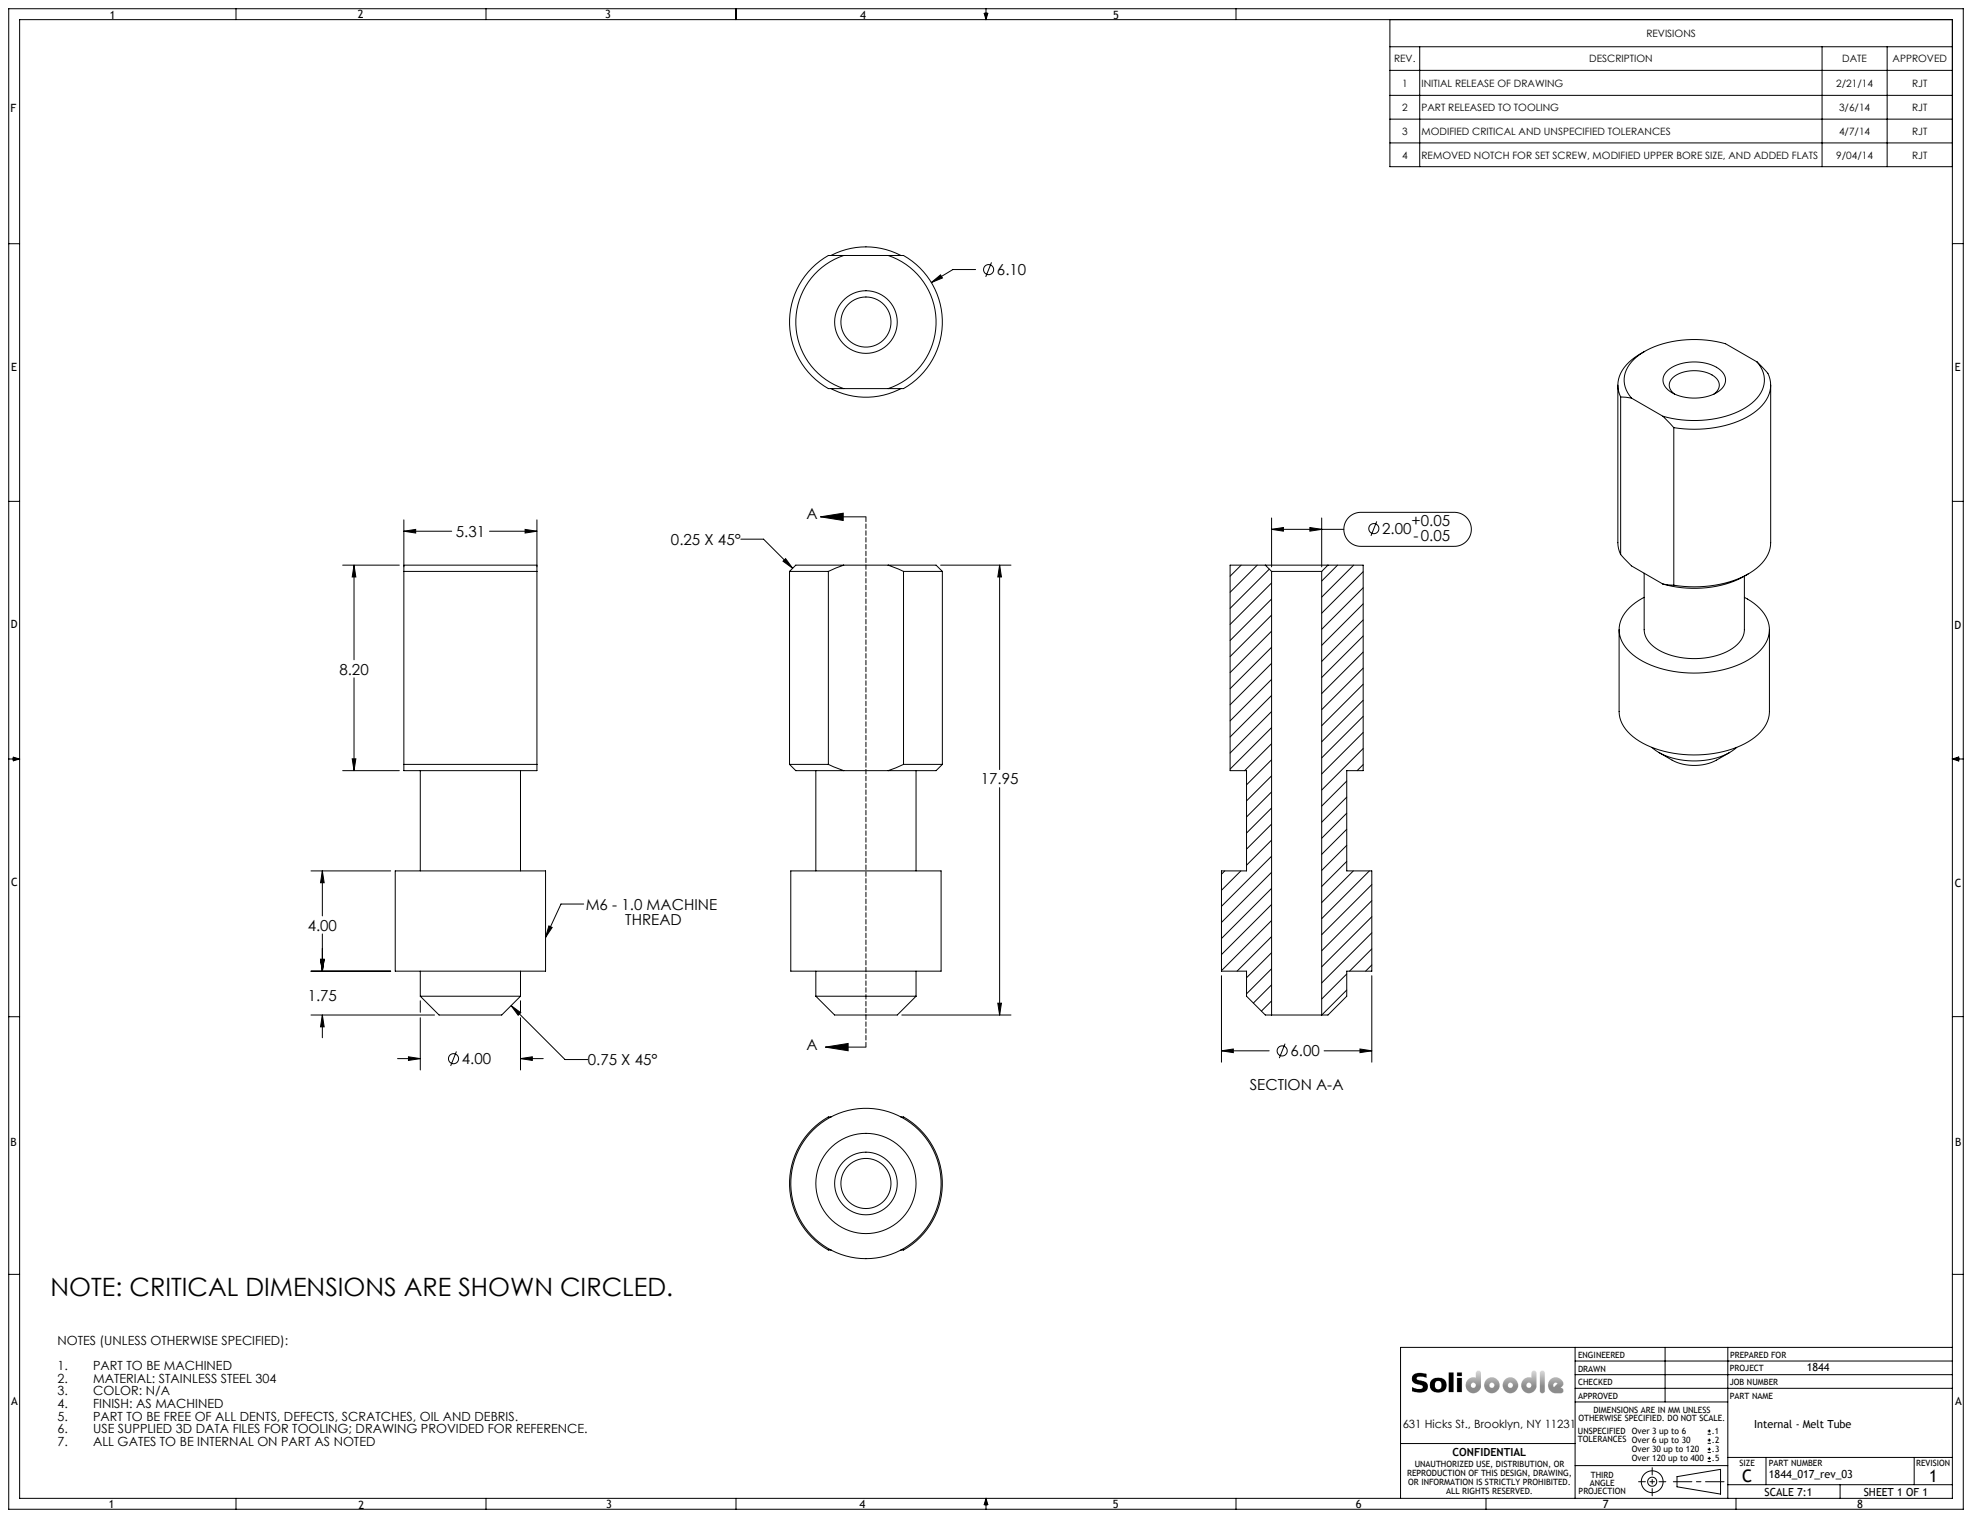
[picture p158: page 1]
M6 - 1.0 MACHINE; SECTION A-A; ALL RIGHTS RESERVED.; SCALE 7:1; SHEET 1 OF 1; PREPARED FOR; .5 CONFIDENTIAL; JOB NUMBER; PART NUMBER; PART NAME; 631 Hicks St., Brooklyn, NY 11231; Internal - Melt Tube

REV. | DESCRIPTION | DATE | APPROVED
1 | INITIAL RELEASE OF DRAWING | 2/21/14 | RJT
2 | PART RELEASED TO TOOLING | 3/6/14 | RJT
3 | MODIFIED CRITICAL AND UNSPECIFIED TOLERANCES | 4/7/14 | RJT
4 | REMOVED NOTCH FOR SET SCREW, MODIFIED UPPER BORE SIZE, AND ADDED FLATS | 9/04/14 | RJT

NOTE: CRITICAL DIMENSIONS ARE SHOWN CIRCLED.

NOTES (UNLESS OTHERWISE SPECIFIED):
1. PART TO BE MACHINED
2. MATERIAL: STAINLESS STEEL 304
3. COLOR: N/A
4. FINISH: AS MACHINED
5. PART TO BE FREE OF ALL DENTS, DEFECTS, SCRATCHES, OIL AND DEBRIS.
6. USE SUPPLIED 3D DATA FILES FOR TOOLING; DRAWING PROVIDED FOR REFERENCE.
7. ALL GATES TO BE INTERNAL ON PART AS NOTED

ENGINEERED
DRAWN
CHECKED
APPROVED
DIMENSIONS ARE IN MM UNLESS
OTHERWISE SPECIFIED. DO NOT SCALE.
UNSPECIFIED
TOLERANCES

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

UNAUTHORIZED USE, DISTRIBUTION, OR
REPRODUCTION OF THIS DESIGN, DRAWING,
OR INFORMATION IS STRICTLY PROHIBITED.
