SolidoodleDev/Press-Drawings/Press Part Drawings/Drawing Prints (PDF)/1844_018_rev_04.PDF

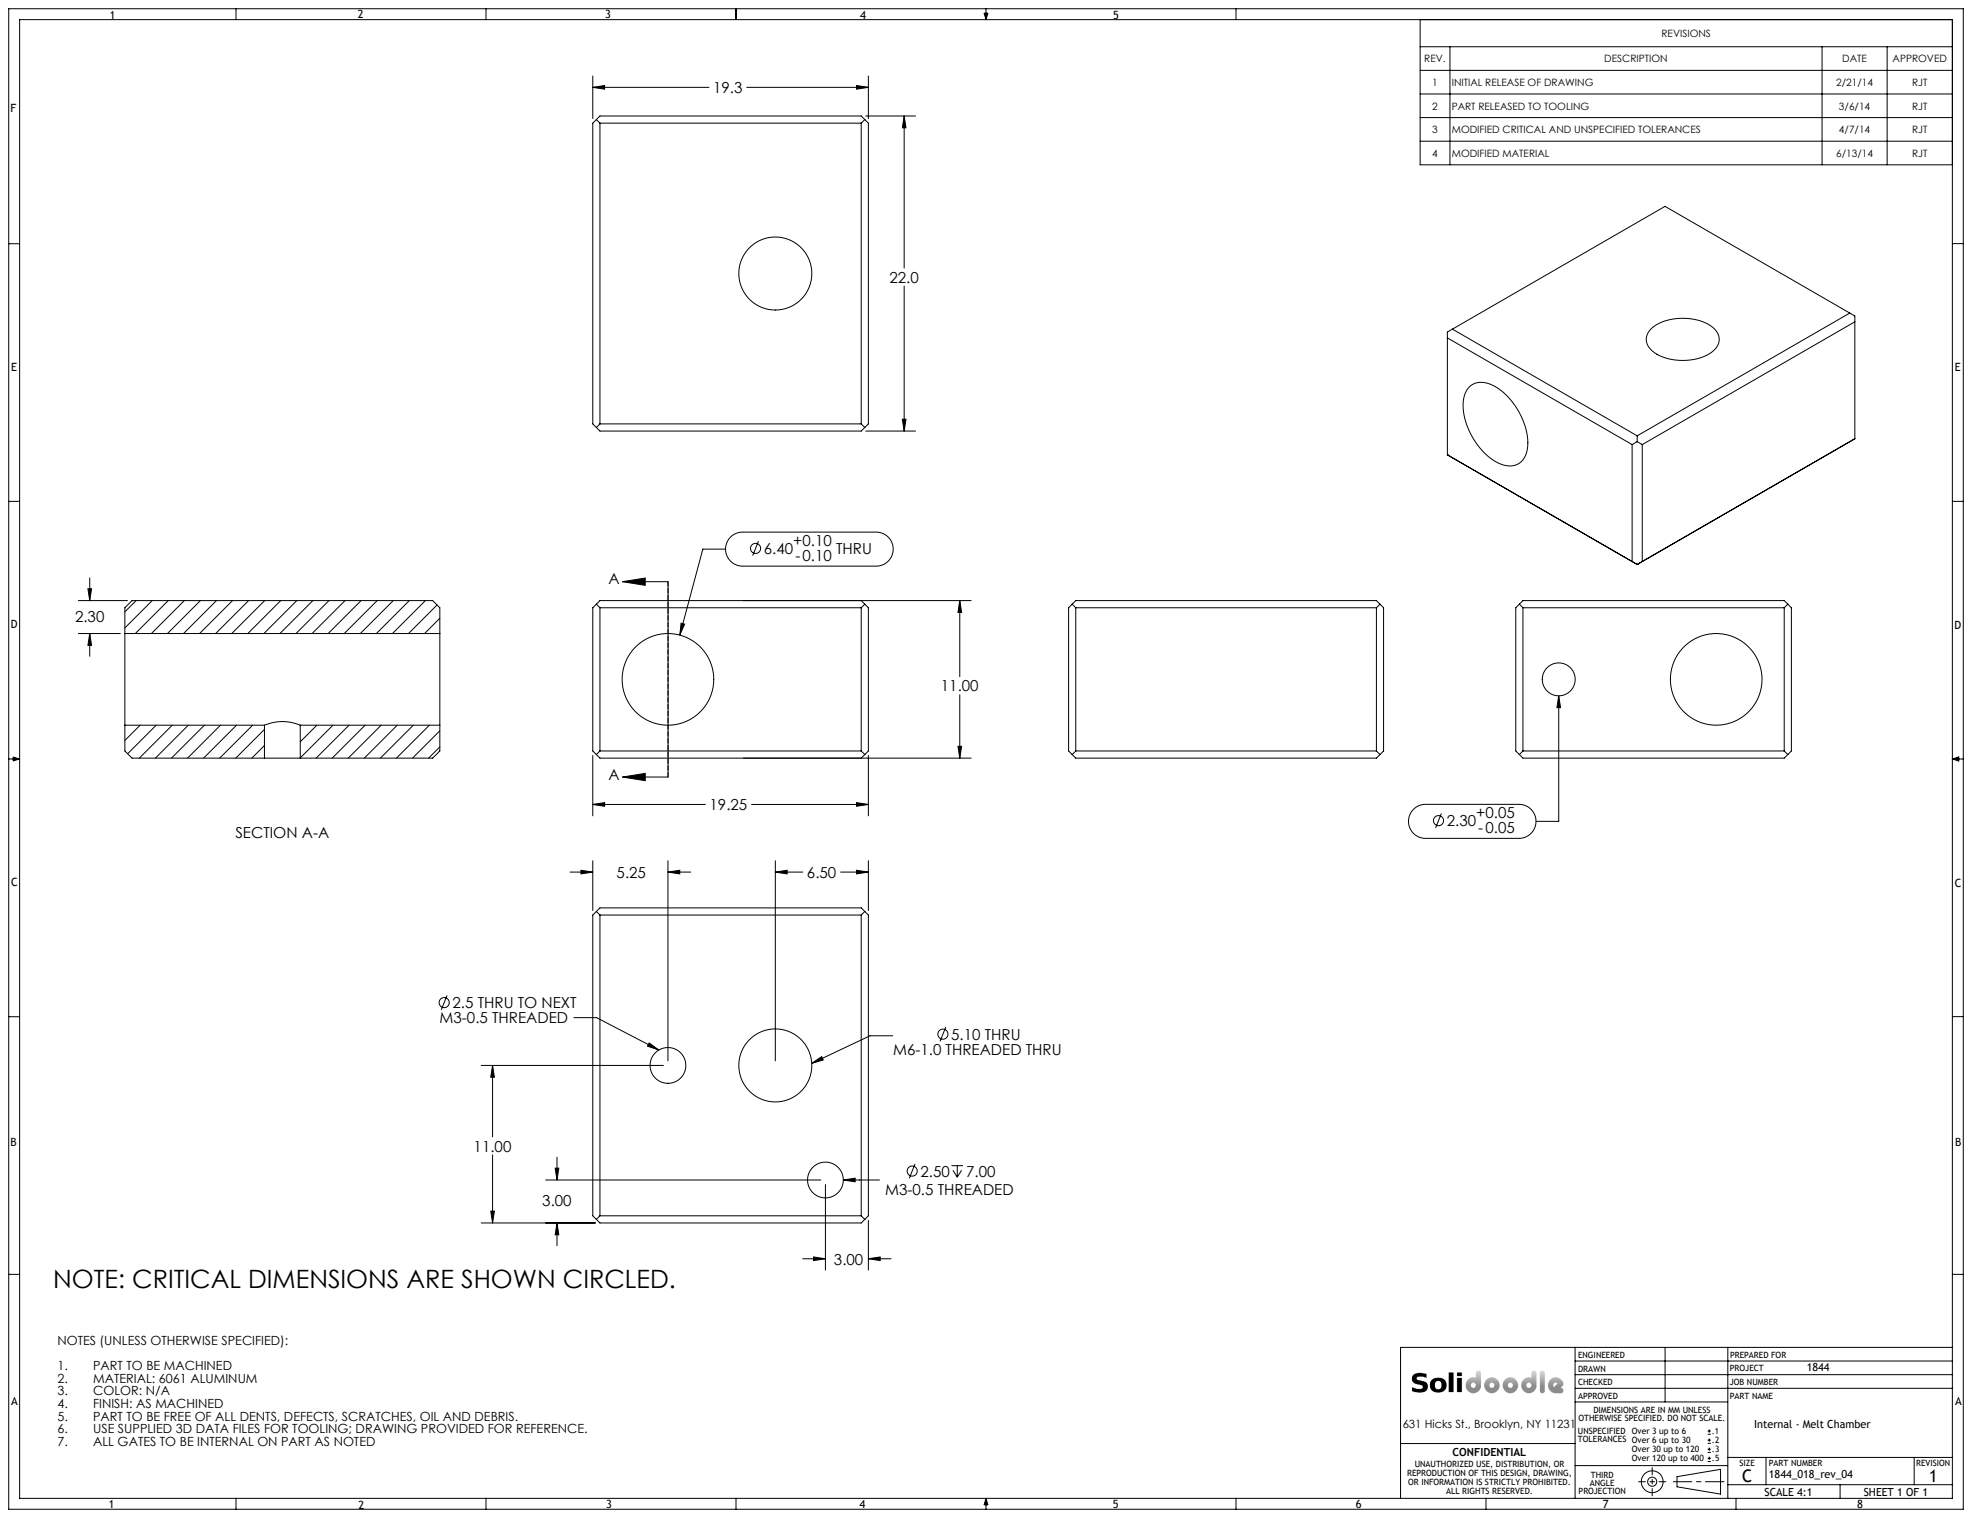
[picture p159: page 1]
0.10 THRU; 2.50 7.00 M3-0.5 THREADED; 5.10 THRU M6-1.0 THREADED THRU; SECTION A-A; ALL RIGHTS RESERVED.; SCALE 4:1; SHEET 1 OF 1; PREPARED FOR; .5 CONFIDENTIAL; JOB NUMBER; PART NUMBER; PART NAME; 631 Hicks St., Brooklyn, NY 11231; Internal - Melt Chamber

REV. | DESCRIPTION | DATE | APPROVED
1 | INITIAL RELEASE OF DRAWING | 2/21/14 | RJT
2 | PART RELEASED TO TOOLING | 3/6/14 | RJT
3 | MODIFIED CRITICAL AND UNSPECIFIED TOLERANCES | 4/7/14 | RJT
4 | MODIFIED MATERIAL | 6/13/14 | RJT

2.5 THRU TO NEXT
M3-0.5 THREADED

NOTE: CRITICAL DIMENSIONS ARE SHOWN CIRCLED.

NOTES (UNLESS OTHERWISE SPECIFIED):
1. PART TO BE MACHINED
2. MATERIAL: 6061 ALUMINUM
3. COLOR: N/A
4. FINISH: AS MACHINED
5. PART TO BE FREE OF ALL DENTS, DEFECTS, SCRATCHES, OIL AND DEBRIS.
6. USE SUPPLIED 3D DATA FILES FOR TOOLING; DRAWING PROVIDED FOR REFERENCE.
7. ALL GATES TO BE INTERNAL ON PART AS NOTED

ENGINEERED
DRAWN
CHECKED
APPROVED
DIMENSIONS ARE IN MM UNLESS
OTHERWISE SPECIFIED. DO NOT SCALE.
UNSPECIFIED
TOLERANCES

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

UNAUTHORIZED USE, DISTRIBUTION, OR
REPRODUCTION OF THIS DESIGN, DRAWING,
OR INFORMATION IS STRICTLY PROHIBITED.
