SolidoodleDev/Press-Drawings/Press Part Drawings/Drawing Prints (PDF)/1844_022_rev_07.PDF

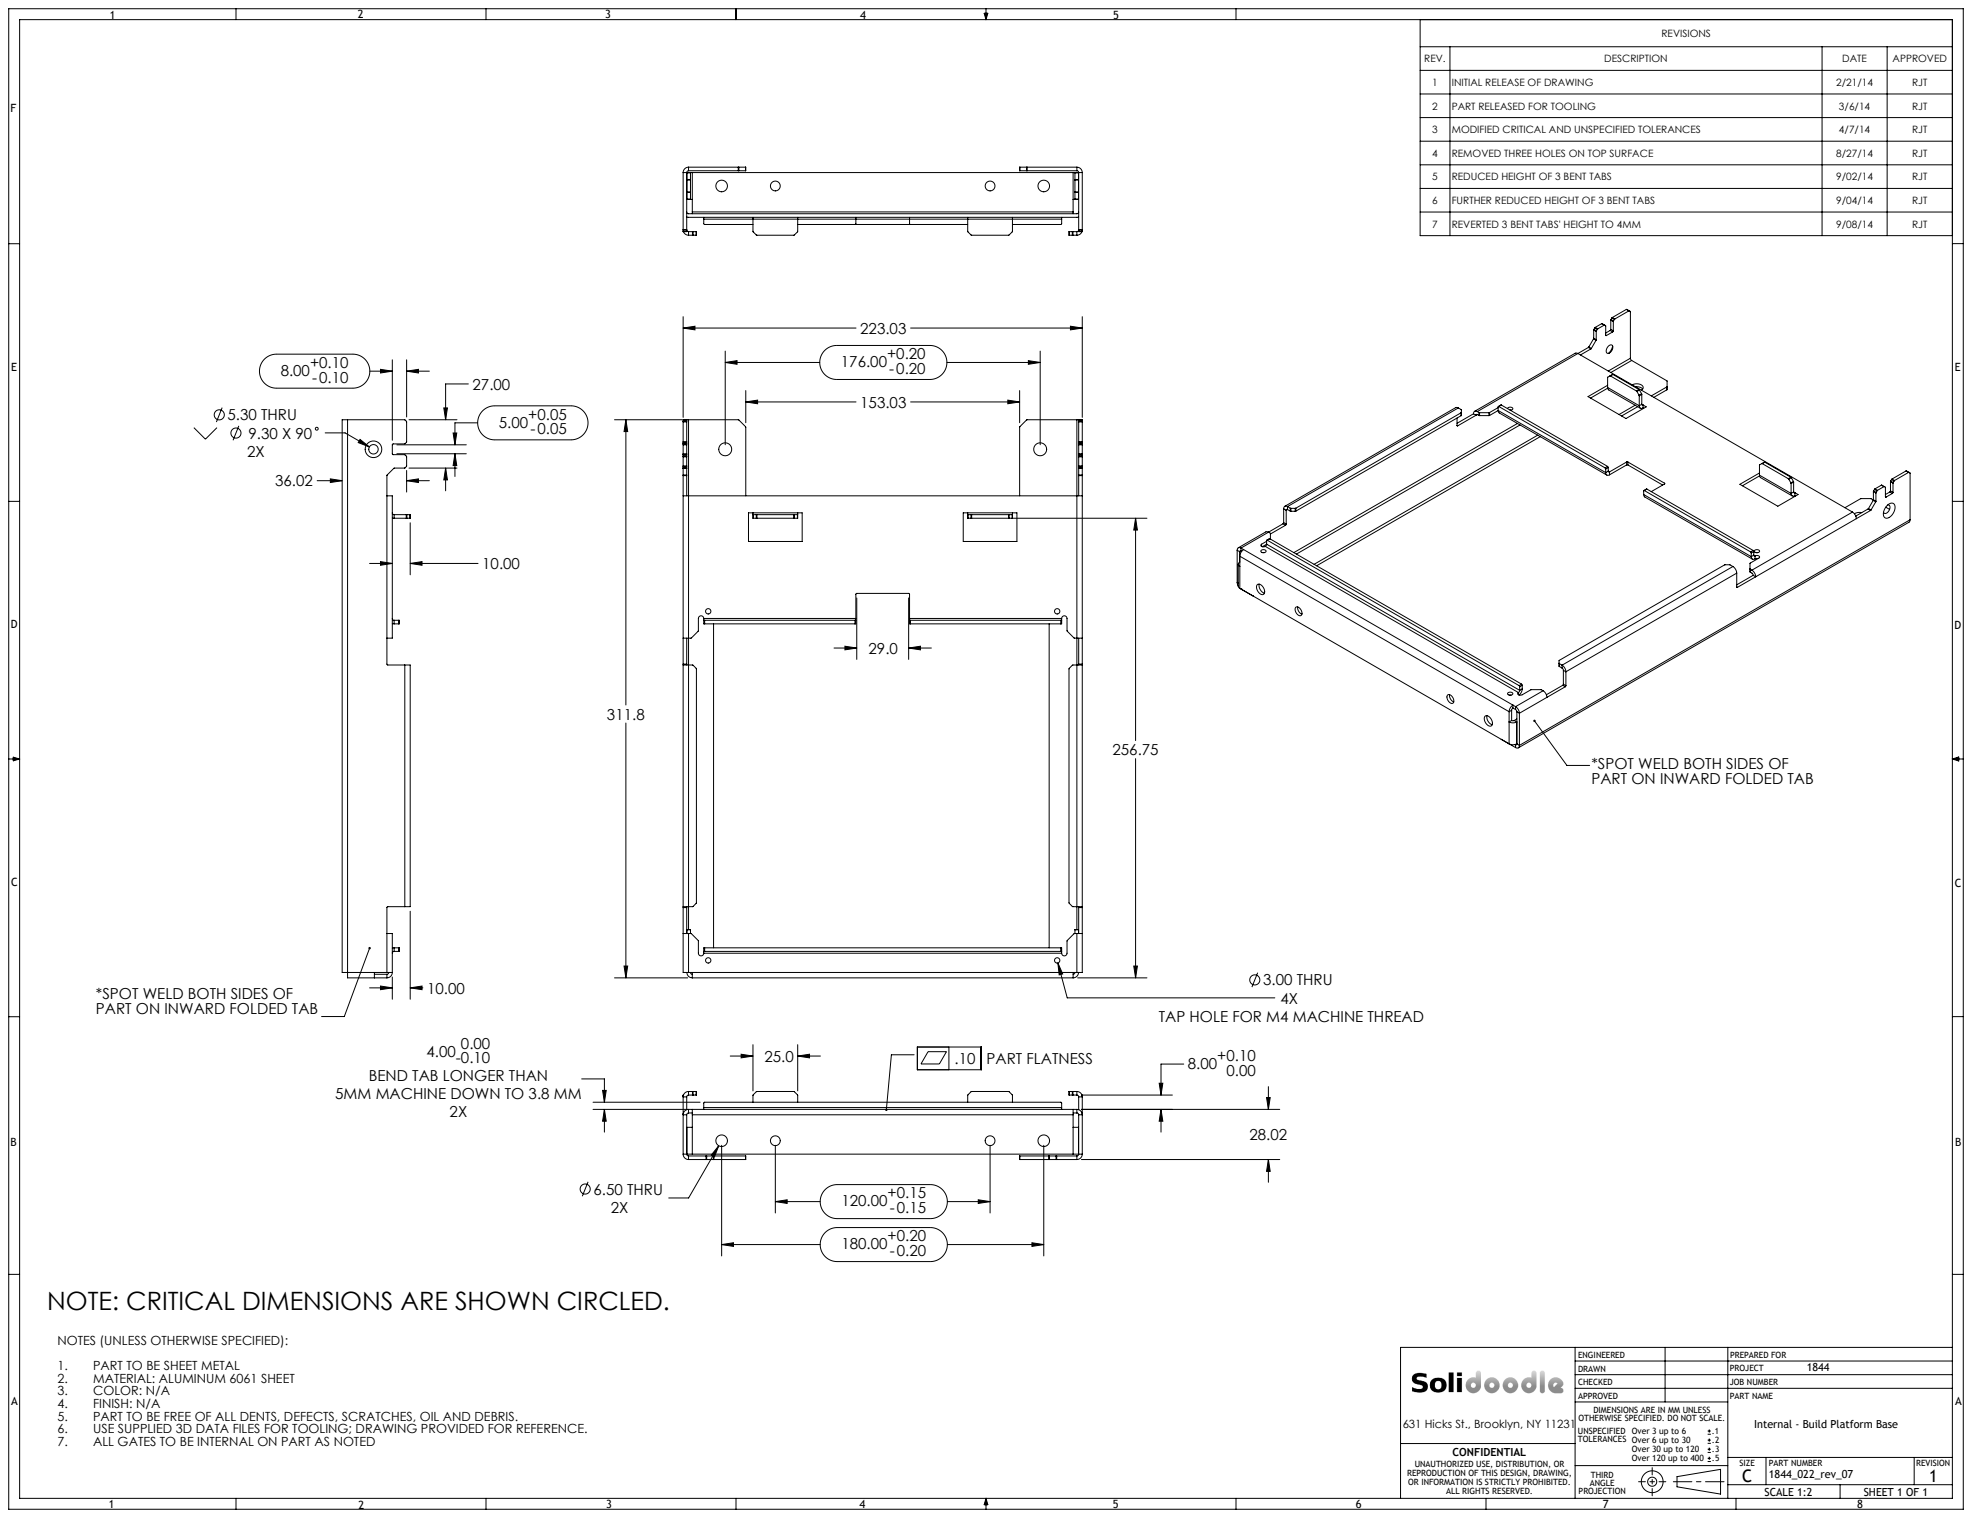
[picture p160: page 1]
3.00 THRU; 5.30 THRU 9.30 X 90; 6.50 THRU; PART FLATNESS; ALL RIGHTS RESERVED.; SCALE 1:2; SHEET 1 OF 1; PREPARED FOR; .5 CONFIDENTIAL; JOB NUMBER; PART NUMBER; PART NAME; 631 Hicks St., Brooklyn, NY 11231; Internal - Build Platform Base

REV. | DESCRIPTION | DATE | APPROVED
1 | INITIAL RELEASE OF DRAWING | 2/21/14 | RJT
2 | PART RELEASED FOR TOOLING | 3/6/14 | RJT
3 | MODIFIED CRITICAL AND UNSPECIFIED TOLERANCES | 4/7/14 | RJT
4 | REMOVED THREE HOLES ON TOP SURFACE | 8/27/14 | RJT
5 | REDUCED HEIGHT OF 3 BENT TABS | 9/02/14 | RJT
6 | FURTHER REDUCED HEIGHT OF 3 BENT TABS | 9/04/14 | RJT
7 | REVERTED 3 BENT TABS' HEIGHT TO 4MM | 9/08/14 | RJT

*SPOT WELD BOTH SIDES OF
PART ON INWARD FOLDED TAB

TAP HOLE FOR M4 MACHINE THREAD

BEND TAB LONGER THAN
5MM MACHINE DOWN TO 3.8 MM

NOTE: CRITICAL DIMENSIONS ARE SHOWN CIRCLED.

NOTES (UNLESS OTHERWISE SPECIFIED):
1. PART TO BE SHEET METAL
2. MATERIAL: ALUMINUM 6061 SHEET
3. COLOR: N/A
4. FINISH: N/A
5. PART TO BE FREE OF ALL DENTS, DEFECTS, SCRATCHES, OIL AND DEBRIS.
6. USE SUPPLIED 3D DATA FILES FOR TOOLING; DRAWING PROVIDED FOR REFERENCE.
7. ALL GATES TO BE INTERNAL ON PART AS NOTED

ENGINEERED
DRAWN
CHECKED
APPROVED
DIMENSIONS ARE IN MM UNLESS
OTHERWISE SPECIFIED. DO NOT SCALE.
UNSPECIFIED
TOLERANCES

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

UNAUTHORIZED USE, DISTRIBUTION, OR
REPRODUCTION OF THIS DESIGN, DRAWING,
OR INFORMATION IS STRICTLY PROHIBITED.
