SolidoodleDev/Press-Drawings/Press Part Drawings/Drawing Prints (PDF)/1844_023_rev_04.PDF

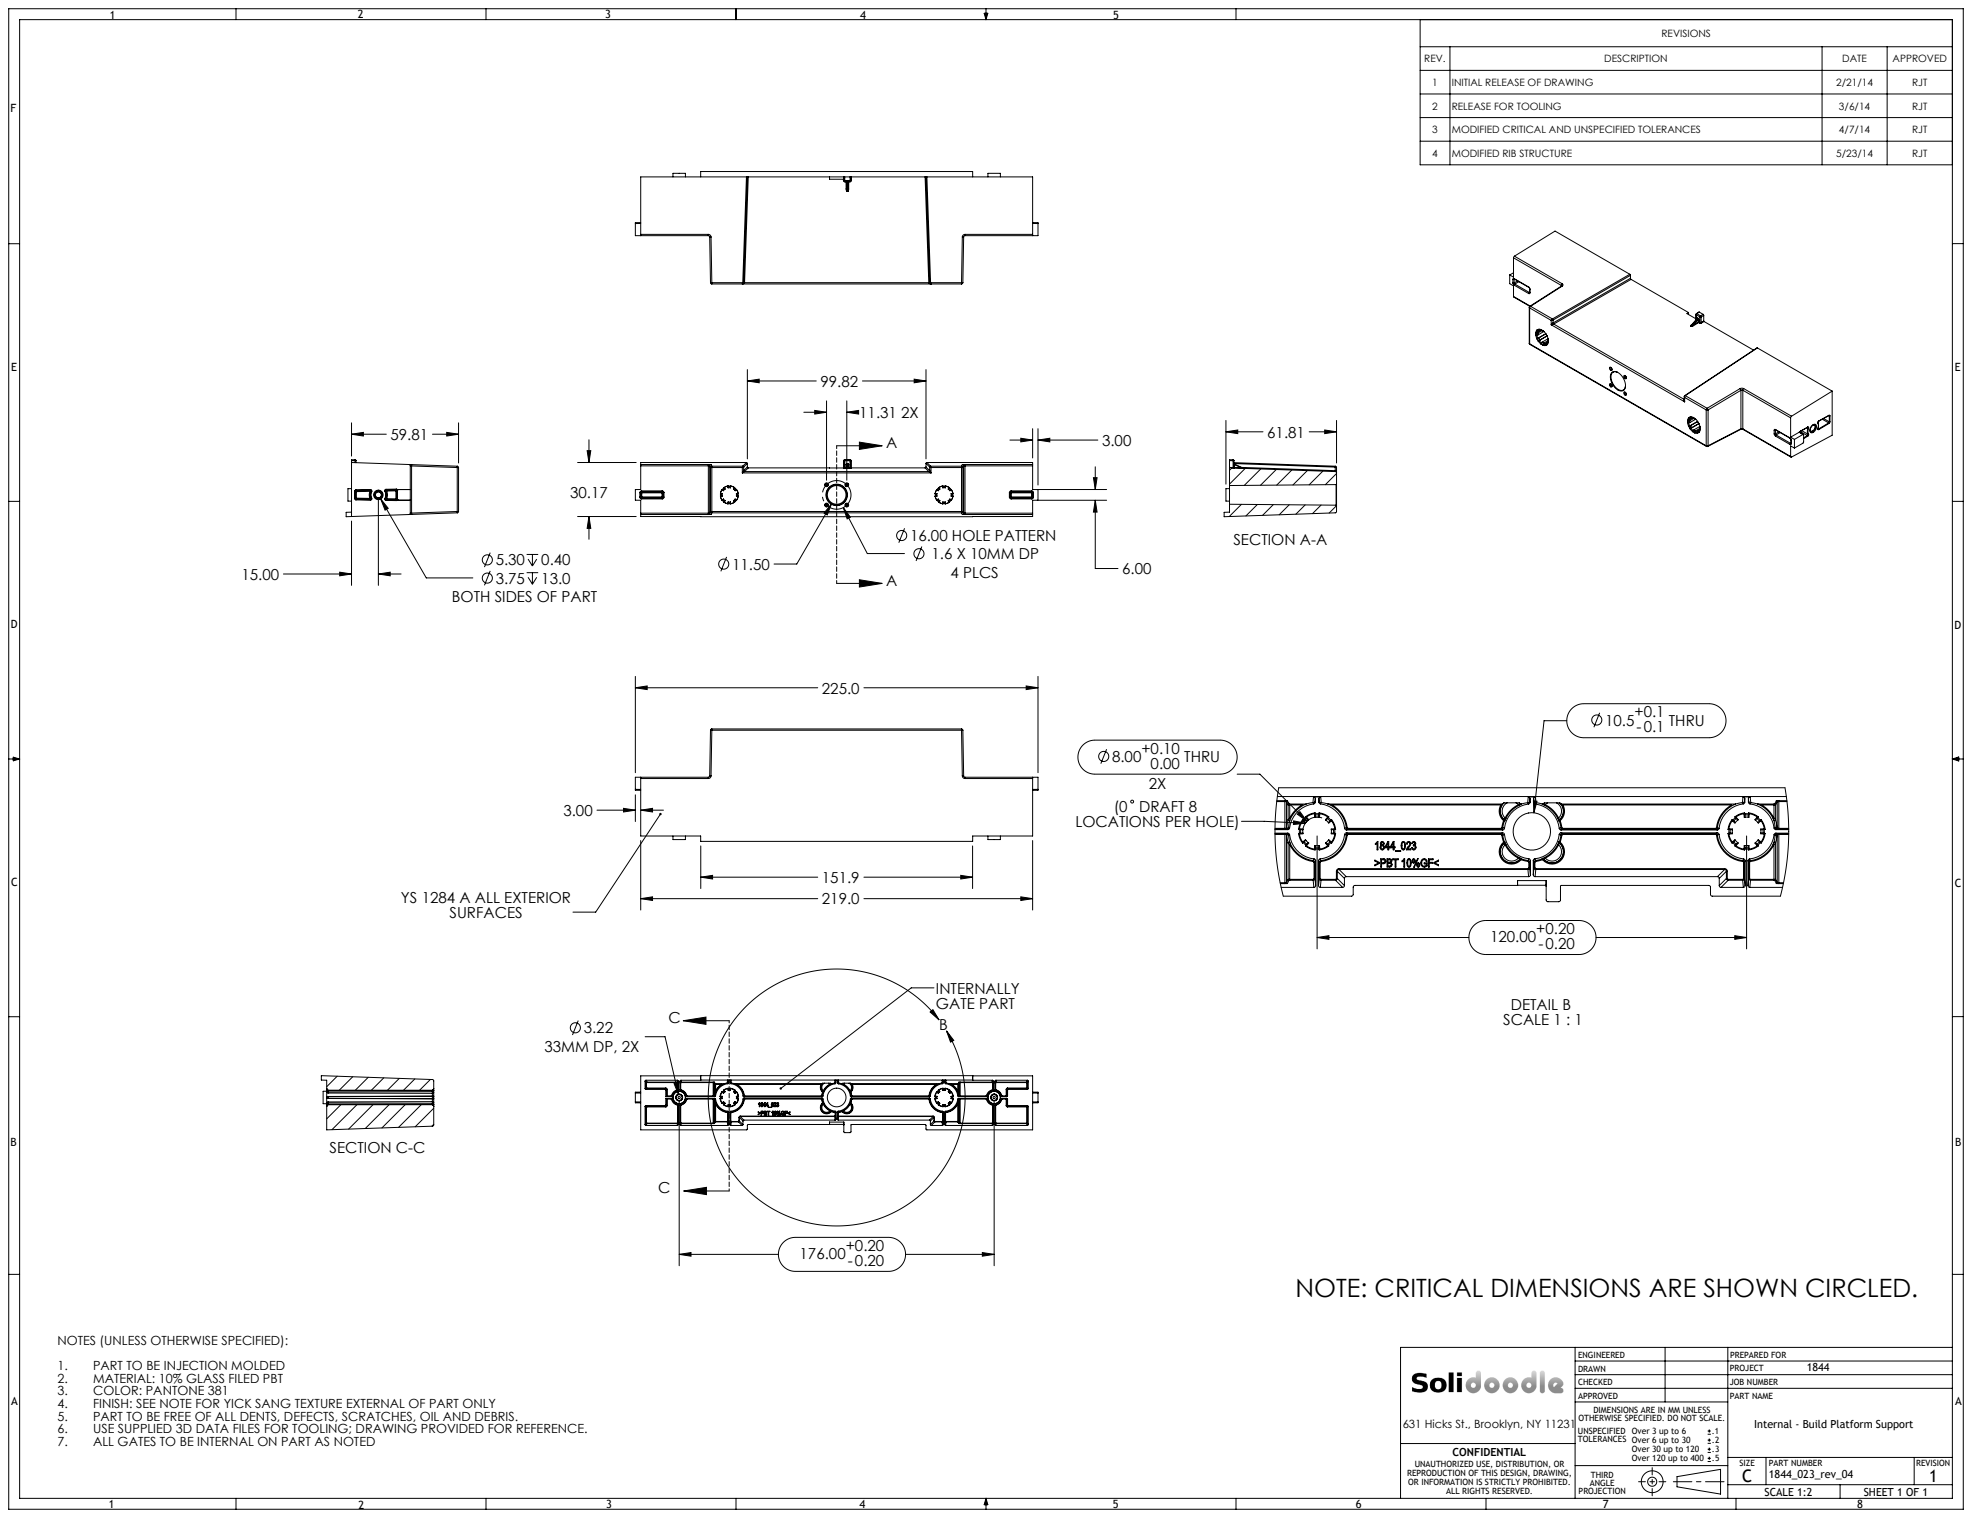
[picture p161: page 1]
16.00 HOLE PATTERN 1.6 X 10MM DP 4 PLCS; GATE PART; 5.30 0.40 3.75 13.0 BOTH SIDES OF PART; SECTION A-A; 0.1 THRU; 0.00 THRU; DETAIL B SCALE 1 : 1; (0 DRAFT 8 LOCATIONS PER HOLE); SECTION C-C; ALL RIGHTS RESERVED.; SCALE 1:2; SHEET 1 OF 1; PREPARED FOR; .5 CONFIDENTIAL; JOB NUMBER; PART NUMBER; PART NAME; 631 Hicks St., Brooklyn, NY 11231; Internal - Build Platform Support

REV. | DESCRIPTION | DATE | APPROVED
1 | INITIAL RELEASE OF DRAWING | 2/21/14 | RJT
2 | RELEASE FOR TOOLING | 3/6/14 | RJT
3 | MODIFIED CRITICAL AND UNSPECIFIED TOLERANCES | 4/7/14 | RJT
4 | MODIFIED RIB STRUCTURE | 5/23/14 | RJT

YS 1284 A ALL EXTERIOR
SURFACES

NOTE: CRITICAL DIMENSIONS ARE SHOWN CIRCLED.

NOTES (UNLESS OTHERWISE SPECIFIED):
1. PART TO BE INJECTION MOLDED
2. MATERIAL: 10% GLASS FILED PBT
3. COLOR: PANTONE 381
4. FINISH: SEE NOTE FOR YICK SANG TEXTURE EXTERNAL OF PART ONLY
5. PART TO BE FREE OF ALL DENTS, DEFECTS, SCRATCHES, OIL AND DEBRIS.
6. USE SUPPLIED 3D DATA FILES FOR TOOLING; DRAWING PROVIDED FOR REFERENCE.
7. ALL GATES TO BE INTERNAL ON PART AS NOTED

ENGINEERED
DRAWN
CHECKED
APPROVED
DIMENSIONS ARE IN MM UNLESS
OTHERWISE SPECIFIED. DO NOT SCALE.
UNSPECIFIED
TOLERANCES

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

UNAUTHORIZED USE, DISTRIBUTION, OR
REPRODUCTION OF THIS DESIGN, DRAWING,
OR INFORMATION IS STRICTLY PROHIBITED.
