SolidoodleDev/Press-Drawings/Press Part Drawings/Drawing Prints (PDF)/1844_031_rev_05.PDF

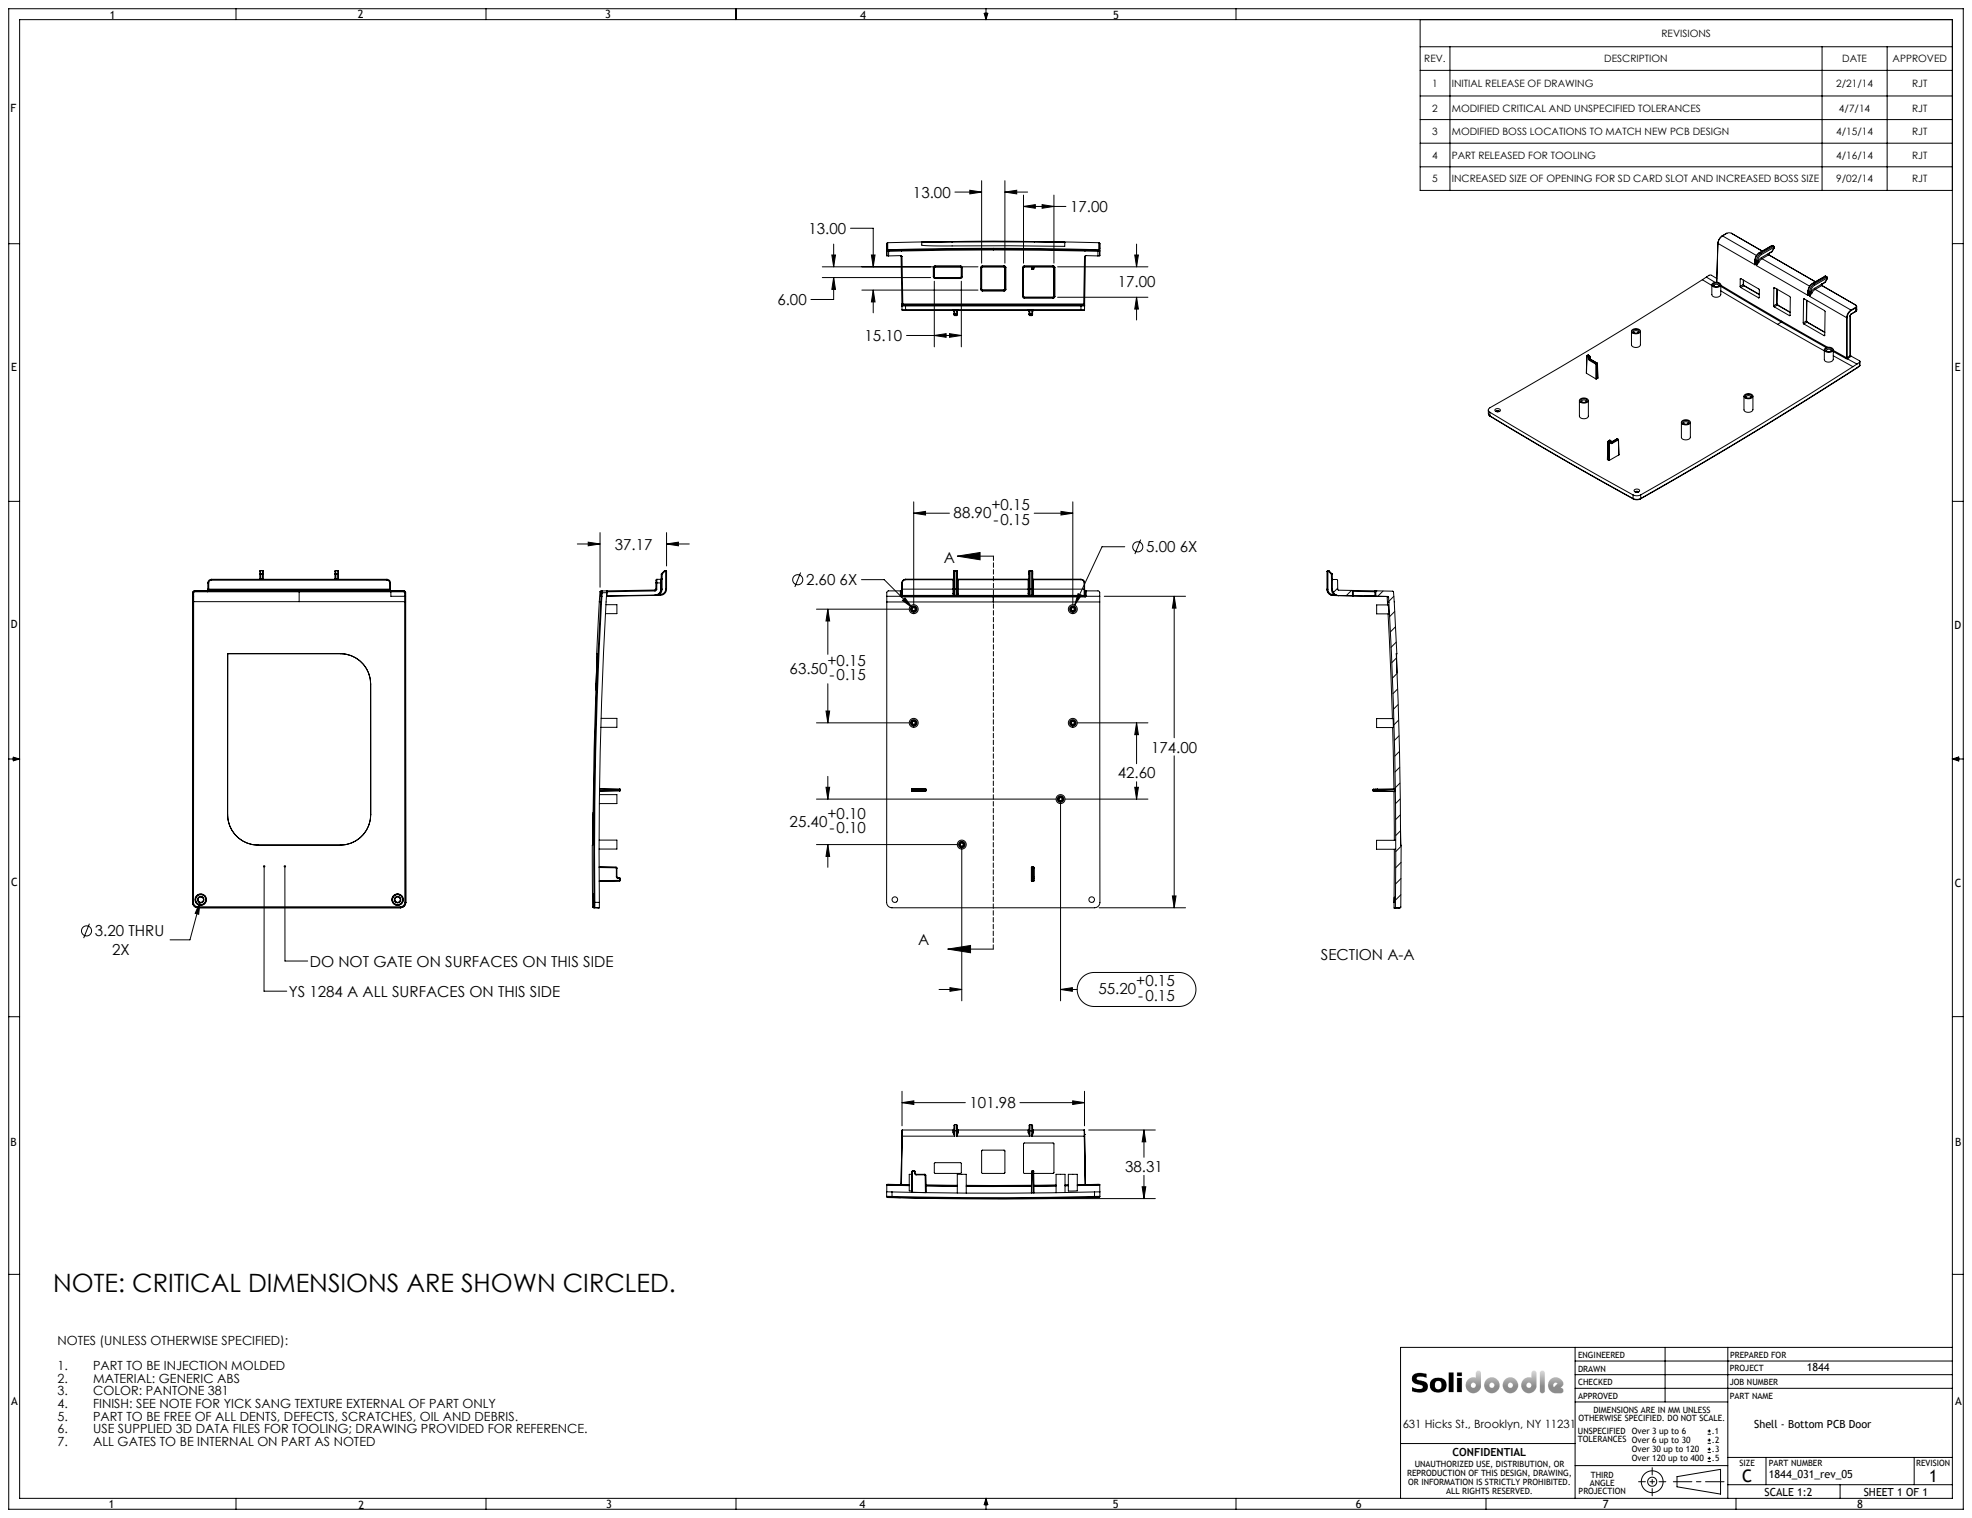
[picture p162: page 1]
SECTION A-A; 3.20 THRU; ALL RIGHTS RESERVED.; SCALE 1:2; SHEET 1 OF 1; PREPARED FOR; .5 CONFIDENTIAL; JOB NUMBER; PART NUMBER; PART NAME; 631 Hicks St., Brooklyn, NY 11231; Shell - Bottom PCB Door

REV. | DESCRIPTION | DATE | APPROVED
1 | INITIAL RELEASE OF DRAWING | 2/21/14 | RJT
2 | MODIFIED CRITICAL AND UNSPECIFIED TOLERANCES | 4/7/14 | RJT
3 | MODIFIED BOSS LOCATIONS TO MATCH NEW PCB DESIGN | 4/15/14 | RJT
4 | PART RELEASED FOR TOOLING | 4/16/14 | RJT
5 | INCREASED SIZE OF OPENING FOR SD CARD SLOT AND INCREASED BOSS SIZE | 9/02/14 | RJT

DO NOT GATE ON SURFACES ON THIS SIDE
YS 1284 A ALL SURFACES ON THIS SIDE

NOTE: CRITICAL DIMENSIONS ARE SHOWN CIRCLED.

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

ENGINEERED
DRAWN
CHECKED
APPROVED
DIMENSIONS ARE IN MM UNLESS
OTHERWISE SPECIFIED. DO NOT SCALE.
UNSPECIFIED
TOLERANCES

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

UNAUTHORIZED USE, DISTRIBUTION, OR
REPRODUCTION OF THIS DESIGN, DRAWING,
OR INFORMATION IS STRICTLY PROHIBITED.
