SolidoodleDev/Press-Drawings/Press Part Drawings/Drawing Prints (PDF)/1844_038_rev_03.PDF

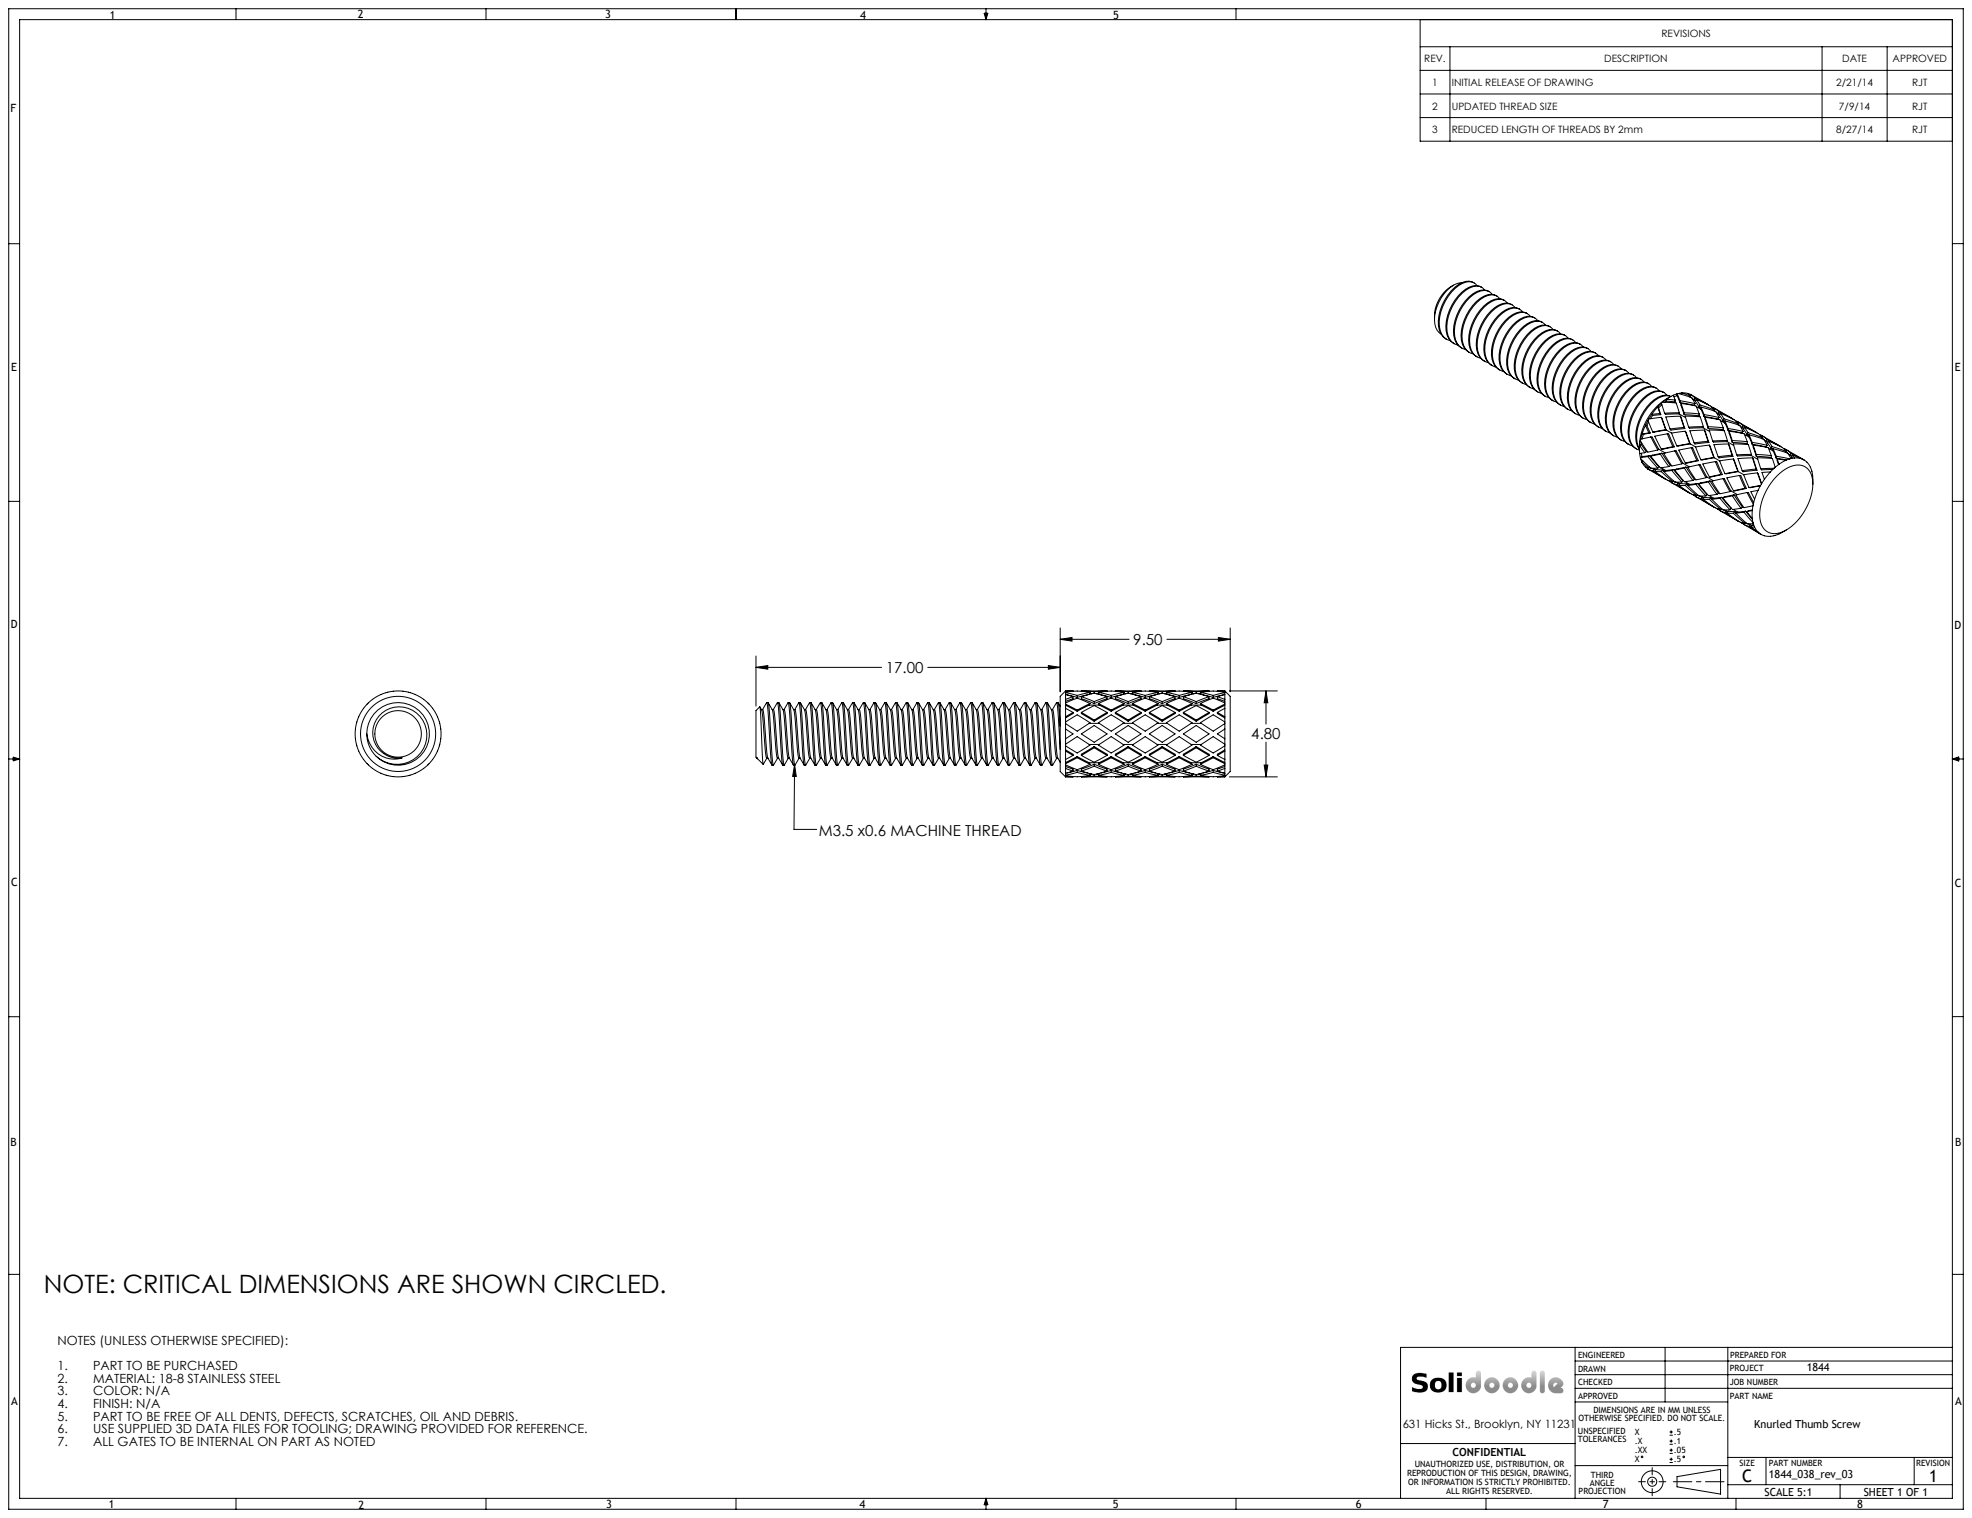
[picture p163: page 1]
M3.5 x0.6 MACHINE THREAD; ALL RIGHTS RESERVED.; SCALE 5:1; SHEET 1 OF 1; PREPARED FOR; JOB NUMBER; PART NUMBER; PART NAME; 631 Hicks St., Brooklyn, NY 11231; Knurled Thumb Screw

REV. | DESCRIPTION | DATE | APPROVED
1 | INITIAL RELEASE OF DRAWING | 2/21/14 | RJT
2 | UPDATED THREAD SIZE | 7/9/14 | RJT
3 | REDUCED LENGTH OF THREADS BY 2mm | 8/27/14 | RJT

NOTE: CRITICAL DIMENSIONS ARE SHOWN CIRCLED.

NOTES (UNLESS OTHERWISE SPECIFIED):
1. PART TO BE PURCHASED
2. MATERIAL: 18-8 STAINLESS STEEL
3. COLOR: N/A
4. FINISH: N/A
5. PART TO BE FREE OF ALL DENTS, DEFECTS, SCRATCHES, OIL AND DEBRIS.
6. USE SUPPLIED 3D DATA FILES FOR TOOLING; DRAWING PROVIDED FOR REFERENCE.
7. ALL GATES TO BE INTERNAL ON PART AS NOTED

ENGINEERED
DRAWN
CHECKED
APPROVED
DIMENSIONS ARE IN MM UNLESS
OTHERWISE SPECIFIED. DO NOT SCALE.
UNSPECIFIED
TOLERANCES

UNAUTHORIZED USE, DISTRIBUTION, OR
REPRODUCTION OF THIS DESIGN, DRAWING,
OR INFORMATION IS STRICTLY PROHIBITED.
