SolidoodleDev/Press-Drawings/Press Part Drawings/Drawing Prints (PDF)/1844_039_rev_03.PDF

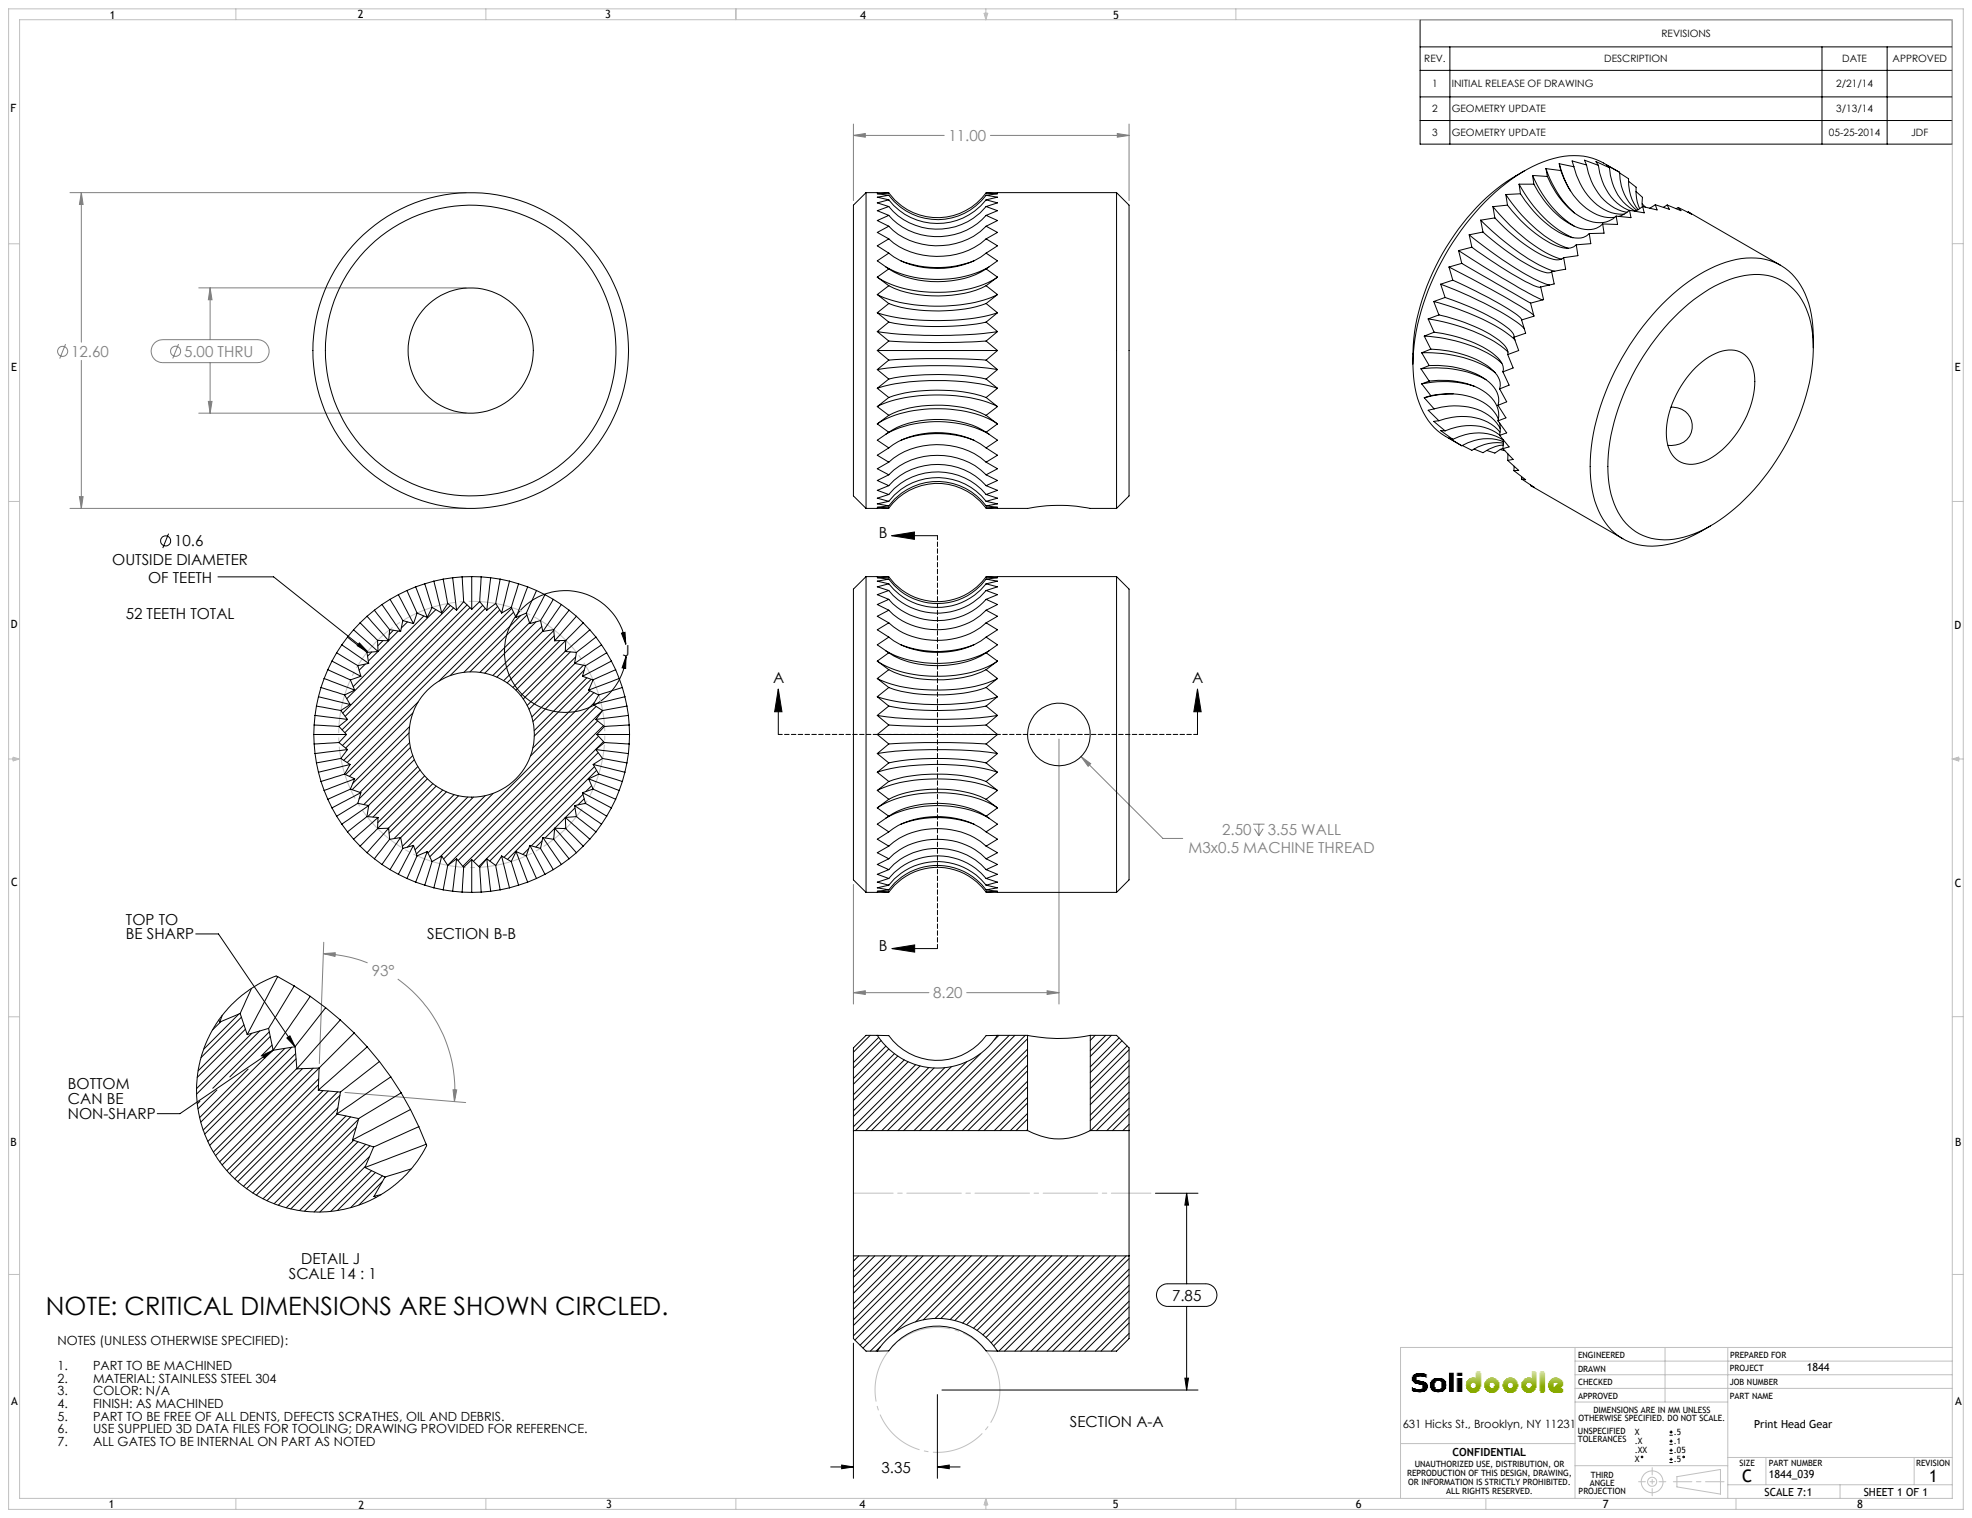
[picture p164: page 1]
5.00 THRU; 2.50 3.55 WALL M3x0.5 MACHINE THREAD; SECTION A-A; OUTSIDE DIAMETER OF TEETH; 52 TEETH TOTAL; SECTION B-B; DETAIL J SCALE 14 : 1; TOP TO BE SHARP; CAN BE; ALL RIGHTS RESERVED.; SCALE 7:1; SHEET 1 OF 1; PREPARED FOR; JOB NUMBER; PART NUMBER; PART NAME; 631 Hicks St., Brooklyn, NY 11231; Print Head Gear

REV. | DESCRIPTION | DATE | APPROVED
1 | INITIAL RELEASE OF DRAWING | 2/21/14
2 | GEOMETRY UPDATE | 3/13/14
3 | GEOMETRY UPDATE | 05-25-2014 | JDF

NOTE: CRITICAL DIMENSIONS ARE SHOWN CIRCLED.

NOTES (UNLESS OTHERWISE SPECIFIED):
1. PART TO BE MACHINED
2. MATERIAL: STAINLESS STEEL 304
3. COLOR: N/A
4. FINISH: AS MACHINED
5. PART TO BE FREE OF ALL DENTS, DEFECTS SCRATHES, OIL AND DEBRIS.
6. USE SUPPLIED 3D DATA FILES FOR TOOLING; DRAWING PROVIDED FOR REFERENCE.
7. ALL GATES TO BE INTERNAL ON PART AS NOTED

ENGINEERED
DRAWN
CHECKED
APPROVED
DIMENSIONS ARE IN MM UNLESS
OTHERWISE SPECIFIED. DO NOT SCALE.
UNSPECIFIED
TOLERANCES

UNAUTHORIZED USE, DISTRIBUTION, OR
REPRODUCTION OF THIS DESIGN, DRAWING,
OR INFORMATION IS STRICTLY PROHIBITED.
