SolidoodleDev/Press-Drawings/Press Part Drawings/Drawing Prints (PDF)/1844_041_rev_09.PDF

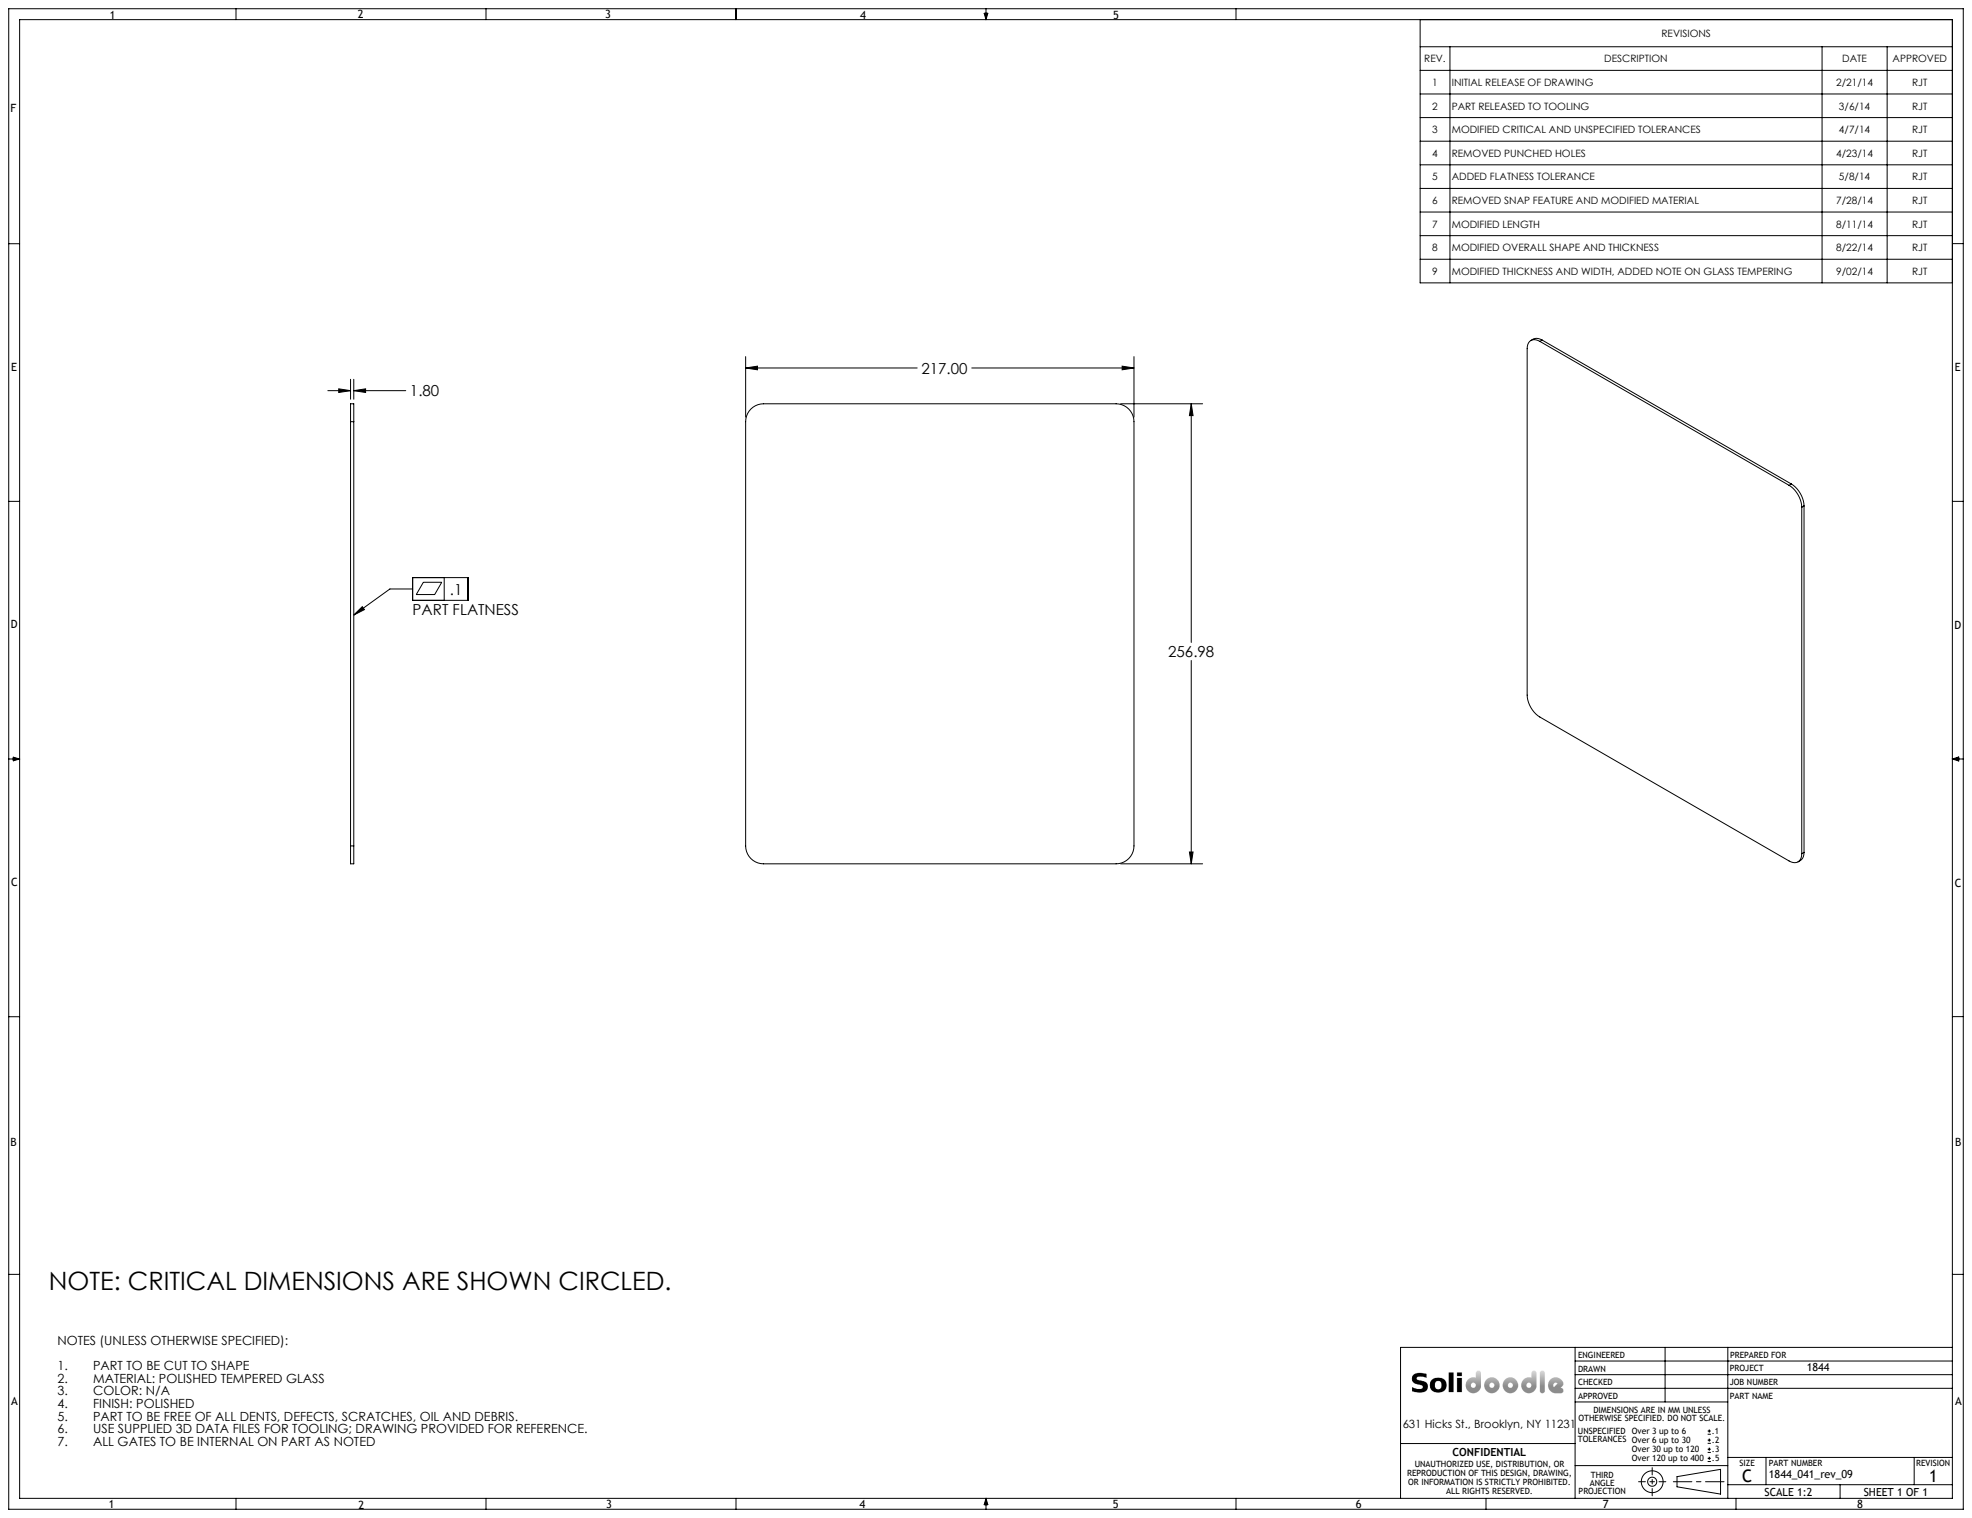
[picture p165: page 1]
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

REV. | DESCRIPTION | DATE | APPROVED
1 | INITIAL RELEASE OF DRAWING | 2/21/14 | RJT
2 | PART RELEASED TO TOOLING | 3/6/14 | RJT
3 | MODIFIED CRITICAL AND UNSPECIFIED TOLERANCES | 4/7/14 | RJT
4 | REMOVED PUNCHED HOLES | 4/23/14 | RJT
5 | ADDED FLATNESS TOLERANCE | 5/8/14 | RJT
6 | REMOVED SNAP FEATURE AND MODIFIED MATERIAL | 7/28/14 | RJT
7 | MODIFIED LENGTH | 8/11/14 | RJT
8 | MODIFIED OVERALL SHAPE AND THICKNESS | 8/22/14 | RJT
9 | MODIFIED THICKNESS AND WIDTH, ADDED NOTE ON GLASS TEMPERING | 9/02/14 | RJT

NOTE: CRITICAL DIMENSIONS ARE SHOWN CIRCLED.

NOTES (UNLESS OTHERWISE SPECIFIED):
1. PART TO BE CUT TO SHAPE
2. MATERIAL: POLISHED TEMPERED GLASS
3. COLOR: N/A
4. FINISH: POLISHED
5. PART TO BE FREE OF ALL DENTS, DEFECTS, SCRATCHES, OIL AND DEBRIS.
6. USE SUPPLIED 3D DATA FILES FOR TOOLING; DRAWING PROVIDED FOR REFERENCE.
7. ALL GATES TO BE INTERNAL ON PART AS NOTED

ENGINEERED
DRAWN
CHECKED
APPROVED
DIMENSIONS ARE IN MM UNLESS
OTHERWISE SPECIFIED. DO NOT SCALE.
UNSPECIFIED
TOLERANCES

631 Hicks St., Brooklyn, NY 11231

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

UNAUTHORIZED USE, DISTRIBUTION, OR
REPRODUCTION OF THIS DESIGN, DRAWING,
OR INFORMATION IS STRICTLY PROHIBITED.
