SolidoodleDev/Press-Drawings/Press Part Drawings/Drawing Prints (PDF)/1844_061.PDF

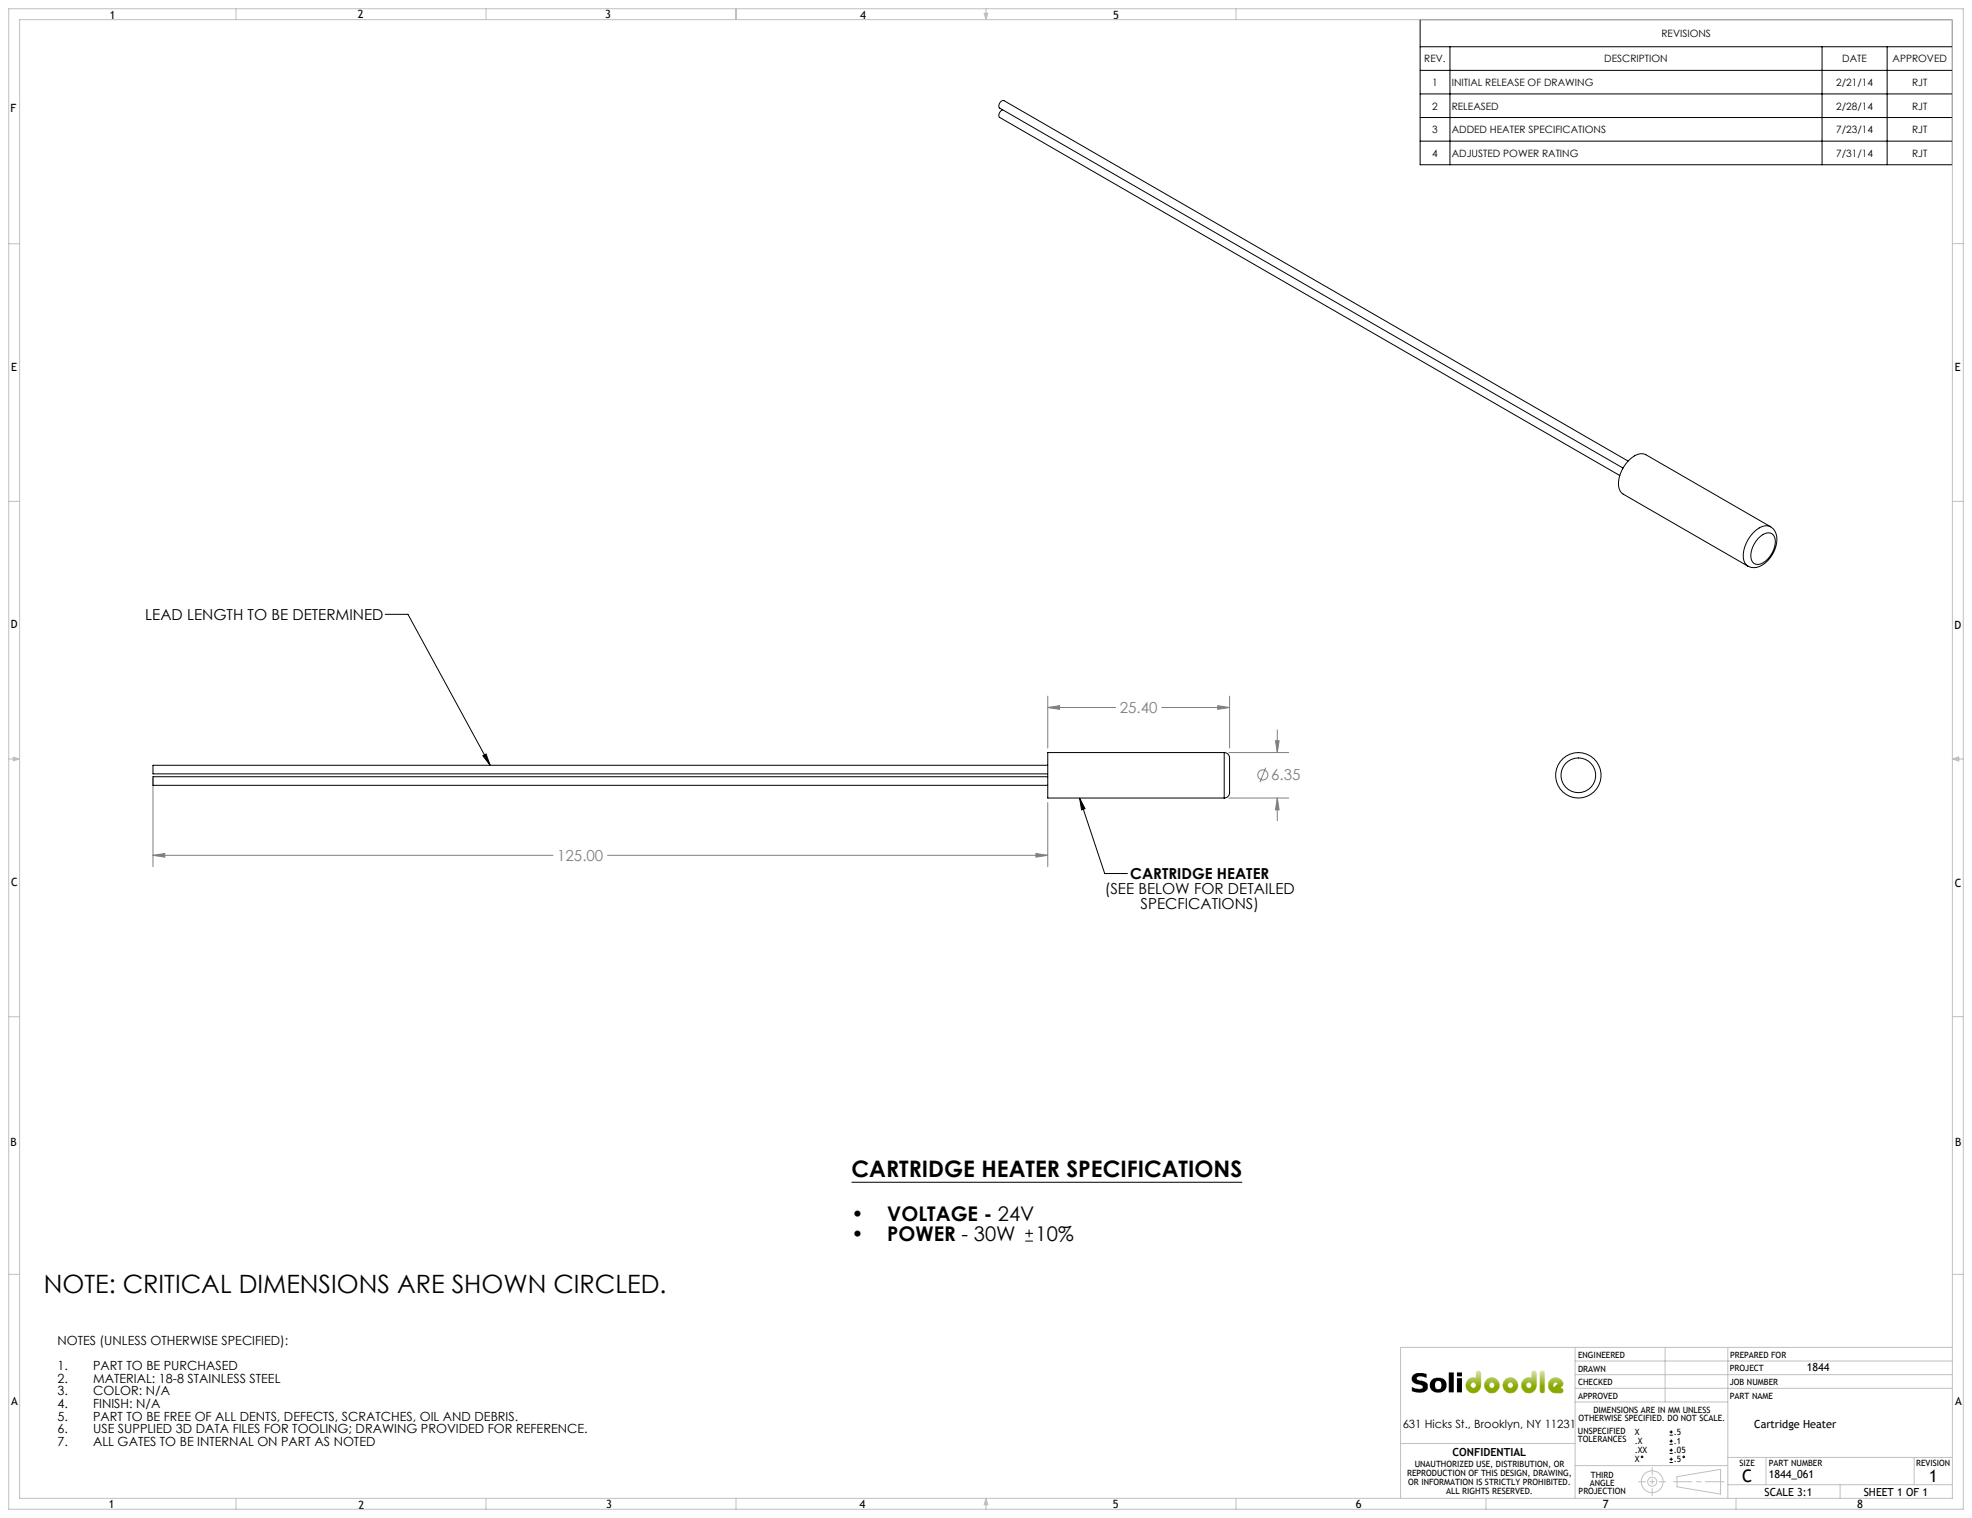
[picture p166: page 1]
• POWER - 30W; ALL RIGHTS RESERVED.; SCALE 3:1; SHEET 1 OF 1; PREPARED FOR; JOB NUMBER; PART NUMBER; PART NAME; 631 Hicks St., Brooklyn, NY 11231; Cartridge Heater

REV. | DESCRIPTION | DATE | APPROVED
1 | INITIAL RELEASE OF DRAWING | 2/21/14 | RJT
2 | RELEASED | 2/28/14 | RJT
3 | ADDED HEATER SPECIFICATIONS | 7/23/14 | RJT
4 | ADJUSTED POWER RATING | 7/31/14 | RJT

LEAD LENGTH TO BE DETERMINED

CARTRIDGE HEATER
(SEE BELOW FOR DETAILED
SPECFICATIONS)

CARTRIDGE HEATER SPECIFICATIONS
• VOLTAGE - 24V

NOTE: CRITICAL DIMENSIONS ARE SHOWN CIRCLED.

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

ENGINEERED
DRAWN
CHECKED
APPROVED
DIMENSIONS ARE IN MM UNLESS
OTHERWISE SPECIFIED. DO NOT SCALE.
UNSPECIFIED
TOLERANCES

UNAUTHORIZED USE, DISTRIBUTION, OR
REPRODUCTION OF THIS DESIGN, DRAWING,
OR INFORMATION IS STRICTLY PROHIBITED.
