SolidoodleDev/Press-Drawings/Press Part Drawings/Drawing Prints (PDF)/1844_064.PDF

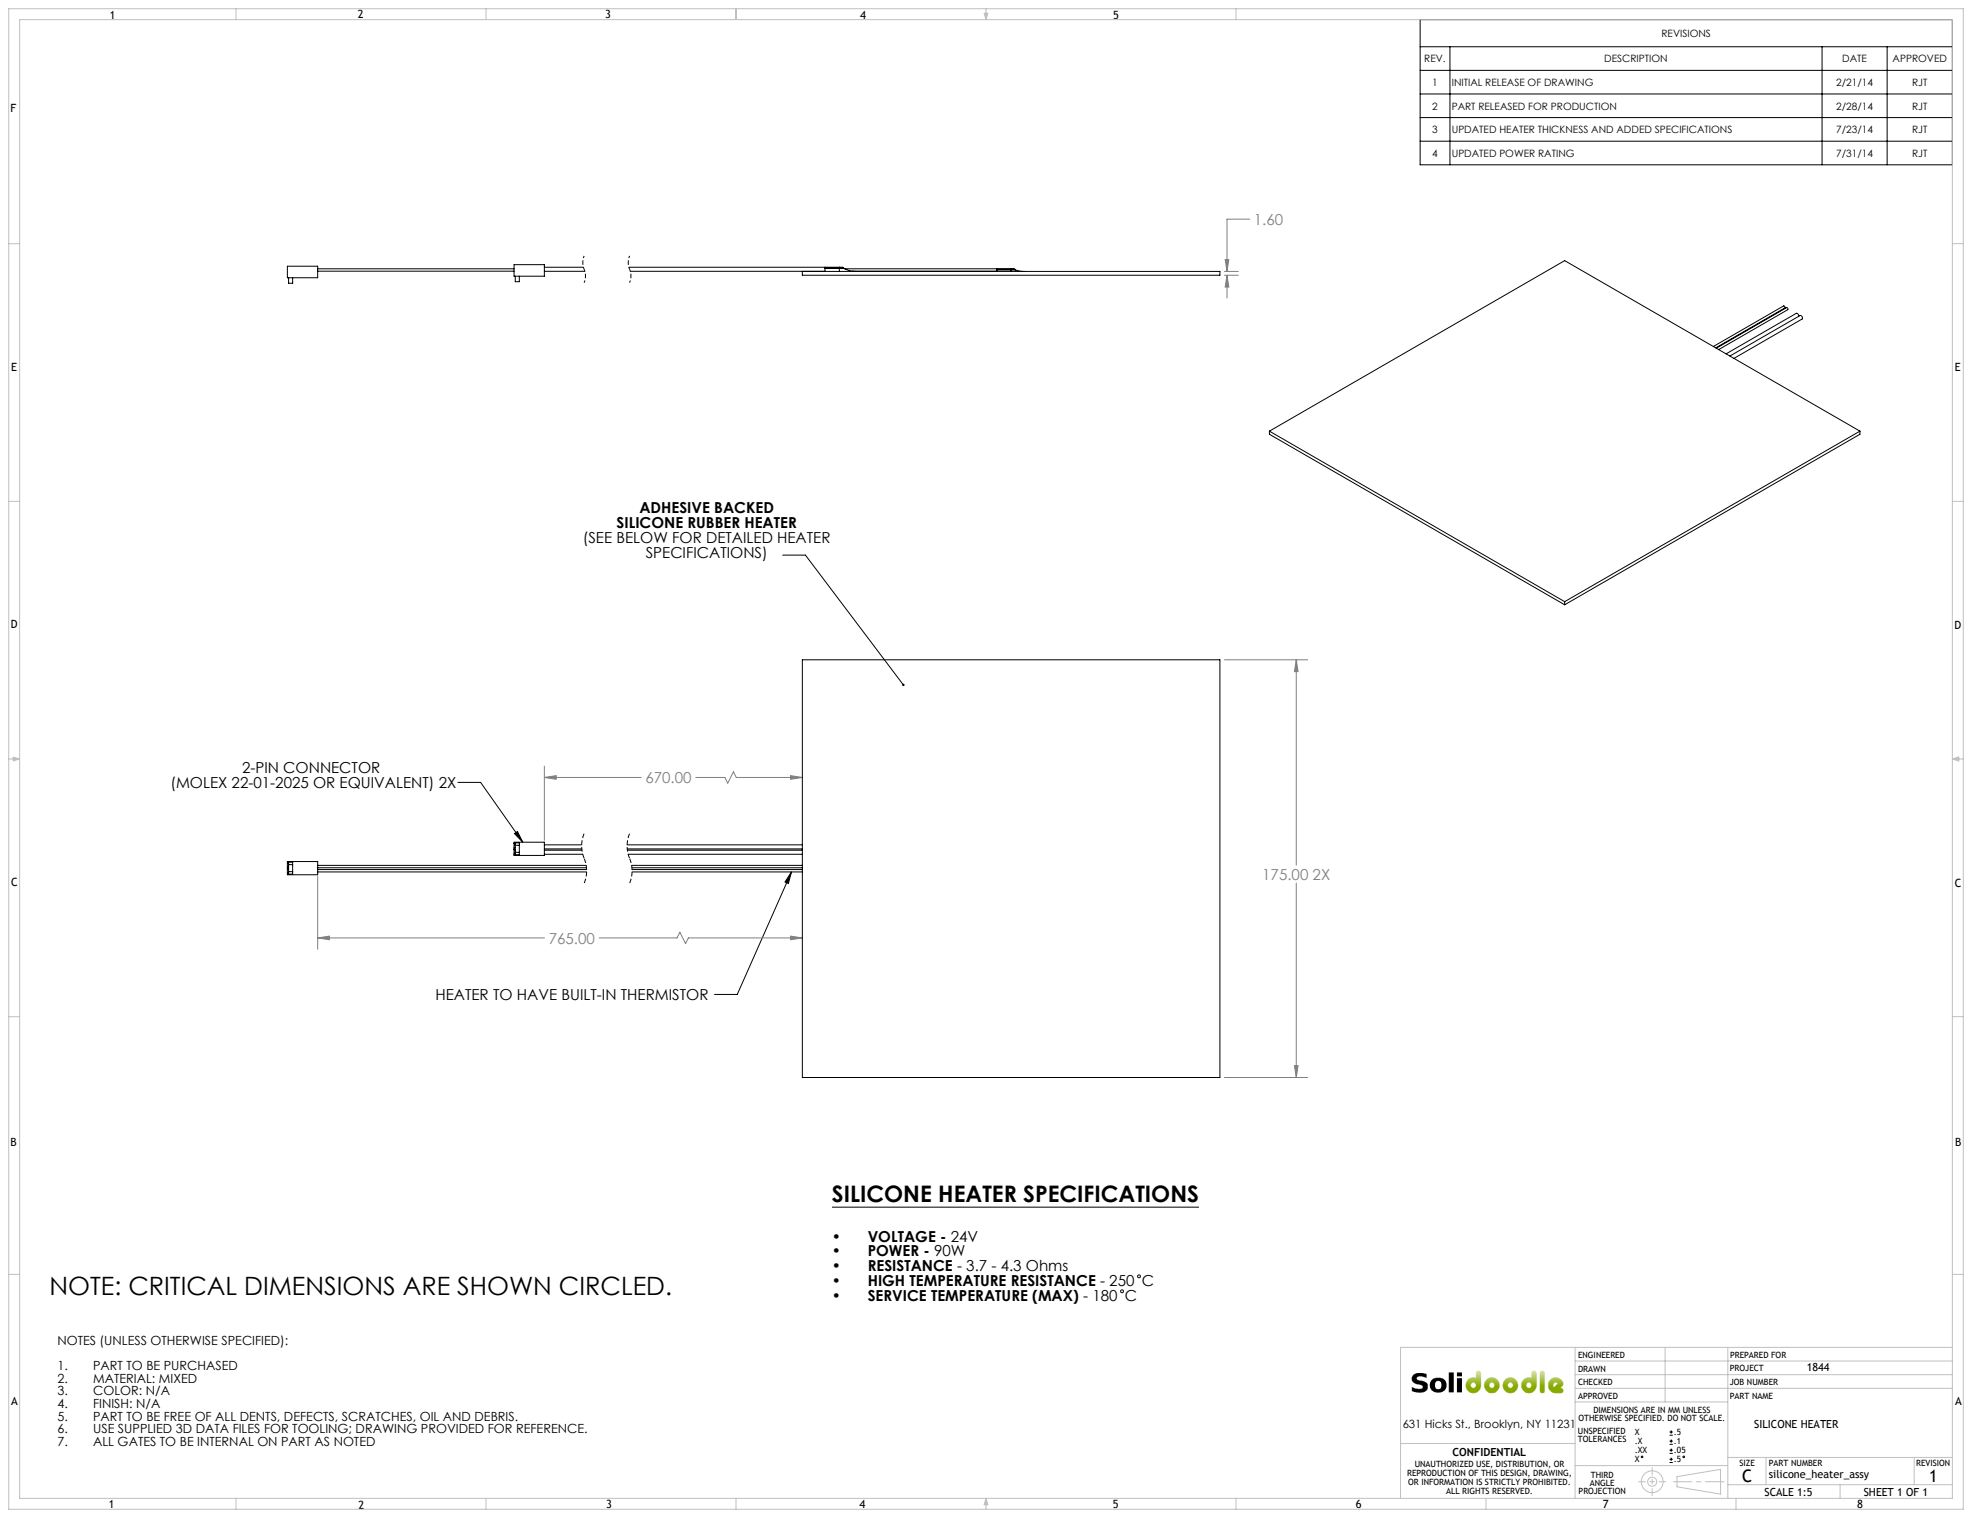
[picture p167: page 1]
2-PIN CONNECTOR; VOLTAGE - 24V •; POWER - 90W •; RESISTANCE - 3.7 - 4.3 Ohms •; HIGH TEMPERATURE RESISTANCE - 250 C •; SERVICE TEMPERATURE (MAX) - 180 C; ALL RIGHTS RESERVED.; SCALE 1:5; SHEET 1 OF 1; PREPARED FOR; JOB NUMBER; PART NUMBER; PART NAME; 631 Hicks St., Brooklyn, NY 11231; SILICONE HEATER

REV. | DESCRIPTION | DATE | APPROVED
1 | INITIAL RELEASE OF DRAWING | 2/21/14 | RJT
2 | PART RELEASED FOR PRODUCTION | 2/28/14 | RJT
3 | UPDATED HEATER THICKNESS AND ADDED SPECIFICATIONS | 7/23/14 | RJT
4 | UPDATED POWER RATING | 7/31/14 | RJT

ADHESIVE BACKED
SILICONE RUBBER HEATER
(SEE BELOW FOR DETAILED HEATER

(MOLEX 22-01-2025 OR EQUIVALENT) 2X

HEATER TO HAVE BUILT-IN THERMISTOR

SILICONE HEATER SPECIFICATIONS

NOTE: CRITICAL DIMENSIONS ARE SHOWN CIRCLED.

NOTES (UNLESS OTHERWISE SPECIFIED):
1. PART TO BE PURCHASED
2. MATERIAL: MIXED
3. COLOR: N/A
4. FINISH: N/A
5. PART TO BE FREE OF ALL DENTS, DEFECTS, SCRATCHES, OIL AND DEBRIS.
6. USE SUPPLIED 3D DATA FILES FOR TOOLING; DRAWING PROVIDED FOR REFERENCE.
7. ALL GATES TO BE INTERNAL ON PART AS NOTED

ENGINEERED
DRAWN
CHECKED
APPROVED
DIMENSIONS ARE IN MM UNLESS
OTHERWISE SPECIFIED. DO NOT SCALE.
UNSPECIFIED
TOLERANCES

UNAUTHORIZED USE, DISTRIBUTION, OR
REPRODUCTION OF THIS DESIGN, DRAWING,
OR INFORMATION IS STRICTLY PROHIBITED.
