SolidoodleDev/Press-Drawings/Press Part Drawings/Drawing Prints (PDF)/1844_Rods_rev_03.PDF

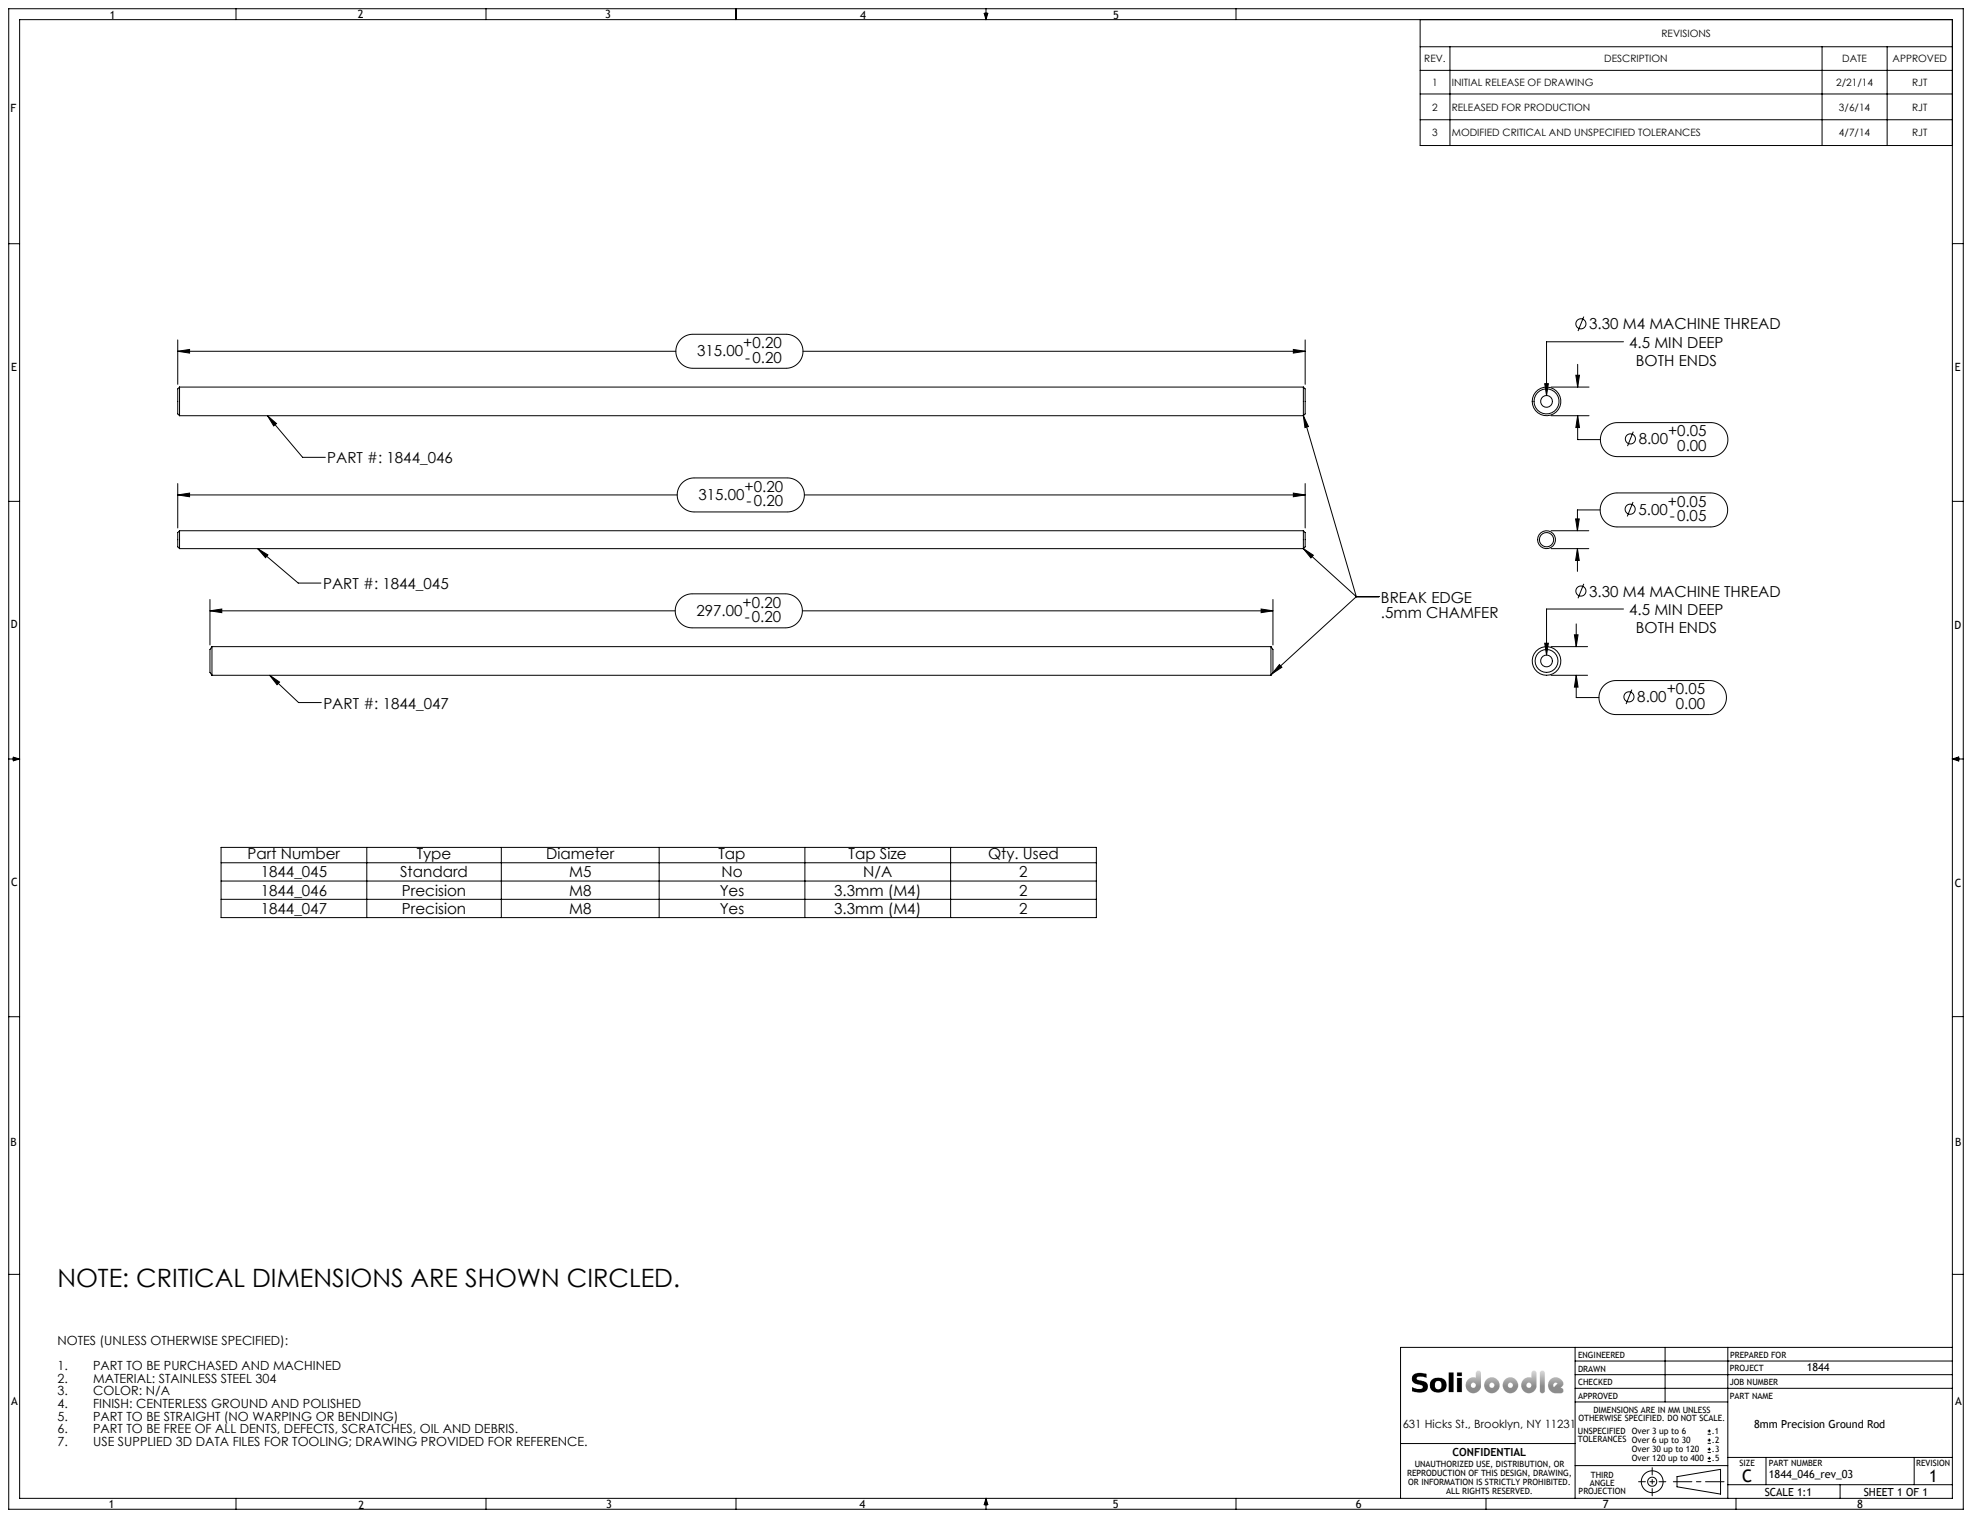
[picture p168: page 1]
PART #: 1844_046; PART #: 1844_045; 3.30 M4 MACHINE THREAD 4.5 MIN DEEP BOTH ENDS; PART #: 1844_047; BREAK EDGE .5mm CHAMFER; ALL RIGHTS RESERVED.; SCALE 1:1; SHEET 1 OF 1; PREPARED FOR; .5 CONFIDENTIAL; JOB NUMBER; PART NUMBER; PART NAME; 631 Hicks St., Brooklyn, NY 11231; 8mm Precision Ground Rod

REV. | DESCRIPTION | DATE | APPROVED
1 | INITIAL RELEASE OF DRAWING | 2/21/14 | RJT
2 | RELEASED FOR PRODUCTION | 3/6/14 | RJT
3 | MODIFIED CRITICAL AND UNSPECIFIED TOLERANCES | 4/7/14 | RJT

Part Number | Type | Diameter | Tap | Tap Size | Qty. Used
1844_045 | Standard | M5 | No | N/A | 2
1844_046 | Precision | M8 | Yes | 3.3mm (M4) | 2
1844_047 | Precision | M8 | Yes | 3.3mm (M4) | 2

NOTE: CRITICAL DIMENSIONS ARE SHOWN CIRCLED.

NOTES (UNLESS OTHERWISE SPECIFIED):
1. PART TO BE PURCHASED AND MACHINED
2. MATERIAL: STAINLESS STEEL 304
3. COLOR: N/A
4. FINISH: CENTERLESS GROUND AND POLISHED
5. PART TO BE STRAIGHT (NO WARPING OR BENDING)
6. PART TO BE FREE OF ALL DENTS, DEFECTS, SCRATCHES, OIL AND DEBRIS.
7. USE SUPPLIED 3D DATA FILES FOR TOOLING; DRAWING PROVIDED FOR REFERENCE.

ENGINEERED
DRAWN
CHECKED
APPROVED
DIMENSIONS ARE IN MM UNLESS
OTHERWISE SPECIFIED. DO NOT SCALE.
UNSPECIFIED
TOLERANCES

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

UNAUTHORIZED USE, DISTRIBUTION, OR
REPRODUCTION OF THIS DESIGN, DRAWING,
OR INFORMATION IS STRICTLY PROHIBITED.
