SolidoodleDev/Press-Drawings/Press Part Drawings/Drawing Prints (PDF)/Gantry_Body_Wiring.PDF

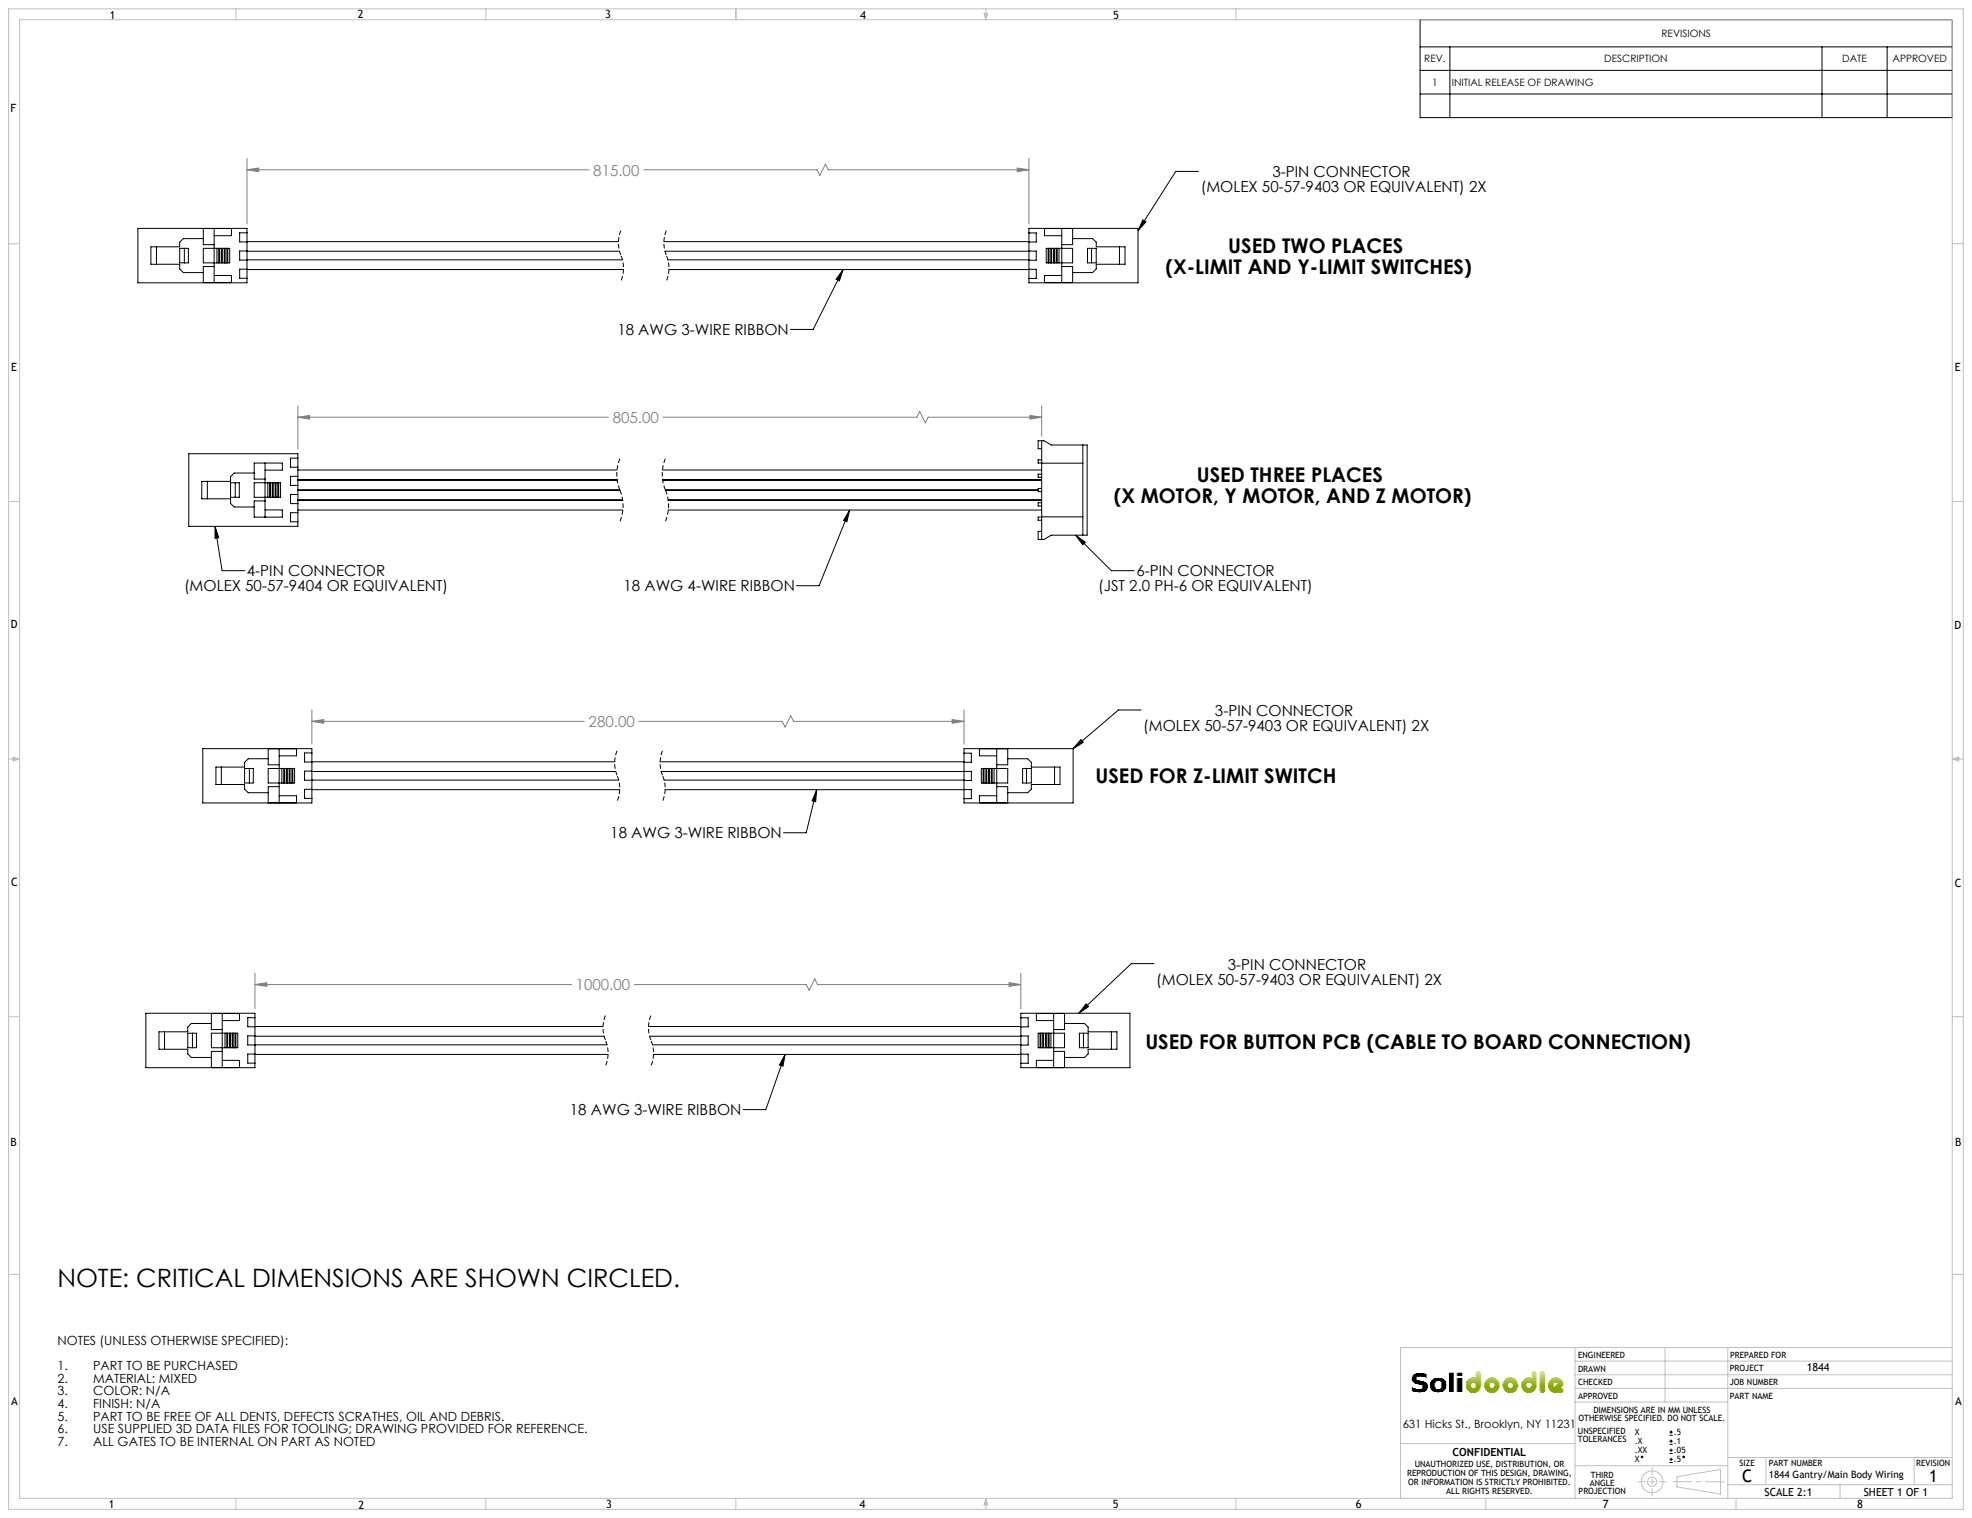
[picture p169: page 1]
4-PIN CONNECTOR; (MOLEX 50-57-9404 OR EQUIVALENT); 18 AWG 4-WIRE RIBBON; 3-PIN CONNECTOR; ALL RIGHTS RESERVED.; SCALE 2:1; SHEET 1 OF 1; PREPARED FOR; JOB NUMBER PART NAME

REV. | DESCRIPTION | DATE | APPROVED
1 | INITIAL RELEASE OF DRAWING

(MOLEX 50-57-9403 OR EQUIVALENT) 2X
USED TWO PLACES
(X-LIMIT AND Y-LIMIT SWITCHES)

18 AWG 3-WIRE RIBBON

USED THREE PLACES
(X MOTOR, Y MOTOR, AND Z MOTOR)

6-PIN CONNECTOR
(JST 2.0 PH-6 OR EQUIVALENT)

USED FOR Z-LIMIT SWITCH

USED FOR BUTTON PCB (CABLE TO BOARD CONNECTION)

NOTE: CRITICAL DIMENSIONS ARE SHOWN CIRCLED.

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

ENGINEERED
DRAWN
CHECKED
APPROVED
DIMENSIONS ARE IN MM UNLESS
OTHERWISE SPECIFIED. DO NOT SCALE.
UNSPECIFIED
TOLERANCES

631 Hicks St., Brooklyn, NY 11231

UNAUTHORIZED USE, DISTRIBUTION, OR
REPRODUCTION OF THIS DESIGN, DRAWING,
OR INFORMATION IS STRICTLY PROHIBITED.

SIZE
PART NUMBER
1844 Gantry/Main Body Wiring
