SolidoodleDev/Press-Drawings/Press Part Drawings/Drawing Prints (PDF)/power_adapter.PDF

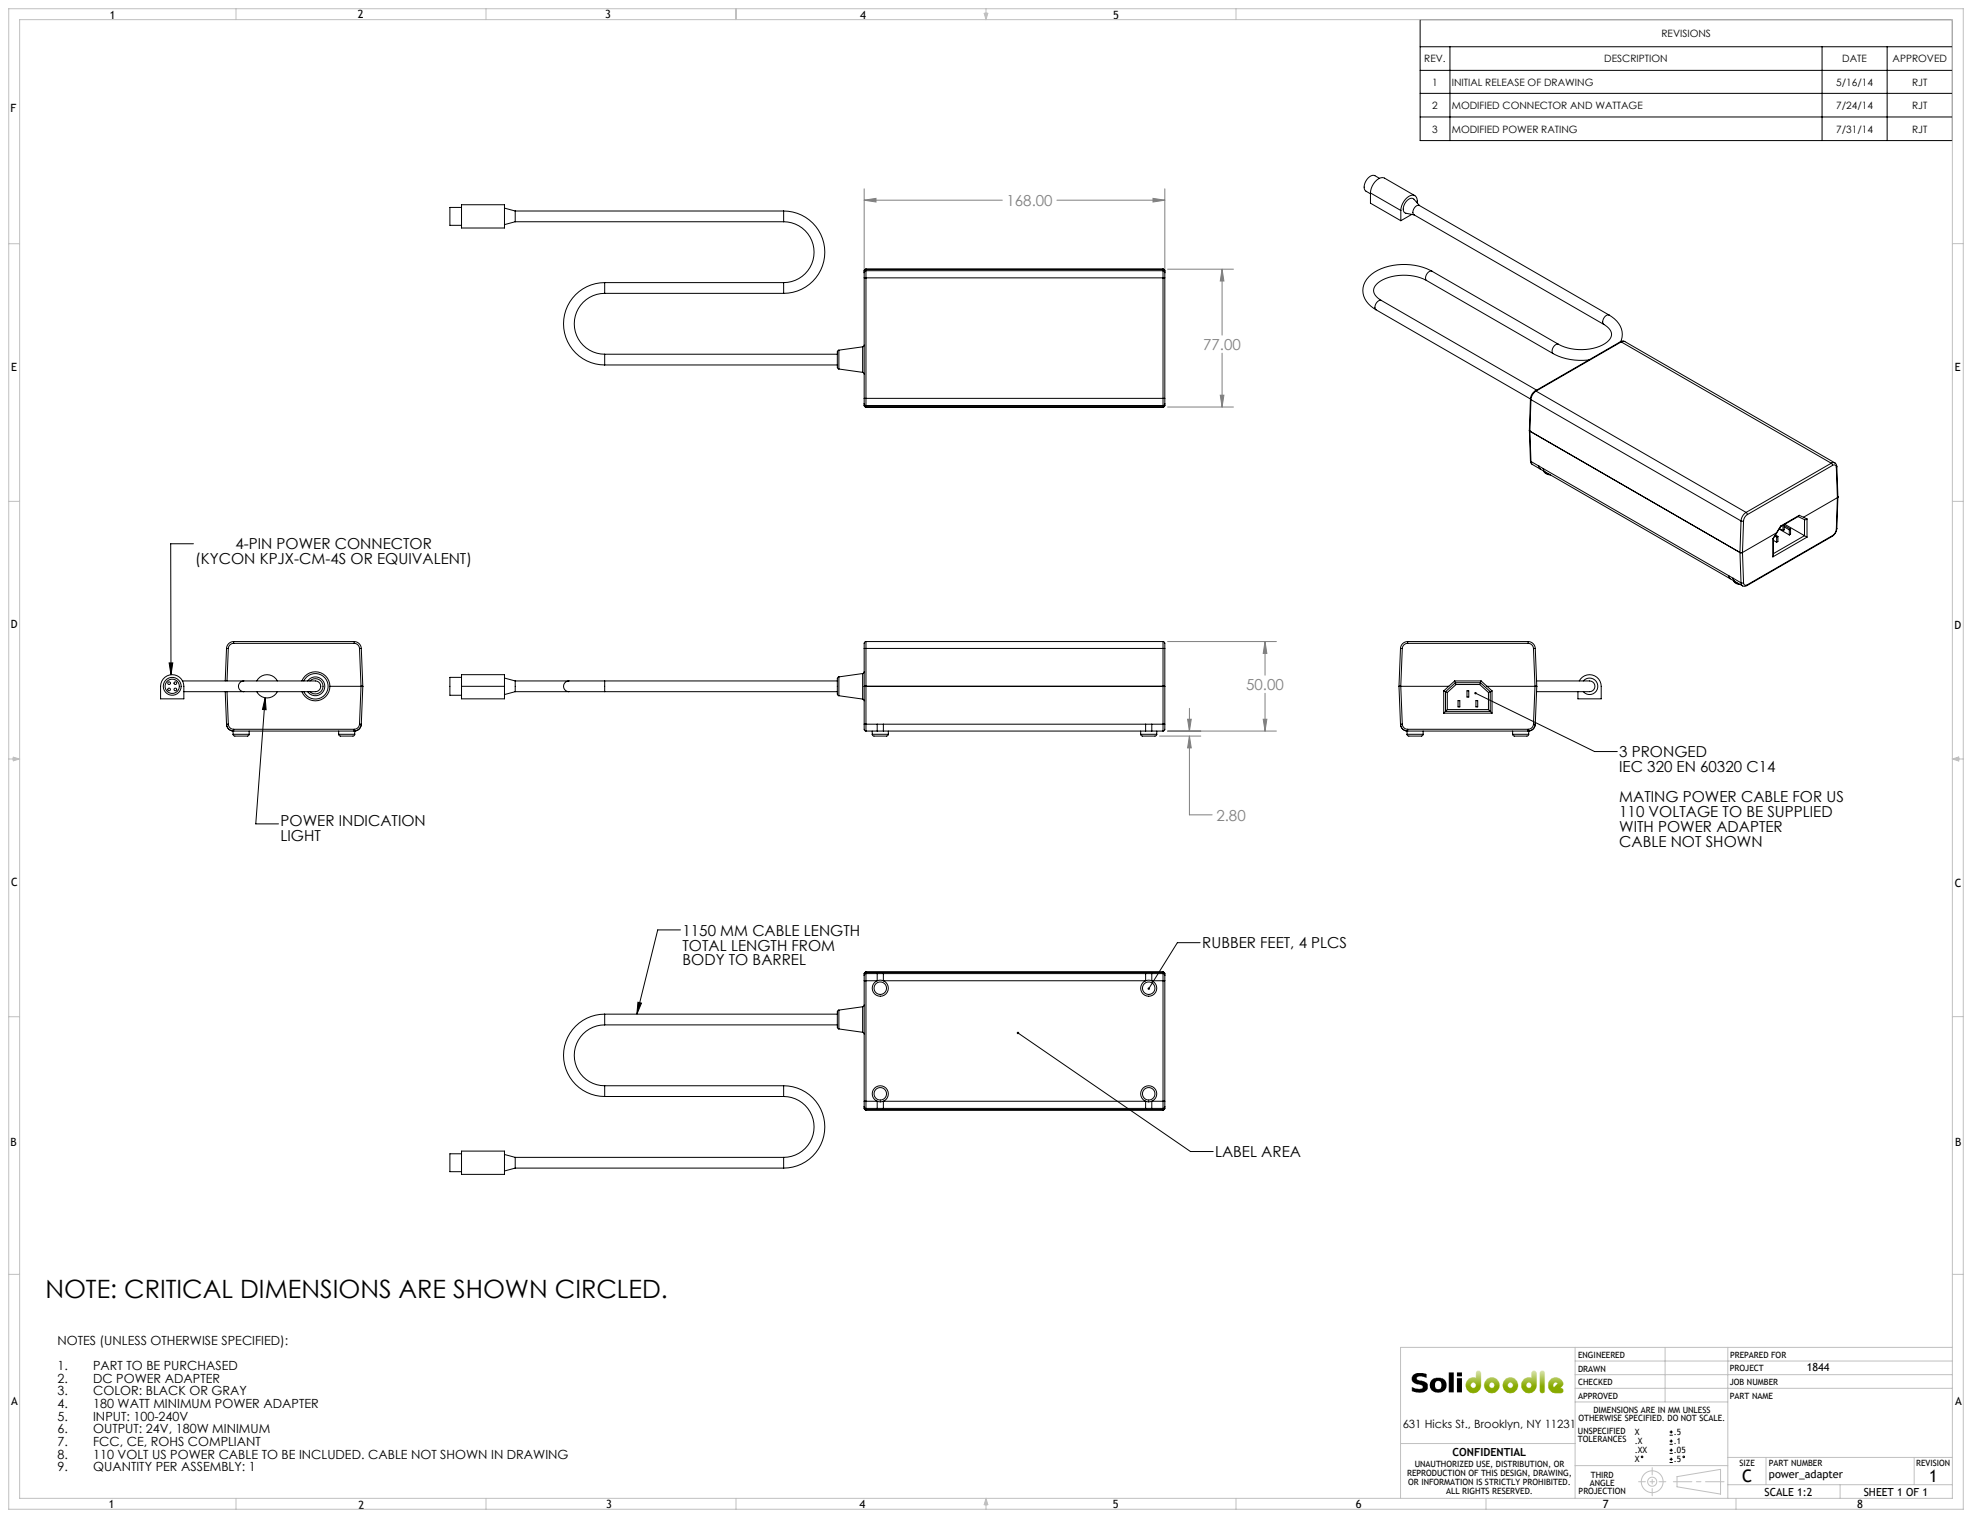
[picture p170: page 1]
2.80 POWER INDICATION; LABEL AREA; ALL RIGHTS RESERVED.; SCALE 1:2; SHEET 1 OF 1; PREPARED FOR; JOB NUMBER; PART NUMBER; PART NAME

REV. | DESCRIPTION | DATE | APPROVED
1 | INITIAL RELEASE OF DRAWING | 5/16/14 | RJT
2 | MODIFIED CONNECTOR AND WATTAGE | 7/24/14 | RJT
3 | MODIFIED POWER RATING | 7/31/14 | RJT

4-PIN POWER CONNECTOR
(KYCON KPJX-CM-4S OR EQUIVALENT)

3 PRONGED
IEC 320 EN 60320 C14
MATING POWER CABLE FOR US
110 VOLTAGE TO BE SUPPLIED
WITH POWER ADAPTER
CABLE NOT SHOWN

1150 MM CABLE LENGTH
TOTAL LENGTH FROM
BODY TO BARREL

RUBBER FEET, 4 PLCS

NOTE: CRITICAL DIMENSIONS ARE SHOWN CIRCLED.

NOTES (UNLESS OTHERWISE SPECIFIED):
1. PART TO BE PURCHASED
2. DC POWER ADAPTER
3. COLOR: BLACK OR GRAY
4. 180 WATT MINIMUM POWER ADAPTER
5. INPUT: 100-240V
6. OUTPUT: 24V, 180W MINIMUM
7. FCC, CE, ROHS COMPLIANT
8. 110 VOLT US POWER CABLE TO BE INCLUDED. CABLE NOT SHOWN IN DRAWING
9. QUANTITY PER ASSEMBLY: 1

ENGINEERED
DRAWN
CHECKED
APPROVED
DIMENSIONS ARE IN MM UNLESS
OTHERWISE SPECIFIED. DO NOT SCALE.
UNSPECIFIED
TOLERANCES

631 Hicks St., Brooklyn, NY 11231

UNAUTHORIZED USE, DISTRIBUTION, OR
REPRODUCTION OF THIS DESIGN, DRAWING,
OR INFORMATION IS STRICTLY PROHIBITED.
