SolidoodleDev/Press-Drawings/Press Part Drawings/Drawing Prints (PDF)/Print_Car_Wiring.PDF

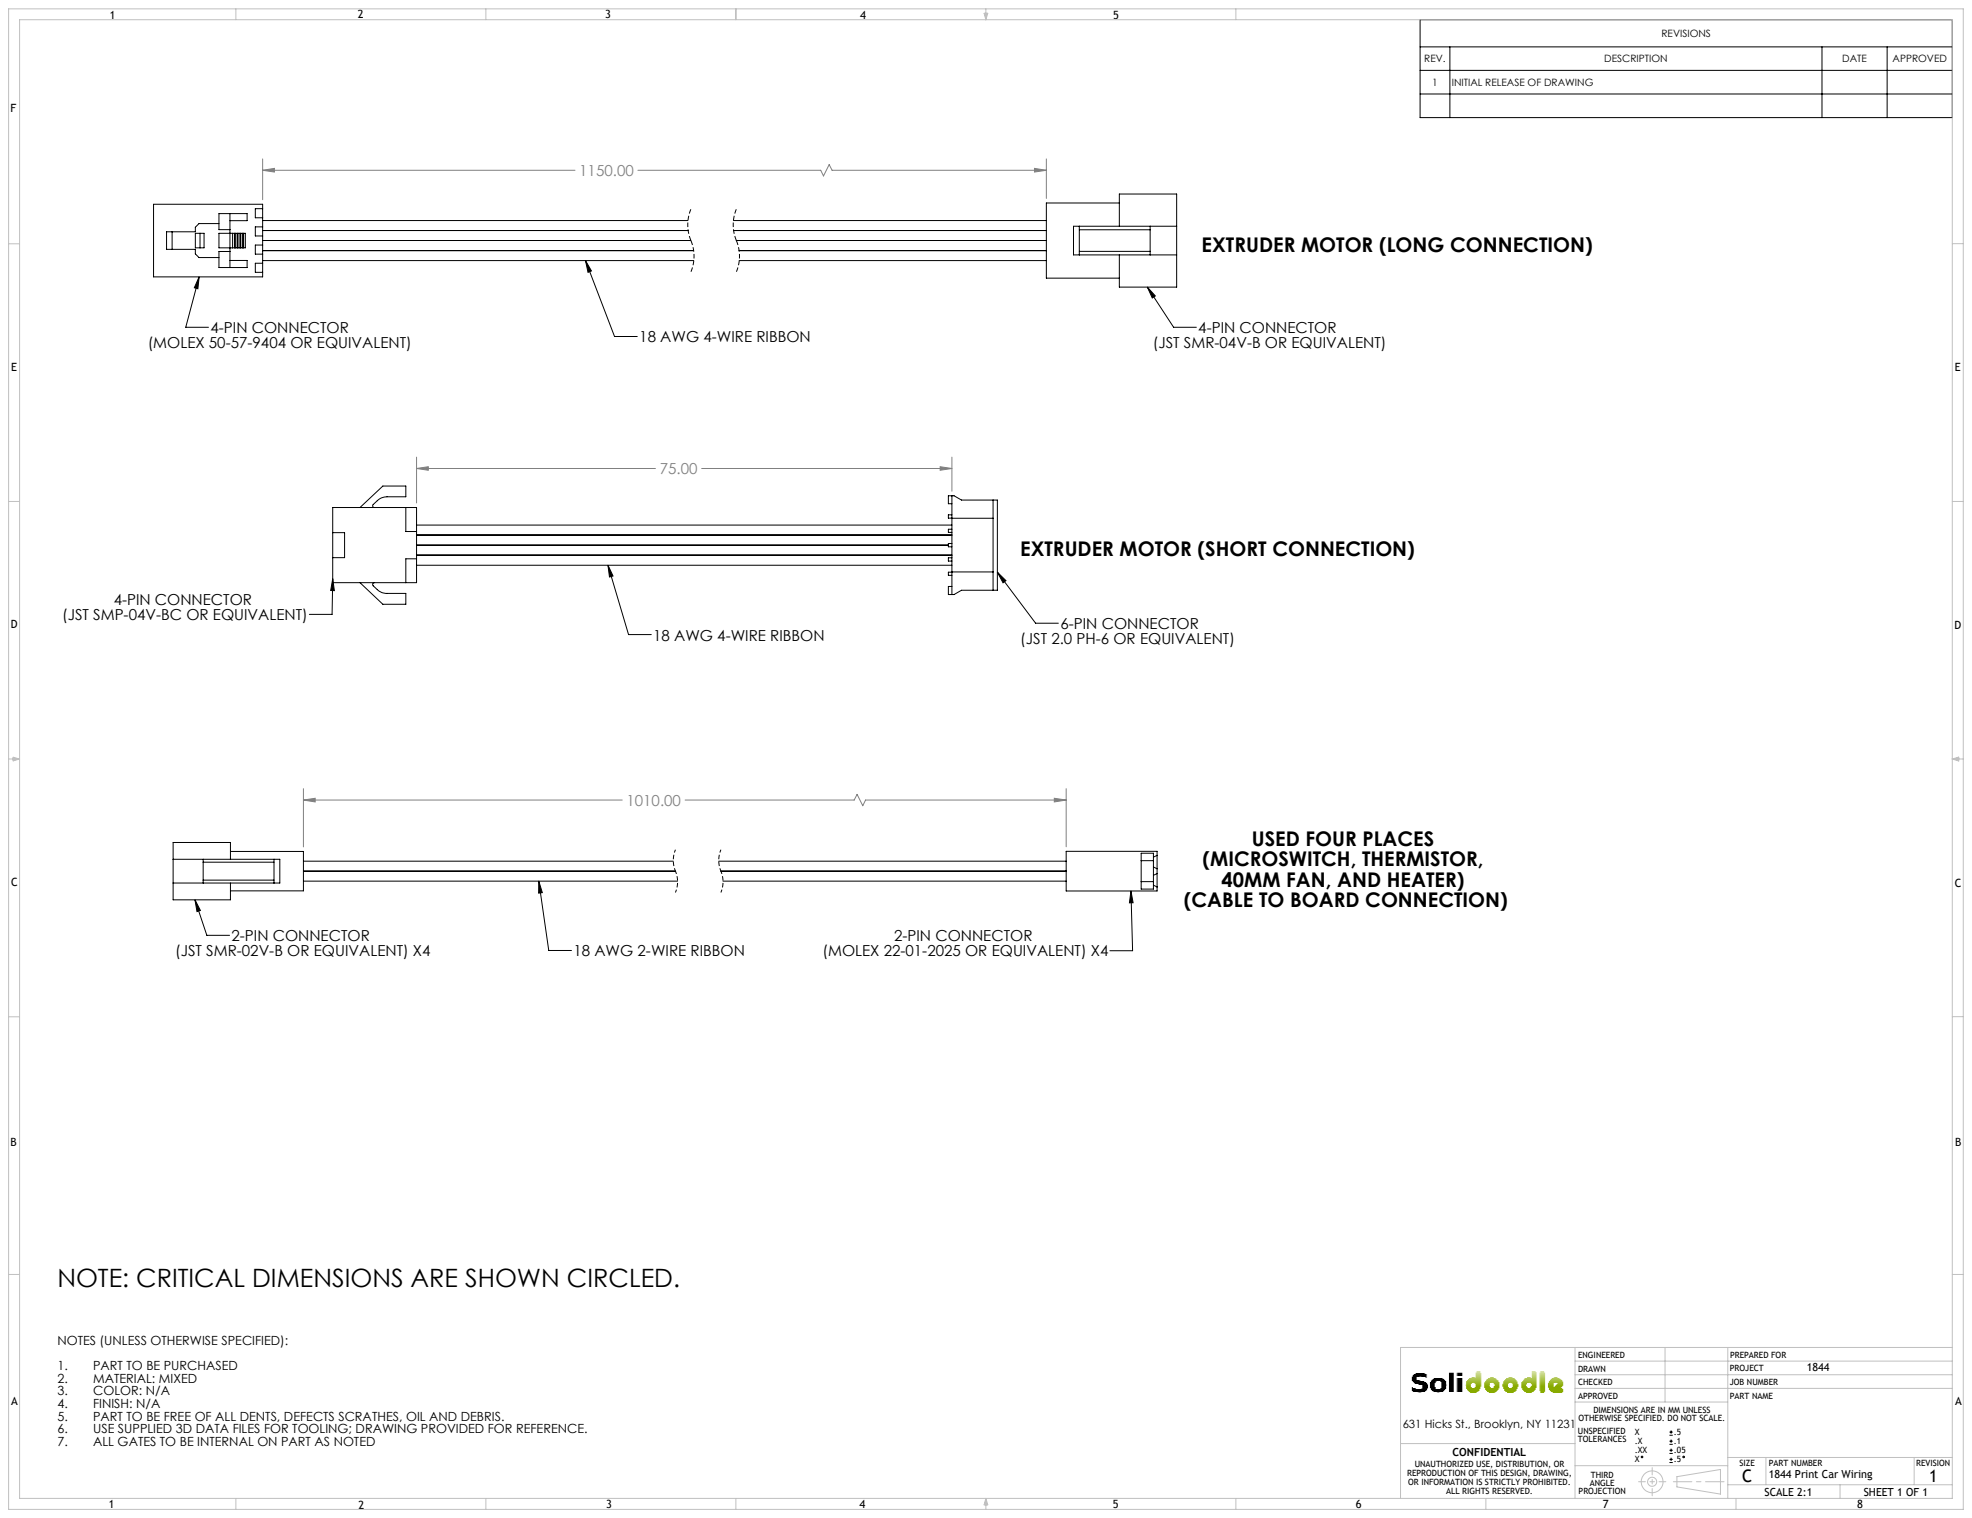
[picture p171: page 1]
4-PIN CONNECTOR; (MOLEX 50-57-9404 OR EQUIVALENT); 18 AWG 4-WIRE RIBBON; 2-PIN CONNECTOR; (JST SMR-02V-B OR EQUIVALENT) X4; 18 AWG 2-WIRE RIBBON; (JST SMP-04V-BC OR EQUIVALENT); 6-PIN CONNECTOR 18 AWG 4-WIRE RIBBON; (JST 2.0 PH-6 OR EQUIVALENT); ALL RIGHTS RESERVED.; SCALE 2:1; SHEET 1 OF 1; PREPARED FOR; JOB NUMBER PART NAME

REV. | DESCRIPTION | DATE | APPROVED
1 | INITIAL RELEASE OF DRAWING

EXTRUDER MOTOR (LONG CONNECTION)

4-PIN CONNECTOR
(JST SMR-04V-B OR EQUIVALENT)

EXTRUDER MOTOR (SHORT CONNECTION)

USED FOUR PLACES
(MICROSWITCH, THERMISTOR,
40MM FAN, AND HEATER)
(CABLE TO BOARD CONNECTION)

(MOLEX 22-01-2025 OR EQUIVALENT) X4

NOTE: CRITICAL DIMENSIONS ARE SHOWN CIRCLED.

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

ENGINEERED
DRAWN
CHECKED
APPROVED
DIMENSIONS ARE IN MM UNLESS
OTHERWISE SPECIFIED. DO NOT SCALE.
UNSPECIFIED
TOLERANCES

631 Hicks St., Brooklyn, NY 11231

UNAUTHORIZED USE, DISTRIBUTION, OR
REPRODUCTION OF THIS DESIGN, DRAWING,
OR INFORMATION IS STRICTLY PROHIBITED.

SIZE
PART NUMBER
1844 Print Car Wiring
