SolidoodleDev/Press-Drawings/Press Part Drawings/Drawing Prints (PDF)/1844_026_rev_03.PDF

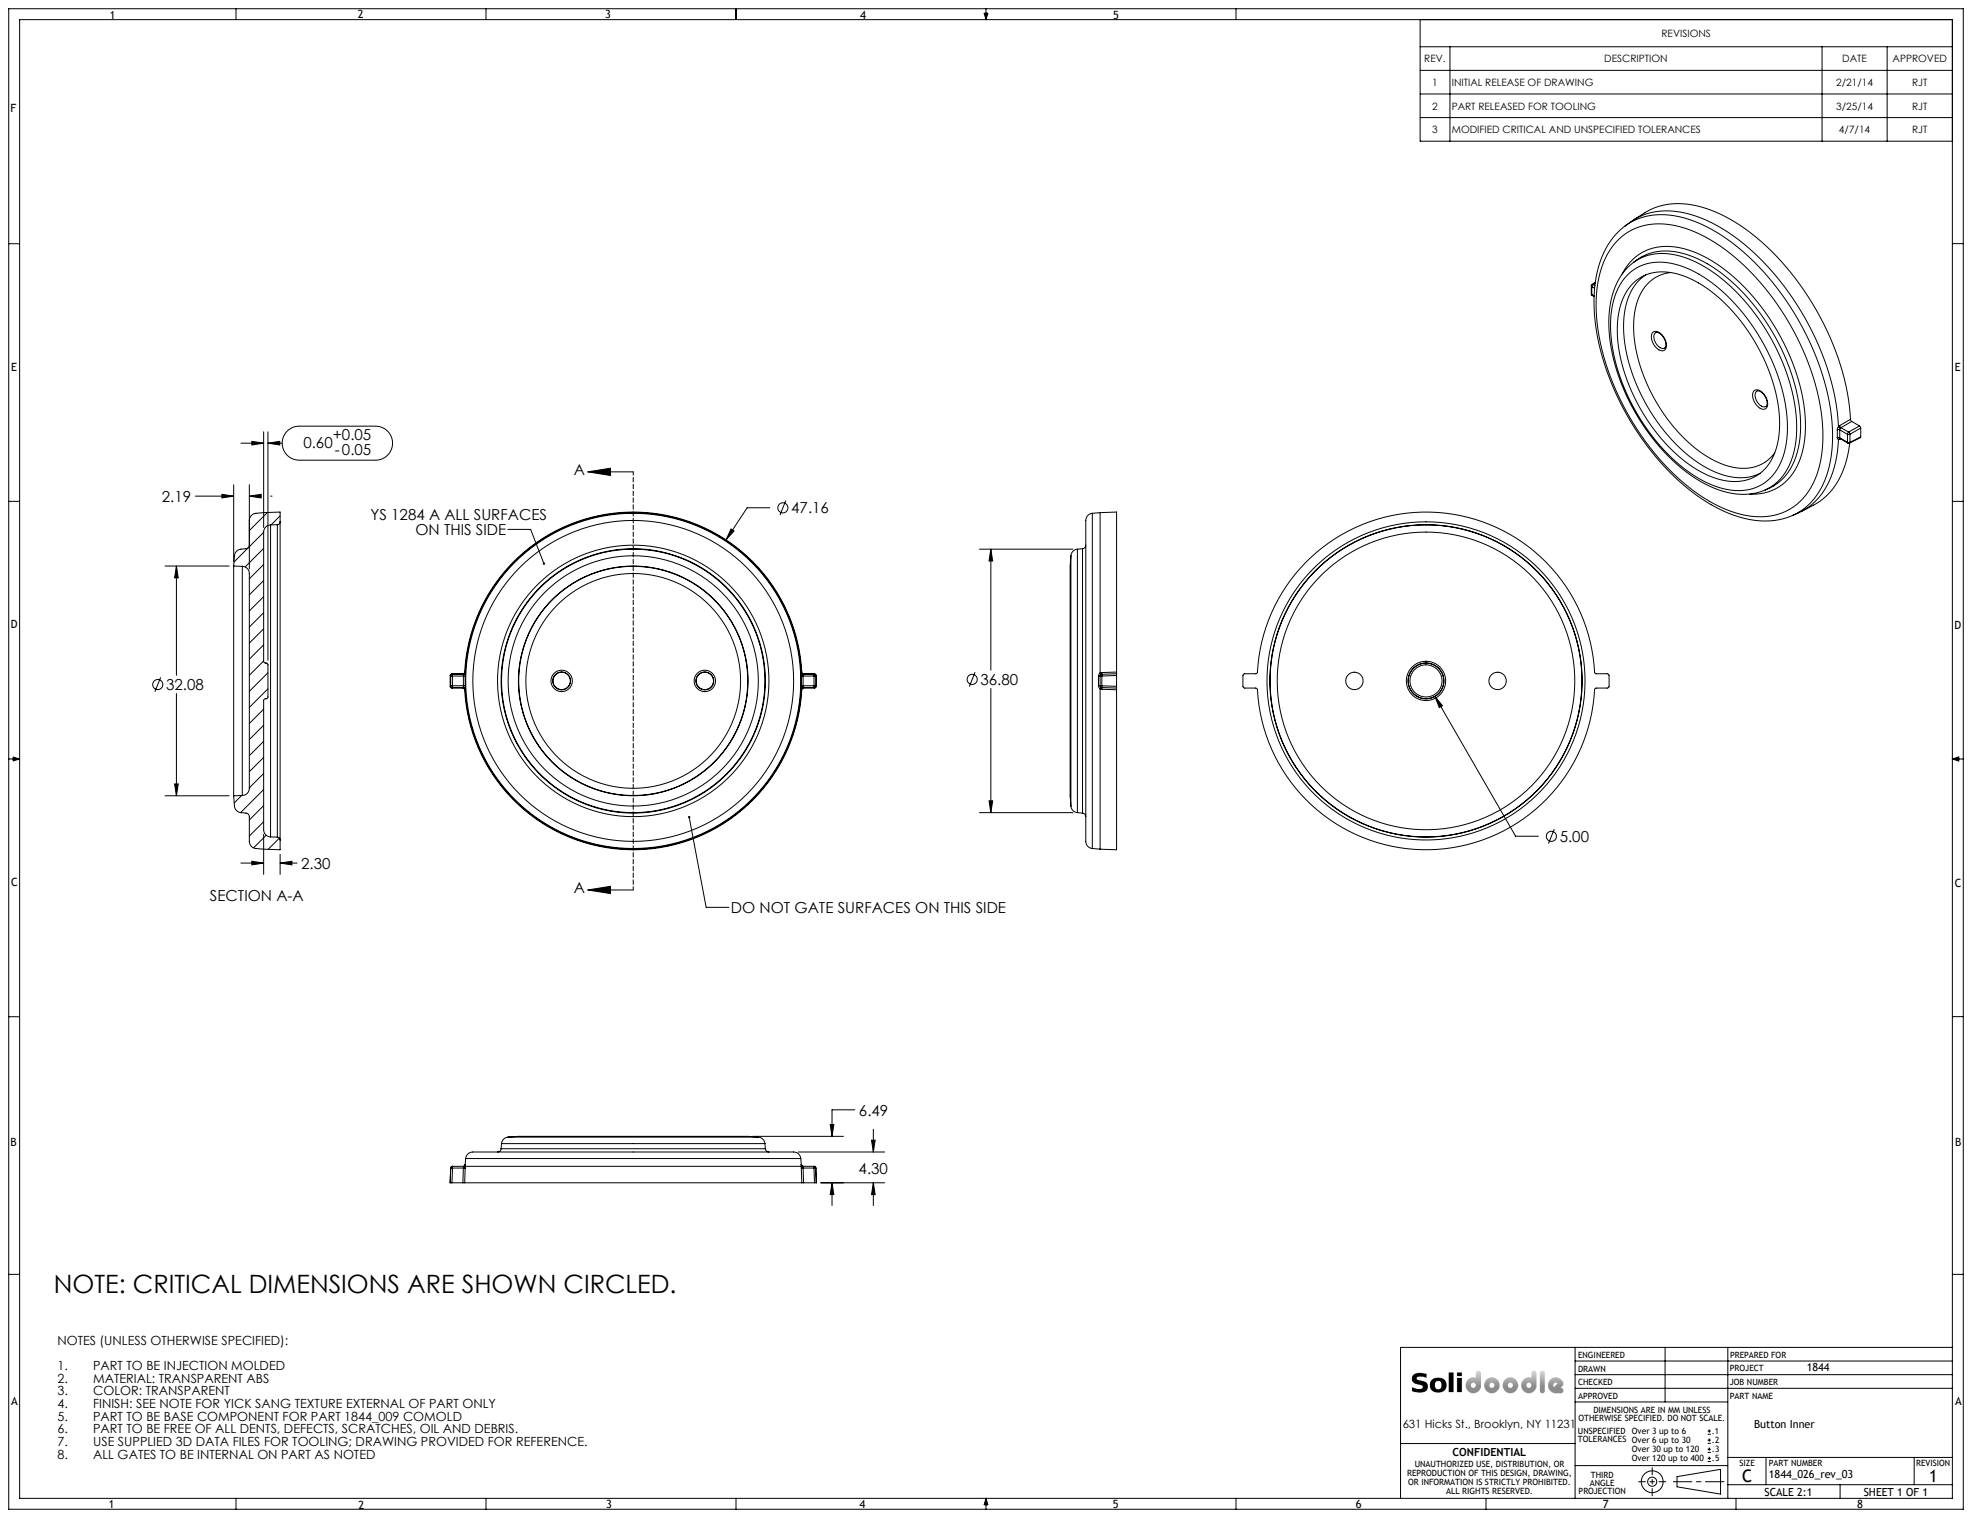
[picture p172: page 1]
SECTION A-A; ALL RIGHTS RESERVED.; SCALE 2:1; SHEET 1 OF 1; PREPARED FOR; .5 CONFIDENTIAL; JOB NUMBER; PART NUMBER; PART NAME; 631 Hicks St., Brooklyn, NY 11231; Button Inner

REV. | DESCRIPTION | DATE | APPROVED
1 | INITIAL RELEASE OF DRAWING | 2/21/14 | RJT
2 | PART RELEASED FOR TOOLING | 3/25/14 | RJT
3 | MODIFIED CRITICAL AND UNSPECIFIED TOLERANCES | 4/7/14 | RJT

YS 1284 A ALL SURFACES
ON THIS SIDE

DO NOT GATE SURFACES ON THIS SIDE

NOTE: CRITICAL DIMENSIONS ARE SHOWN CIRCLED.

NOTES (UNLESS OTHERWISE SPECIFIED):
1. PART TO BE INJECTION MOLDED
2. MATERIAL: TRANSPARENT ABS
3. COLOR: TRANSPARENT
4. FINISH: SEE NOTE FOR YICK SANG TEXTURE EXTERNAL OF PART ONLY
5. PART TO BE BASE COMPONENT FOR PART 1844_009 COMOLD
6. PART TO BE FREE OF ALL DENTS, DEFECTS, SCRATCHES, OIL AND DEBRIS.
7. USE SUPPLIED 3D DATA FILES FOR TOOLING; DRAWING PROVIDED FOR REFERENCE.
8. ALL GATES TO BE INTERNAL ON PART AS NOTED

ENGINEERED
DRAWN
CHECKED
APPROVED
DIMENSIONS ARE IN MM UNLESS
OTHERWISE SPECIFIED. DO NOT SCALE.
UNSPECIFIED
TOLERANCES

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

UNAUTHORIZED USE, DISTRIBUTION, OR
REPRODUCTION OF THIS DESIGN, DRAWING,
OR INFORMATION IS STRICTLY PROHIBITED.
