SolidoodleDev/Press-Drawings/Press Part Drawings/Drawing Prints (PDF)/1844_069_rev_02.PDF

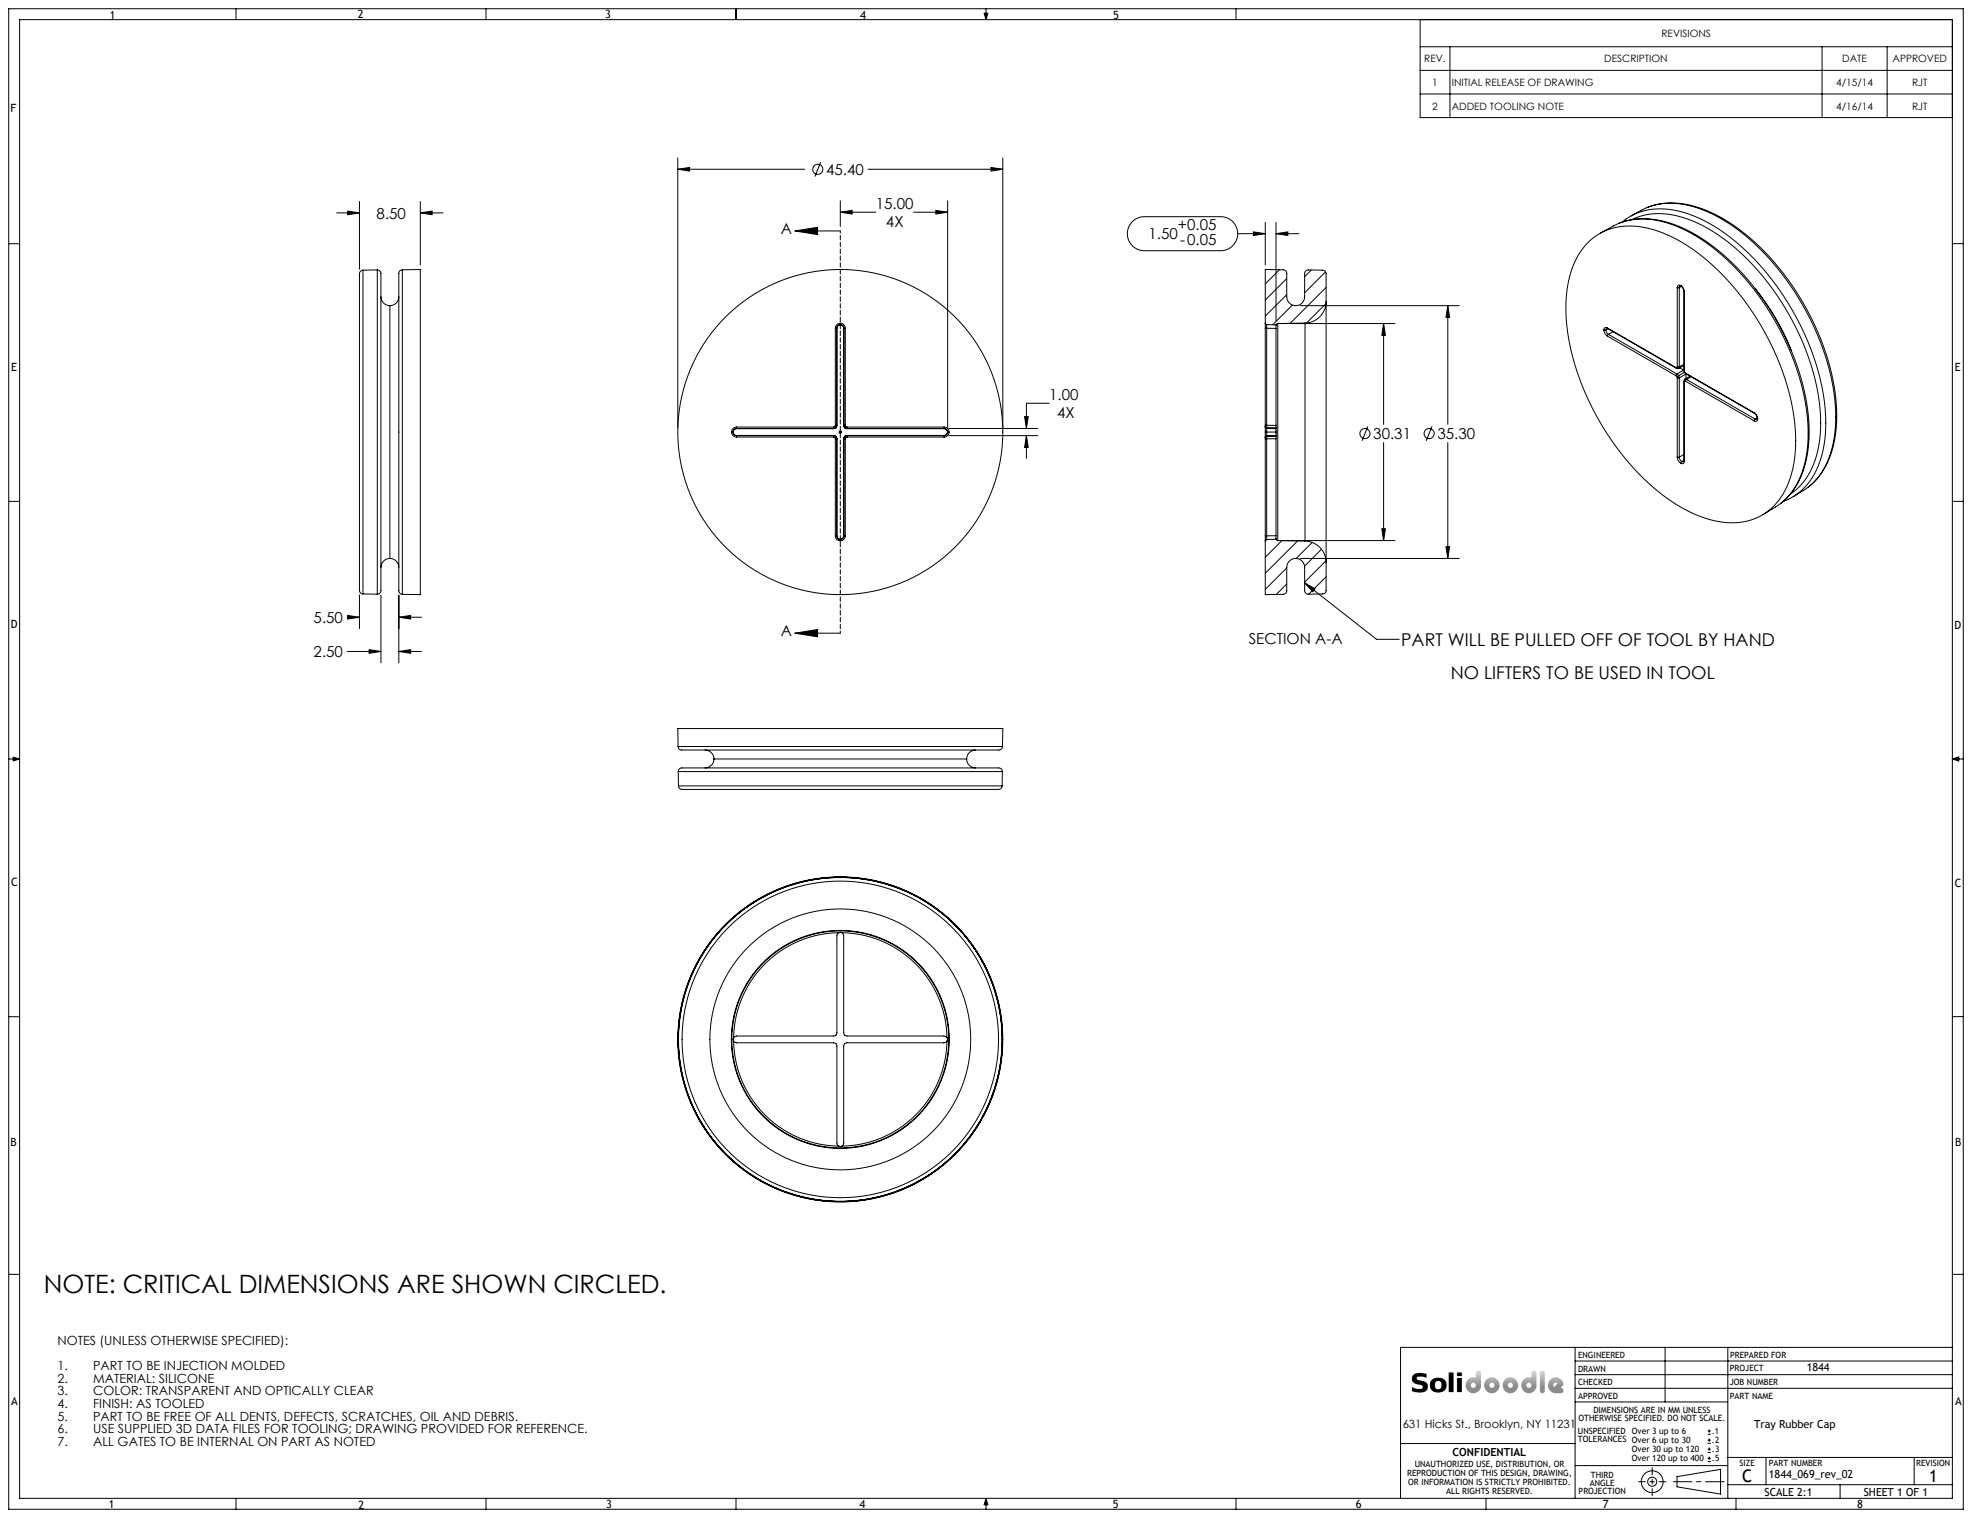
[picture p173: page 1]
SECTION A-A; PART WILL BE PULLED OFF OF TOOL BY HAND; ALL RIGHTS RESERVED.; SCALE 2:1; SHEET 1 OF 1; PREPARED FOR; .5 CONFIDENTIAL; JOB NUMBER; PART NUMBER; PART NAME; 631 Hicks St., Brooklyn, NY 11231; Tray Rubber Cap

REV. | DESCRIPTION | DATE | APPROVED
1 | INITIAL RELEASE OF DRAWING | 4/15/14 | RJT
2 | ADDED TOOLING NOTE | 4/16/14 | RJT

NO LIFTERS TO BE USED IN TOOL

NOTE: CRITICAL DIMENSIONS ARE SHOWN CIRCLED.

NOTES (UNLESS OTHERWISE SPECIFIED):
1. PART TO BE INJECTION MOLDED
2. MATERIAL: SILICONE
3. COLOR: TRANSPARENT AND OPTICALLY CLEAR
4. FINISH: AS TOOLED
5. PART TO BE FREE OF ALL DENTS, DEFECTS, SCRATCHES, OIL AND DEBRIS.
6. USE SUPPLIED 3D DATA FILES FOR TOOLING; DRAWING PROVIDED FOR REFERENCE.
7. ALL GATES TO BE INTERNAL ON PART AS NOTED

ENGINEERED
DRAWN
CHECKED
APPROVED
DIMENSIONS ARE IN MM UNLESS
OTHERWISE SPECIFIED. DO NOT SCALE.
UNSPECIFIED
TOLERANCES

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

UNAUTHORIZED USE, DISTRIBUTION, OR
REPRODUCTION OF THIS DESIGN, DRAWING,
OR INFORMATION IS STRICTLY PROHIBITED.
