SolidoodleDev/Press-Drawings/Press Part Drawings/Drawing Prints (PDF)/extruder_torsion_spring.PDF

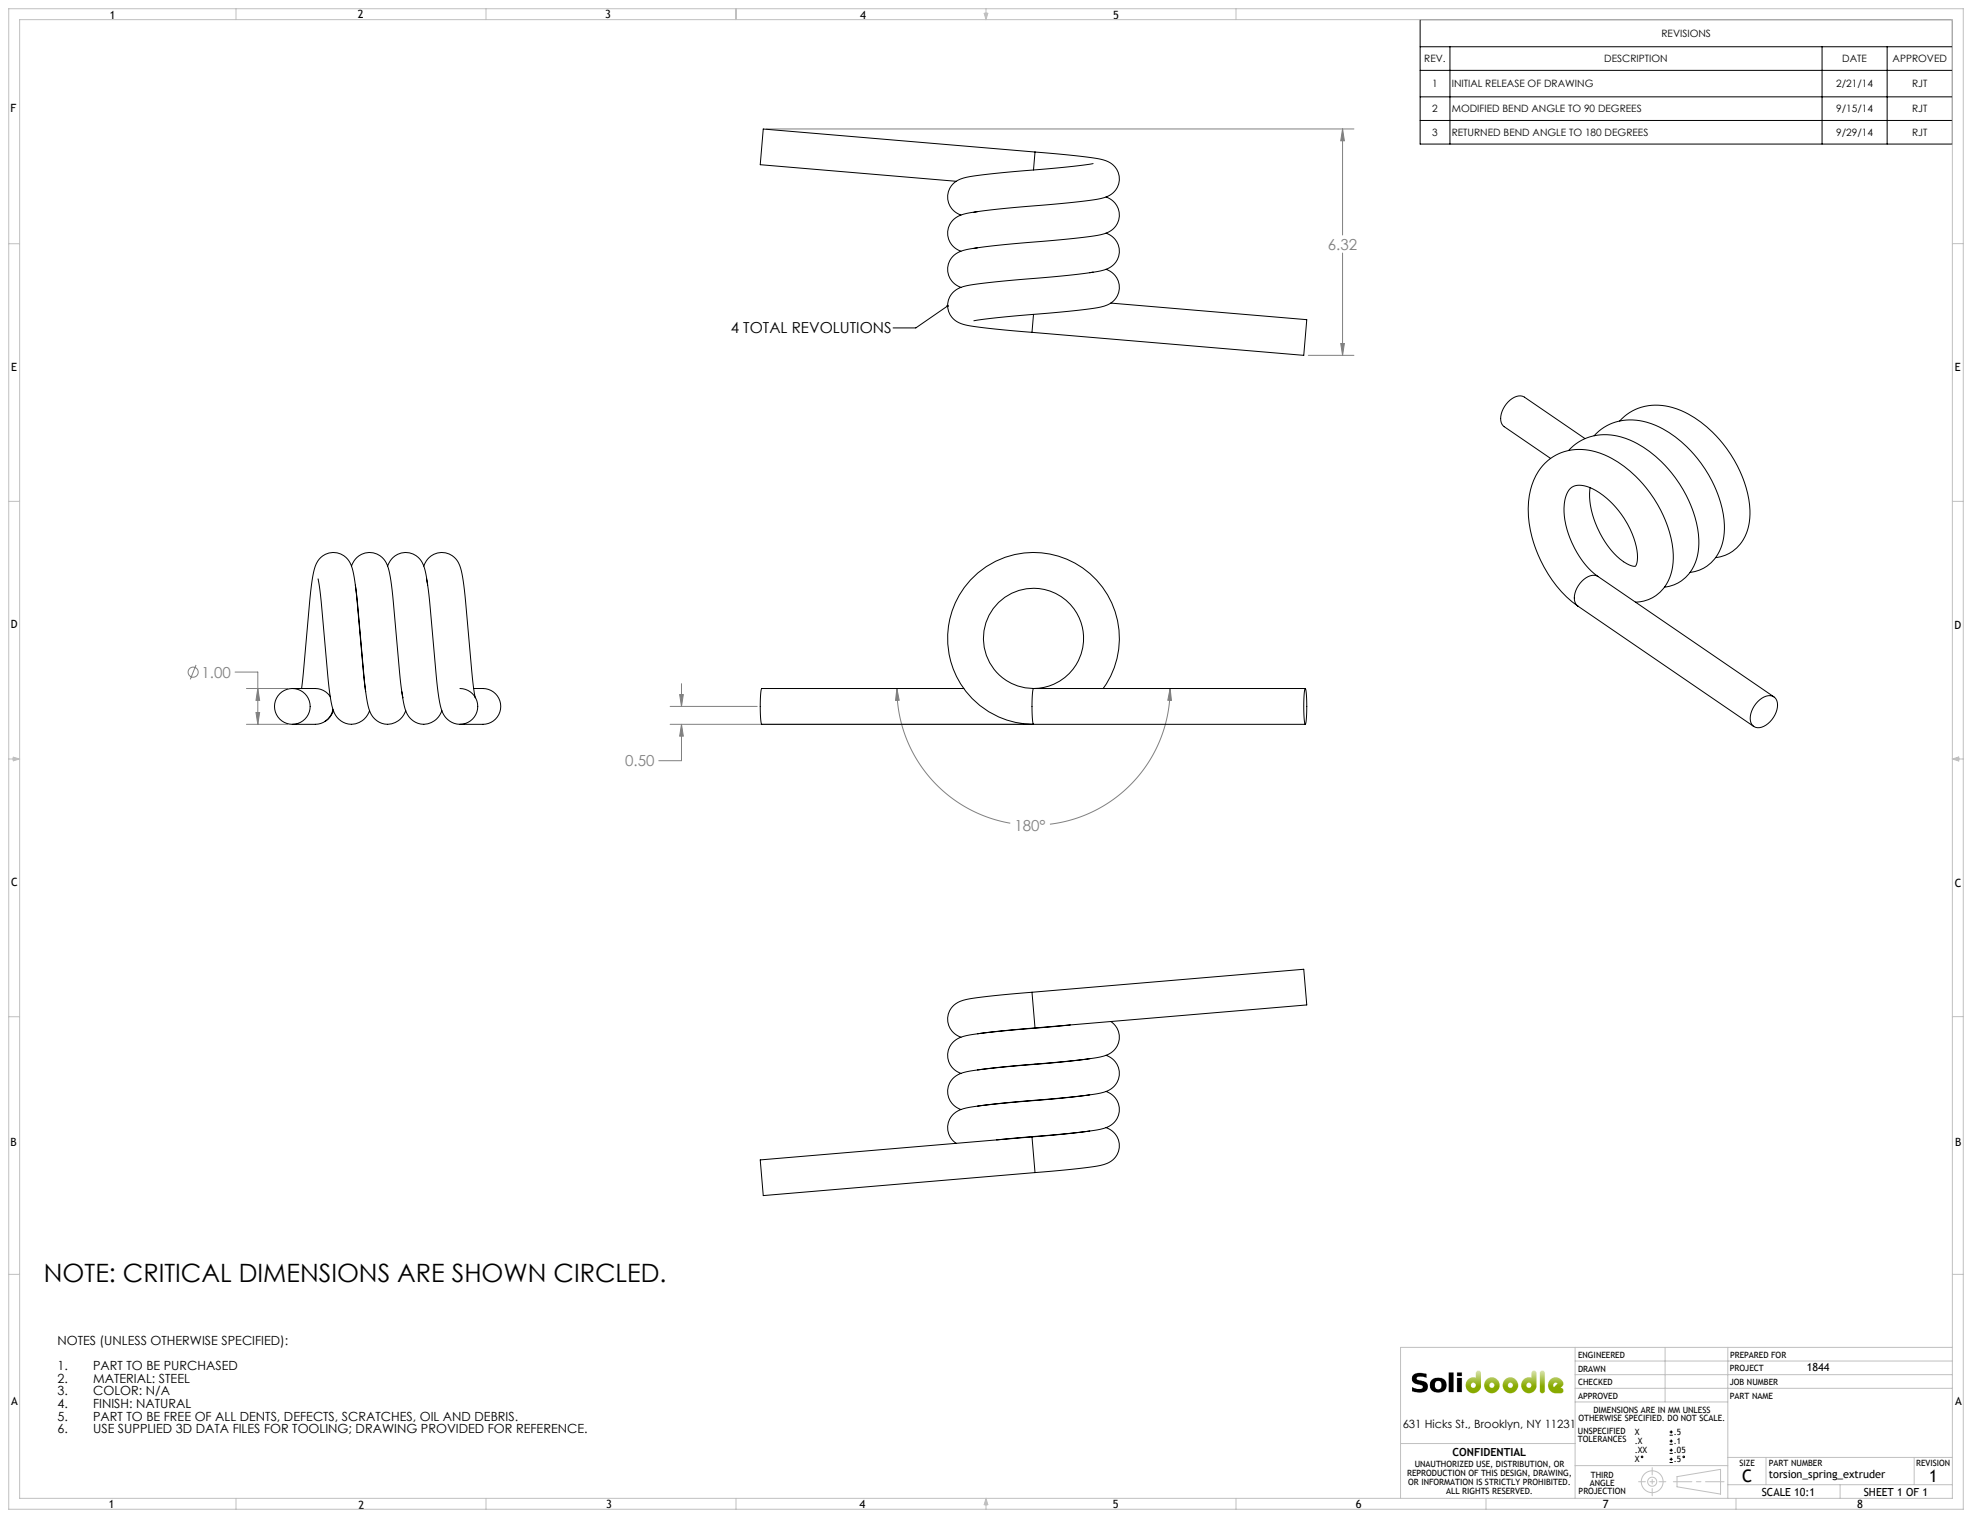
[picture p174: page 1]
4 TOTAL REVOLUTIONS; ALL RIGHTS RESERVED.; SCALE 10:1; SHEET 1 OF 1; PREPARED FOR; JOB NUMBER; PART NUMBER; PART NAME

REV. | DESCRIPTION | DATE | APPROVED
1 | INITIAL RELEASE OF DRAWING | 2/21/14 | RJT
2 | MODIFIED BEND ANGLE TO 90 DEGREES | 9/15/14 | RJT
3 | RETURNED BEND ANGLE TO 180 DEGREES | 9/29/14 | RJT

NOTE: CRITICAL DIMENSIONS ARE SHOWN CIRCLED.

NOTES (UNLESS OTHERWISE SPECIFIED):
1. PART TO BE PURCHASED
2. MATERIAL: STEEL
3. COLOR: N/A
4. FINISH: NATURAL
5. PART TO BE FREE OF ALL DENTS, DEFECTS, SCRATCHES, OIL AND DEBRIS.
6. USE SUPPLIED 3D DATA FILES FOR TOOLING; DRAWING PROVIDED FOR REFERENCE.

ENGINEERED
DRAWN
CHECKED
APPROVED
DIMENSIONS ARE IN MM UNLESS
OTHERWISE SPECIFIED. DO NOT SCALE.
UNSPECIFIED
TOLERANCES

631 Hicks St., Brooklyn, NY 11231

UNAUTHORIZED USE, DISTRIBUTION, OR
REPRODUCTION OF THIS DESIGN, DRAWING,
OR INFORMATION IS STRICTLY PROHIBITED.
